Jewelbots/jewelbot-ee/README.md

# jewelbot-ee

Altium files for Jewelbots charm and dev board

Latest charm schematic(JWB-001_v3.9)

Latest dev board(JDB-001_v2.0)
