Jewelbots/jewelbot-ee/JDB-001_v2.0/BOM/Bill of Materials-JDB-001.xlsx

Sheet: BOM Report
 |  | Title | Part Number | Rev | Variant
Bill of Materials |  | JDB-001 | 1 | 2 | None
Source Data From: | JDB-001.PrjPcb
Project: | JDB-001.PrjPcb |  |  | Jewelbots, Inc.
Variant: | None |  |  | Proprietary and Confidential
 | 7/22/2016 | 9:31:41 AM
 | 2016-07-22 | 9:33:24
Item | Description | MF | MFPN | Quantity | Designator | Cost | Cost/Board
1 | ANTENNA SMD EIA 0402 2.4GHZ | Johanson Technology Inc. | 2450AT07A0100E | 1 | A100 | 0.36562 | 0.36562
2 | CAP CER 0.1UF 6.3V 10% X5R 0201 | Murata Electronics North America | GRM033R60J104KE19D | 8 | C100, C104, C111, C206, C207, C211, C214, C306 | 0.00780 | 0.0624
3 | CAP CER 15PF 25V NP0 0201 | Murata Electronics North America | GRM0335C1E150FA01D | 2 | C101, C102 | 0.00900 | 0.018
4 | CAP CER 1000PF 25V 10% X7R 0201 | Murata Electronics North America | GRM033R71E102KA01D | 1 | C105 | 0.00600 | 0.006
5 | Capacitor, Ceramic 0201, DNP | N/A | DNP | 2 | C107, C108 | 0 | 0
6 | CAP CER 0.047UF 10V 10% X5R 0201 | Taiyo Yuden | LMK063BJ473KP-F | 1 | C109 | 0.03000 | 0.03
7 | CAP CER 2200PF 16V 10% X7R 0201 | Murata Electronics North America | GRM033R71C222KA88D | 1 | C110 | 0.00630 | 0.0063
8 | CAP CER 1UF 10V 10% X5R 0402 | Murata Electronics North America | GRM155R61A105KE15D | 6 | C200, C201, C209, C210, C301, C307 | 0.00990 | 0.0594
9 | CAP CER 10UF 10V 20% X5R 0603 | TDK Corporation | C1608X5R1A106M080AC | 2 | C204, C205 | 0.12650 | 0.253
10 | CAP CER 4.7UF 10V 20% X5R 0402 | Samsung Electro-Mechanics America, Inc. | CL05A475MP5NRNC | 6 | C208, C300, C302, C304, C305, C309 | 0.11730 | 0.7038
11 | CAP CER 1UF 6.3V 20% X5R 0201 | Samsung Electro-Mechanics America, Inc. | CL03A105MQ3CSNC | 1 | C213 | 0.27950 | 0.2795
12 | CAP CER 22PF 50V 5% NP0 0201 | Murata Electronics North America | GRM0335C1H220JA01D | 2 | C303, C310 | 0.00570 | 0.0114
13 | CAP CER 0.1UF 10V 10% X5R 0402 | Murata Electronics North America | GRM155R61A104KA01J | 1 | C308 | 0.00300 | 0.003
14 | LED RGB 3-IN-1 SMD 4PLCC | Cree Inc. | CLMVB-FKA-CFHEHLCBB7A363 | 4 | D200, D201, D202, D203 | 2.68 | 10.72
15 | DIODE SCHOTTKY 20V 1A SOD123FL | ON Semiconductor | MBR120VLSFT3G | 1 | D204 | 0.11660 | 0.1166
16 | DIODE SCHOTTKY 20V 500MA 0603 | Comchip Technology | CDBU0520 | 1 | D300 | 0.09888 | 0.09888
17 | TVS DIODE 6VWM 12VC 0402 | TE Connectivity Raychem Circuit Protection | SESD0402P1BN-0450-090 | 3 | D301, D302, D303 | 0.11000 | 0.33
18 | CONN HEADER 2POS 1.25MM R/A SMD | Molex, LLC | 0537800270 | 2 | J200, J301 | 1.23900 | 2.478
19 | CONN USB MICRO B RECPT SMT R/A | FCI | 10118194-0001LF | 1 | J300 | 0.18000 | 0.18
20 | FIXED IND 4.7UH 1A 250 MOHM SMD | Samsung Electro-Mechanics America, Inc. | CIG22B4R7MNE | 1 | L200 | 0.08498 | 0.08498
21 | FIXED IND 2.2UH 600MA 170 MOHM | TDK Corporation | GLFR1608T2R2M-LR | 1 | L300 | 0.12190 | 0.1219
22 | CONN HEADER 10POS .100" VERT TIN | Molex, LLC | 0015912100 | 4 | P100, P101, P102, P103 | 0.47152 | 1.88608
23 | CONN HEADER 4POS VERT 2.54MM SMD | Molex, LLC | 0878980426 | 1 | P104 | 0.25300 | 0.253
24 | MOSFET P-CH 20V 0.1A VMT3 | Rohm Semiconductor | RZM001P02T2L | 1 | Q100 | 0.22000 | 0.22
25 | MOSFET 2N-CH 20V 1.1A SC-70-6 | Vishay Siliconix | SI1902CDL-T1-GE3 | 1 | Q300 | 0.12210 | 0.1221
26 | RES SMD 0.0OHM JUMPER 1/20W 0201 | Samsung Electro-Mechanics America, Inc. | RC0603J000CS | 1 | R100 | 0.00787 | 0.00787
27 | RES SMD 3.3K OHM 5% 1/20W 0201 | Samsung Electro-Mechanics America, Inc. | RC0603J332CS | 2 | R101, R102 | 0.00648 | 0.01296
28 | RES SMD 10K OHM 5% 1/20W 0201 | Rohm Semiconductor | MCR006YRTJ103 | 4 | R104, R105, R200, R306 | 0.00828 | 0.03312
29 | RES SMD 82K OHM 1% 1/20W 0201 | Panasonic Electronic Components | ERJ-1GEF8202C | 1 | R201 | 0.01049 | 0.01049
30 | RES SMD 30.1K OHM 1% 1/20W 0201 | Panasonic Electronic Components | ERJ-1GEF3012C | 1 | R202 | 0.01049 | 0.01049
31 | RES SMD 6.49K OHM 1% 1/20W 0201 | Panasonic Electronic Components | ERJ-1GEF6491C | 1 | R300 | 0.10000 | 0.1
32 | RES SMD 330 OHM 5% 1/20W 0201 | Rohm Semiconductor | MCR006YRTJ331 | 1 | R303 | 0.00834 | 0.00834
33 | RES SMD 150K OHM 1% 1/20W 0201 | Rohm Semiconductor | MCR006YRTF1503 | 1 | R304 | 0.01102 | 0.01102
34 | RES SMD 680K OHM 1% 1/20W 0201 | Panasonic Electronic Components | ERJ-1GEF6803C | 1 | R305 | 0.01049 | 0.01049
35 | RES SMD 2.2K OHM 5% 1/20W 0201 | Panasonic Electronic Components | ERJ-1GEJ222C | 1 | R307 | 0.00787 | 0.00787
36 | RES SMD 0.0OHM JUMPER 1/16W 0402 | Samsung Electro-Mechanics America, Inc. | RC1005J000CS | 1 | R308 | 0.00198 | 0.00198
37 | RES SMD 27 OHM 5% 1/10W 0603 | Rohm Semiconductor | MCR03ERTJ270 | 2 | R309, R310 | 0.00338 | 0.00676
38 | Resistor, 0201, DNP | N/A | DNP | 2 | R311, R312 | 0 | 0
39 | RES SMD 300K OHM 1% 1/20W 0201 | Panasonic Electronic Components | ERJ-1GEF3003C | 1 | R313 | 0.10000 | 0.1
40 | RES SMD 240K OHM 1% 1/20W 0201 | Panasonic Electronic Components | ERJ-1GEF2403C | 1 | R314 | 0.10000 | 0.1
41 | THERMISTOR 10K OHM NTC 0201 SMD | Murata Electronics North America | NCP03XH103J05RL | 1 | RT300 | 0.08514 | 0.08514
42 | Tactile Switches 6.0x6.0x2.5mm 160gf | ALPS | SKHUALE010 | 2 | SW100, SW101 | 0.201 | 0.402
43 | SWITCH SLIDE DPDT 300MA 6V | C&K Components | JS202011SCQN | 2 | SW300, SW301 | 0.46200 | 0.924
44 | IC SOC 2.4GHZ 256K FLASH 48QFN | Nordic Semiconductor ASA | NRF51822-QFAC-R | 1 | U100 | 2.33310 | 2.3331
45 | NORDIC NRF51 BALUN FILTER | Johanson Technology Inc. | 2450BM14E0003T | 1 | U101 | 0.66000 | 0.66
46 | IC ERM/LRA HAPTIC DRIVER 9DSBGA | Texas Instruments | DRV2604LYZFR | 1 | U200 | 1.35000 | 1.35
47 | IC LED DRIVER RGLTR DIM 36USMD | Texas Instruments | LP55281TL/NOPB | 1 | U201 | 1.17000 | 1.17
48 | IC PMU 2CH CONV/LDO 32QFN | Texas Instruments | TPS65721RSNR | 1 | U300 | 2.44600 | 2.446
49 | IC LITHIUM BATT PROTECT 6-SON | Texas Instruments | BQ29700DSET | 1 | U301 | 0.67800 | 0.678
50 | IC USB SERIAL BASIC UART 16QFN | FTDI, Future Technology Devices International Ltd | FT230XQ-R | 1 | U302 | 1.52950 | 1.5295
51 | CRYSTAL 16.0000MHZ 10PF SMD | Abracon LLC | ABM11-16.000MHZ-B7G-T | 1 | X100 | 0.60000 | 0.6
 |  |  |  |  |  |  | 31.00909 | TOTAL
Rev

Sheet: Project Information
Project Full Path | C:\Awarepoint\T3B\T3B.PrjPcb
Project Filename | T3B.PrjPcb
Variant Name | Prototype
Data-Source Filename | T3B.PrjPcb
Data-Source Full Path | C:\Awarepoint\T3B\T3B.PrjPcb
Title | Bill of Materials For Variant [Prototype] of Project [T3B.PrjPcb] (No PCB Document Selected)
Total Quantity | 87
Report Time | 2:07:03 PM
Report Date | 1/17/2012
Report Date & Tine | 1/17/2012 2:07:03 PM
Output Name | Bill of Materials
Output Type | BOM_PartType
Output Generator Name | BOM
Output Generator Description | Bill of Materials
