Jewelbots/jewelbot-ee/JWB-001_Charger_v2/BOM/JWB-001_Charger_v2.0_BOM.xlsx

Sheet: Part List Report
 | Component list |  |  | JWB-001_Charger
 | Source Data From: |  |  | JWB-001_Charger.PrjPcb
 | Project: |  |  | JWB-001
 | Version: |  |  | v2.0
 |  |  |  |  |  | CONFIDENTIAL
 | Report Date: |  | 5/14/2015 | 9:21:27 AM
 | Print Date: |  | 2015-05-14 | 9:21:32
# | Value | Description | Manufacturer | Manufacturer P/N | #Column Name Error:Supplier 1 | #Column Name Error:Supplier Part Number 1 | Designator | Quantity
1 |  | Spring Loaded Header 0.05" Pitch, 4Pin, 4x1, 4.98mm - 6.4mm Height | Mill-Max | 854-22-004-30-001101 |  |  | J100 | 1
2 | 0.1uF | Cap, Ceramic 0.1uF 10V 10% X5R 0402 | Murata | GRM155R61A104KA01J |  |  | C101 | 1
3 | 1.0uF | Cap, Ceramic 1.0uF 10V 10% X5R 0402 | Murata | GRM155R61A105KE15D |  |  | C102 | 1
4 | 4.7uF | Cap, Ceramic 4.7uF 10V 20% X5R 0402 | Samsung | CL05A475MP5NRNC |  |  | C100 | 1
5 |  | USB to UART converter IC, Single channel with flow control, QFN-16 | FTDI | FT230XQ-R |  |  | U100 | 1
6 | 0 | Resistor 0 ohm 1/16W 0402 | Samsung | RC1005J000CS |  |  | R103 | 1
7 | 27 | Resistor 27 ohm 5%, 1/10W, 0603 | Rohm | MCR03ERTJ270 |  |  | R100, R101 | 2
8 |  | ESD TVS Diode, 16kV air, 0402 | TE Connectivity | SESD0402P1BN-0450-090 |  |  | D100, D101, D102 | 3
9 |  | USB Micro B Receptacle, Right Angle, SMT with 4 TH Tabs | FCI | 10118194-0001LF |  |  | J101 | 1
Approved |  |  |  | Notes |  |  |  | 12

Sheet: Project Information
Project Full Path | C:\Users\davisj\rigado\clients\Jewliebots\Project Folders\JWB-001\hw\JWB-001_Charger\v2.0\JWB-001_Charger.PrjPcb
Project Filename | JWB-001_Charger.PrjPcb
Project Name | JWB-001
PCB Name | JWB-001_Charger
Version | v2.0
Created By | JJD
Total Part Quantity | 12
Report Time | 9:21:27 AM
Report Date | 5/14/2015
Report Date & Tine | 5/14/2015 9:21:27 AM
Output Name | Purchase BOM
Output Type | BOM_PartType
Output Generator Name | BOM
Output Generator Description | Bill of Materials
