Jewelbots/jewelbot-ee/JWB-001_Main_v2.0/BOM/JWB-001_Main_v2.0_BOM.xlsx

Sheet: Part List Report
 | Component list |  |  | JWB-001_Main
 | Source Data From: |  |  | JWB-001_Main.PrjPcb
 | Project: |  |  | JWB-001
 | Version: |  |  | v2.0
 |  |  |  |  |  | CONFIDENTIAL
 | Report Date: |  | 5/13/2015 | 4:35:32 PM
 | Print Date: |  | 2015-05-13 | 16:35:41
# | Value | Description | Manufacturer | Manufacturer P/N | #Column Name Error:Supplier 1 | #Column Name Error:Supplier Part Number 1 | Designator | Quantity
1 |  | Utra-Minature 2.4GHz Chip antenna, 1.0mm x 0.5mm | Johanson Technology | 2450AT07A0100 |  |  | A100 | 1
2 |  | Spring Loaded Header 0.05" Pitch, 4Pin, 4x1, 4.98mm - 6.4mm Height | Mill-Max | 854-22-004-30-001101 |  |  | J300 | 1
3 |  | Balun, 50 ohm transformer for nRF51x22 | ST Micro | BAL-NRF02D3 |  |  | U101 | 1
4 |  | Li-Ion single cell voltage and current protection IC | Texas Instruments | BQ29700DSET |  |  | U301 | 1
5 | 0.1uF | Cap, Ceramic 0.1uF 6.3V 10% X5R 0201 | Murata | GRM033R60J104KE19D |  |  | C100, C104, C111, C112, C206, C207, C211, C214, C306 | 9
6 | 1.0uF | Cap, Ceramic 1.0uF 6.3V 20% X5R 0201 | Samsung | CL03A105MQ3CSNC |  |  | C213 | 1
7 | 11pF | Cap, Ceramic 11pF 25V 5% NPO 0201 | Samsung | CL03C110JA3GNNC |  |  | C101, C102 | 2
8 | 1nF | Cap, Ceramic 1nF 25V 10% X7R 0201 | Murata | GRM033R71E102KA01D |  |  | C105 | 1
9 | 2.2nF | Cap, Ceramic 2.2nF 16V 10% X7R 0201 | Murata | GRM033R71C222KA88D |  |  | C110 | 1
10 | 22pF | Cap, Ceramic 22pF 50V 5% NPO 0201 | Murata | GRM0335C1H220JA01D |  |  | C303 | 1
11 | 47nF | Cap, Ceramic 47nF 10V 10% X5R 0201 | Taiyo Yuden | LMK063BJ473KP-F |  |  | C109 | 1
12 | 1.0uF | Cap, Ceramic 1.0uF 10V 10% X5R 0402 | Murata | GRM155R61A105KE15D |  |  | C200, C201, C209, C210, C301, C305 | 6
13 | 4.7uF | Cap, Ceramic 4.7uF 10V 20% X5R 0402 | Samsung | CL05A475MP5NRNC |  |  | C208, C300, C302, C304 | 4
14 | 10uF | Cap, Ceramimic 10uF 10V 20% X5R 0603 | TDK | C1608X5R1A106M080AC |  |  | C204, C205 | 2
15 |  | Diode, Schottky, 20V 500mA, 470mV Vf @ 500mA, 0603 | Comchip Technology | CDBU0520 |  |  | D300 | 1
16 |  | RGB LED SMD, Diffused | Cree | CLMVB-FKA-CFHEHLCBB7A363 |  |  | D200, D201, D202, D203 | 4
17 |  | Haptic Driver w/Internal Memory, I2C, DSBGA 9 | Texas Instruments | DRV2604LYZFx |  |  | U200 | 1
18 |  | Crystal, 16.0000MHz, 10ppm, 2.0mm x 1.6mm | EPSON | FA-128 16.0000MF10Z -ACX |  |  | X100 | 1
19 |  | Reset Timer with 10.0sec Fixed Delay and Reset Pulse, 1.65v-5.0v | Fairchild | FT10001L6X |  |  | U102 | 1
20 |  | Snap Dome, high activation force, 5.3mm dia | Snaptron | GX05170 |  |  | SW100 | 1
21 | 2.2uH | Inductor, 2.2uH 160mA, 0603 | TDK | GLFR1608T2R2M-LR |  |  | L300 | 1
22 | 4.7uH | Inductor, 4.7uH, 1008 | Samsung | CIG22B4R7MNE |  |  | L200 | 1
23 |  | Quad RGB LED driver w/integrated boost supply and audio sync | Texas Instruments | LP55281TL/NOPB |  |  | U201 | 1
24 |  | Diode, Schottky, 20V 1A SOD-123F, 340mV Vf @ 1A | ON Semi | MBR120VLSFT3G |  |  | D204 | 1
25 |  | Multiporotocol Bluetooth low energy/2.4GHz RF System on Chip | Nordic Semiconductor | nRF51822-CFAC-R |  |  | U100 | 1
26 | 0 | Resistor 0 ohm 1/20W, 0201 | Samsung | RC0603J000CS |  |  | R100 | 1
27 | 10k | Resistor 10k ohm 5% 1/20W 0201 | Rohm | MCR006YRTJ103 |  |  | R104, R105, R106, R107, R200, R301, R306 | 7
28 | 150k | Resistor 150k ohm 1% 1/20W, 0201 | Rohm | MCR006YRTF1503 |  |  | R304 | 1
29 | 2.2k | Resistor 2.2k ohm 5% 1/20W, 0201 | Panasonic | ERJ-1GEJ222C |  |  | R307 | 1
30 | 3.3k | Resistor 3.3k ohm 5% 1/20W, 0201 | Samsung | RC0603J332CS |  |  | R101, R102 | 2
31 | 301k | Resistor 301k ohm 1% 1/20W, 0201 | Panasonic | ERJ-1GEF3013C |  |  | R305 | 1
32 | 330 | Resistor 330 ohm 5% 1/20W, 0201 | Rohm | MCR006YRTJ331 |  |  | R303 | 1
33 | 82k | Resistor, 0201 |  |  |  |  | R201 | 1
34 | 30.1k | Resistor, 0201 |  |  |  |  | R202 | 1
35 | 4.12k | RES SMD 4.12K OHM 1% 1/20W 0201 | Panasonic | ERJ-1GEF4121C |  |  | R300 | 1
36 |  | P-MOSFET, 20V 100mA, SOT-723 | Rohm | RZM001P02T2L |  |  | Q100 | 1
37 |  | ESD TVS Diode, 16kV air, 0402 | TE Connectivity | SESD0402P1BN-0450-090 |  |  | D301, D303, D304 | 3
38 |  | Dual N-MOSFET, 20V 1A, SC70-6 | Vishay | SI1902CDL-T1-GE3 |  |  | Q101, Q300 | 2
39 | 10k | Thermistor 10k ohm NTC 5% 0201 | Murata | NCP03XH103J05RL |  |  | RT300 | 1
40 |  | PMU for Li-ion batteries, 1xDCDC 1xLDO, .4mm pitch XBGA 2mm x 2mm | Texas Instruments | TPS65720YFF |  |  | U300 | 1
41 | DNP | Capacitor, Ceramic 0201 |  |  |  |  | C107, C108 | 2
42 | DNP | Resistor, 0201 |  |  |  |  | R311, R312 | 2
43 |  | Test points for 4-wire Serial Wire Debugger header Pogo Pin harness |  |  |  |  | J100 | 1
44 |  | Testpoint, Round 1.0mm Dia |  |  |  |  | TP_SCL, TP_SDA | 2
45 |  | Testpoint, Round 1.7mm Dia |  |  |  |  | TP_BATT+, TP_BATT-, TP_GND, TP_LRA+, TP_LRA- | 5
Approved |  |  |  | Notes |  |  |  | 83

Sheet: Project Information
Project Full Path | C:\Users\davisj\rigado\clients\Jewliebots\Project Folders\JWB-001\hw\JWB-001_Main\v2.0\JWB-001_Main.PrjPcb
Project Filename | JWB-001_Main.PrjPcb
Project Name | JWB-001
PCB Name | JWB-001_Main
Version | v2.0
Created By | JJD
Total Part Quantity | 83
Report Time | 4:35:32 PM
Report Date | 5/13/2015
Report Date & Tine | 5/13/2015 4:35:32 PM
Output Name | Purchase BOM
Output Type | BOM_PartType
Output Generator Name | BOM
Output Generator Description | Bill of Materials
