Jewelbots/jewelbot-ee/JWB-001_Main_v2.0/Export 3D/JWB-001 v2.0.step

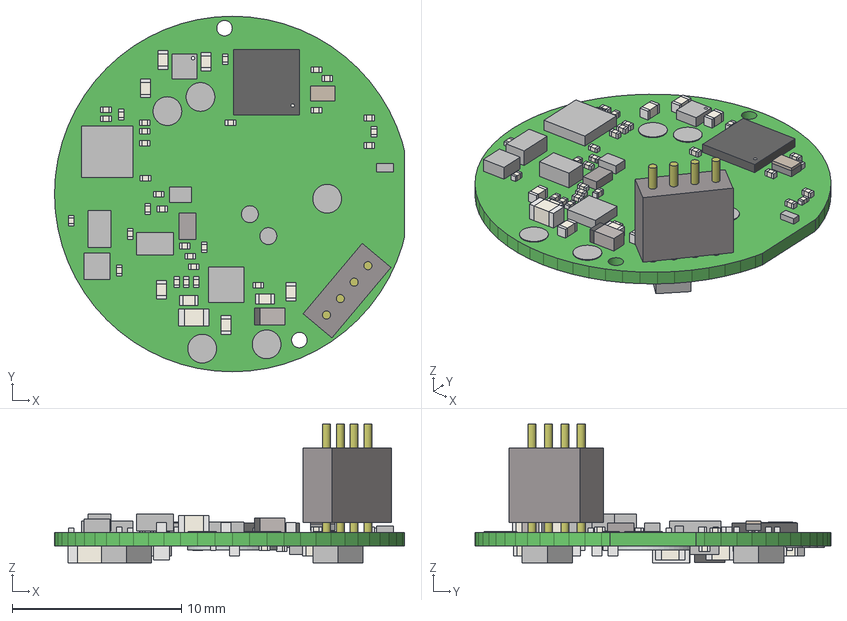
[picture p7: CAD file, 2016-06-10]
JWB-001_Main_v2.0/Export 3D/JWB-001 v2.0.step
20.7 x 21.0 x 8.19 mm
Board
Extruded x 188
