Jewelbots/jewelbot-ee/JWB-001_v3.9/SupportDocs/Stepfiles/User Library-QFN 32.STEP

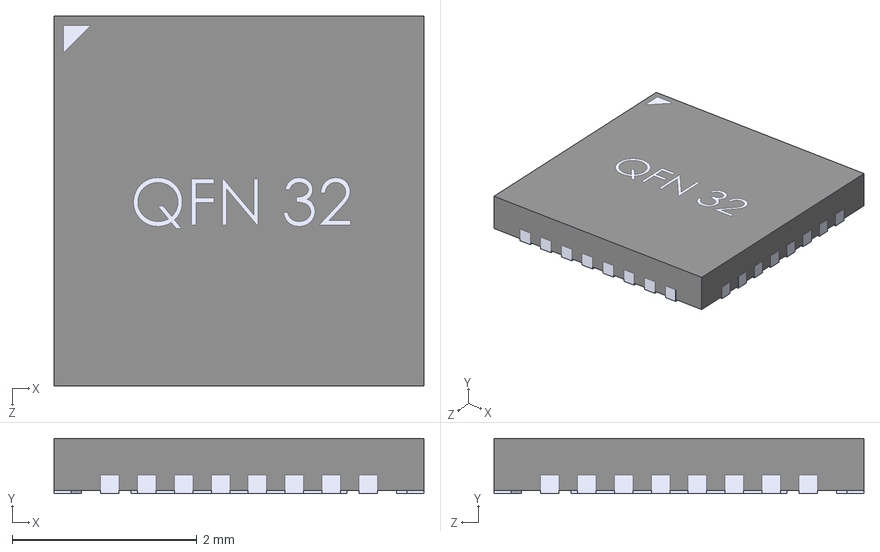
[picture p8: CAD file, 2016-07-22]
JWB-001_v3.9/SupportDocs/Stepfiles/User Library-QFN 32.STEP
4.00 x 0.6 x 4.00 mm
