Jewelbots/jewelbot-ee/JDB-001_v2.0/SupportDocs/Stepfiles/User Library-header1x4 1241150-4.STEP

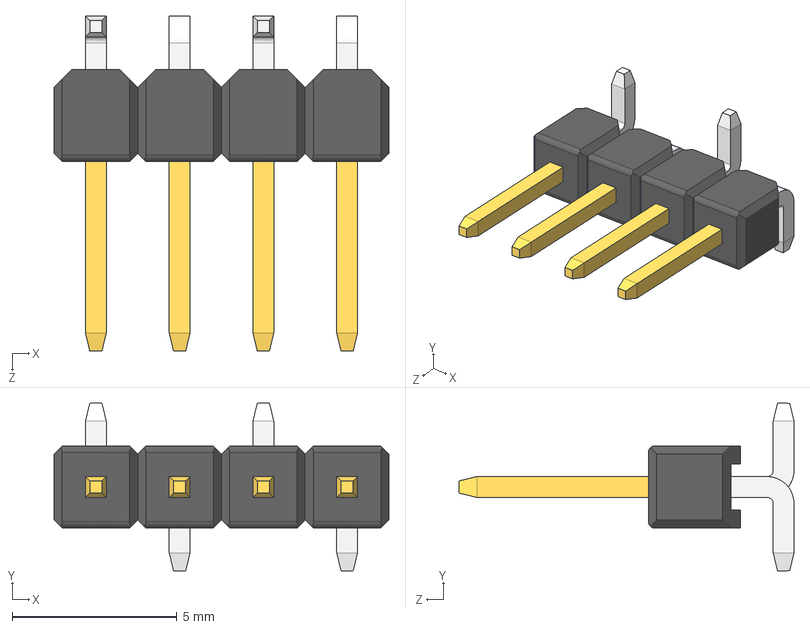
[picture p9: CAD file, 2016-07-22]
JDB-001_v2.0/SupportDocs/Stepfiles/User Library-header1x4 1241150-4.STEP
10.2 x 5.08 x 10.2 mm
