Jewelbots/jewelbot-ee/JWB-001_v3.9/SupportDocs/Stepfiles/RSN32_2P8X2P8.stp

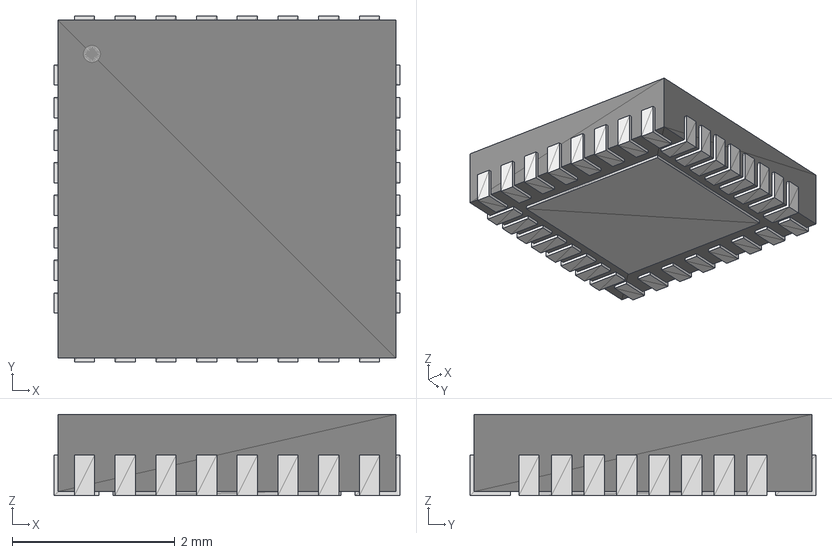
[picture p10: CAD file, 2016-07-22]
JWB-001_v3.9/SupportDocs/Stepfiles/RSN32_2P8X2P8.stp
4.25 x 4.25 x 1.00 mm
