Jewelbots/jewelbot-ee/JWB-001_v3.9/SupportDocs/Stepfiles/SOT-223.step

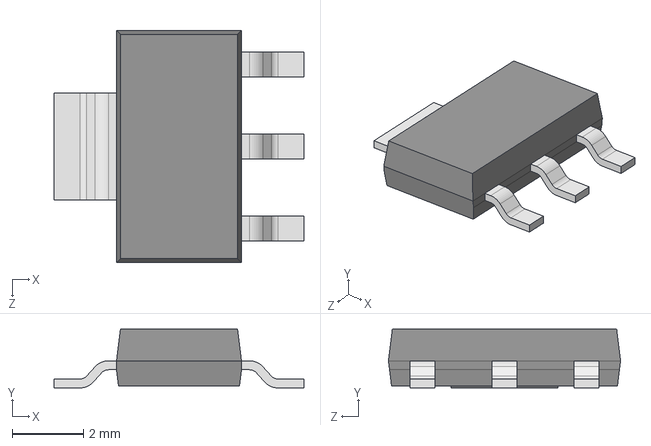
[picture p11: CAD file, 2016-06-10]
JWB-001_v3.9/SupportDocs/Stepfiles/SOT-223.step
7.00 x 1.65 x 6.50 mm
