Jewelbots/jewelbot-ee/JWB-001_v3.9/SupportDocs/Stepfiles/02SUR-32S.STEP

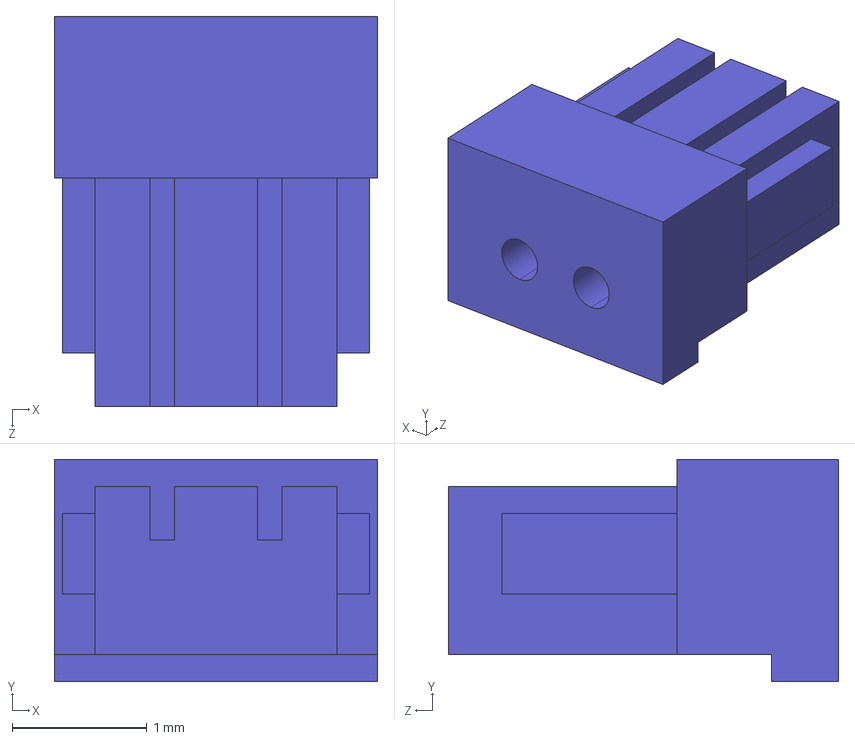
[picture p12: CAD file, 2016-06-10]
JWB-001_v3.9/SupportDocs/Stepfiles/02SUR-32S.STEP
2.40 x 1.65 x 2.90 mm
