Jewelbots/jewelbot-ee/JWB-001_v3.9/SupportDocs/Stepfiles/User Library-ABM11.STEP

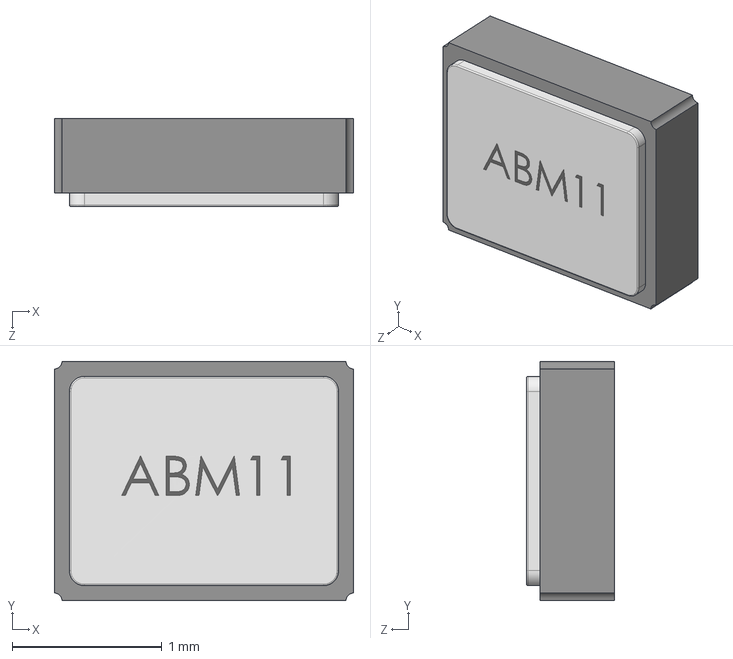
[picture p13: CAD file, 2016-06-10]
JWB-001_v3.9/SupportDocs/Stepfiles/User Library-ABM11.STEP
2.00 x 1.60 x 0.59 mm
