Jewelbots/jewelbot-ee/JWB-001_v3.9/SupportDocs/Stepfiles/SOIC-8.step

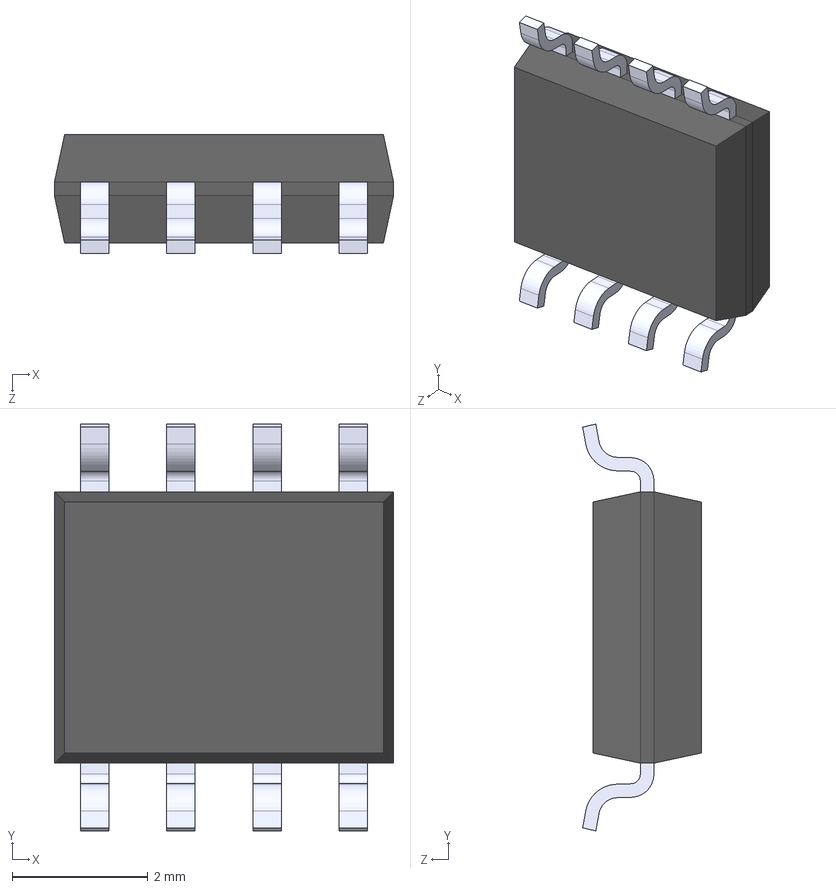
[picture p14: CAD file, 2016-06-10]
JWB-001_v3.9/SupportDocs/Stepfiles/SOIC-8.step
5.00 x 6.00 x 1.75 mm
