Jewelbots/jewelbot-ee/JWB-001_v3.9/SupportDocs/Stepfiles/BM02B-SURS-TF.STEP

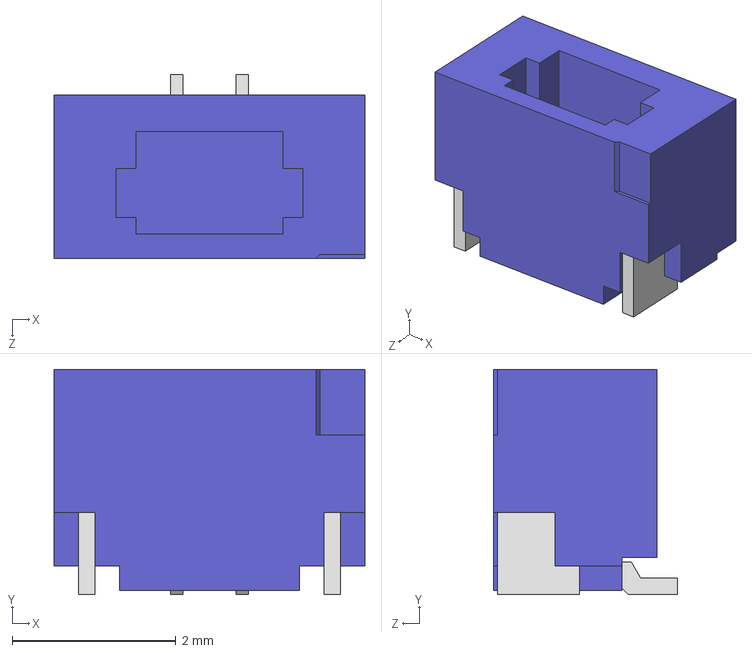
[picture p15: CAD file, 2016-06-10]
JWB-001_v3.9/SupportDocs/Stepfiles/BM02B-SURS-TF.STEP
3.80 x 2.75 x 2.25 mm
