Jewelbots/jewelbot-ee/JDB-001_v2.0/SupportDocs/Stepfiles/878980424.stp

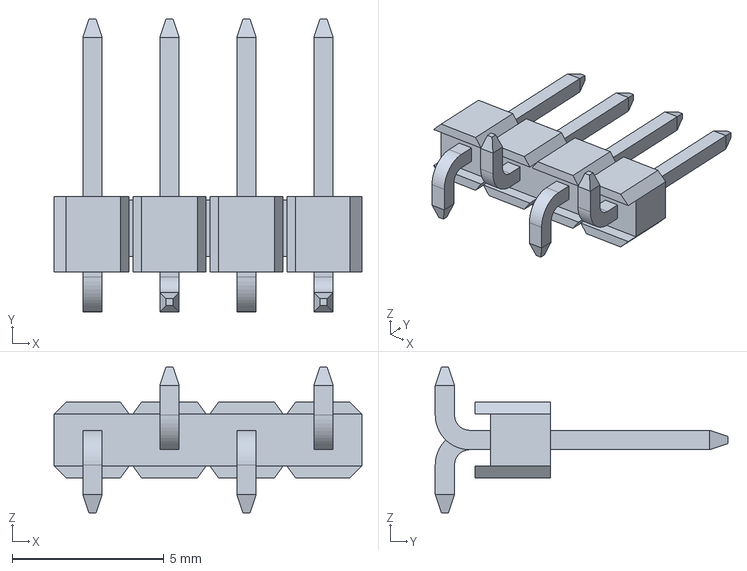
[picture p16: CAD file, 2016-07-22]
JDB-001_v2.0/SupportDocs/Stepfiles/878980424.stp
10.2 x 9.65 x 4.80 mm
