Jewelbots/jewelbot-ee/JDB-001_v2.0/SupportDocs/Stepfiles/537800270.stp

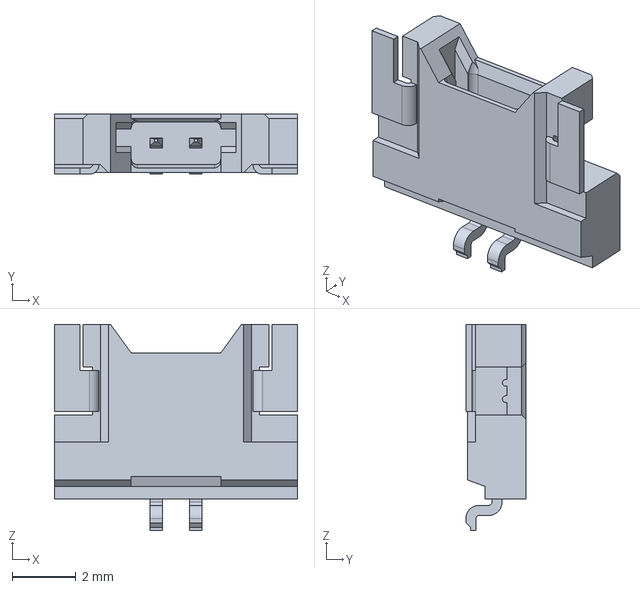
[picture p17: CAD file, 2016-07-22]
JDB-001_v2.0/SupportDocs/Stepfiles/537800270.stp
7.65 x 1.90 x 6.50 mm
