Jewelbots/jewelbot-ee/JWB-001_v3.9/SupportDocs/Stepfiles/640456-2.stp

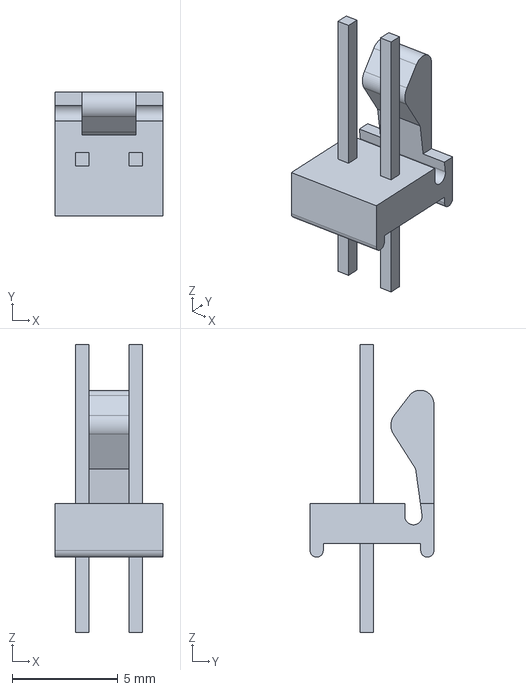
[picture p18: CAD file, 2016-06-10]
JWB-001_v3.9/SupportDocs/Stepfiles/640456-2.stp
5.08 x 5.84 x 13.6 mm
