Jewelbots/jewelbot-ee/JWB-001_v3.9/SupportDocs/Stepfiles/640456-3.stp

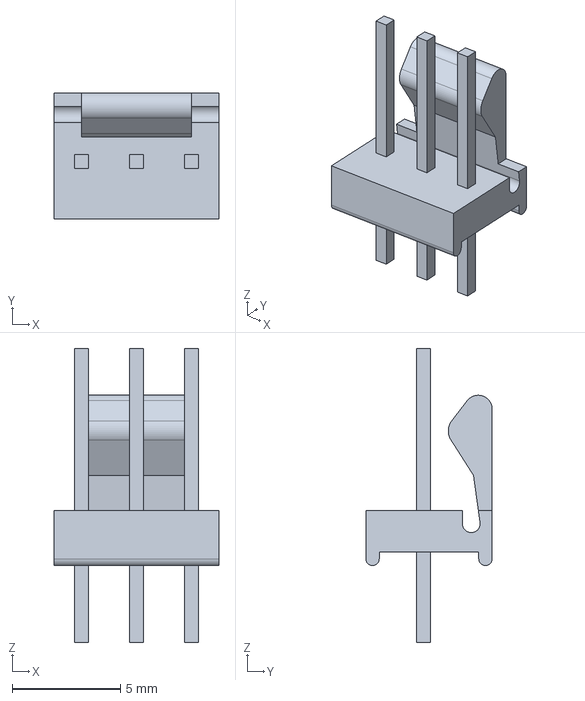
[picture p19: CAD file, 2016-06-10]
JWB-001_v3.9/SupportDocs/Stepfiles/640456-3.stp
7.62 x 5.84 x 13.6 mm
