Jewelbots/jewelbot-ee/JWB-001_v3.6/Project Outputs for JWB-001/ExportSTEP/JWB-001.step

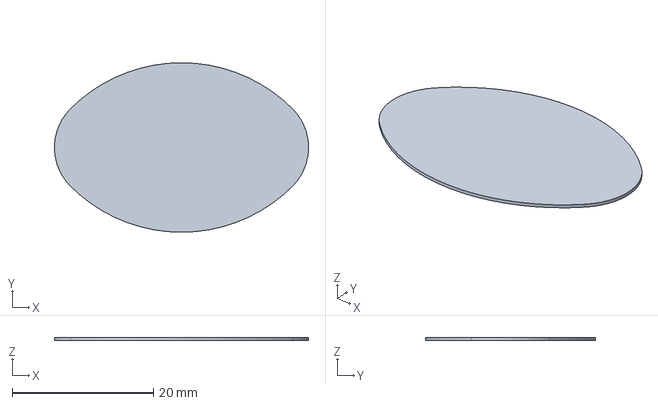
[picture p20: CAD file, 2016-06-10, an earlier design]
JWB-001_v3.6/Project Outputs for JWB-001/ExportSTEP/JWB-001.step
36.0 x 24.0 x 0.411 mm
