Jewelbots/jewelbot-ee/JWB-001_v3.9/Schematic/JWB-001_Sch.PDF

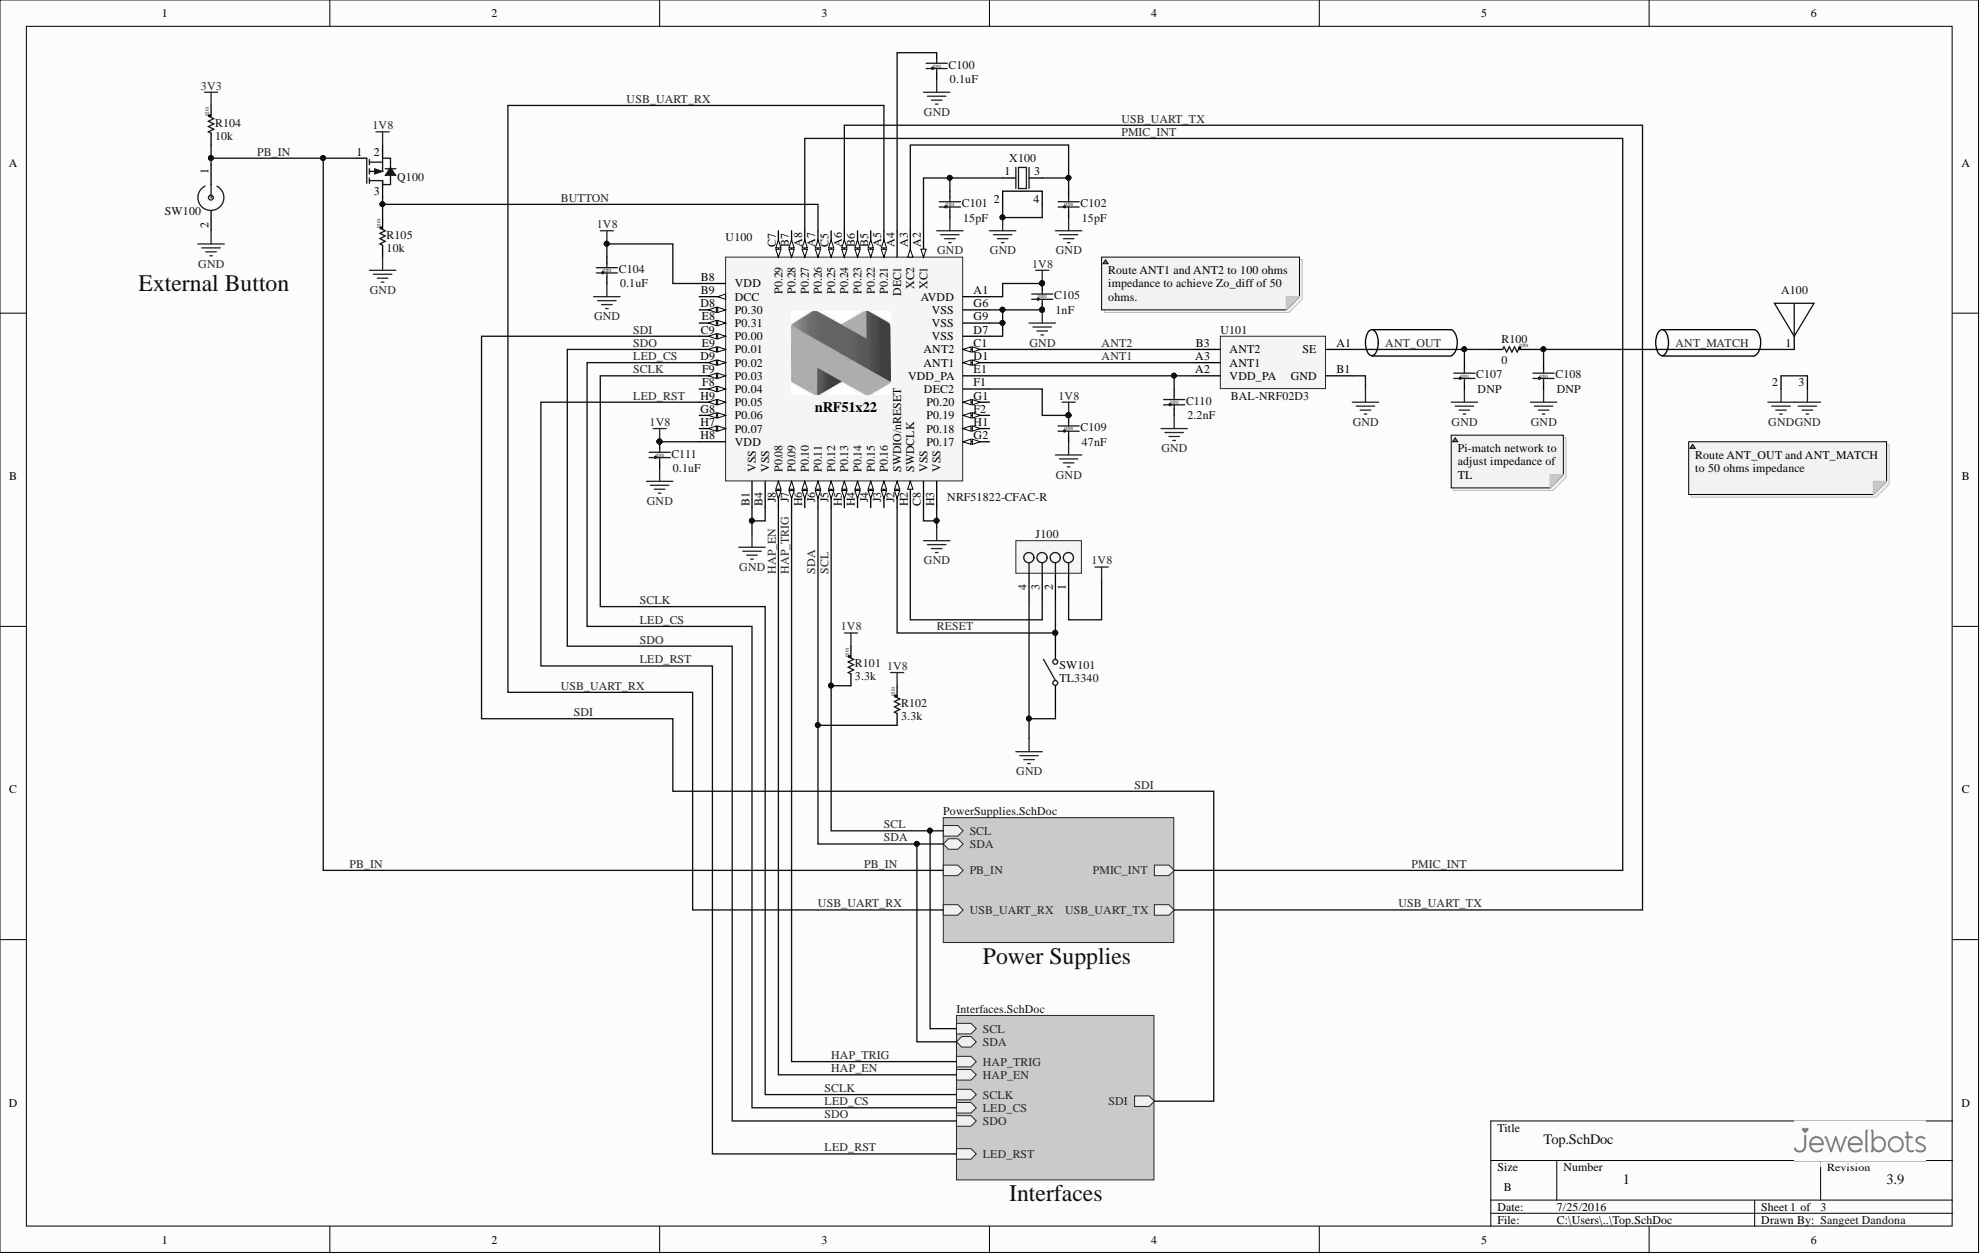
[picture p21: page 1]

BUTTON

Route ANT1 and ANT2 to 100 ohms
impedance to achieve Zo_diff of 50
ohms.

P0.07 H7 | NRF51822-CFAC-R
VDD H8 | 0201

Pi-match network to
adjust impedance of

SCL | PowerSupplies.SchDoc

SCL SDA PB_IN PMIC_INT

USB_UART_RX | | USB_UART_RX USB_UART_TX | USB_UART_TX

HAP_TRIG

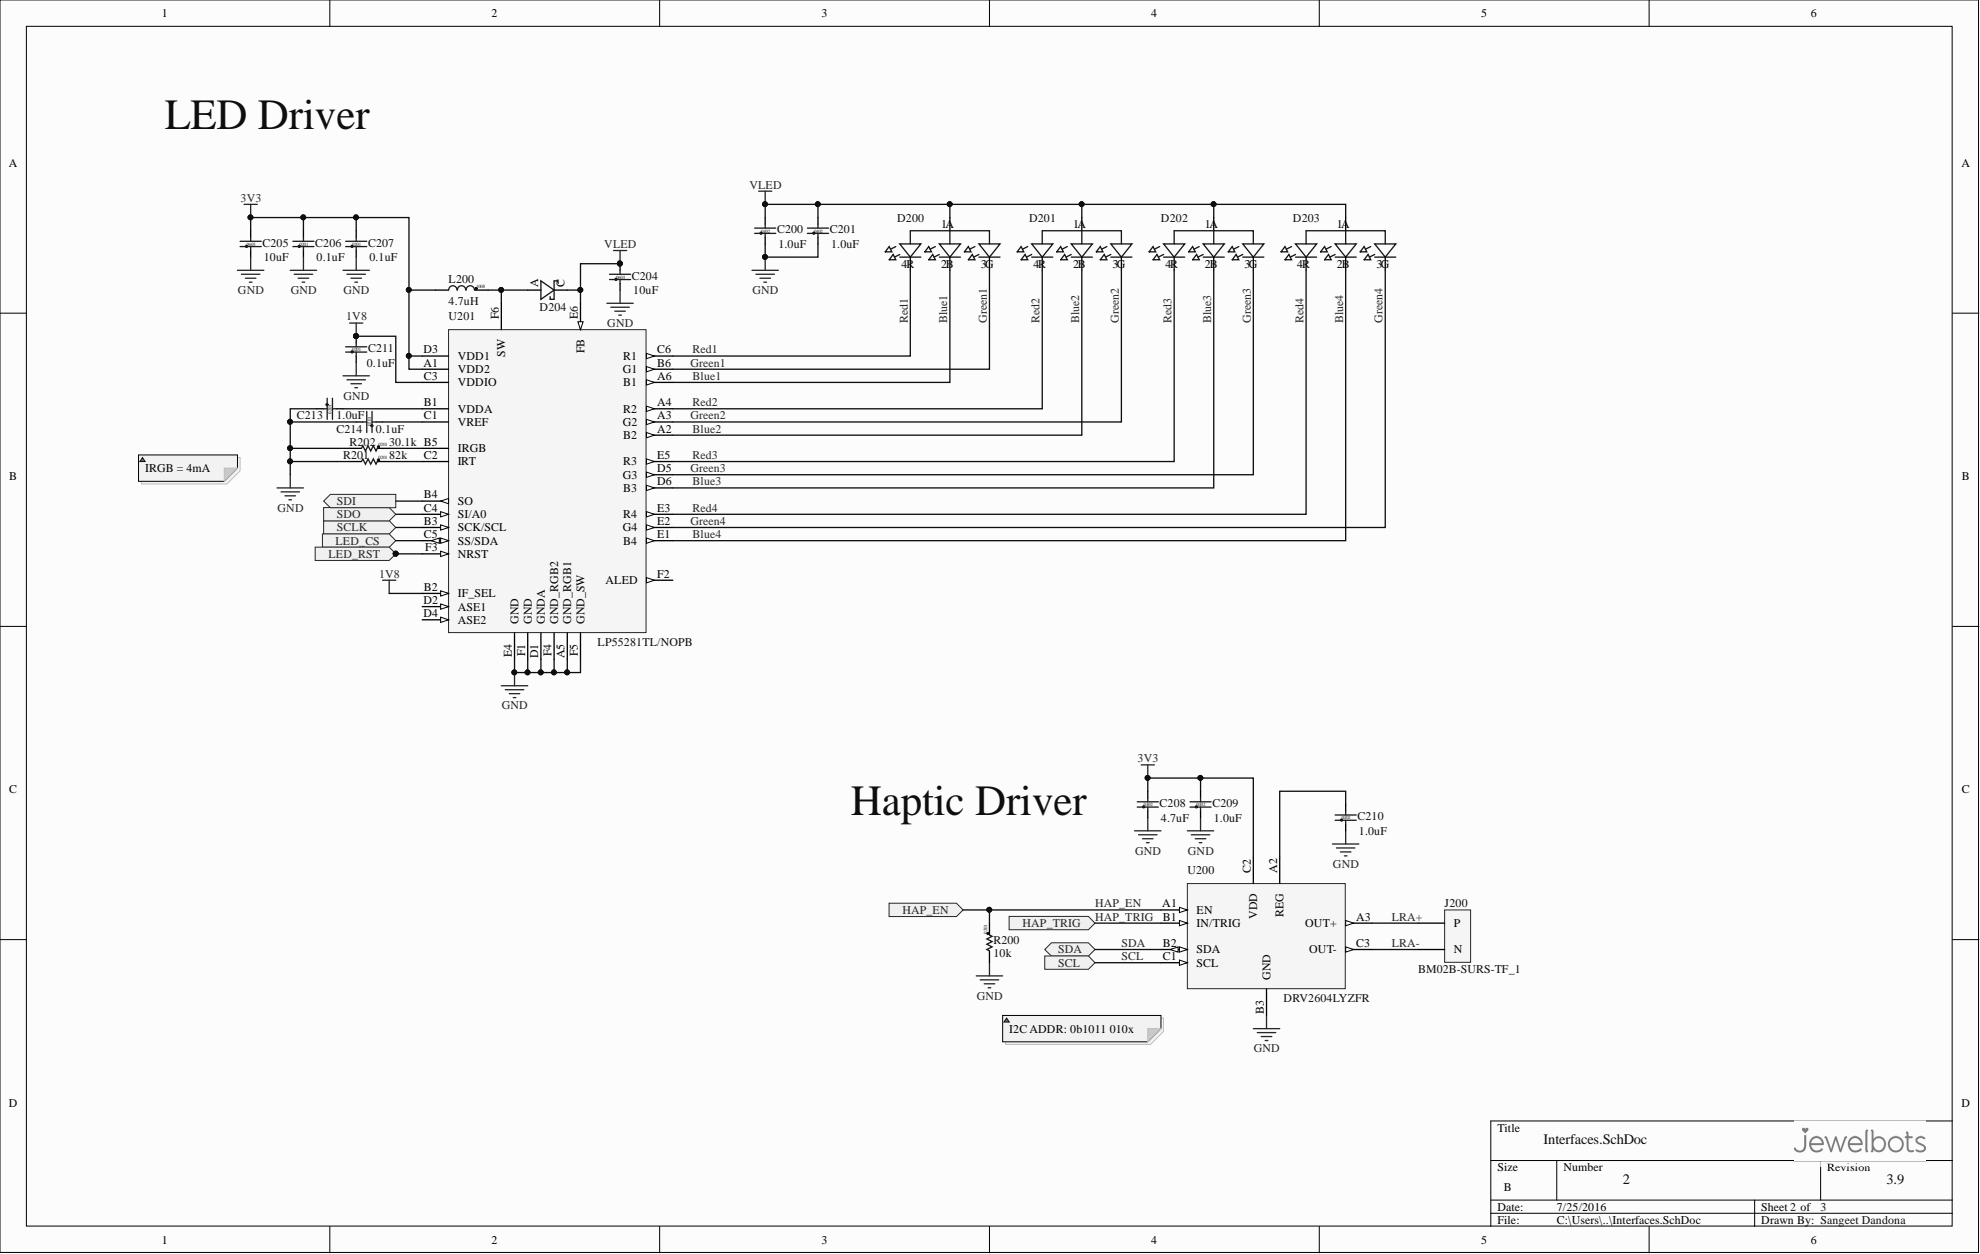
[picture p22: page 2]

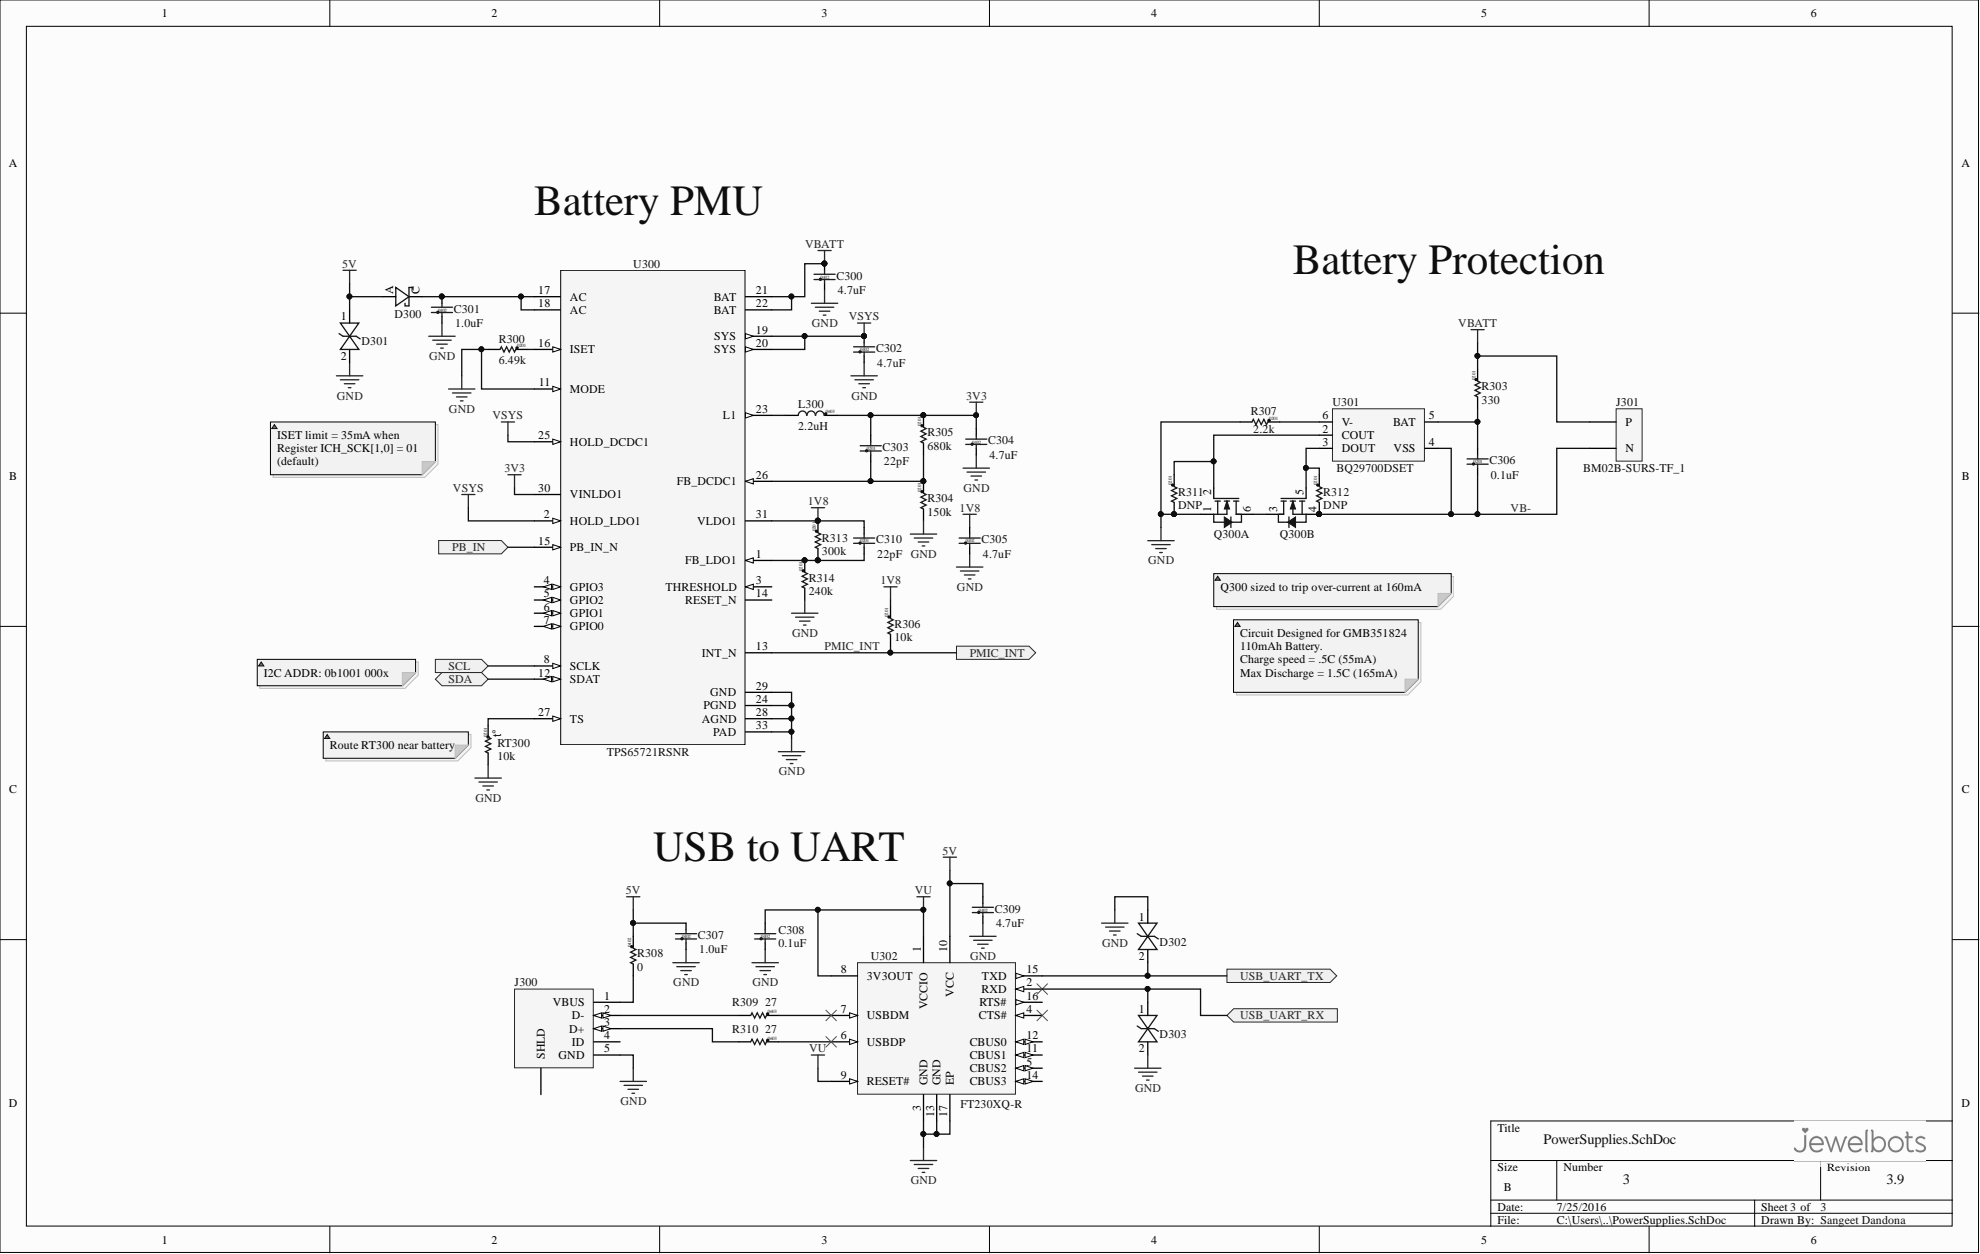
[picture p23: page 3]

MODE 11 | 0402

Q300 sized to trip over-current at 160mA
