Jewelbots/jewelbot-ee/JWB-001_Charger_v2/Source/JWB-001_Charger_v2.0_schem.PDF

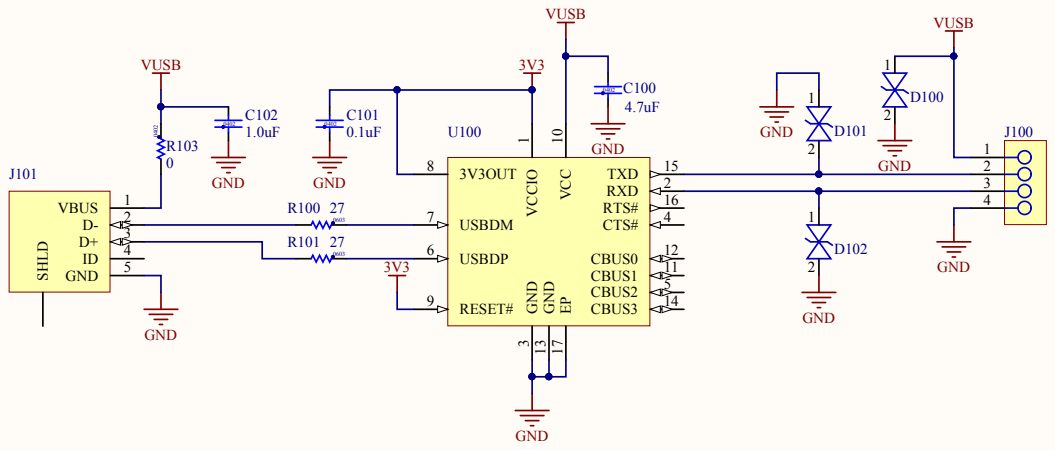
[picture p27: page 1]

v1.0 | Initial Release | 03/10/2015 | JJD

v2.0 | Updated size to match main board | 05/14/2015 | JJD

More info: www.jewliebots.com

Document title: Charger Design JWB-001_Charger.SchDoc | Page: 1 / 1

Last modified: 5/14/2015 | Timestamp: 9:15:31 AM 5/14/2015
