Jewelbots/jewelbot-ee/JWB-001_Main_v2.0/Source/JWB-001_Main_v2.0_schem.PDF

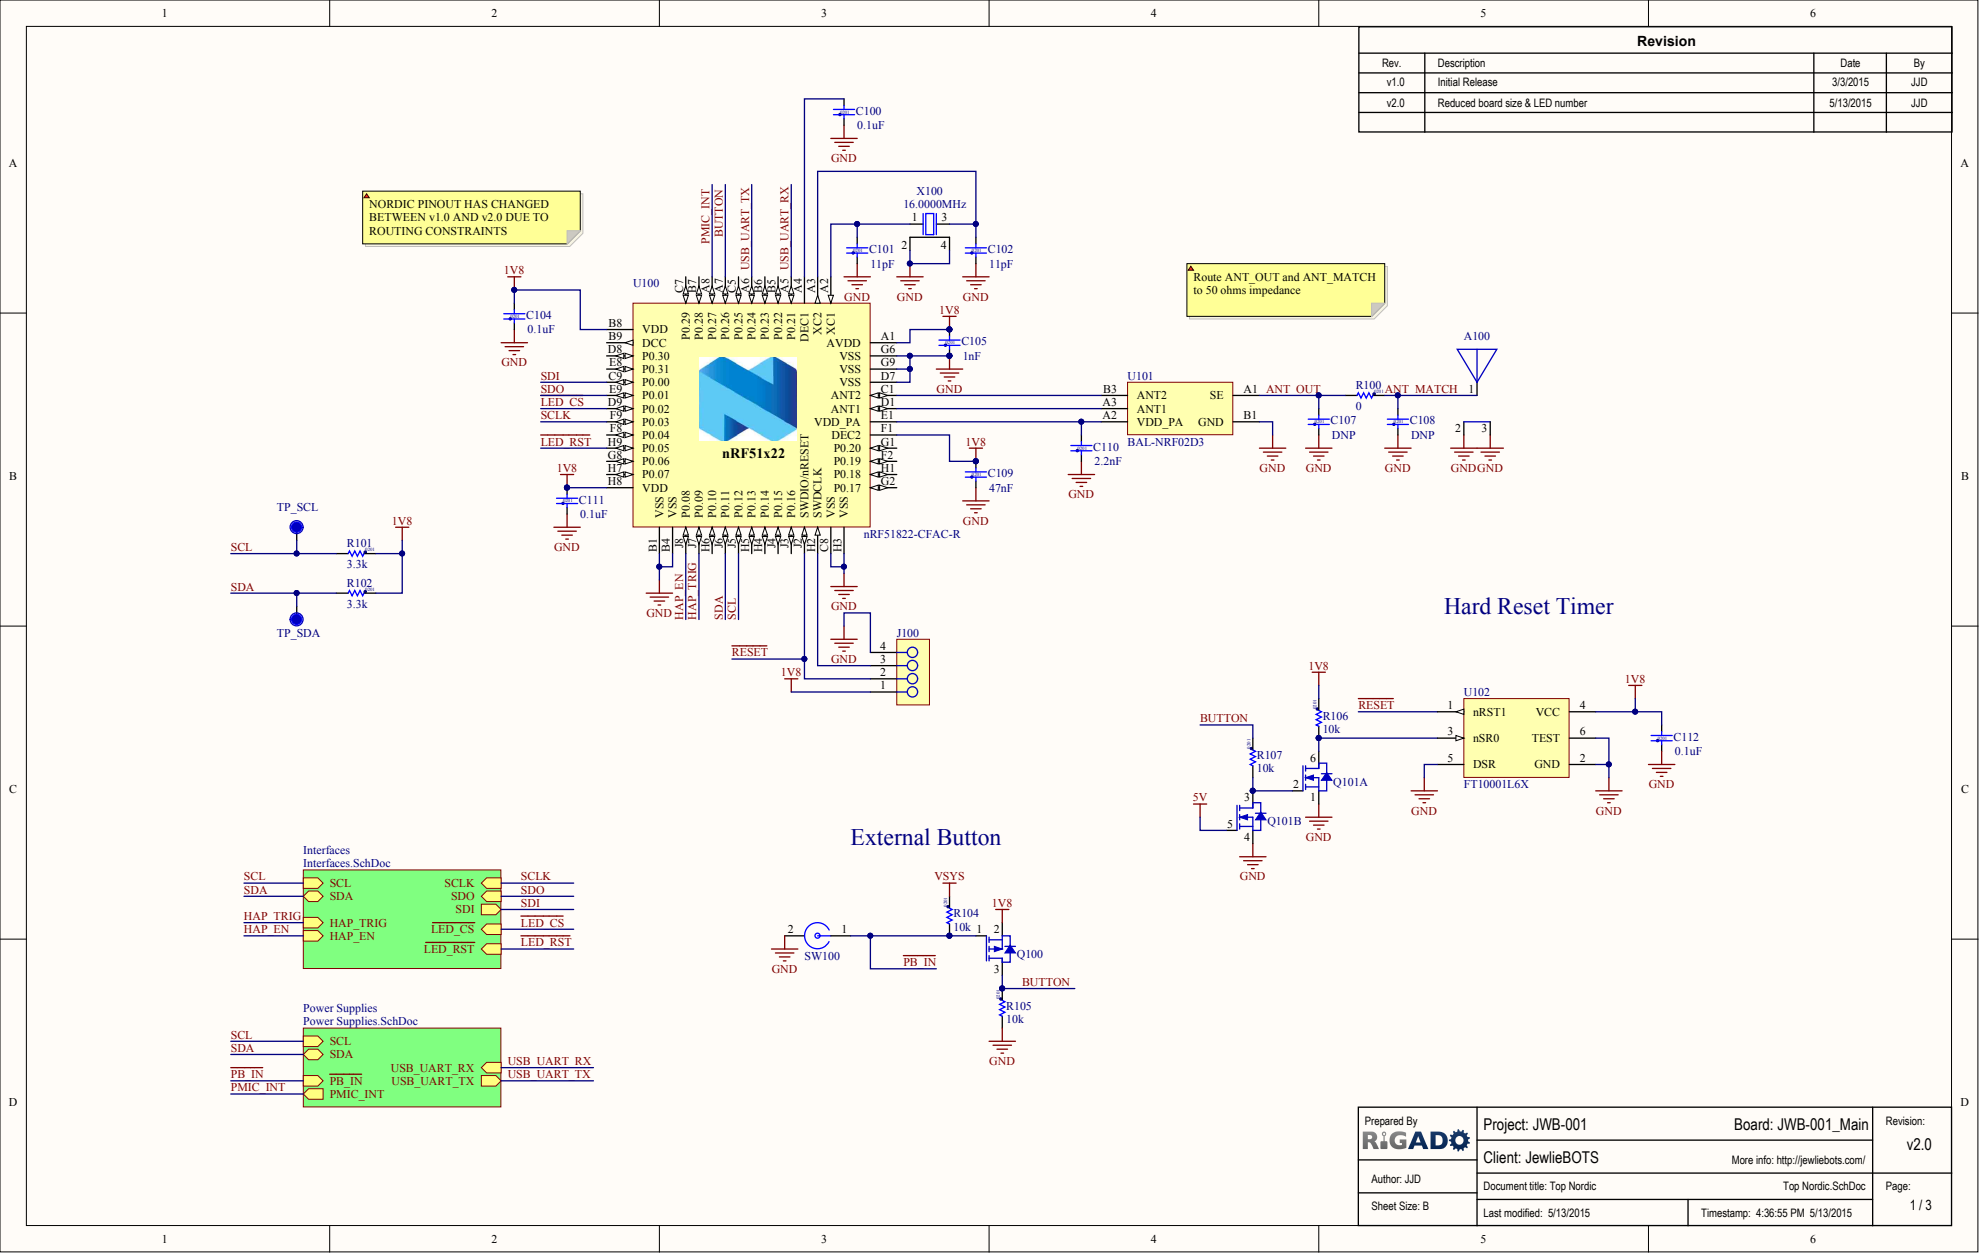
[picture p28: page 1]

Rev. | Description | Date | By
v1.0 | Initial Release | 3/3/2015 | JJD

v2.0 | Reduced board size & LED number | 5/13/2015 | JJD

NORDIC PINOUT HAS CHANGED
BETWEEN v1.0 AND v2.0 DUE TO
ROUTING CONSTRAINTS

More info: http://jewliebots.com/

Document title: Top Nordic Top Nordic.SchDoc | Page:

Last modified: 5/13/2015 | Timestamp: 4:36:55 PM 5/13/2015

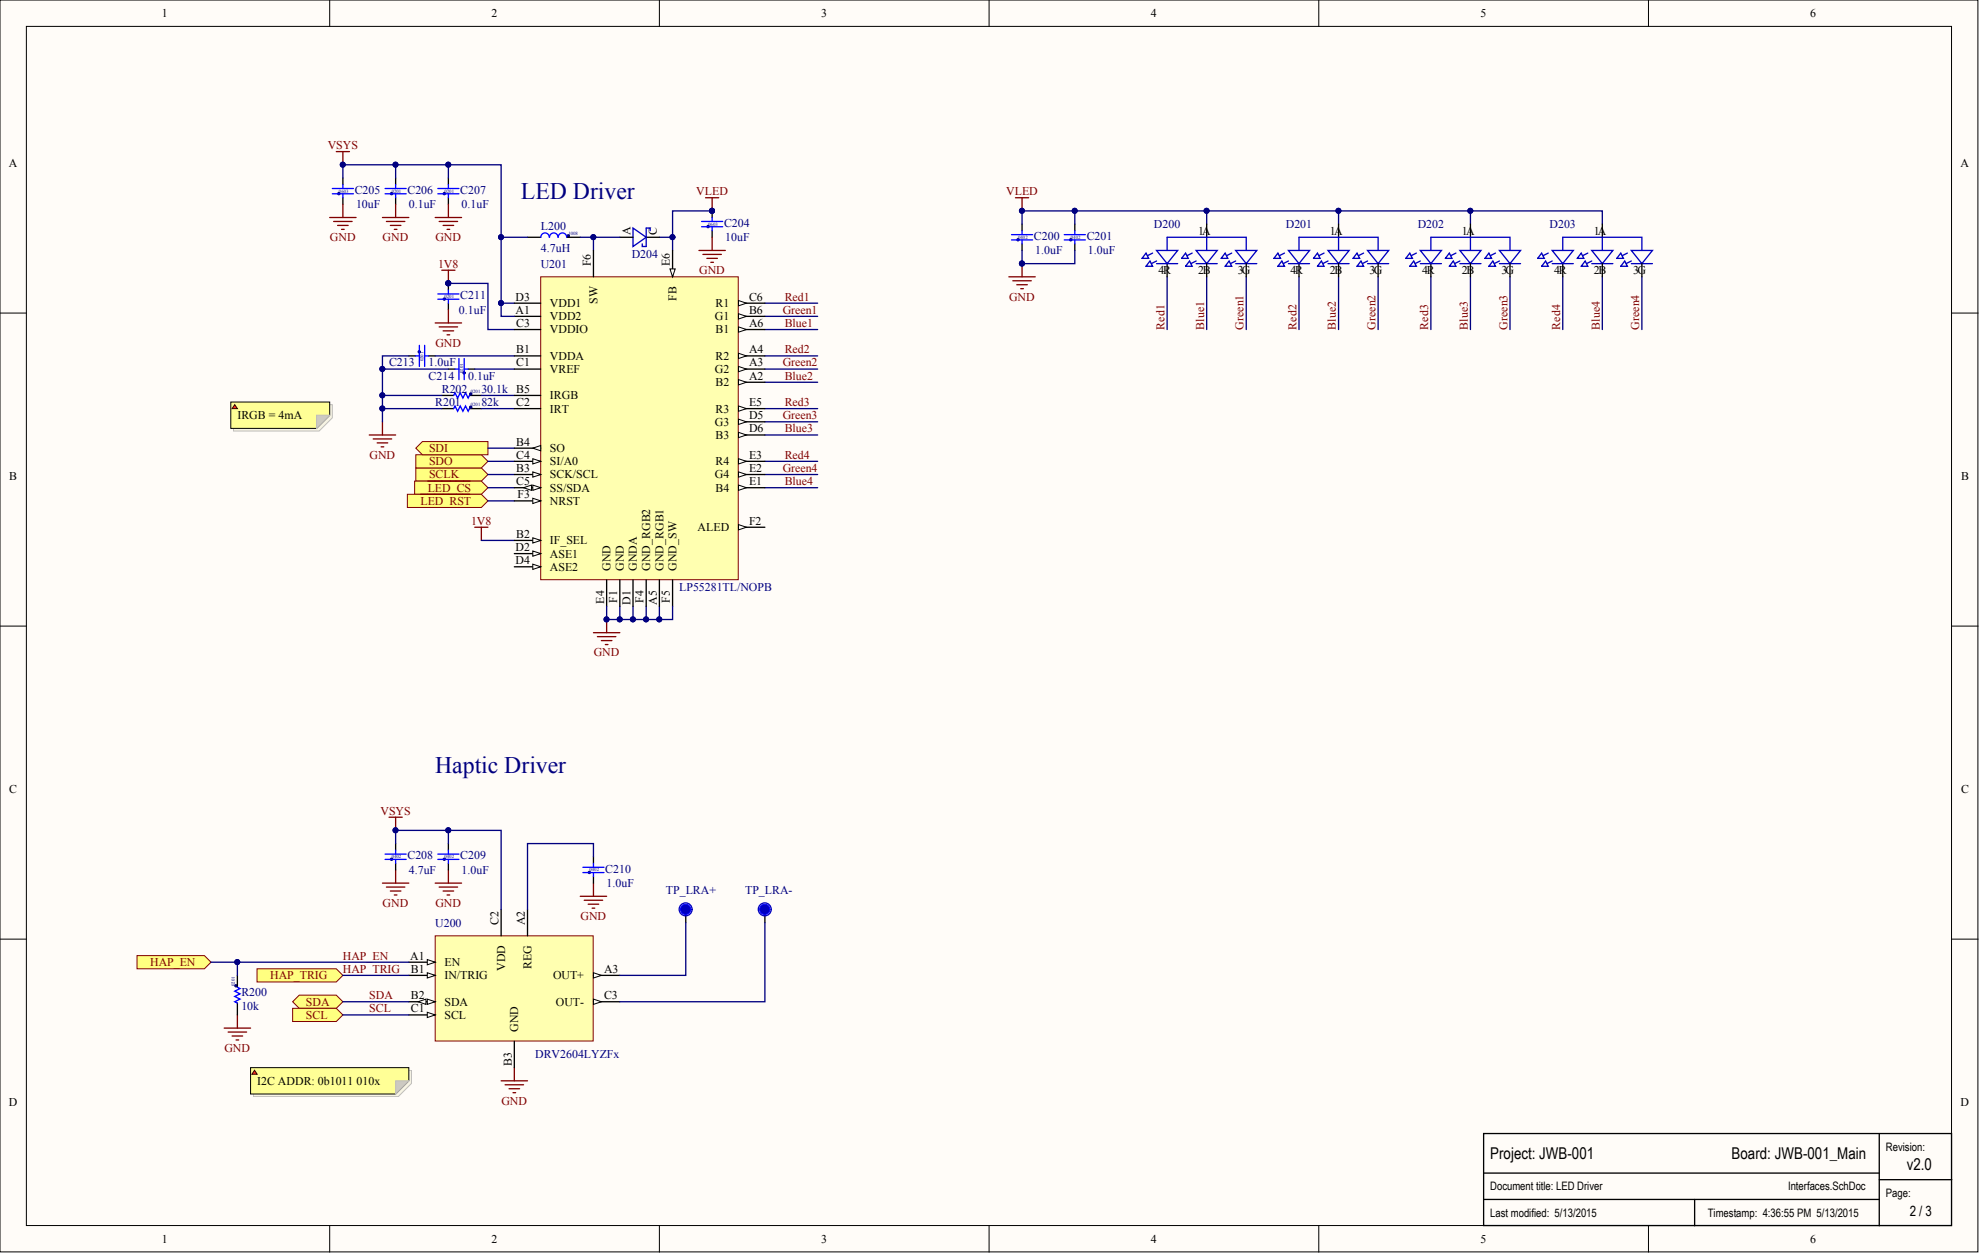
[picture p29: page 2]

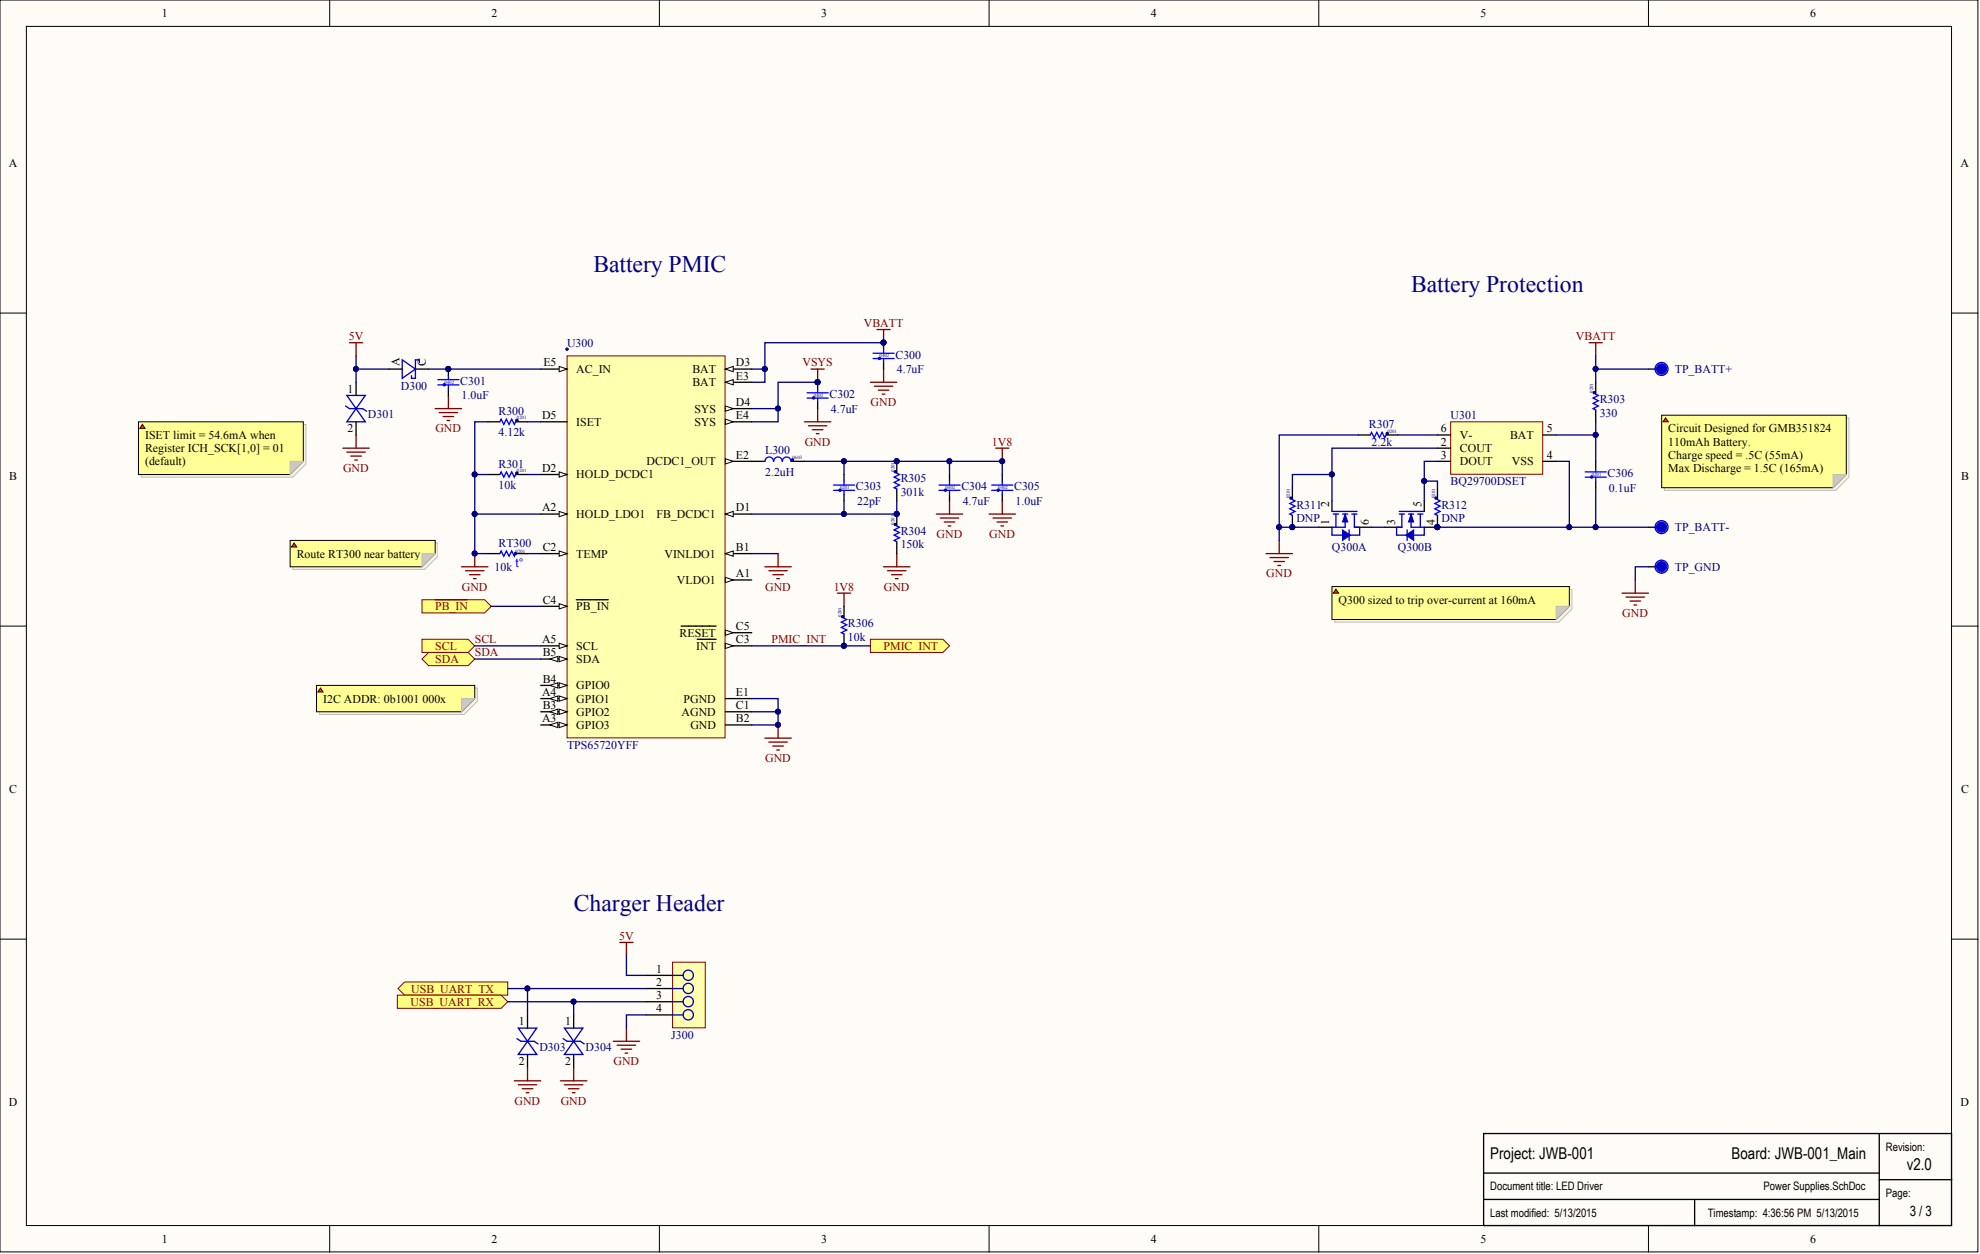
[picture p30: page 3]

Q300 sized to trip over-current at 160mA
