Jewelbots/jewelbot-ee/JWB-001_Main_v2.0/Source/Power Supplies.PDF

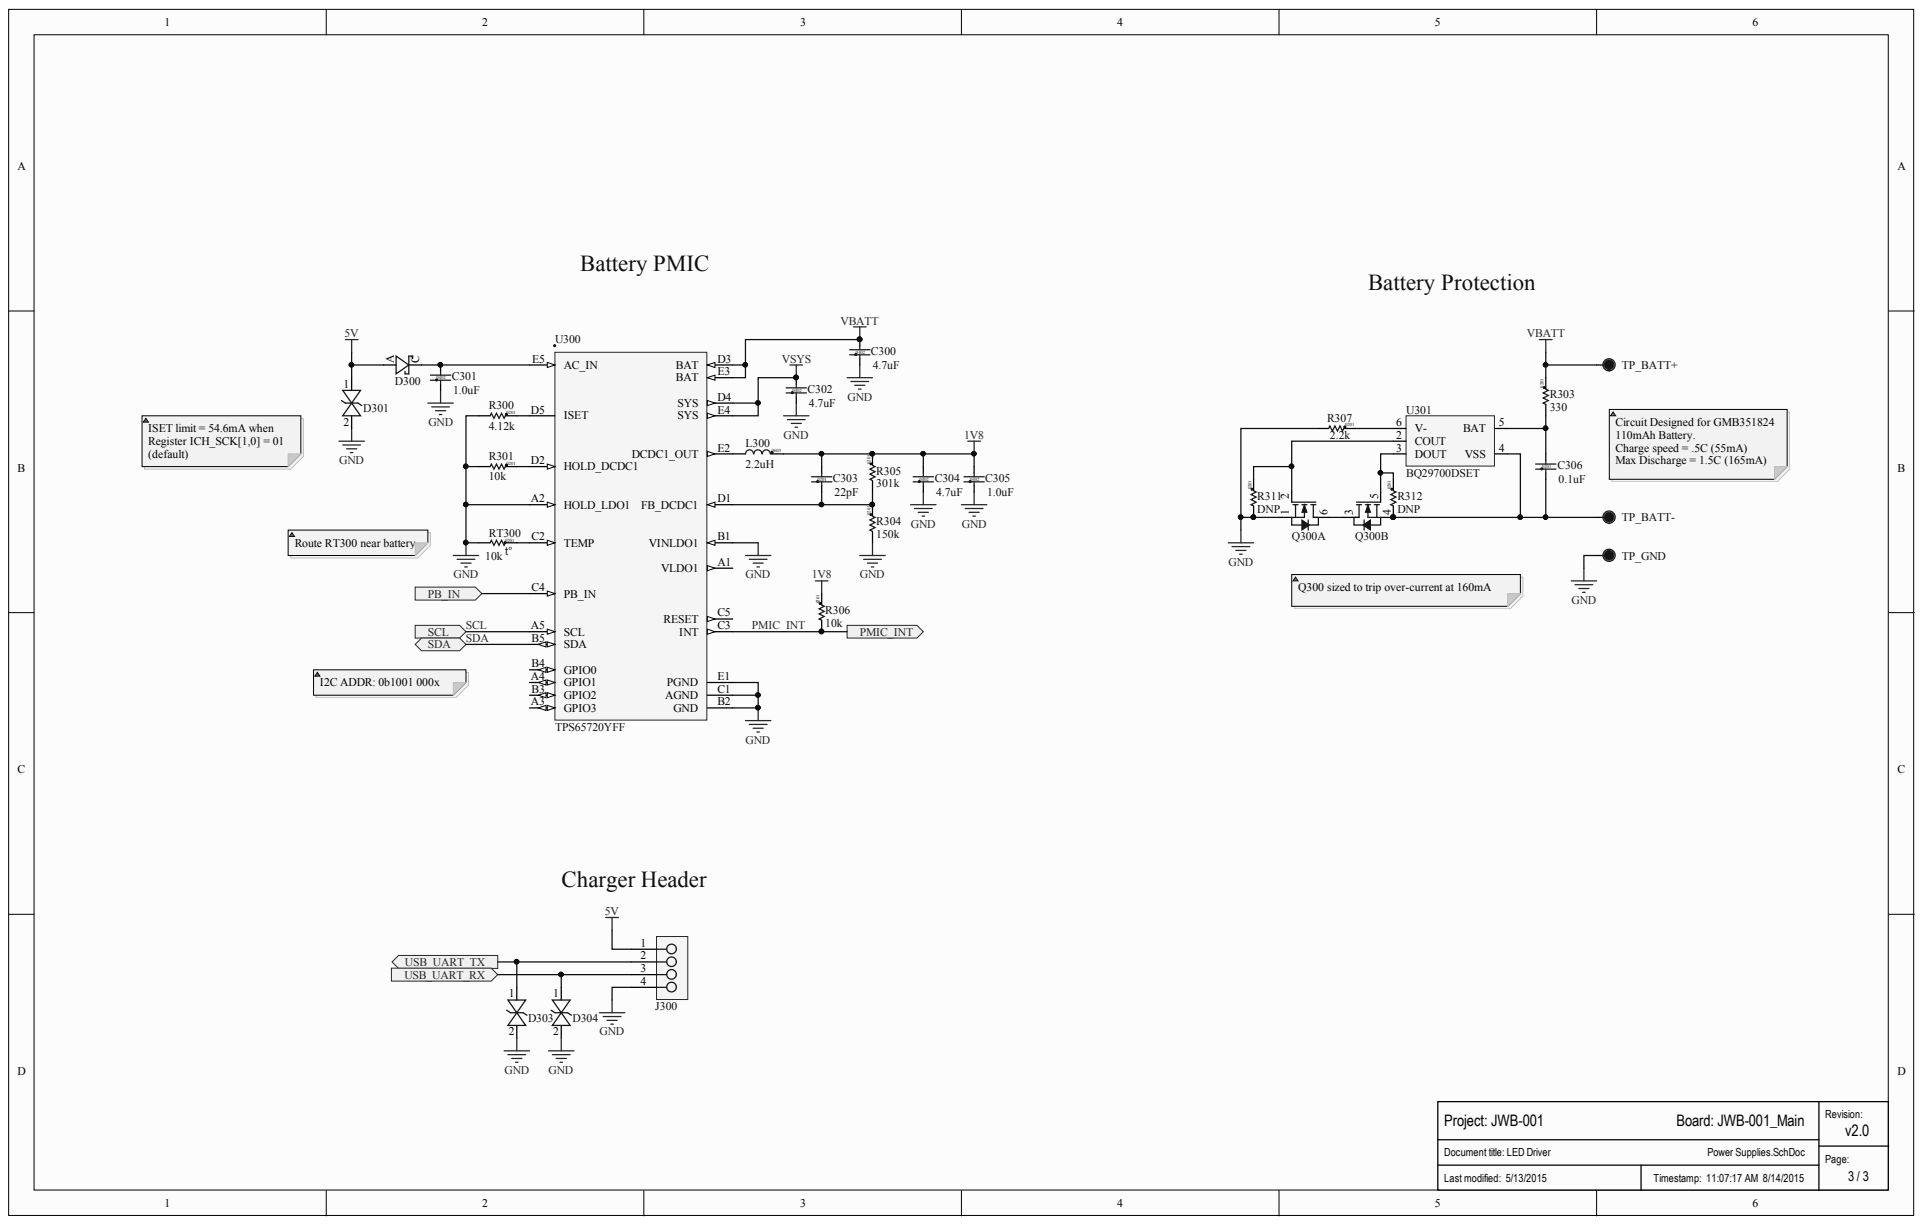
[picture p31: page 1]

Q300 sized to trip over-current at 160mA
