Jewelbots/jewelbot-ee/JWB-001_v3.8_160615/Schematic/Programming.pdf

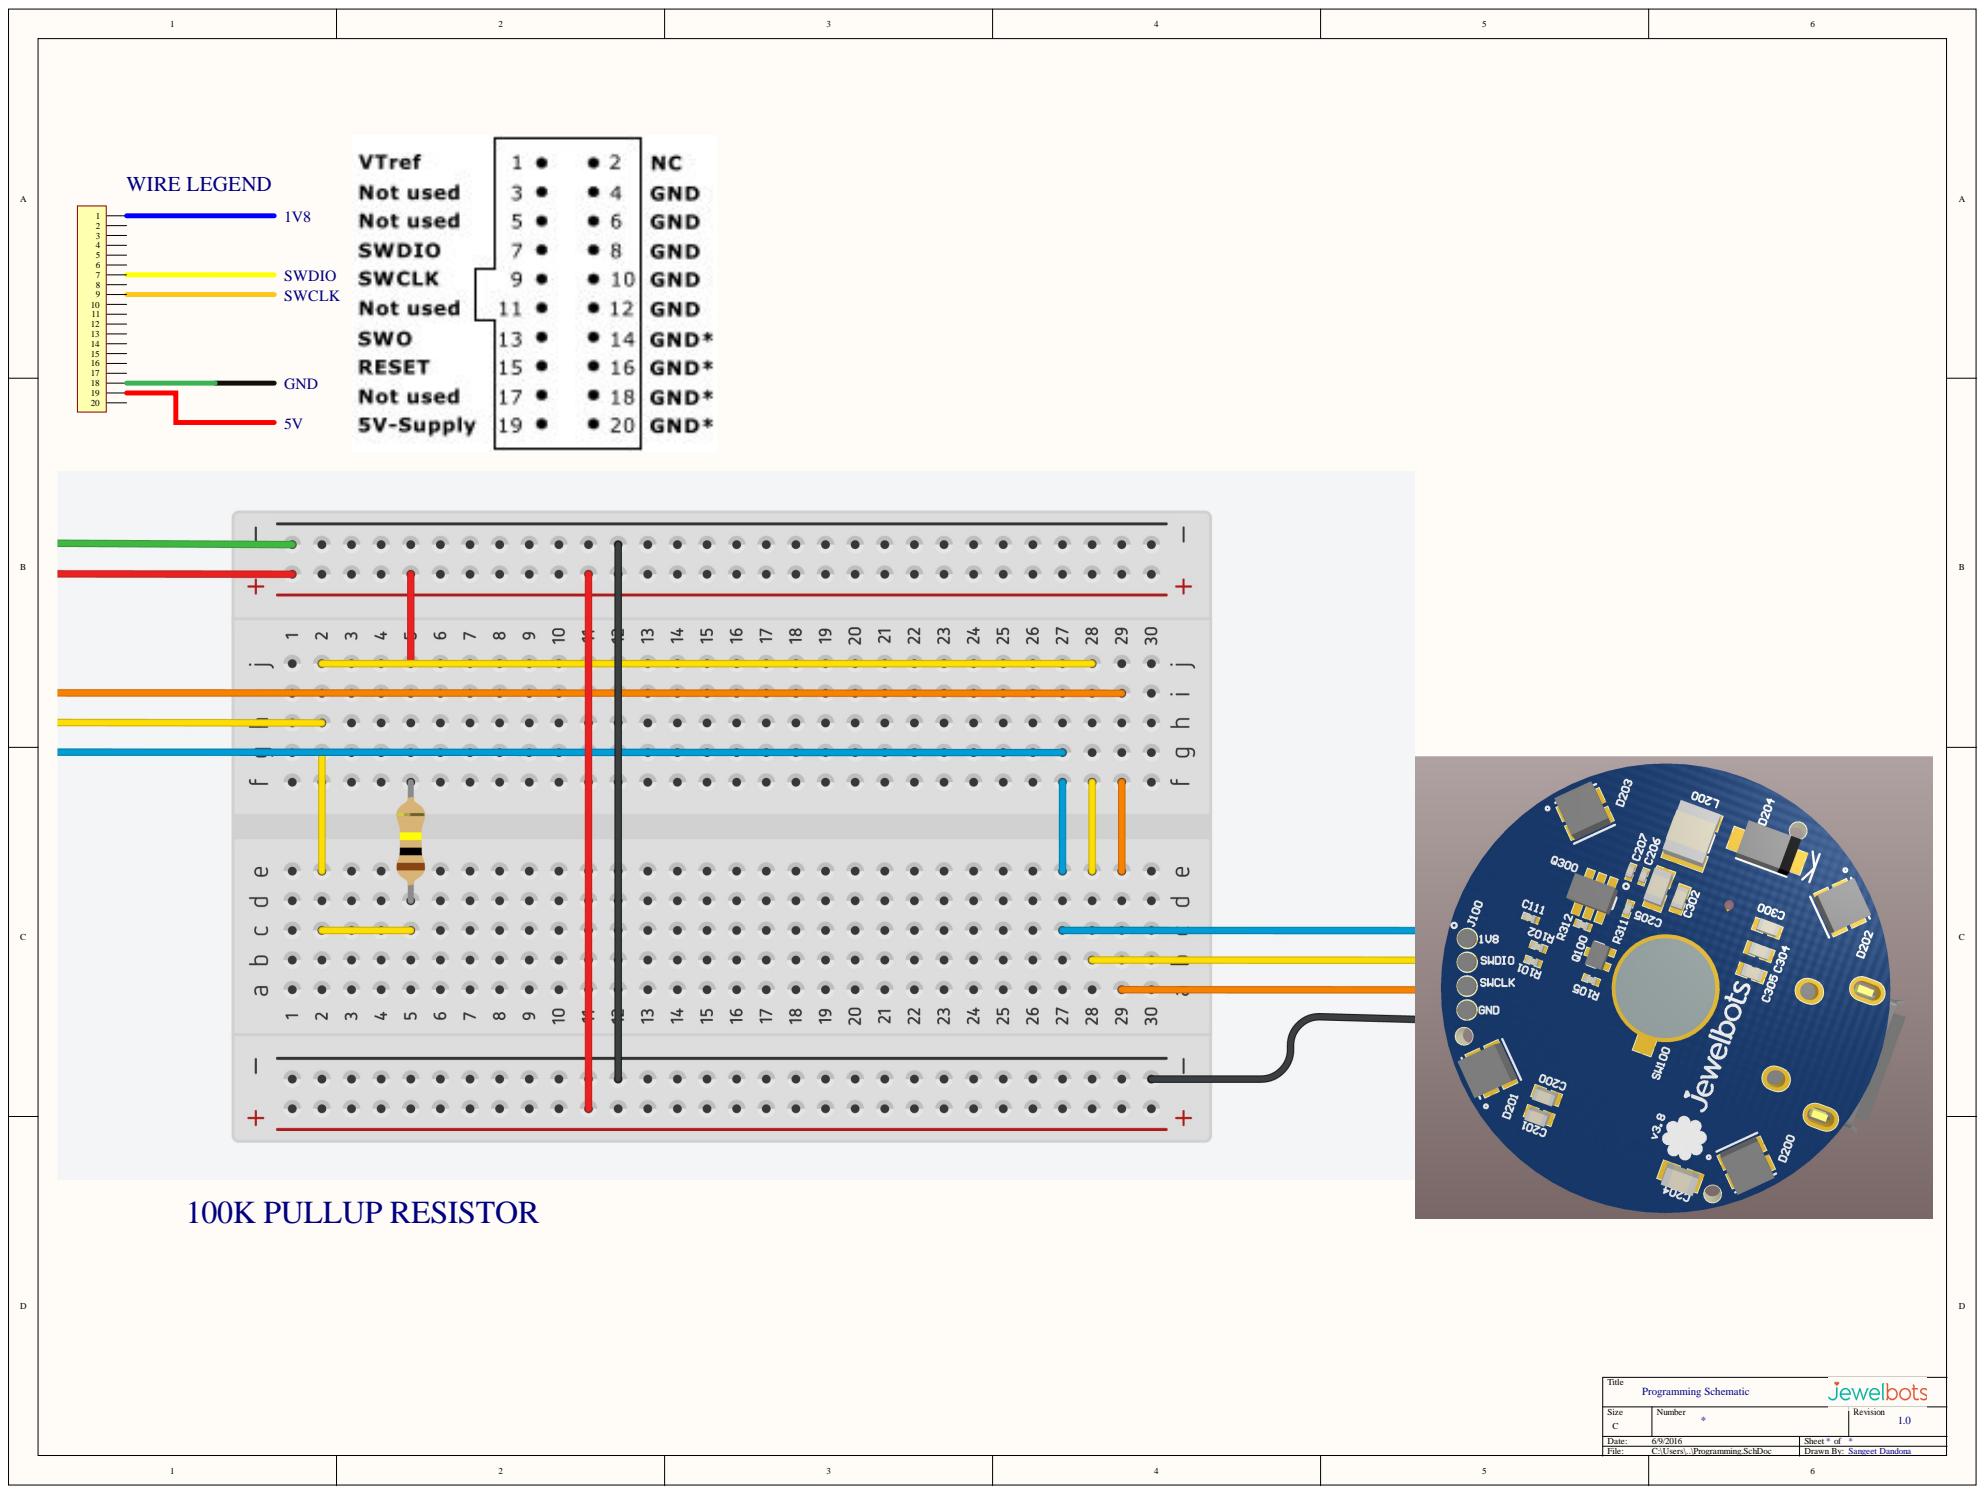
[picture p32: page 1]
