Jewelbots/jewelbot-ee/JDB-001_v2.0/Layout/JDB-001_PCB.PDF

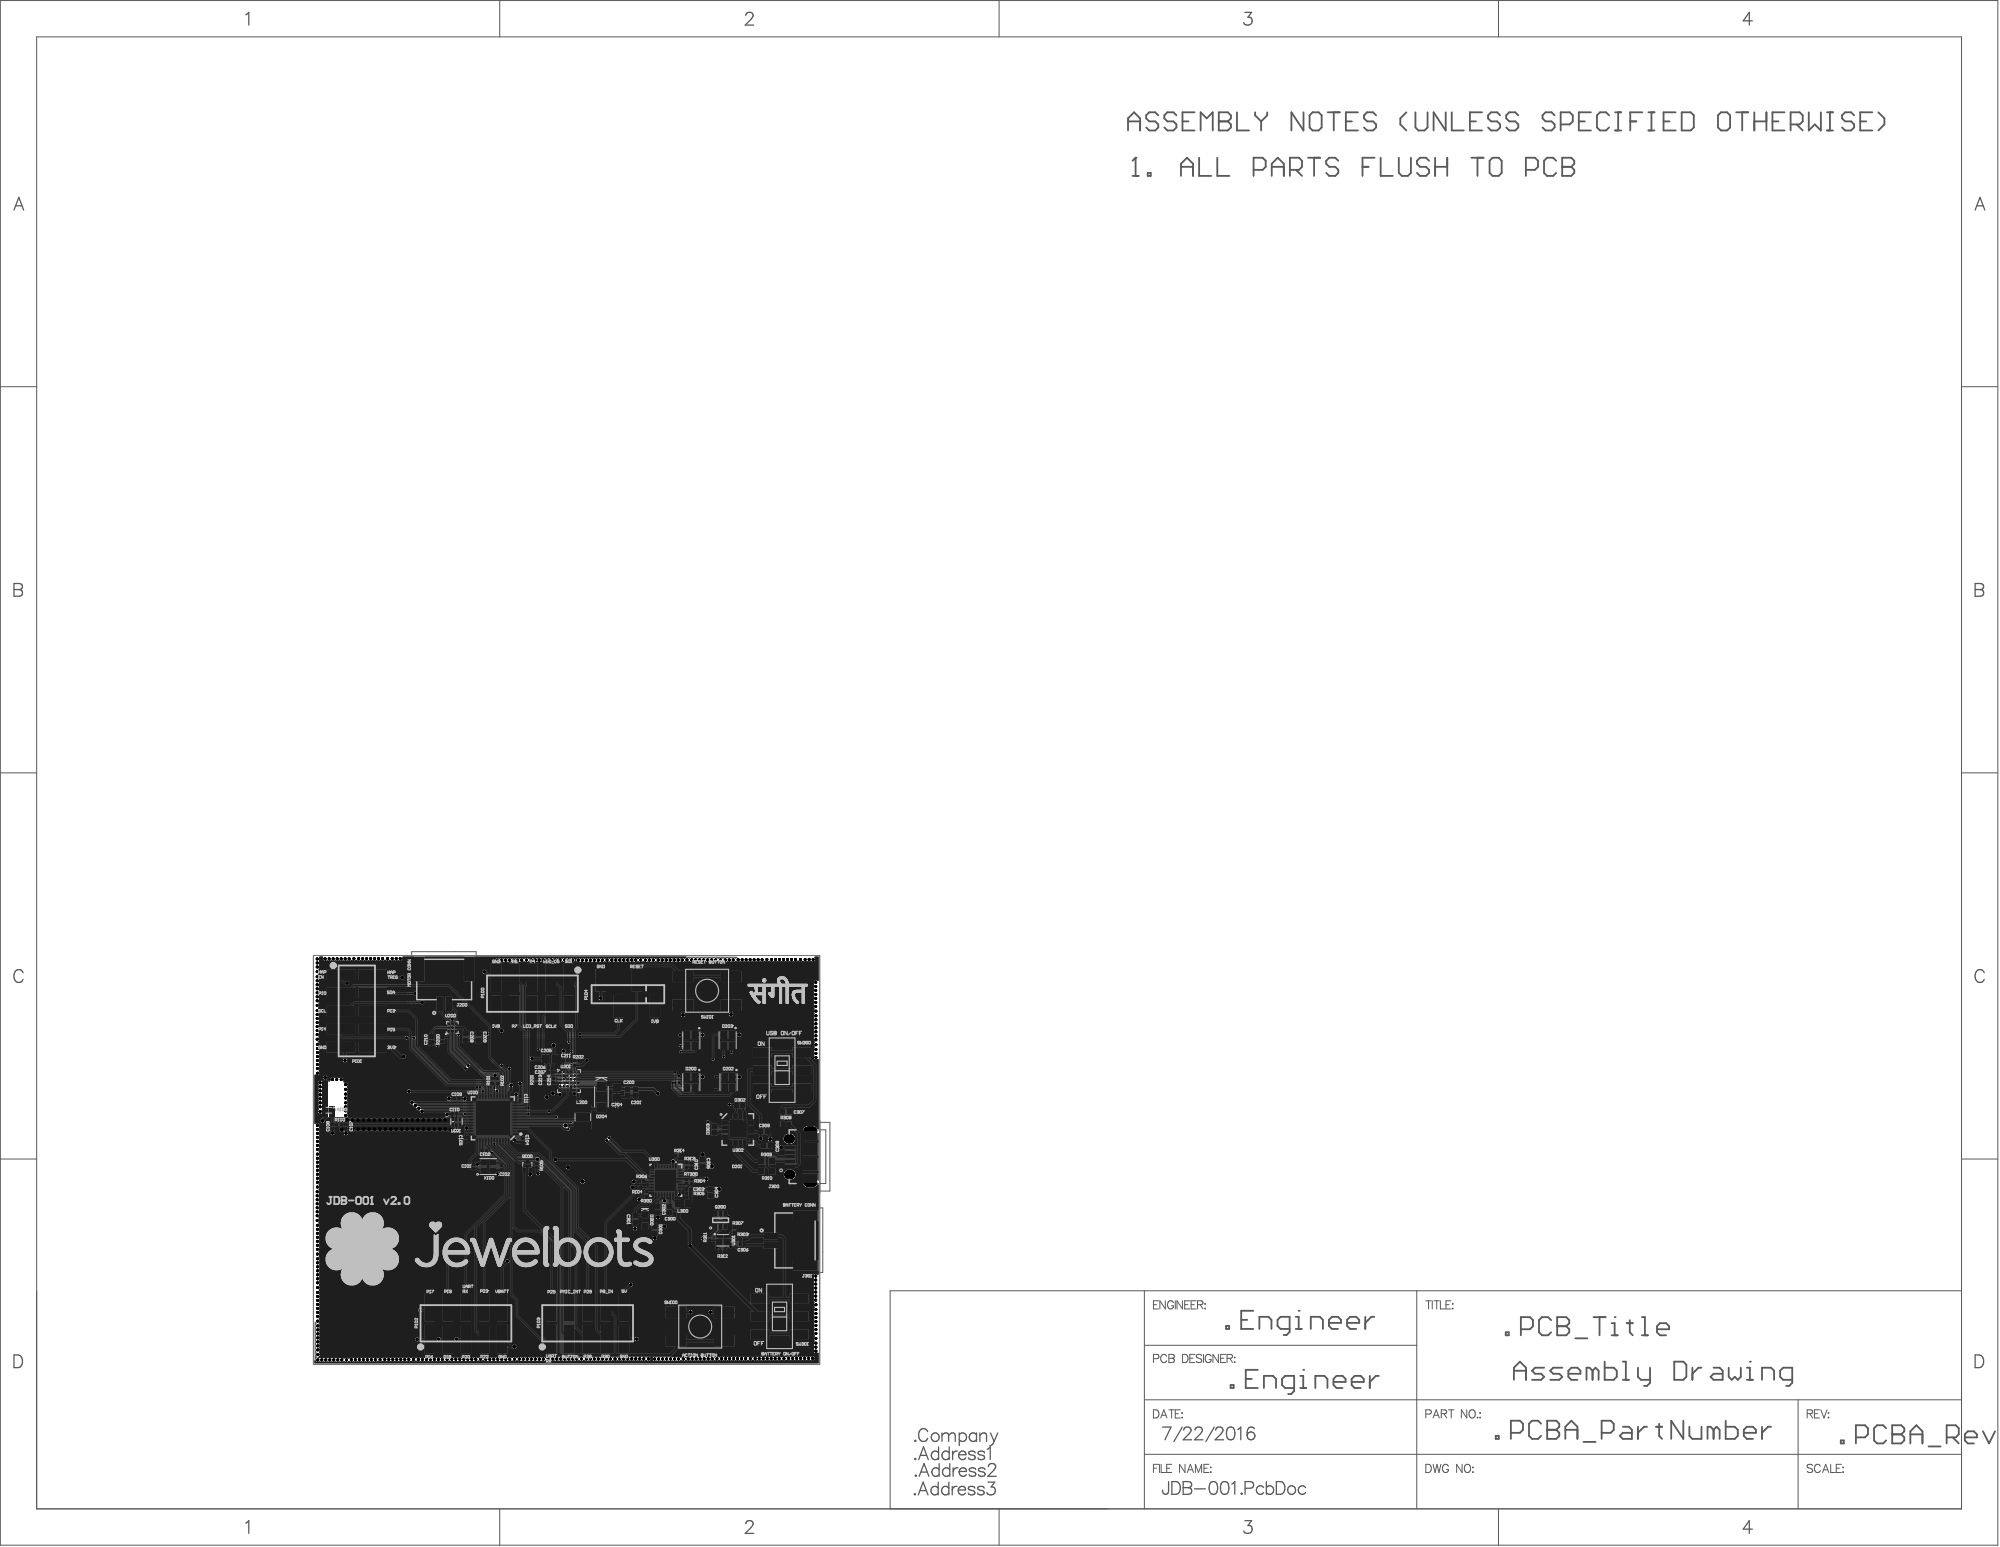
[picture p33: page 1]
