Jewelbots/jewelbot-ee/JDB-001_v2.0/Project Outputs for JDB-001/JDB-001 REV2.0 FabDwg.PDF

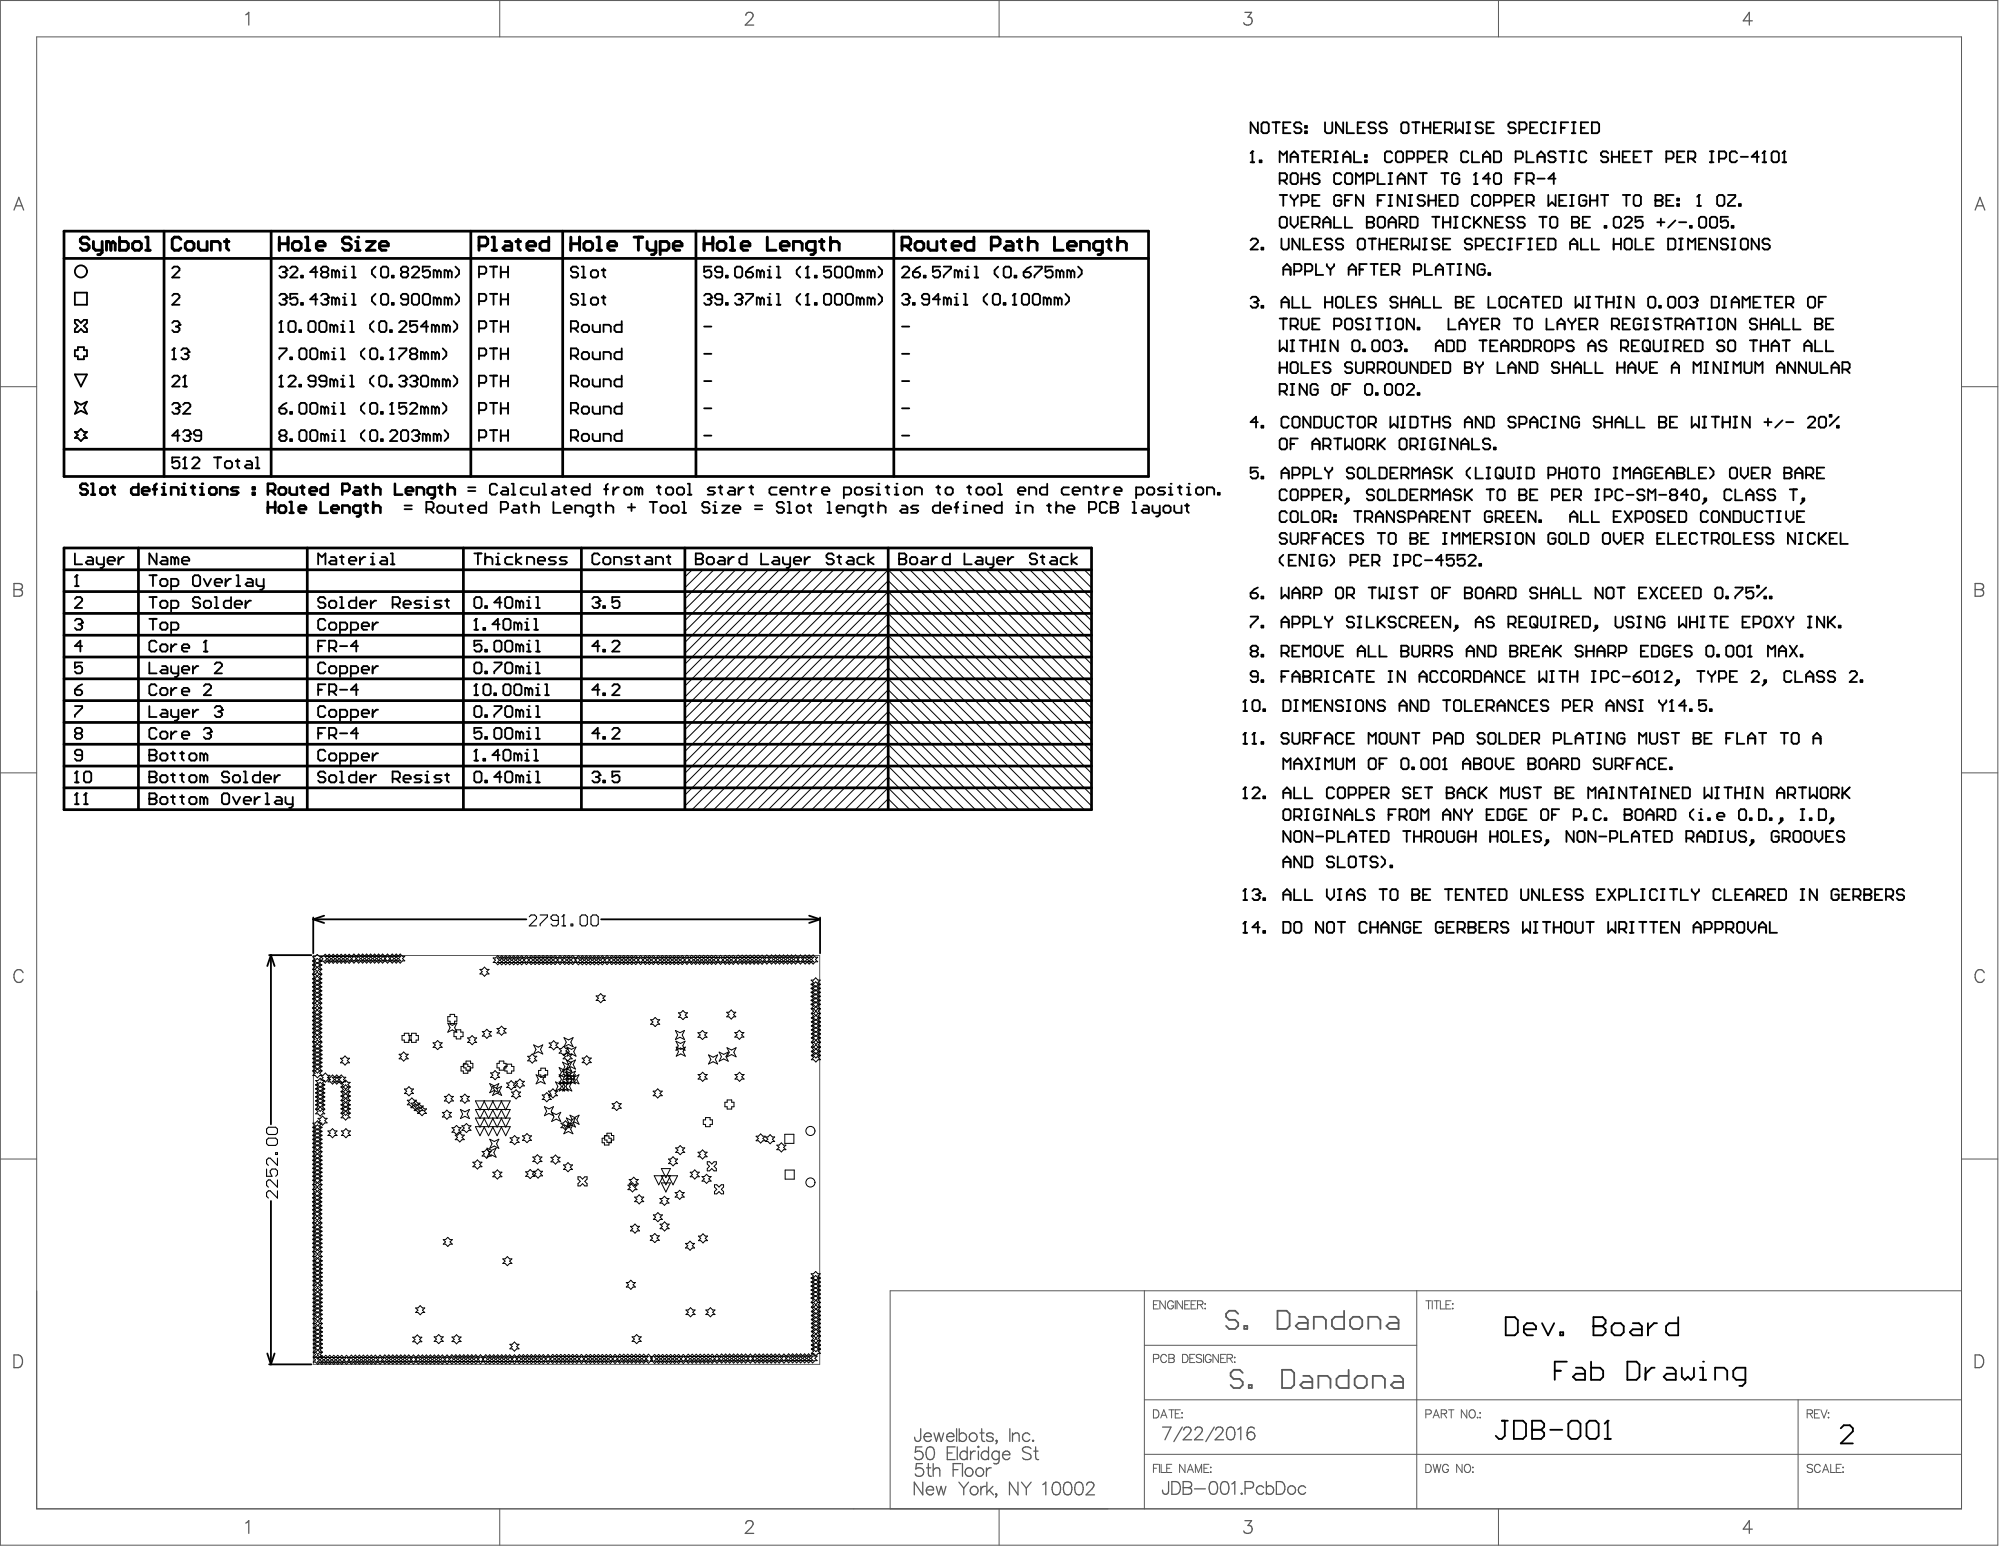
[picture p34: page 1]
