Jewelbots/jewelbot-ee/JDB-001_v2.0/SupportDocs/537800270_sd.pdf

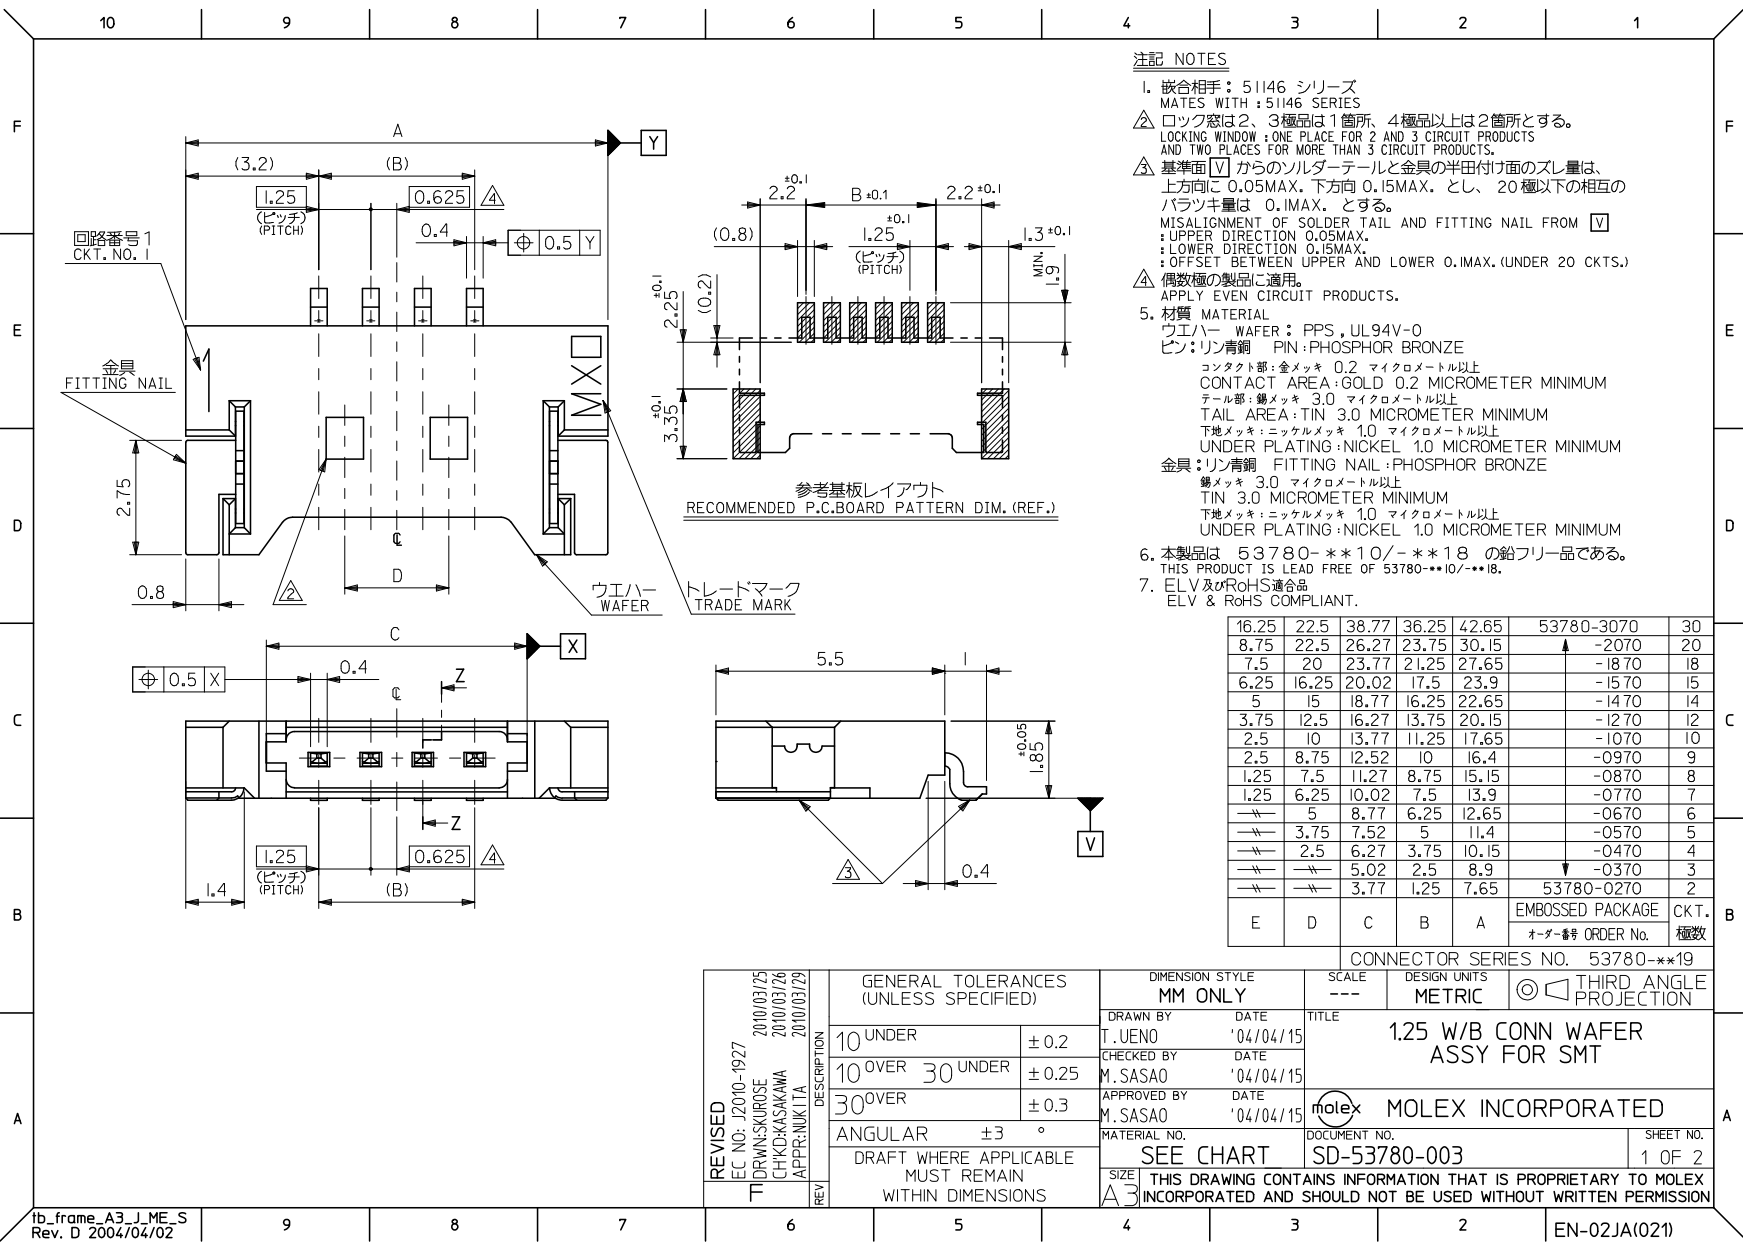
[picture p35: page 1]

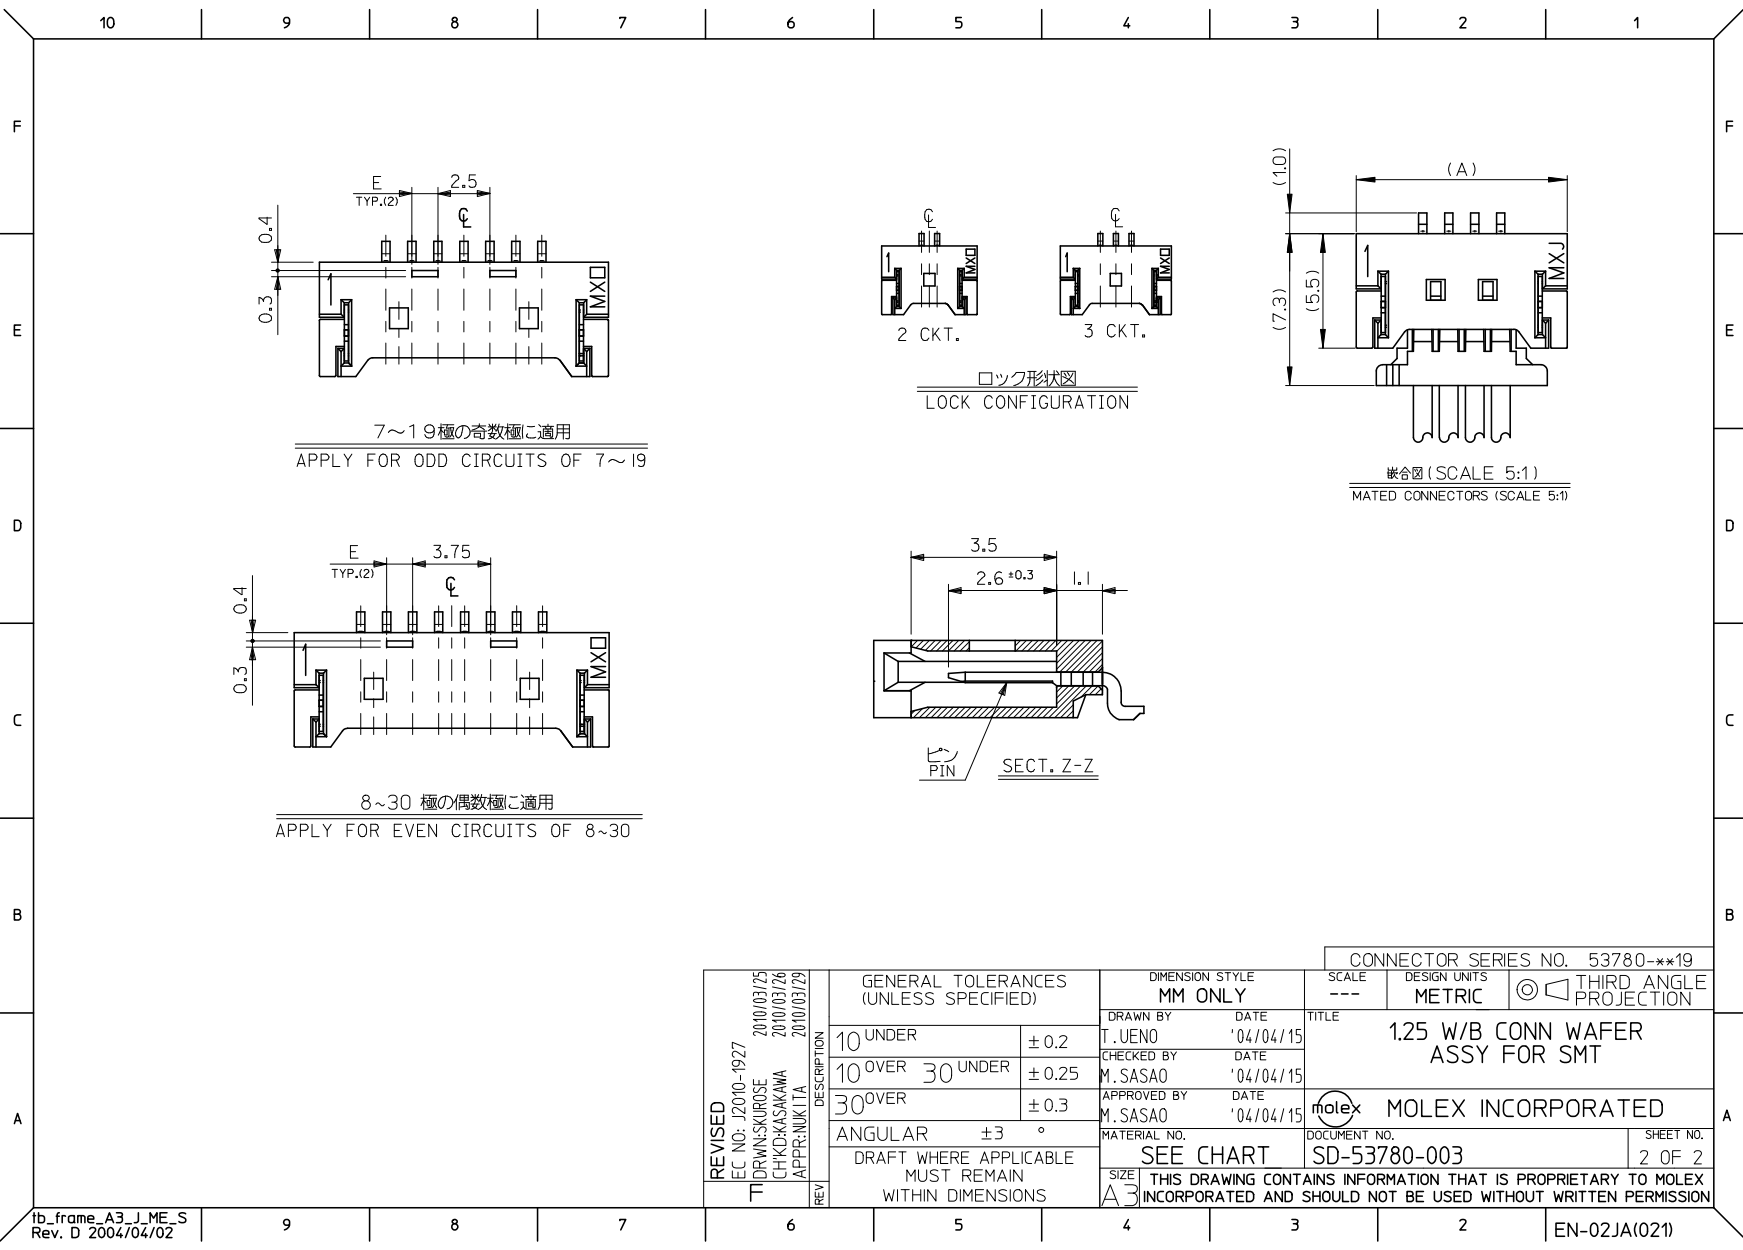
[picture p36: page 2]

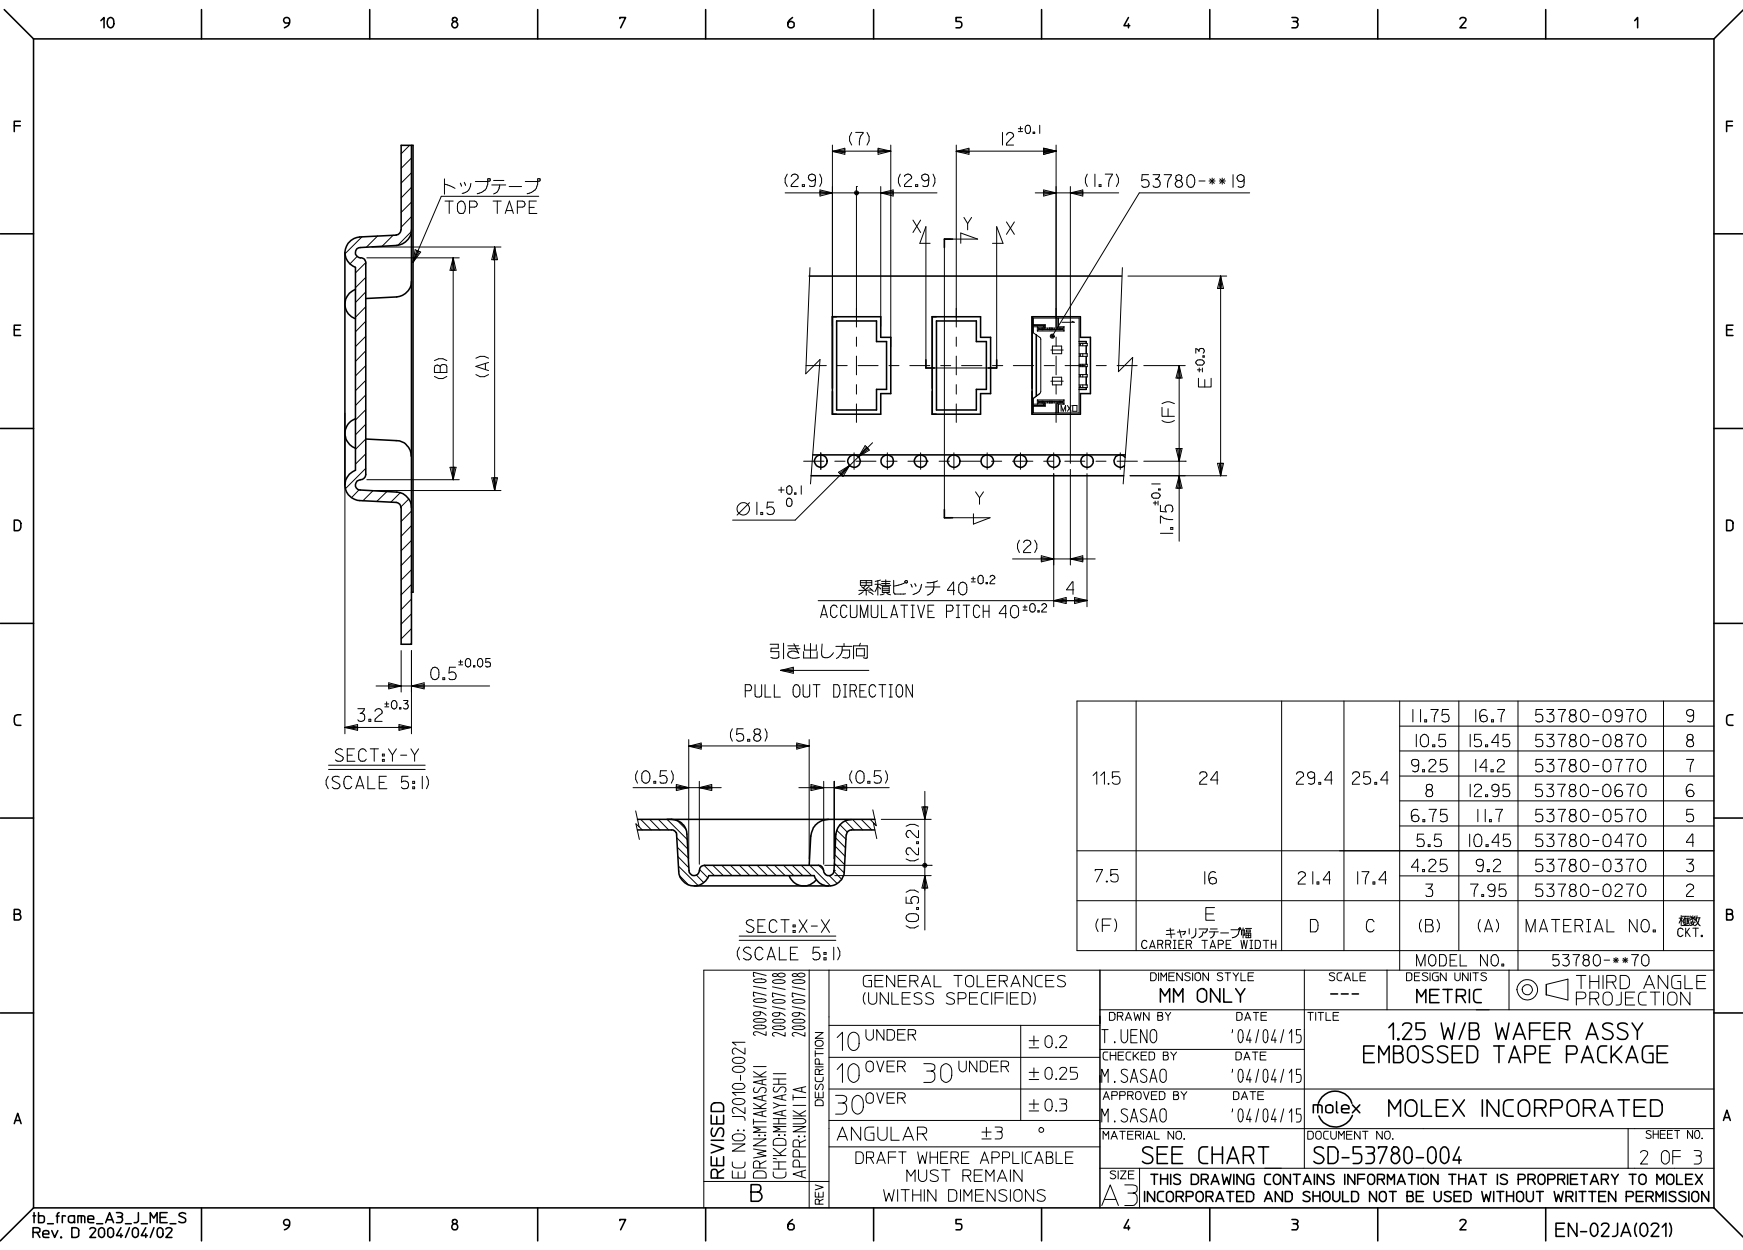
[picture p37: page 3]

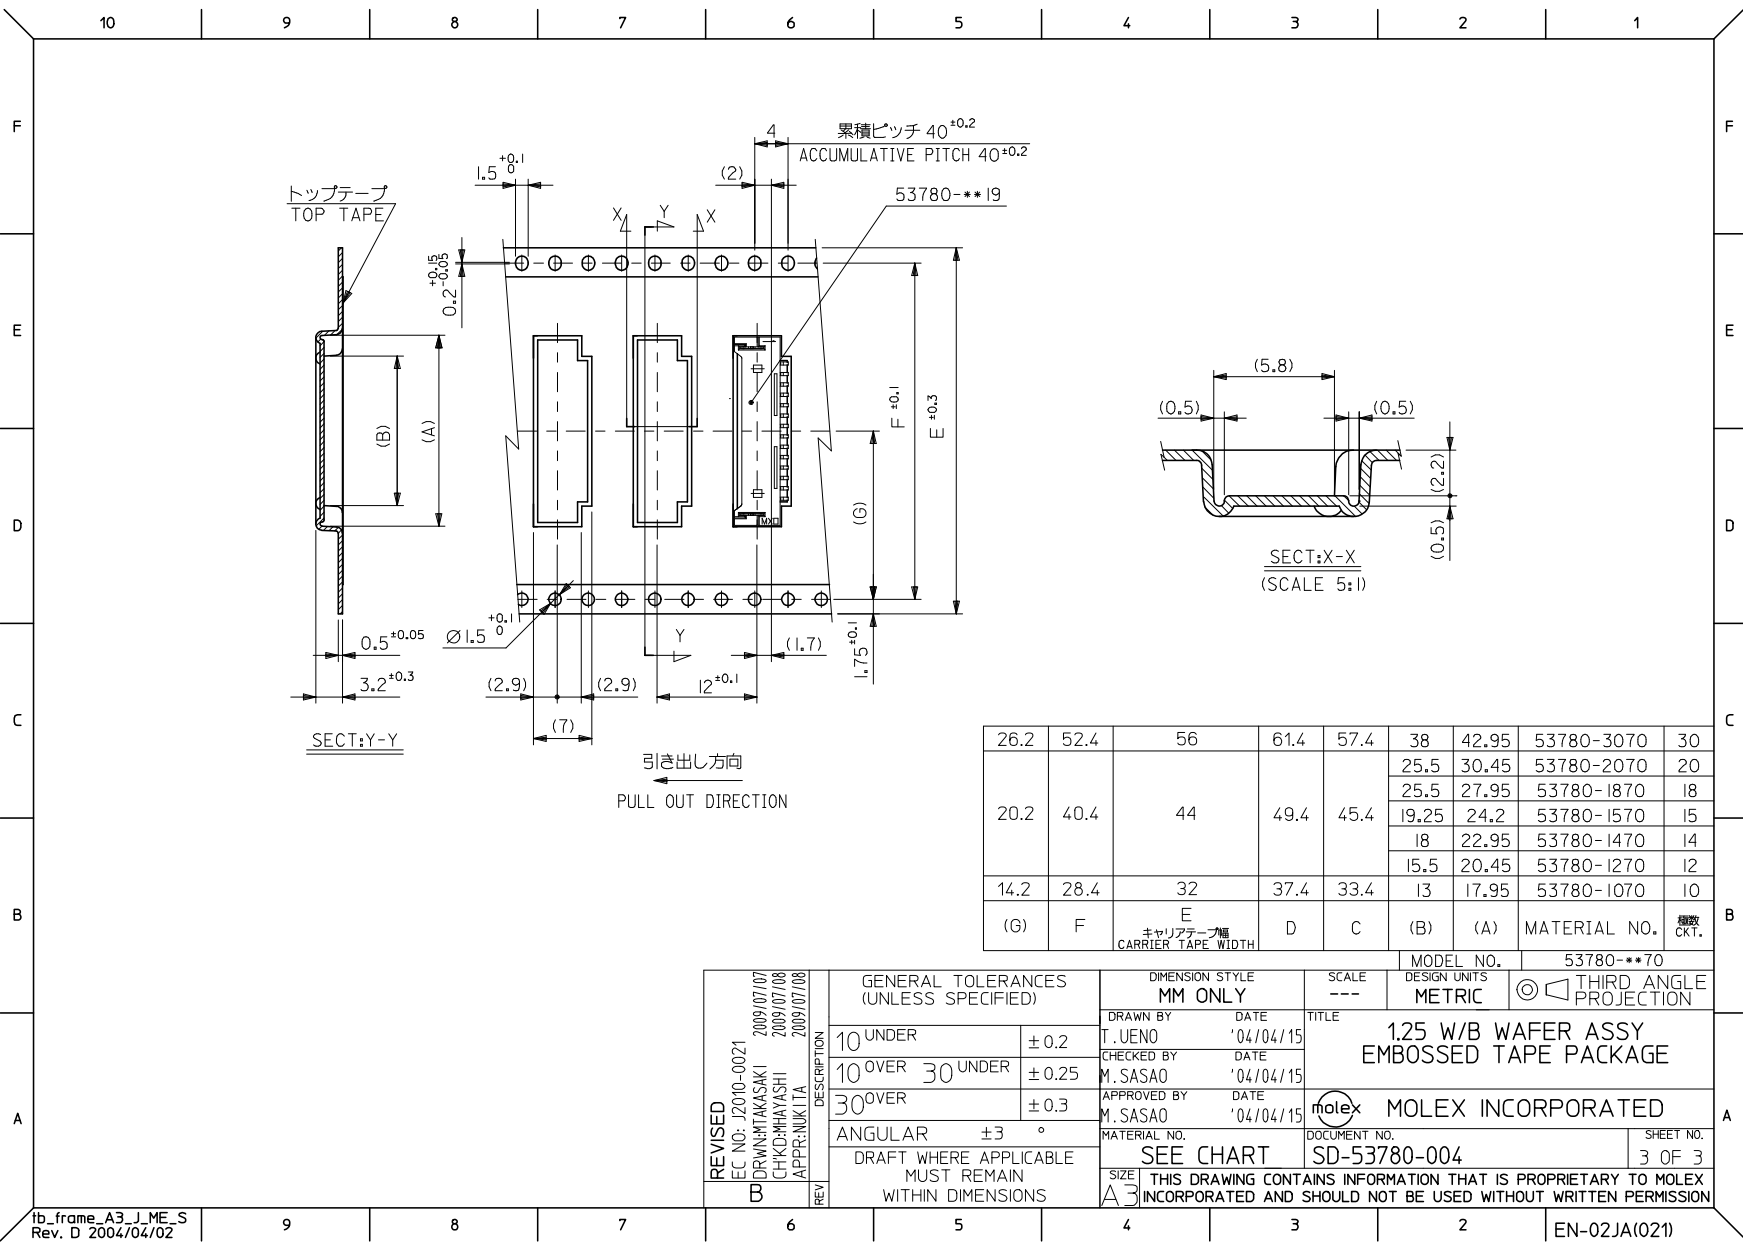
[picture p38: page 4]
