Jewelbots/jewelbot-ee/JDB-001_v2.0/SupportDocs/878980424_sd.pdf

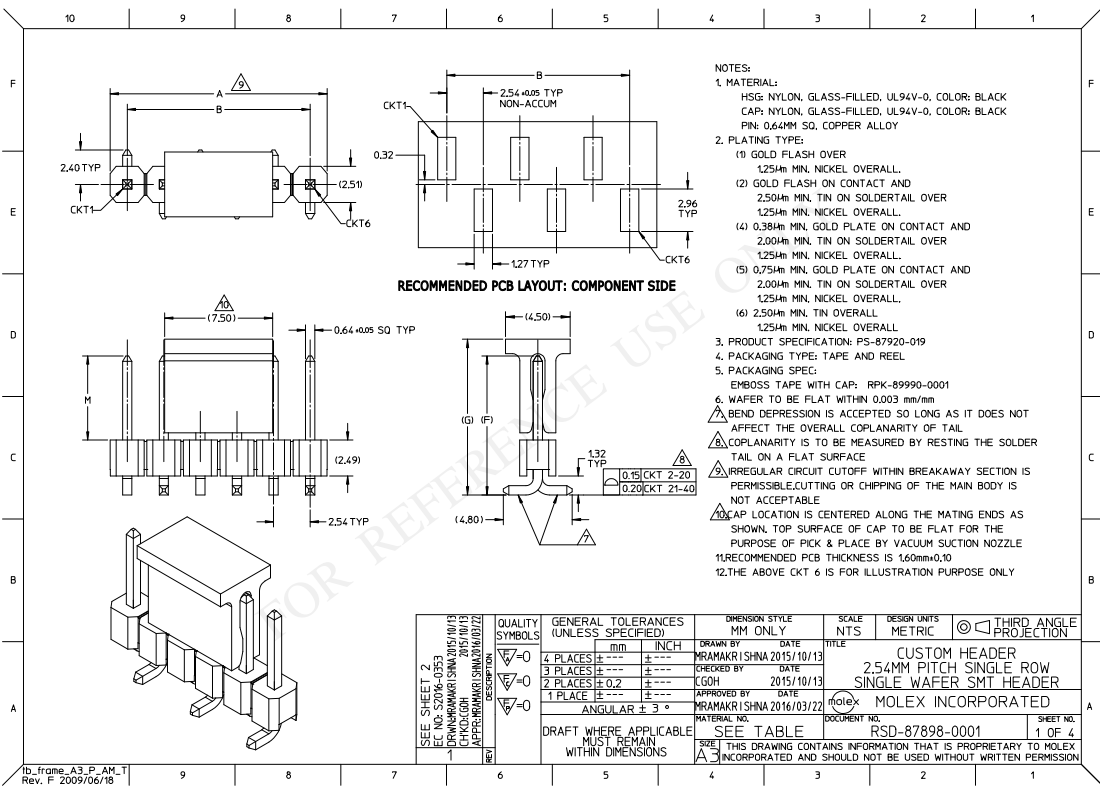
[picture p39: page 1]

FOR REFERENCE USE ONLY

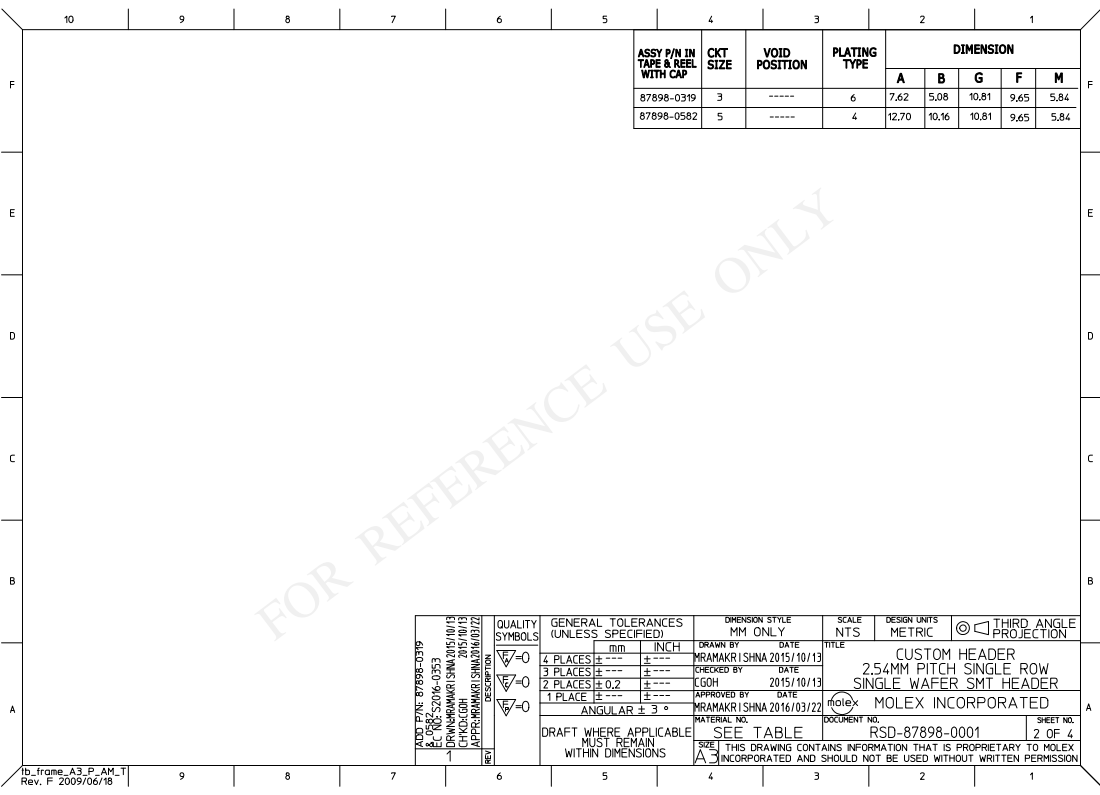
[picture p40: page 2]

FOR REFERENCE USE ONLY

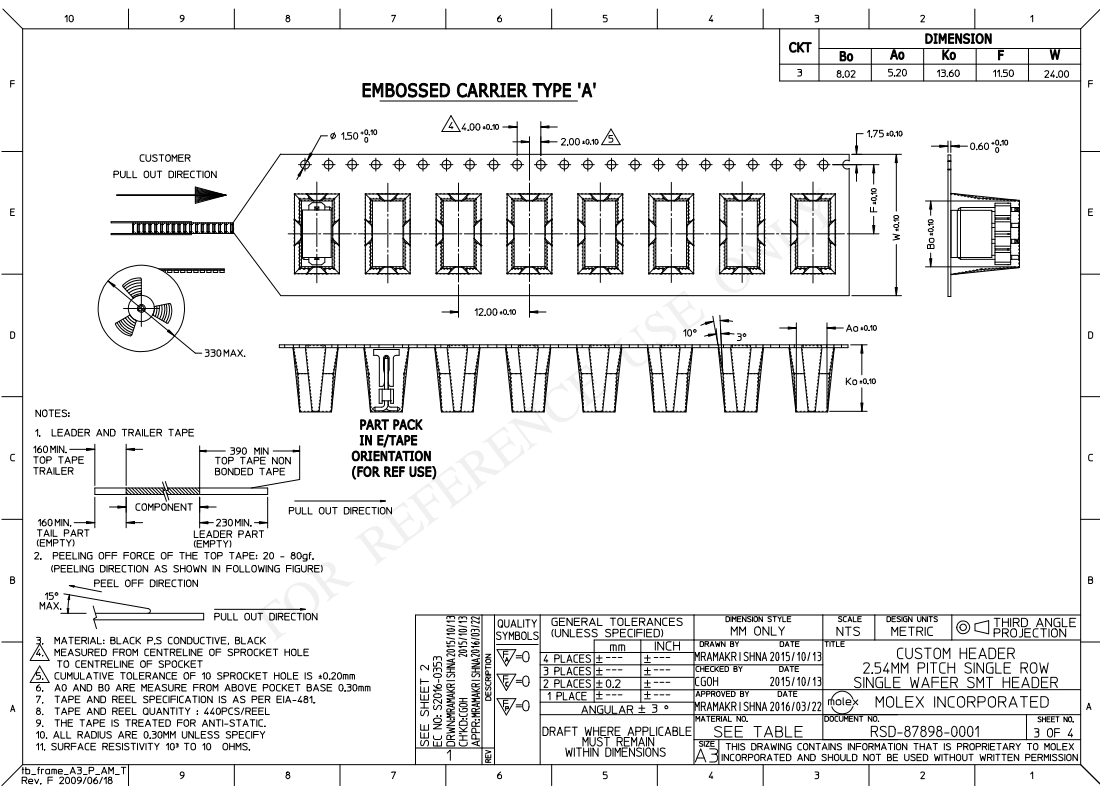
[picture p41: page 3]

FOR REFERENCE USE ONLY

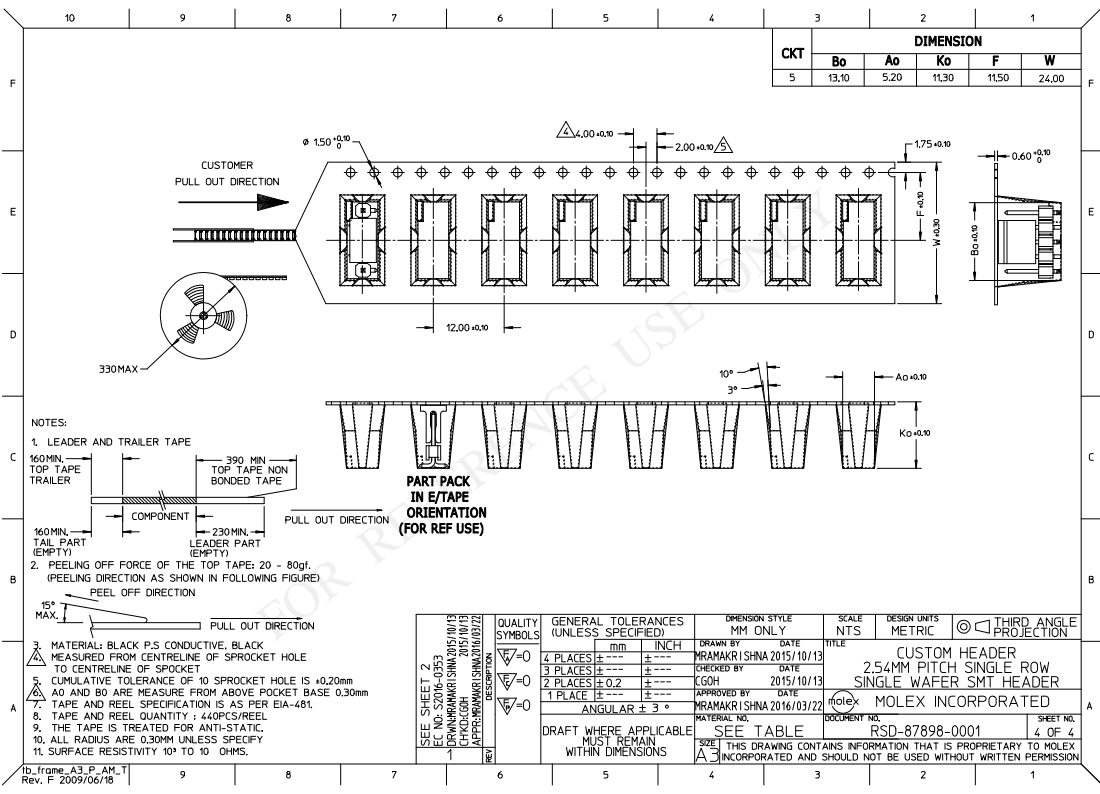
[picture p42: page 4]

FOR REFERENCE USE ONLY

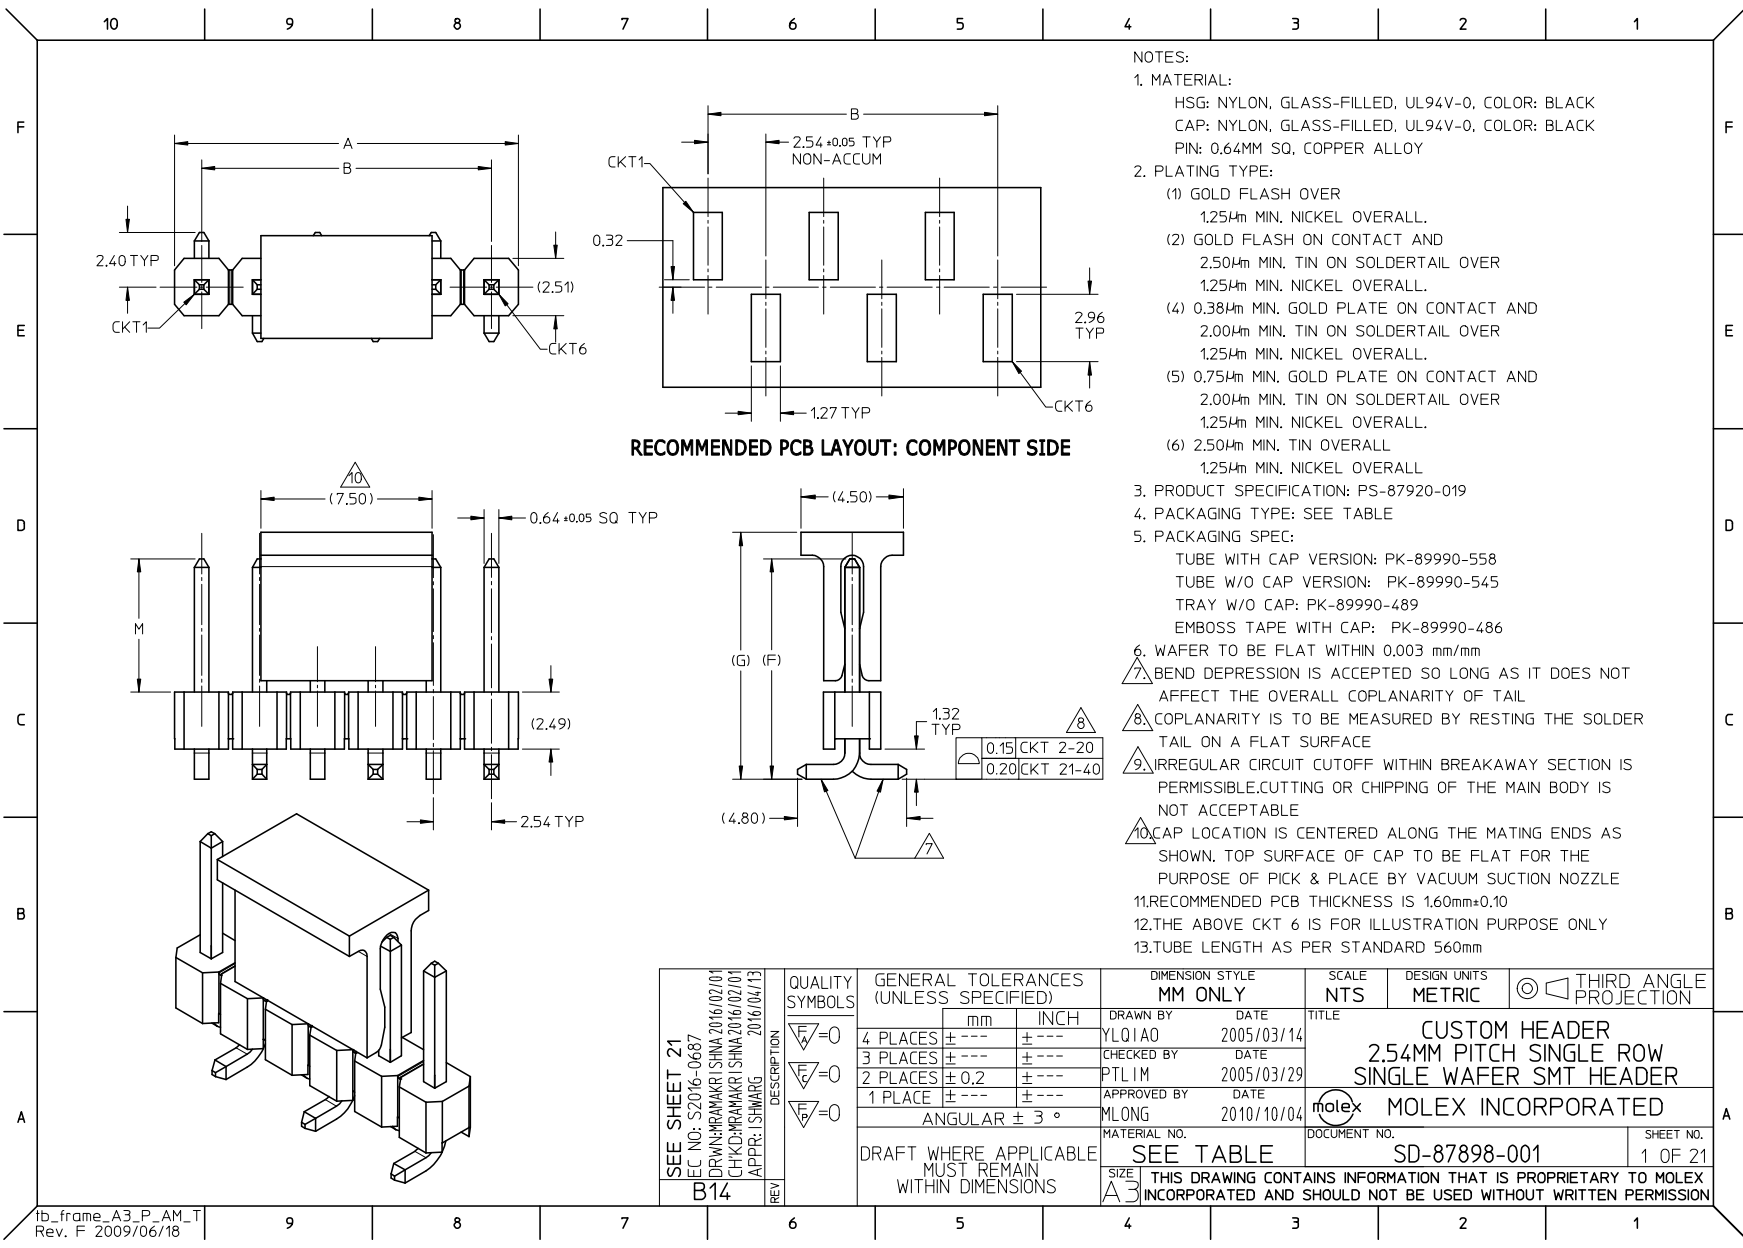
[picture p43: page 5]

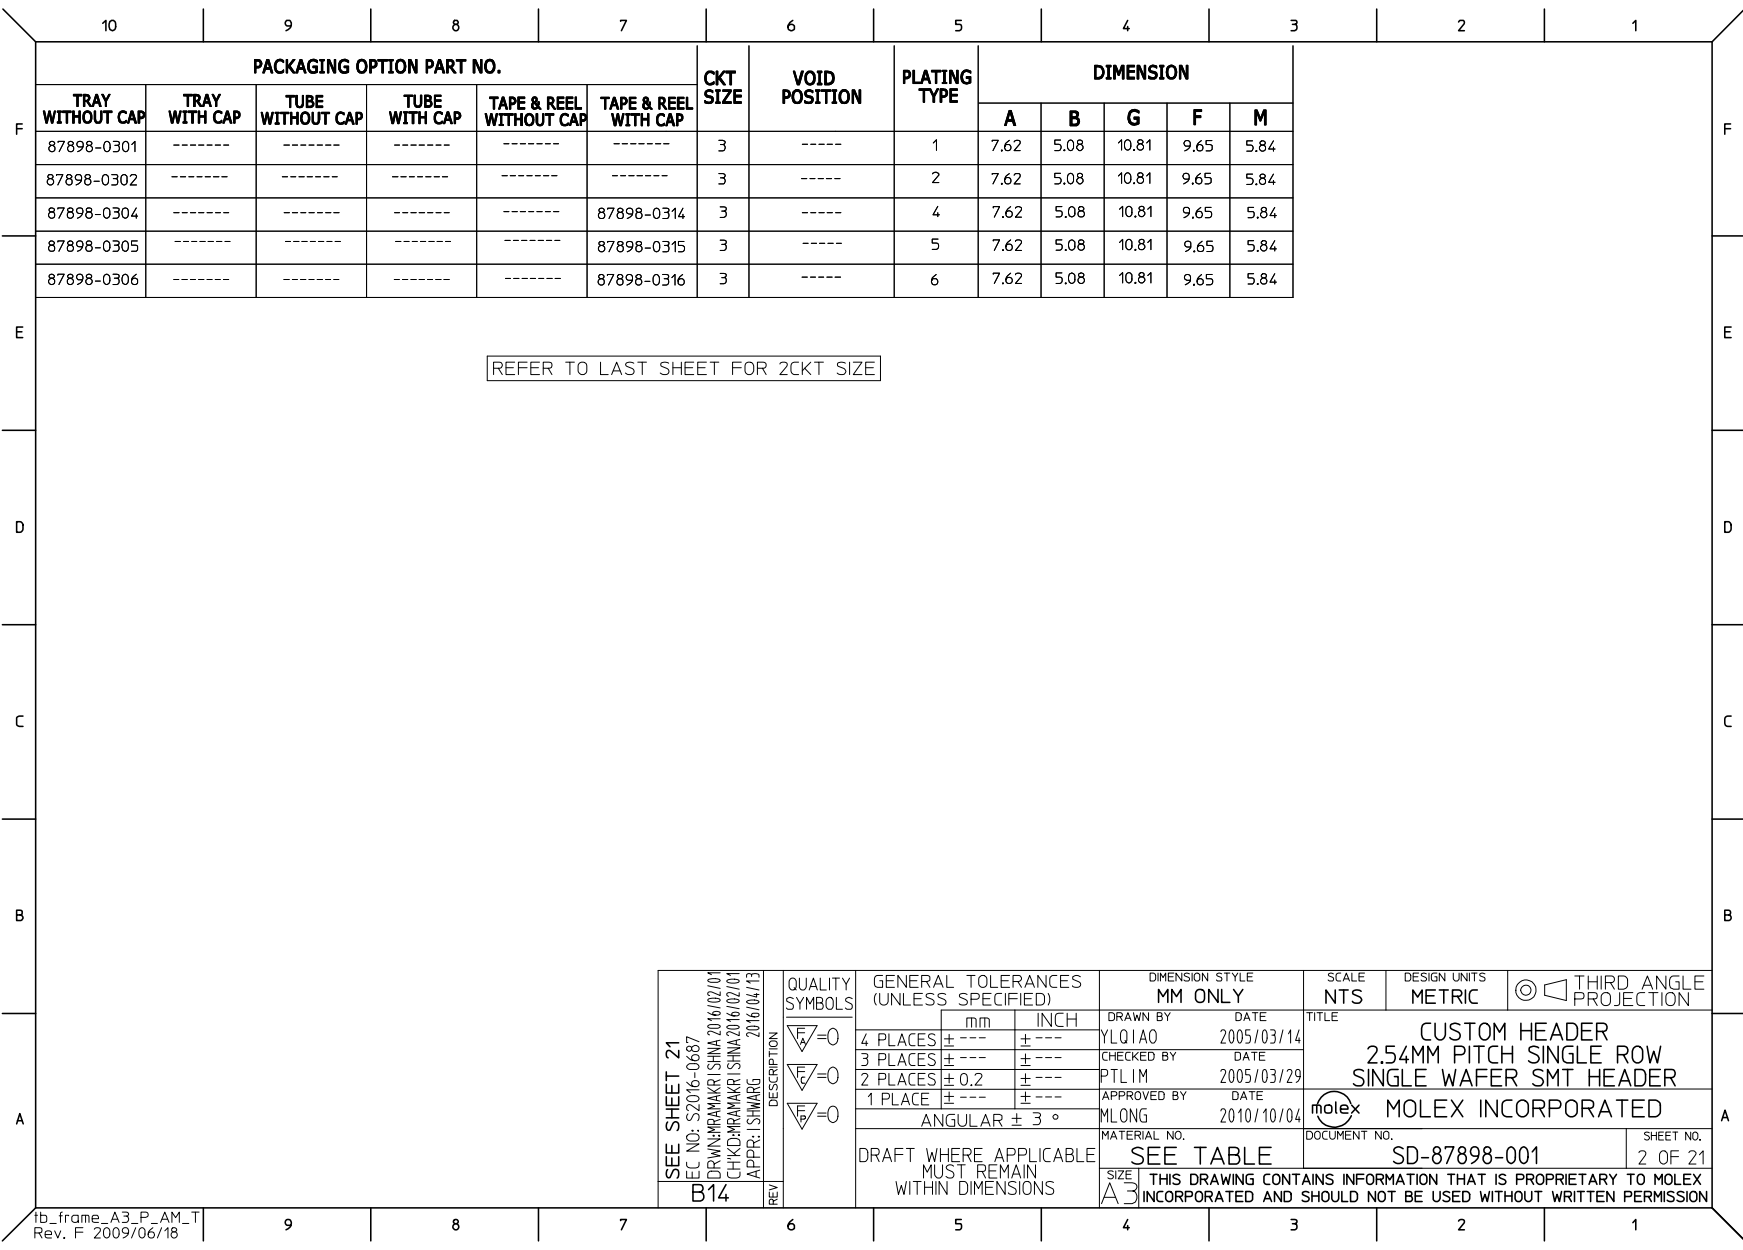
[picture p44: page 6]

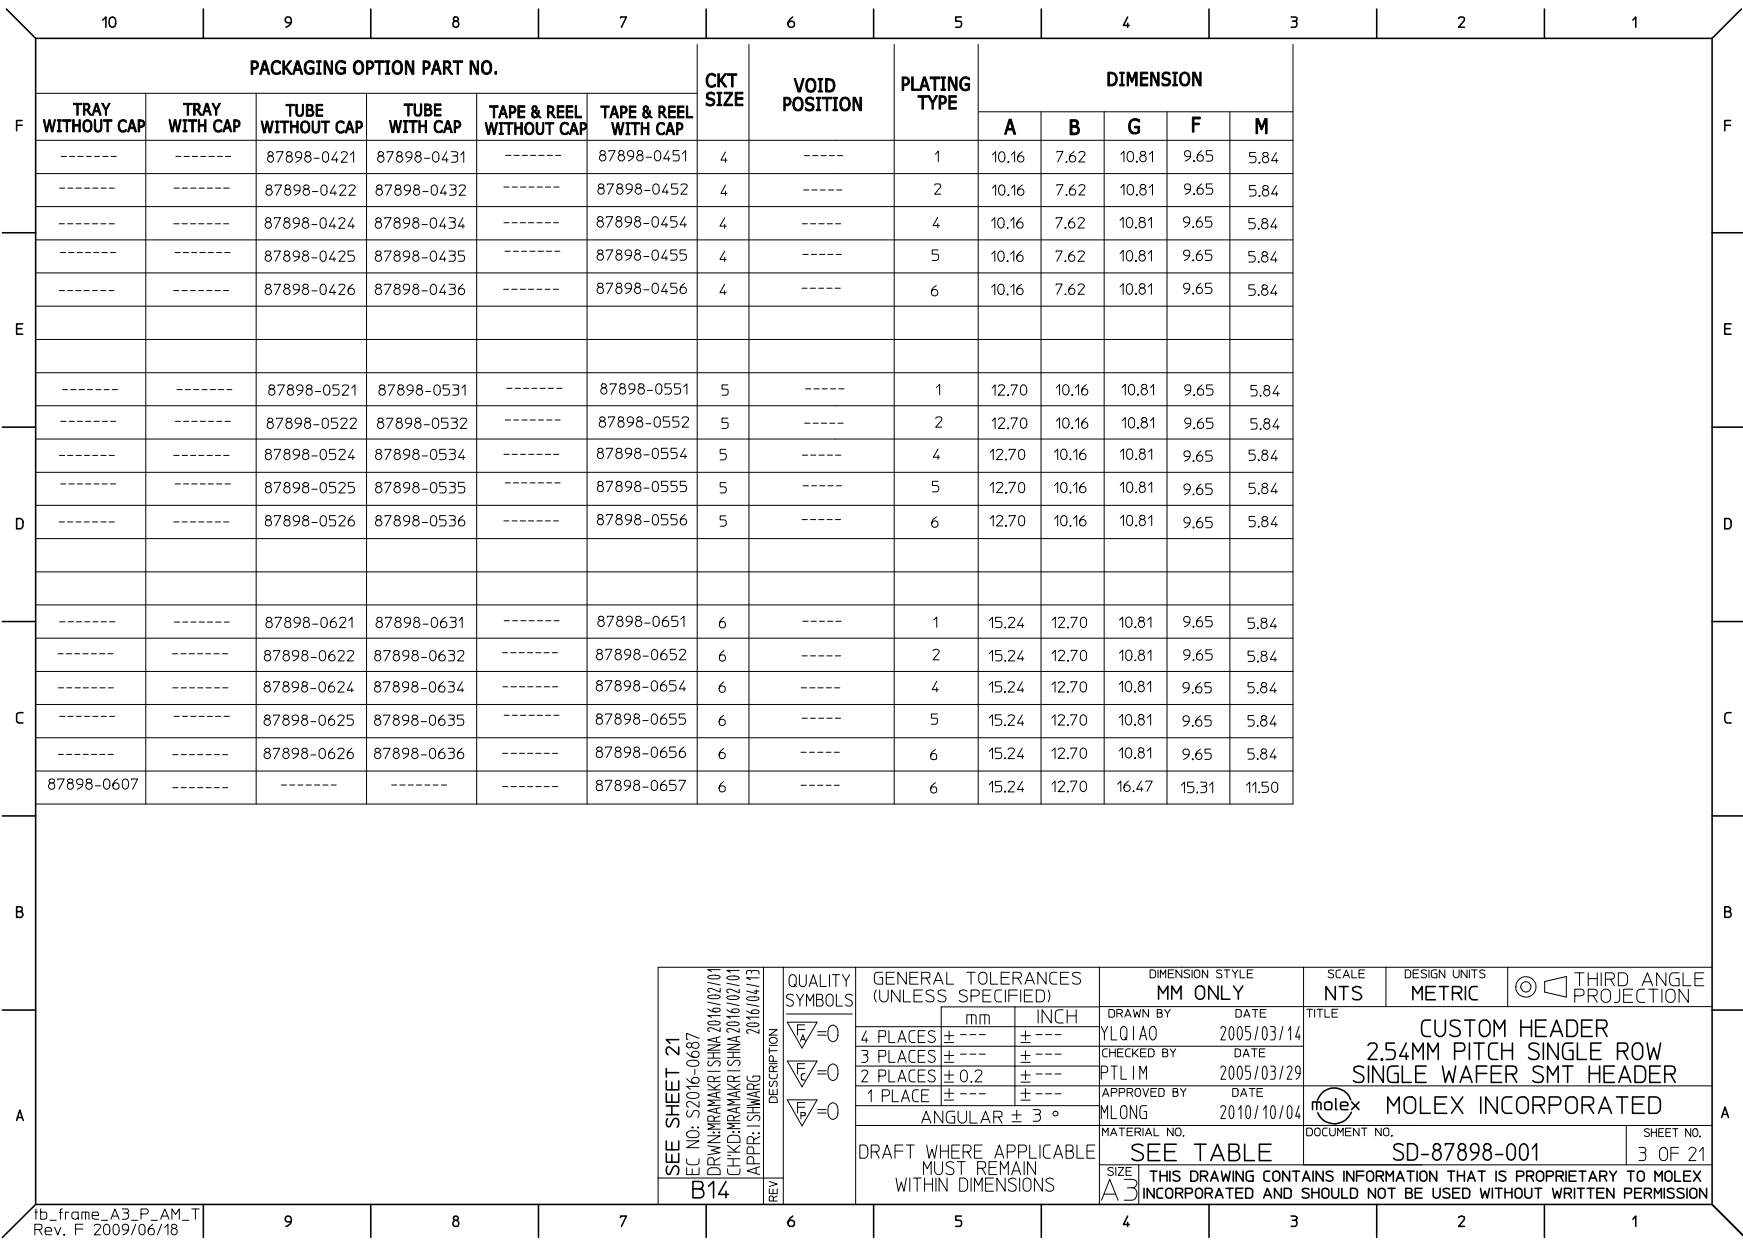
[picture p45: page 7]

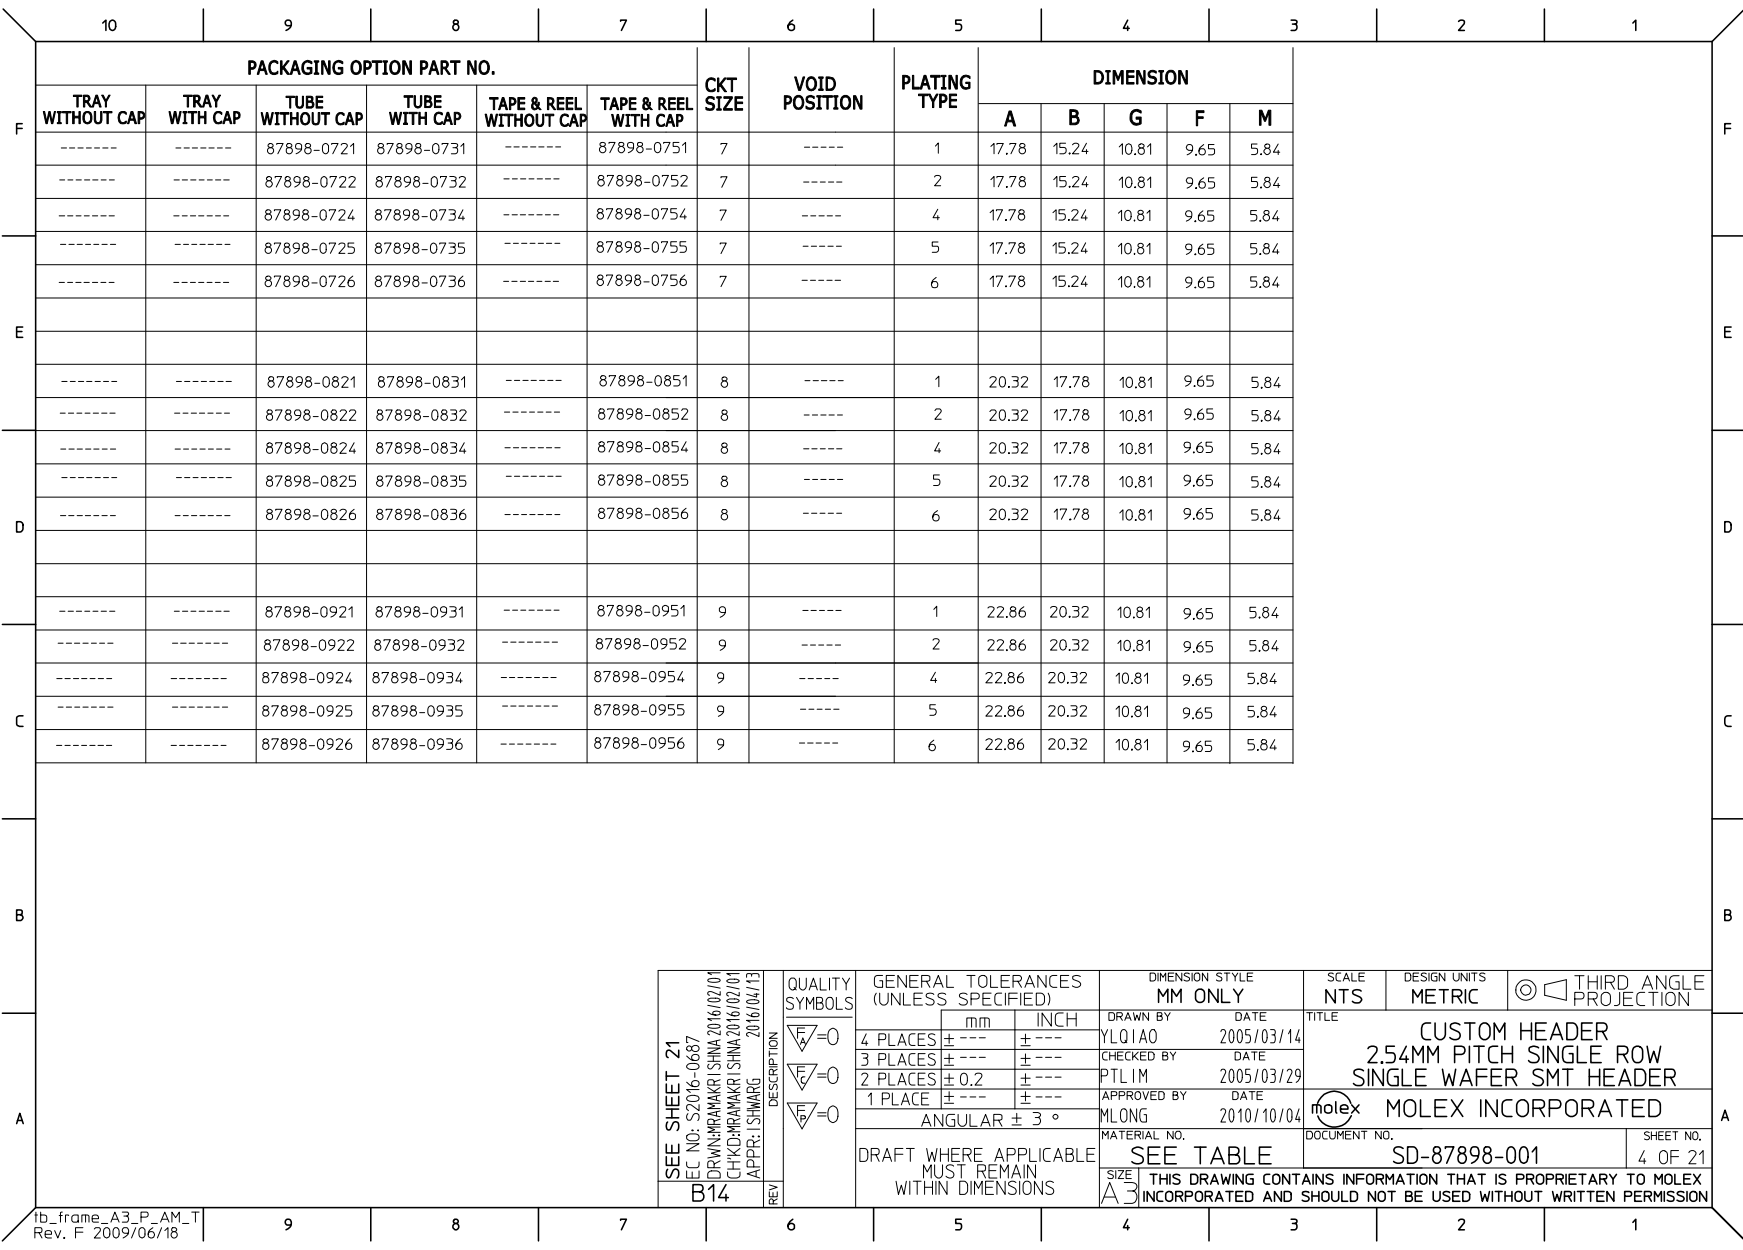
[picture p46: page 8]

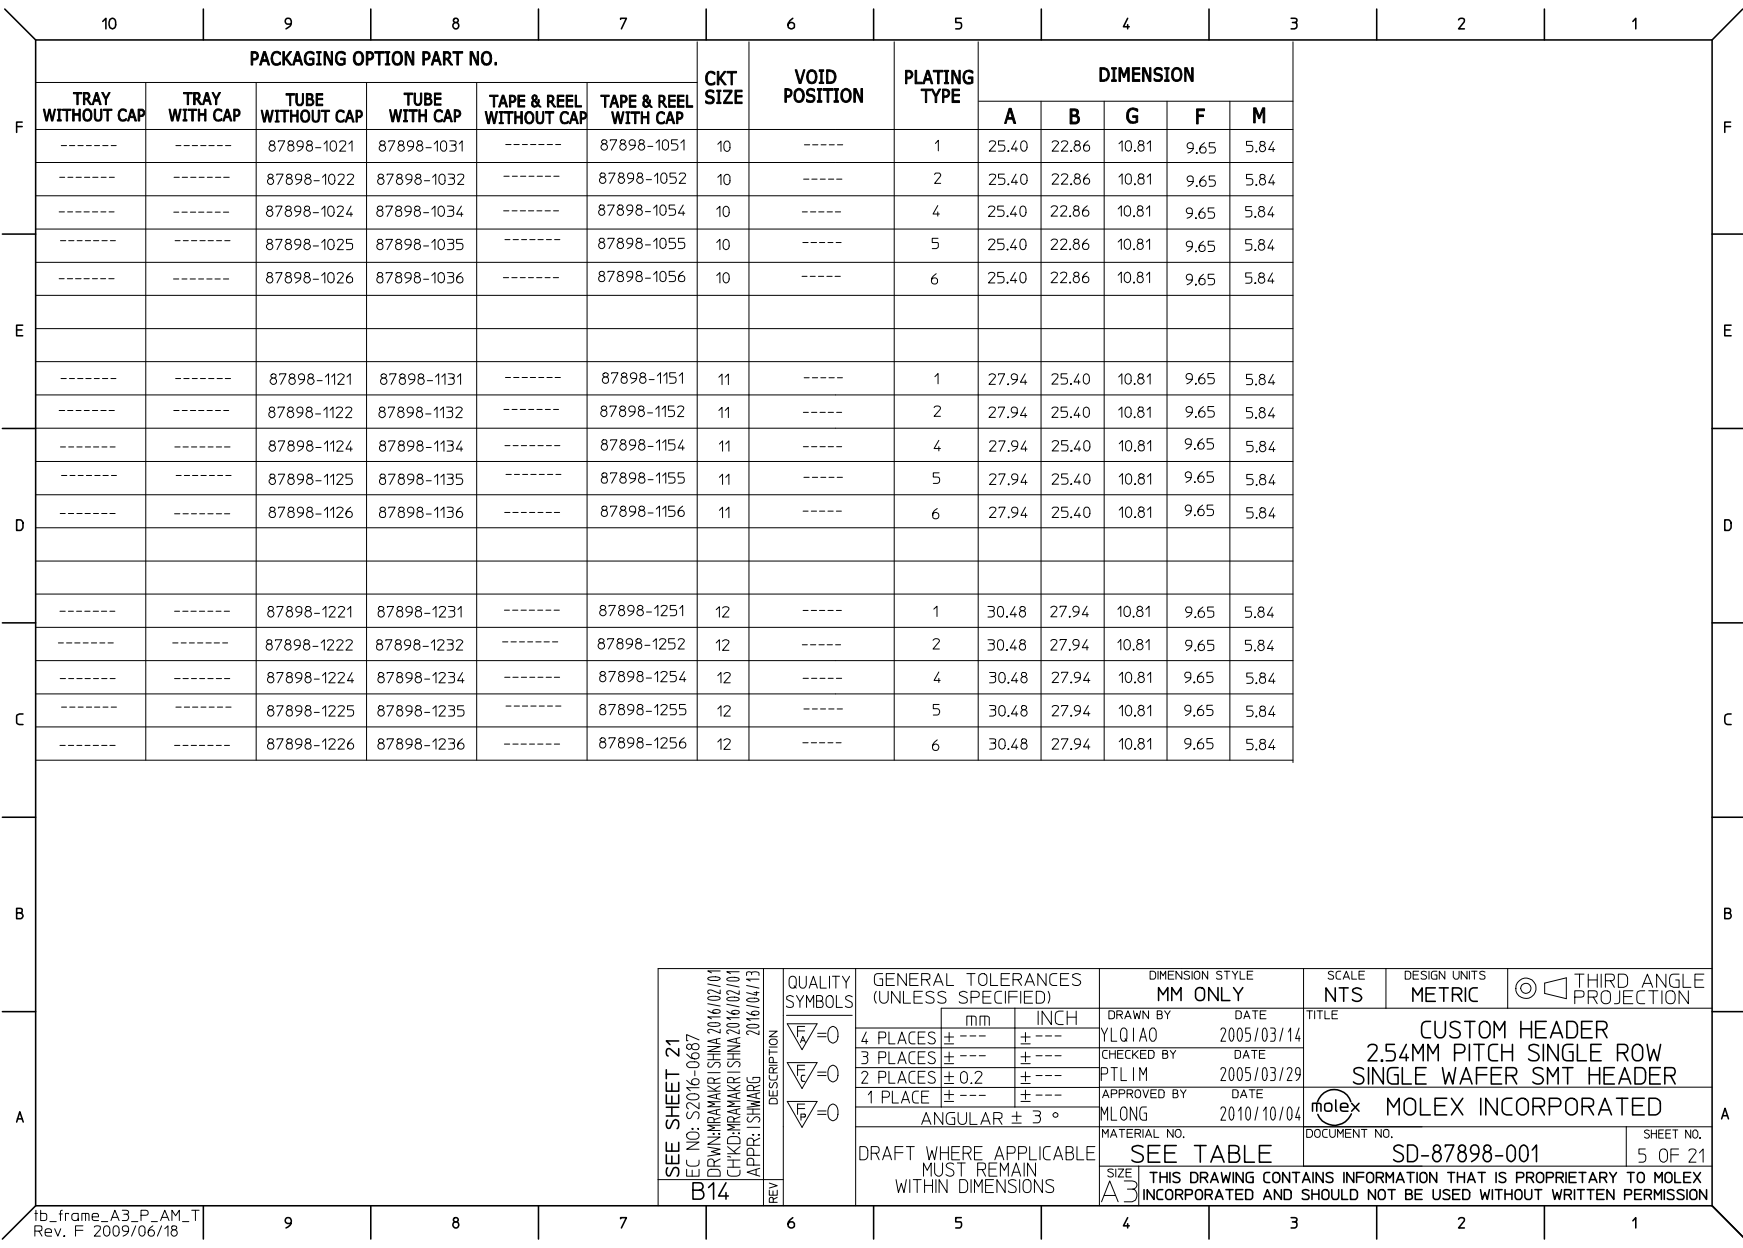
[picture p47: page 9]

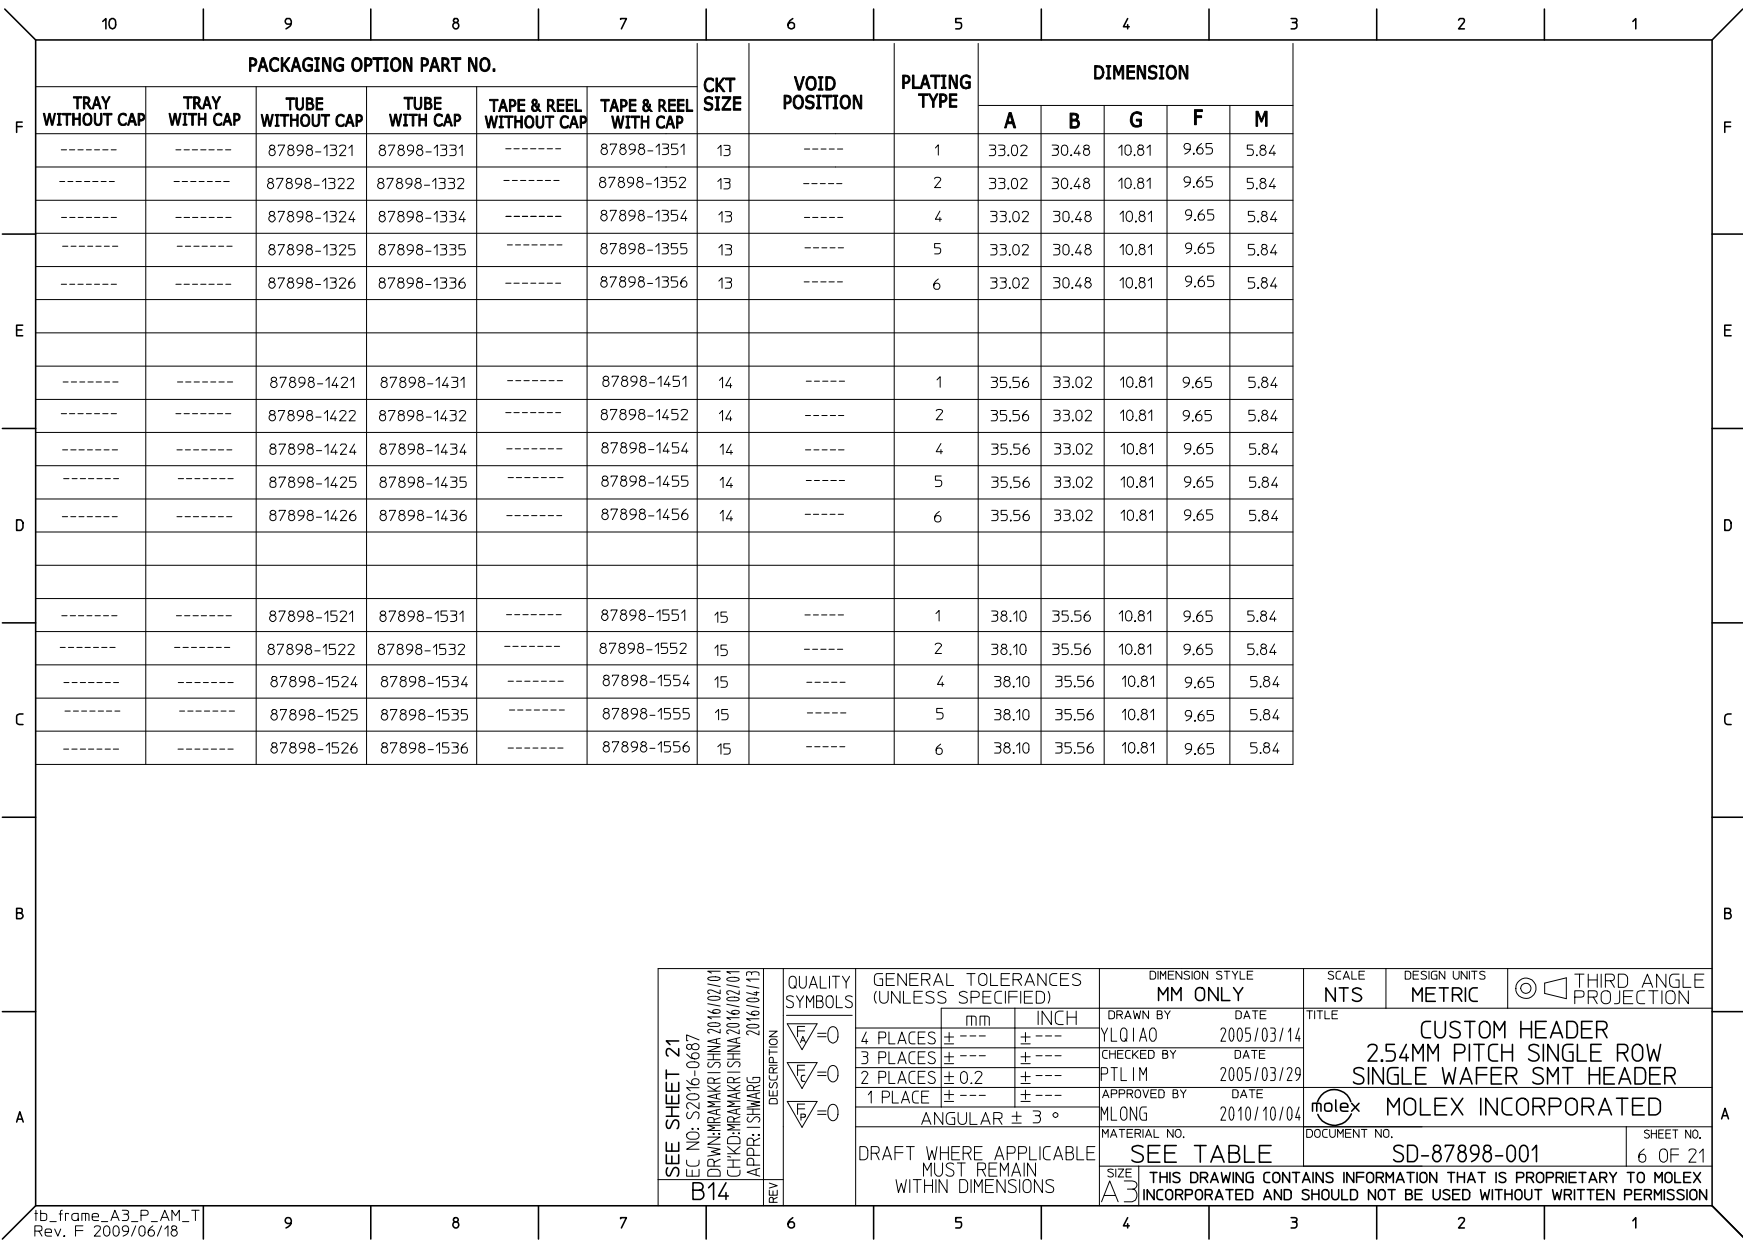
[picture p48: page 10]

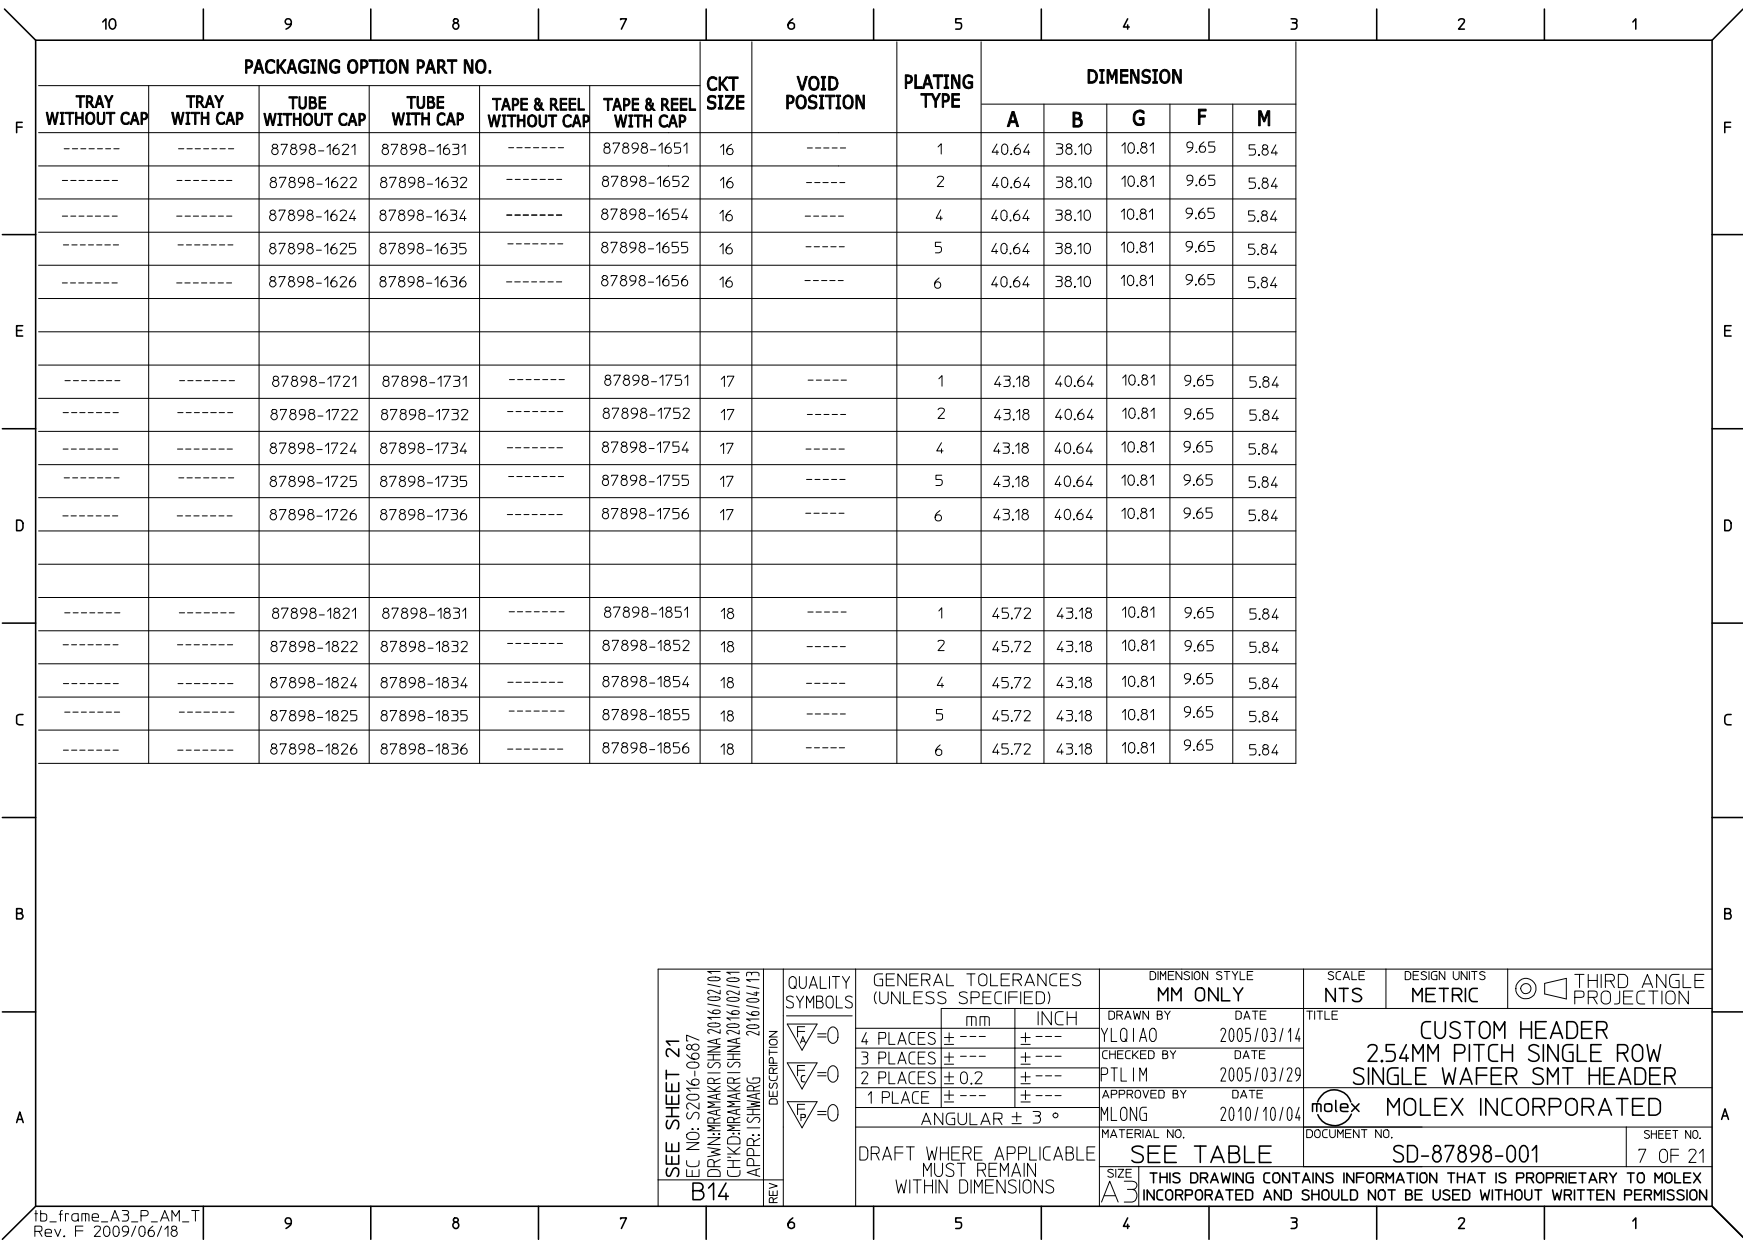
[picture p49: page 11]

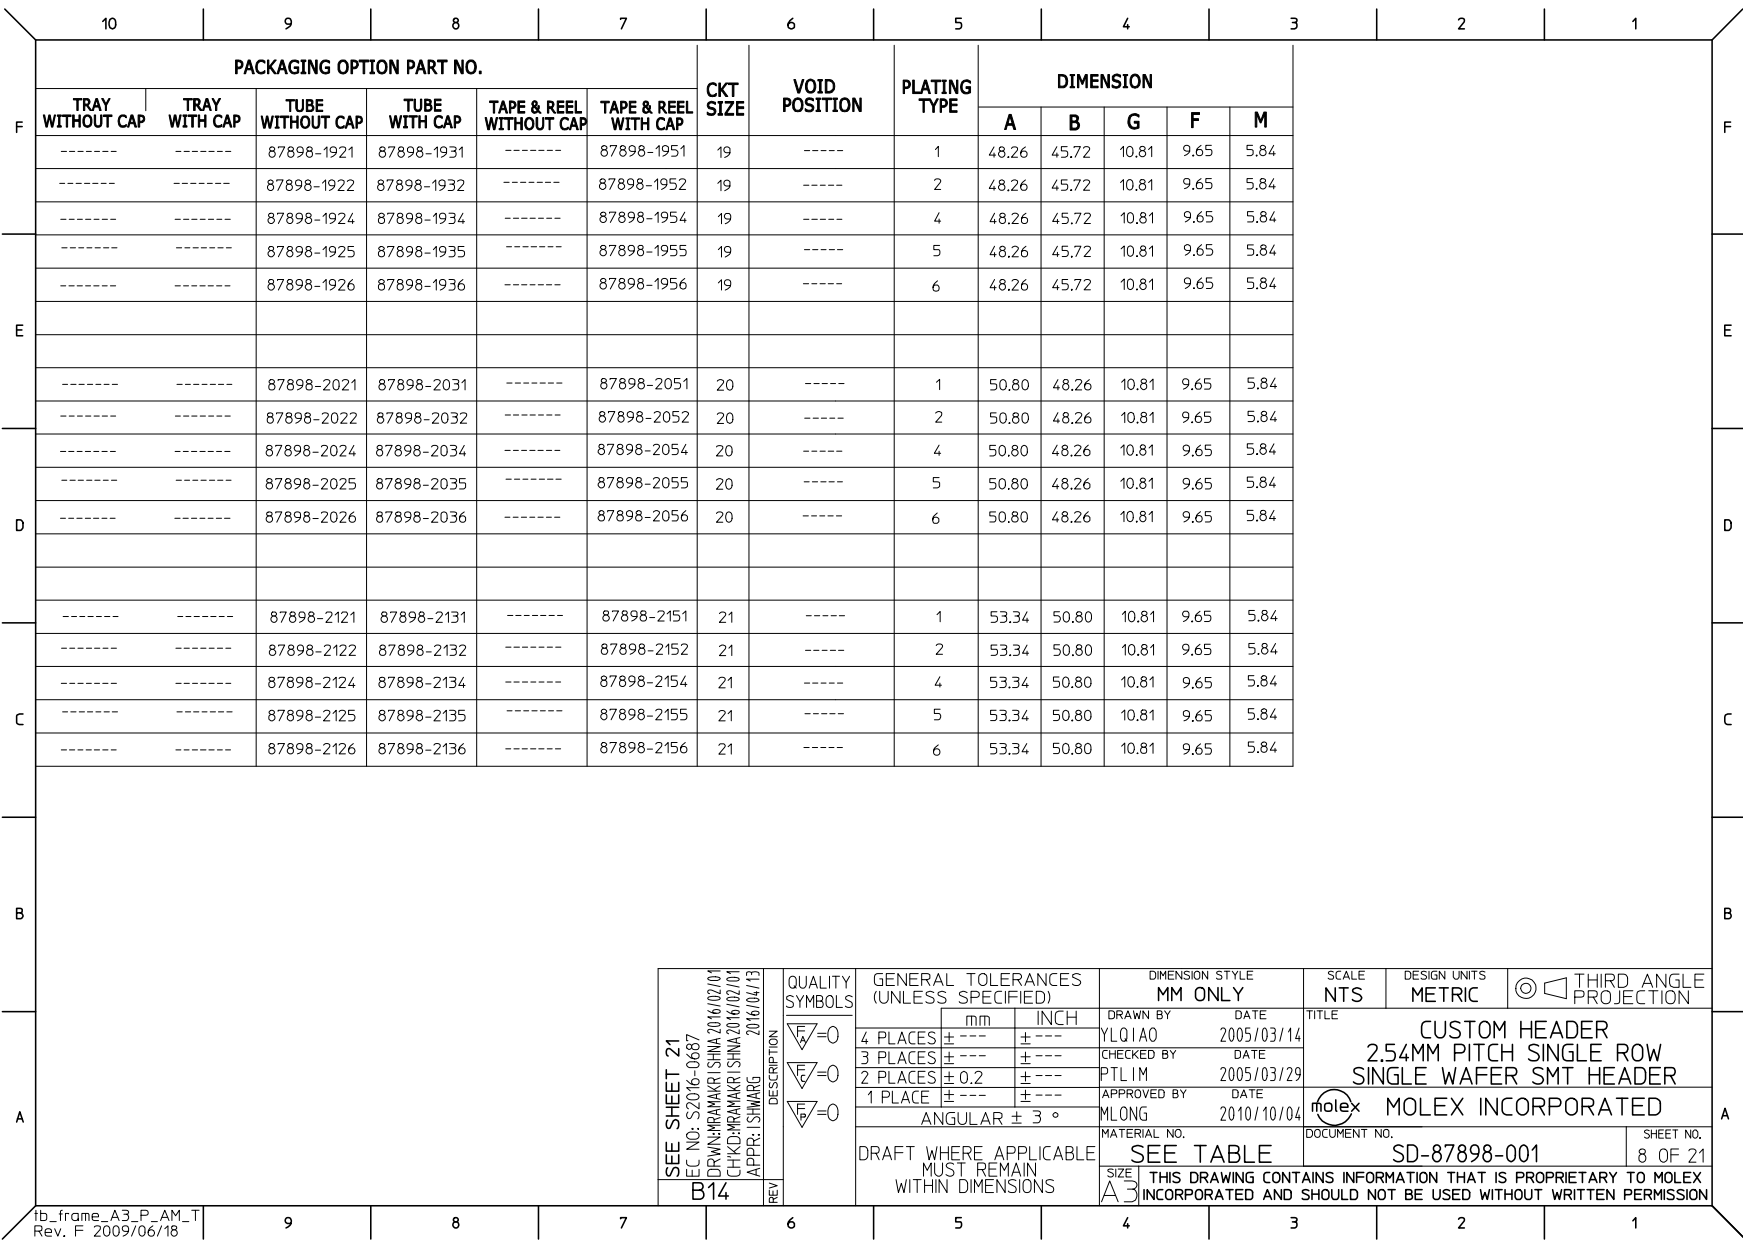
[picture p50: page 12]

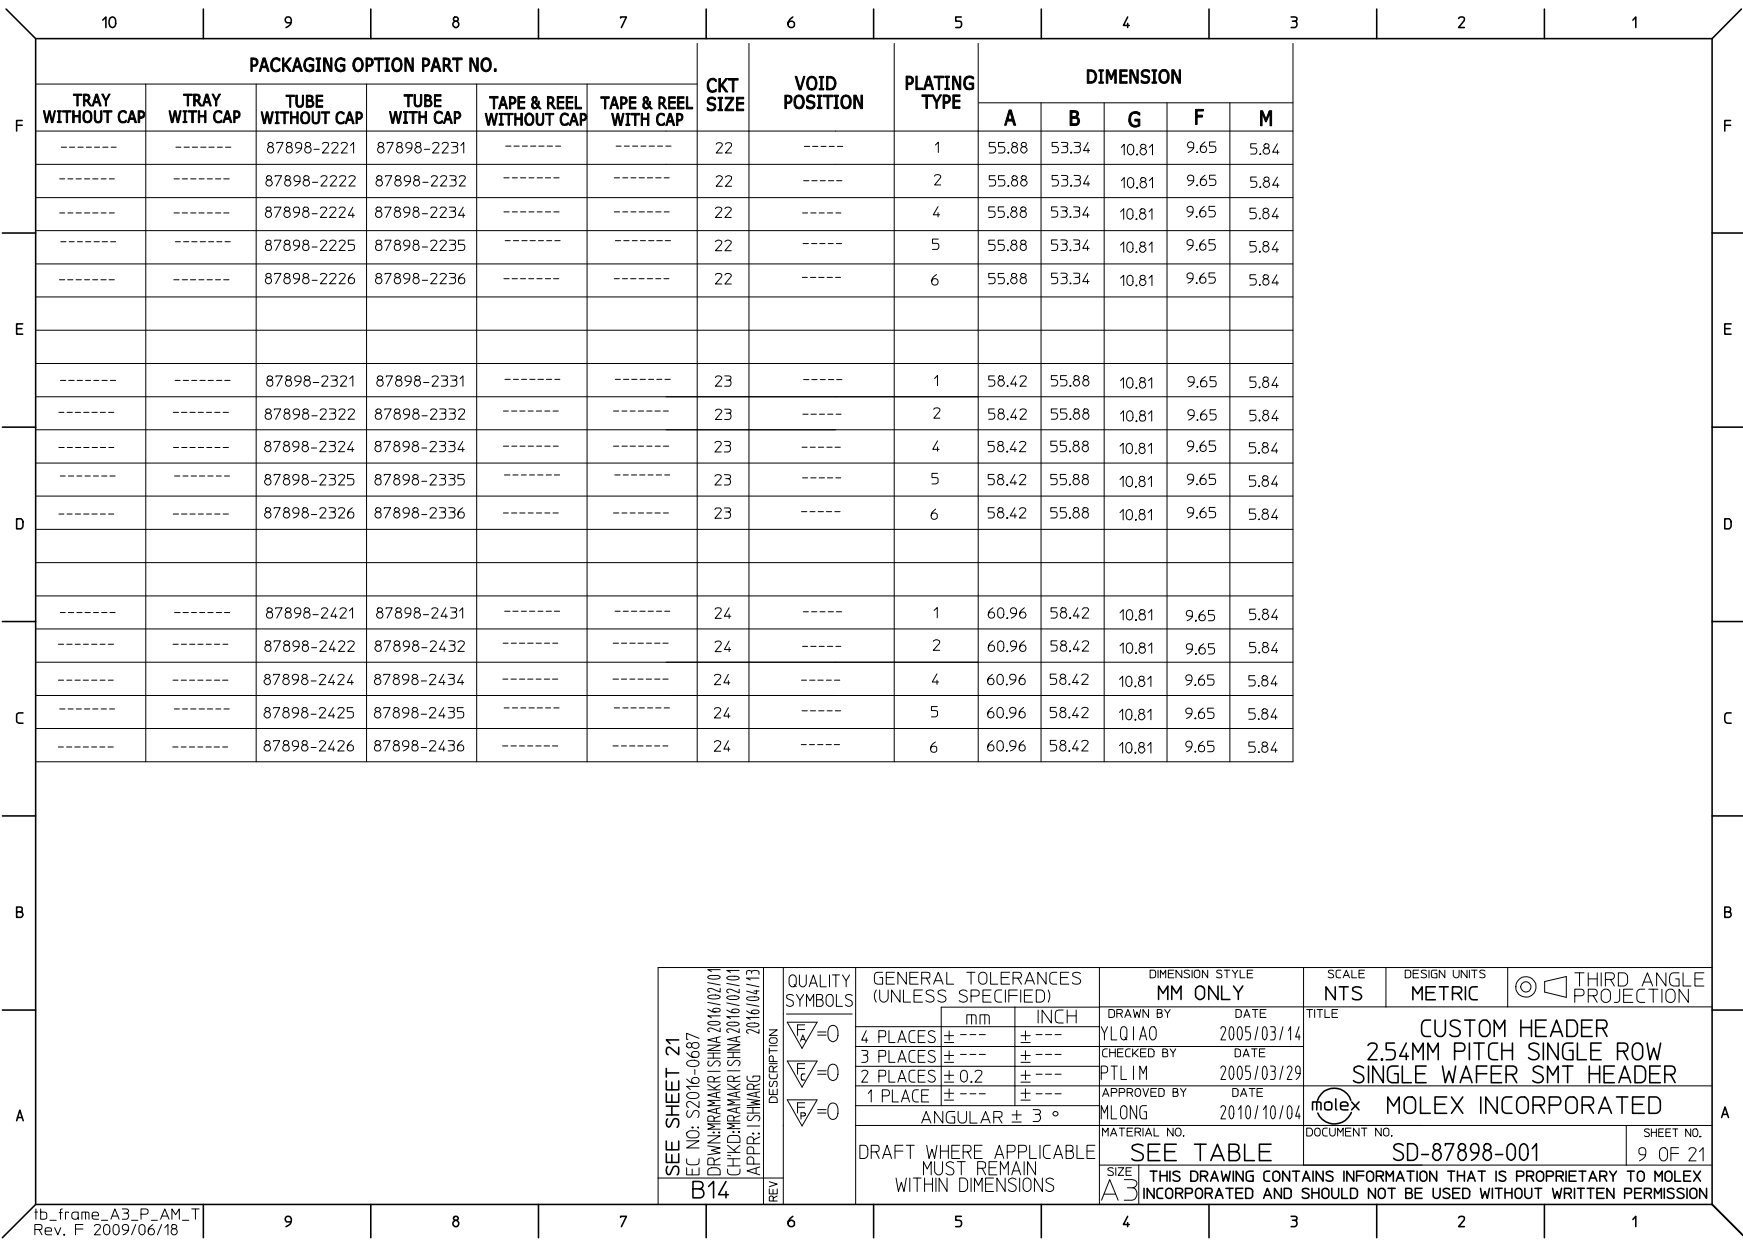
[picture p51: page 13]

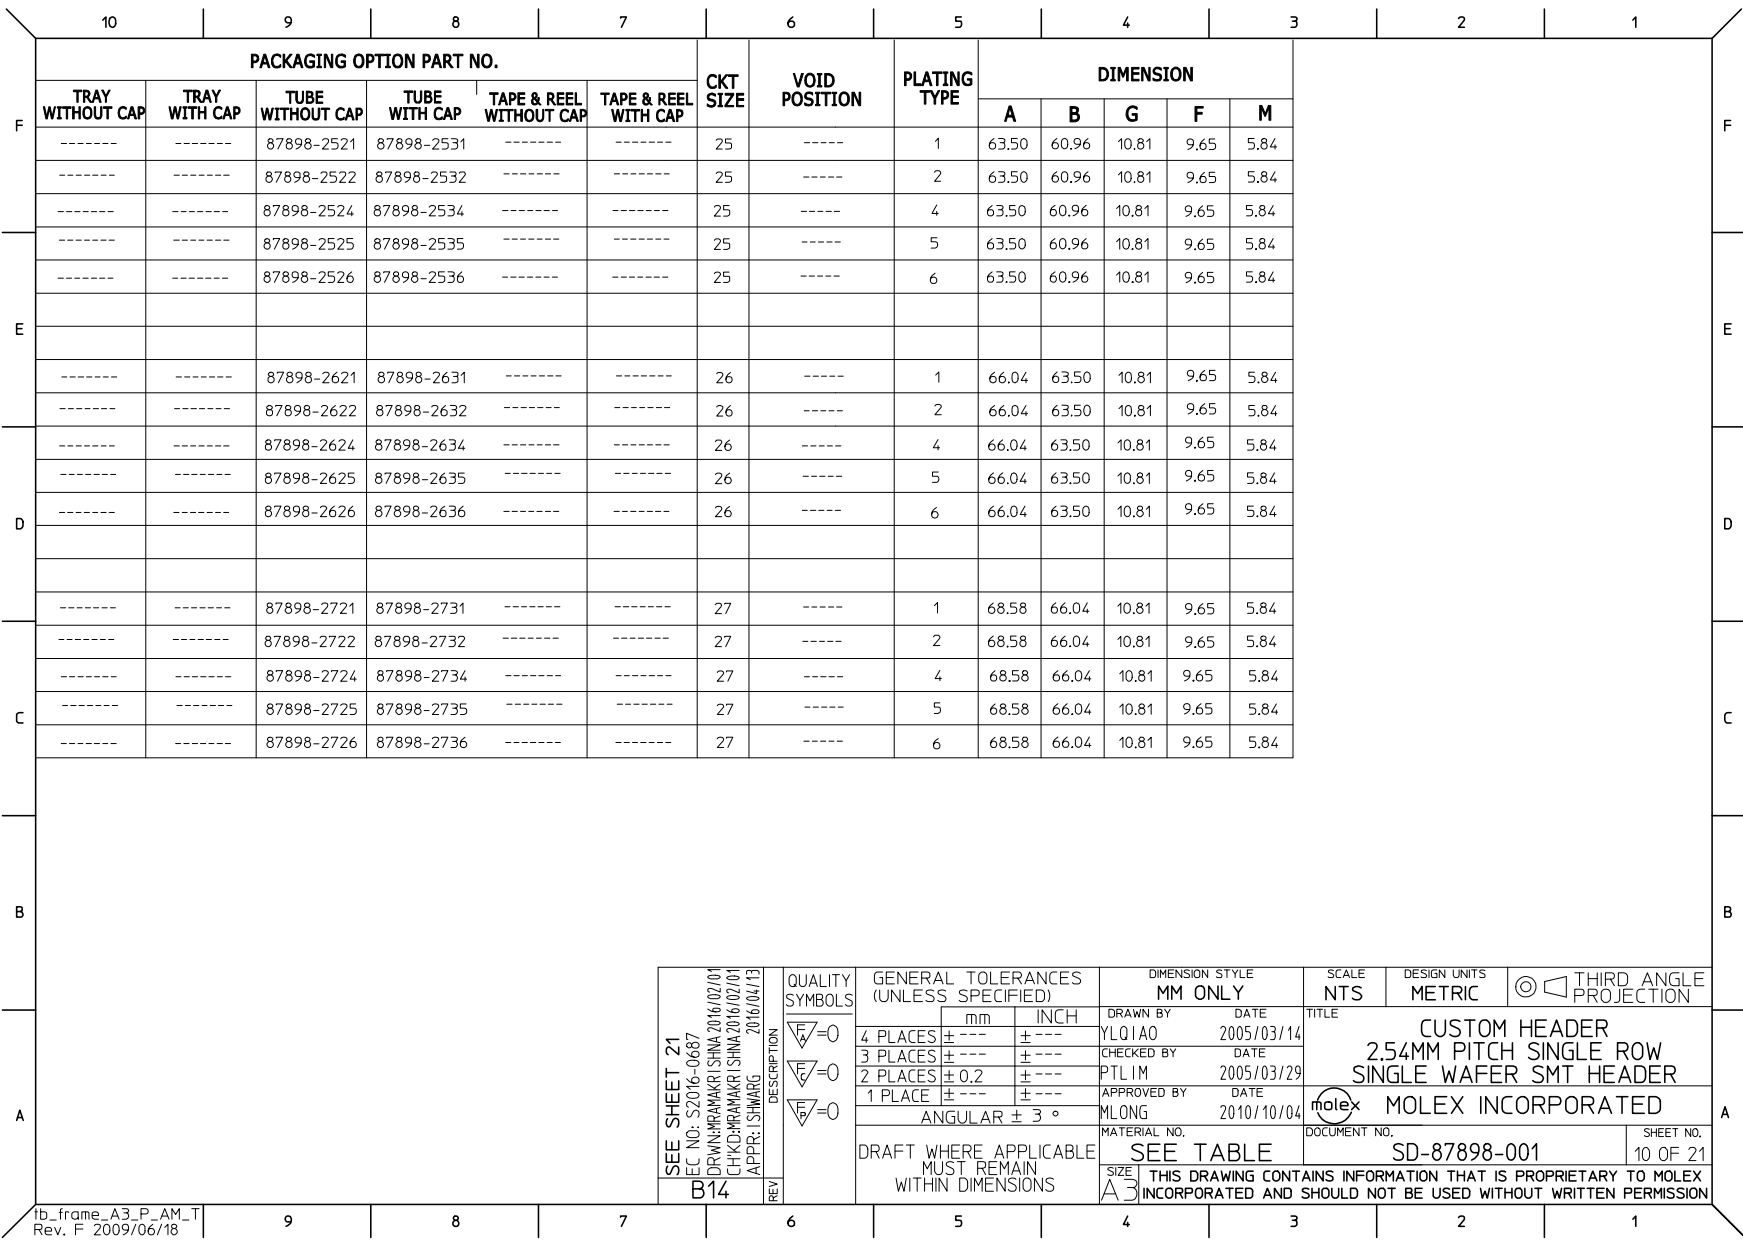
[picture p52: page 14]

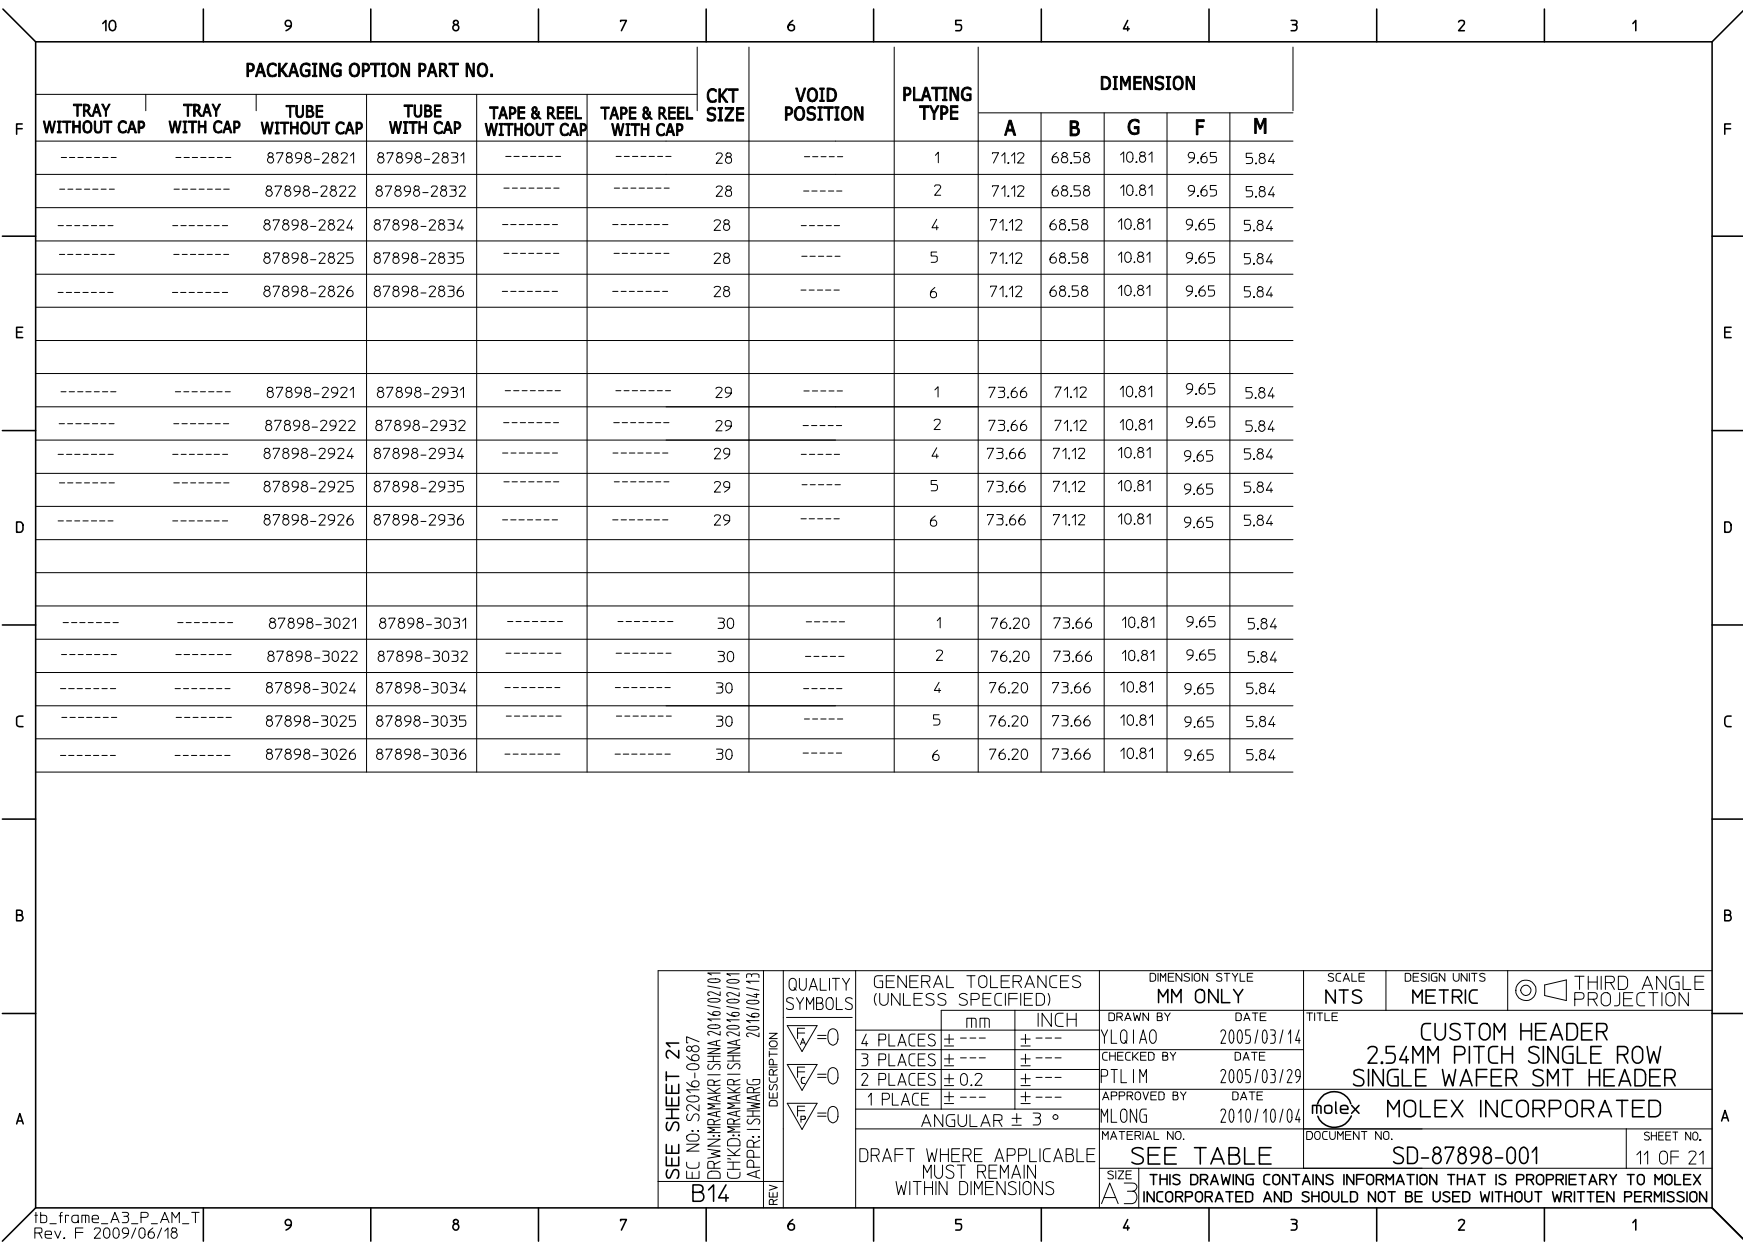
[picture p53: page 15]

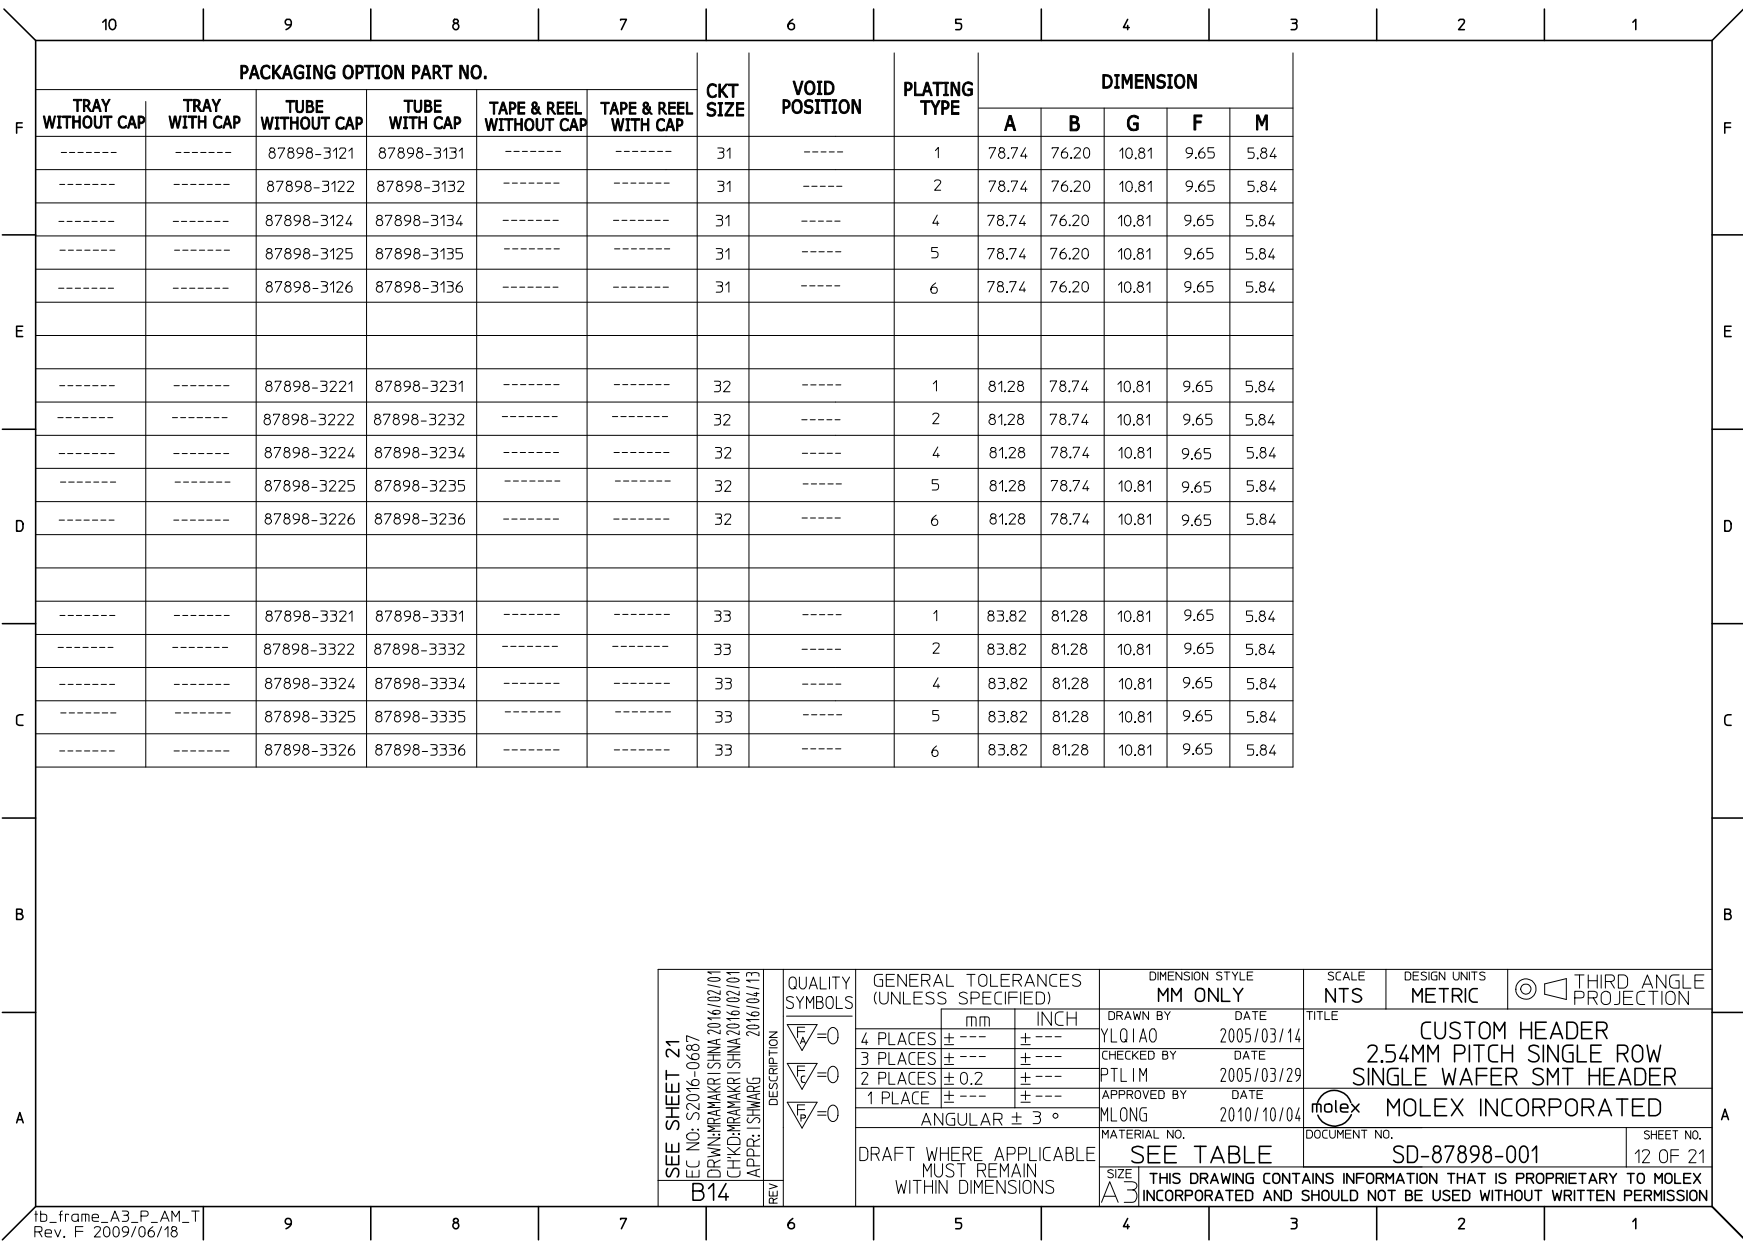
[picture p54: page 16]

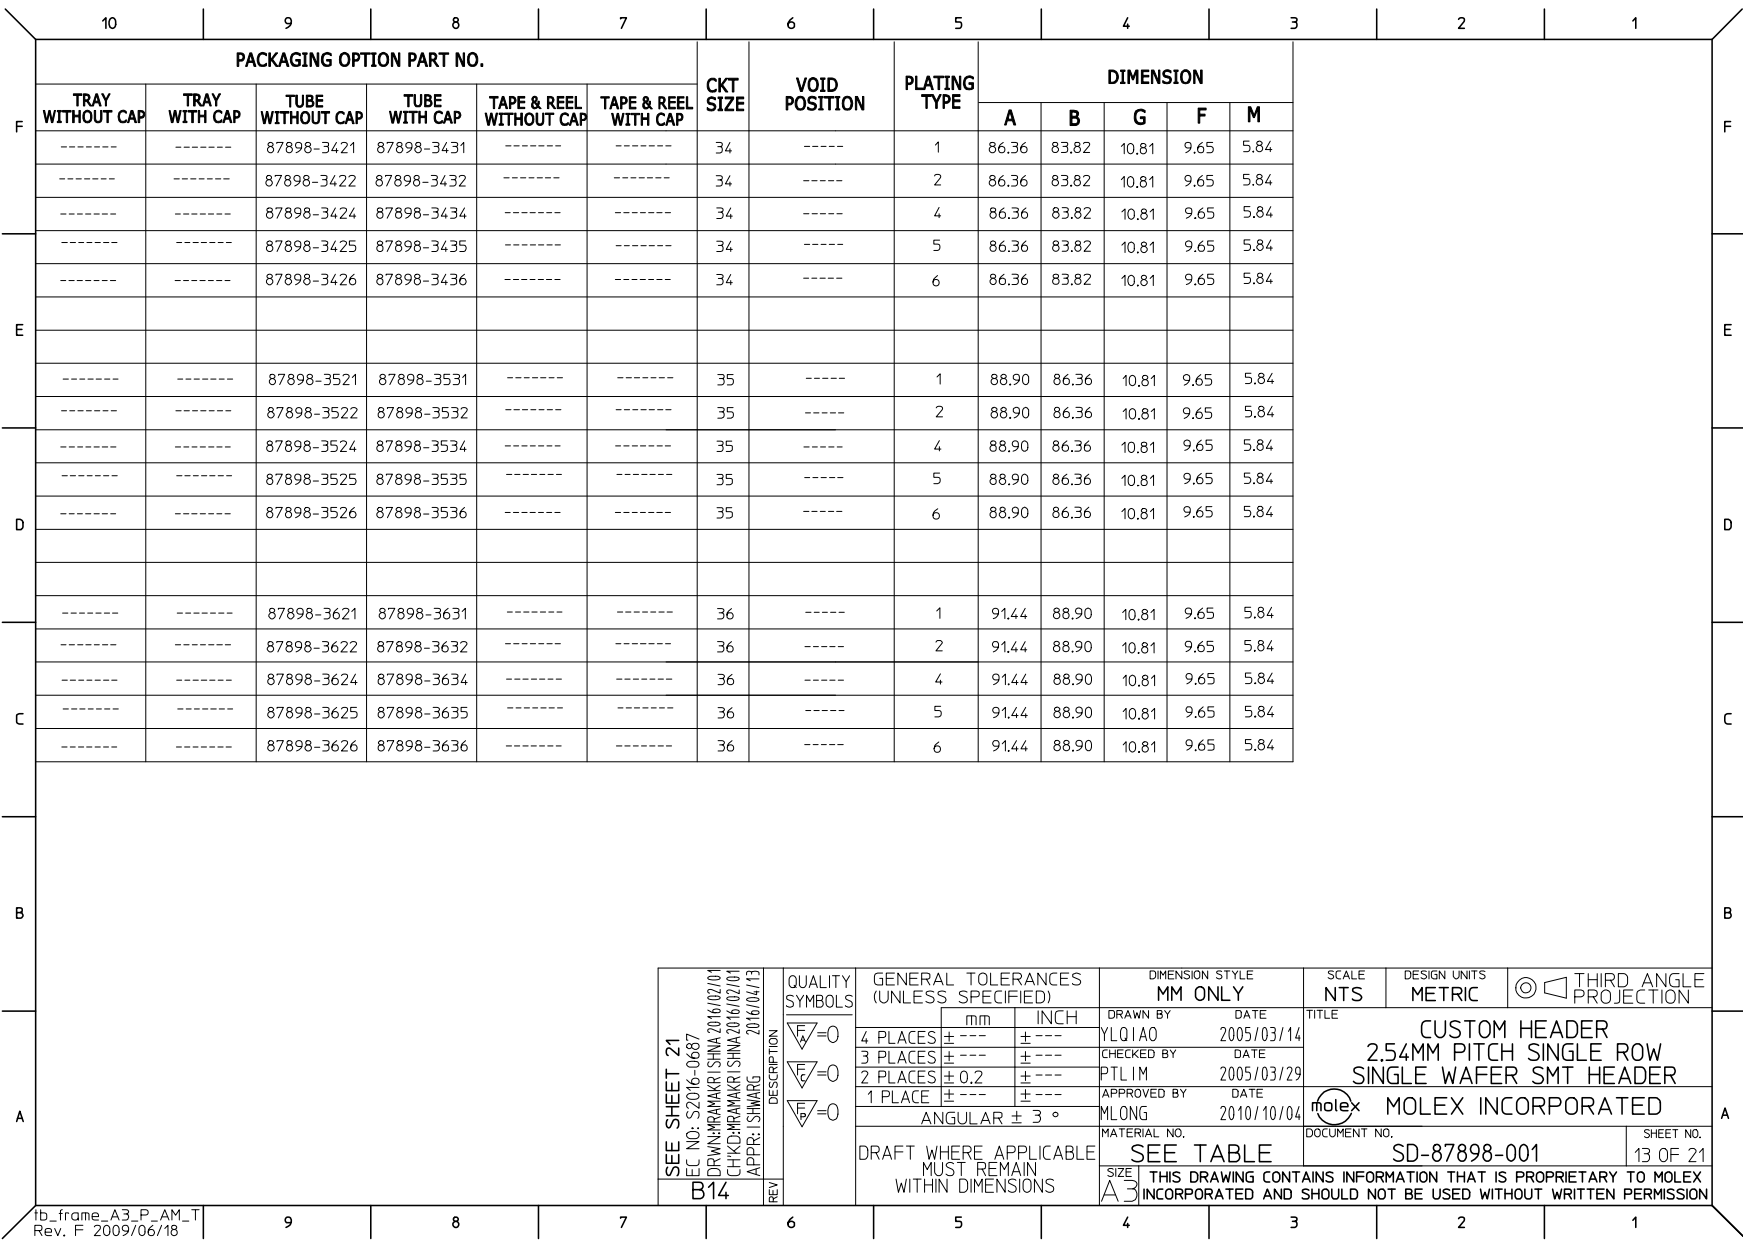
[picture p55: page 17]

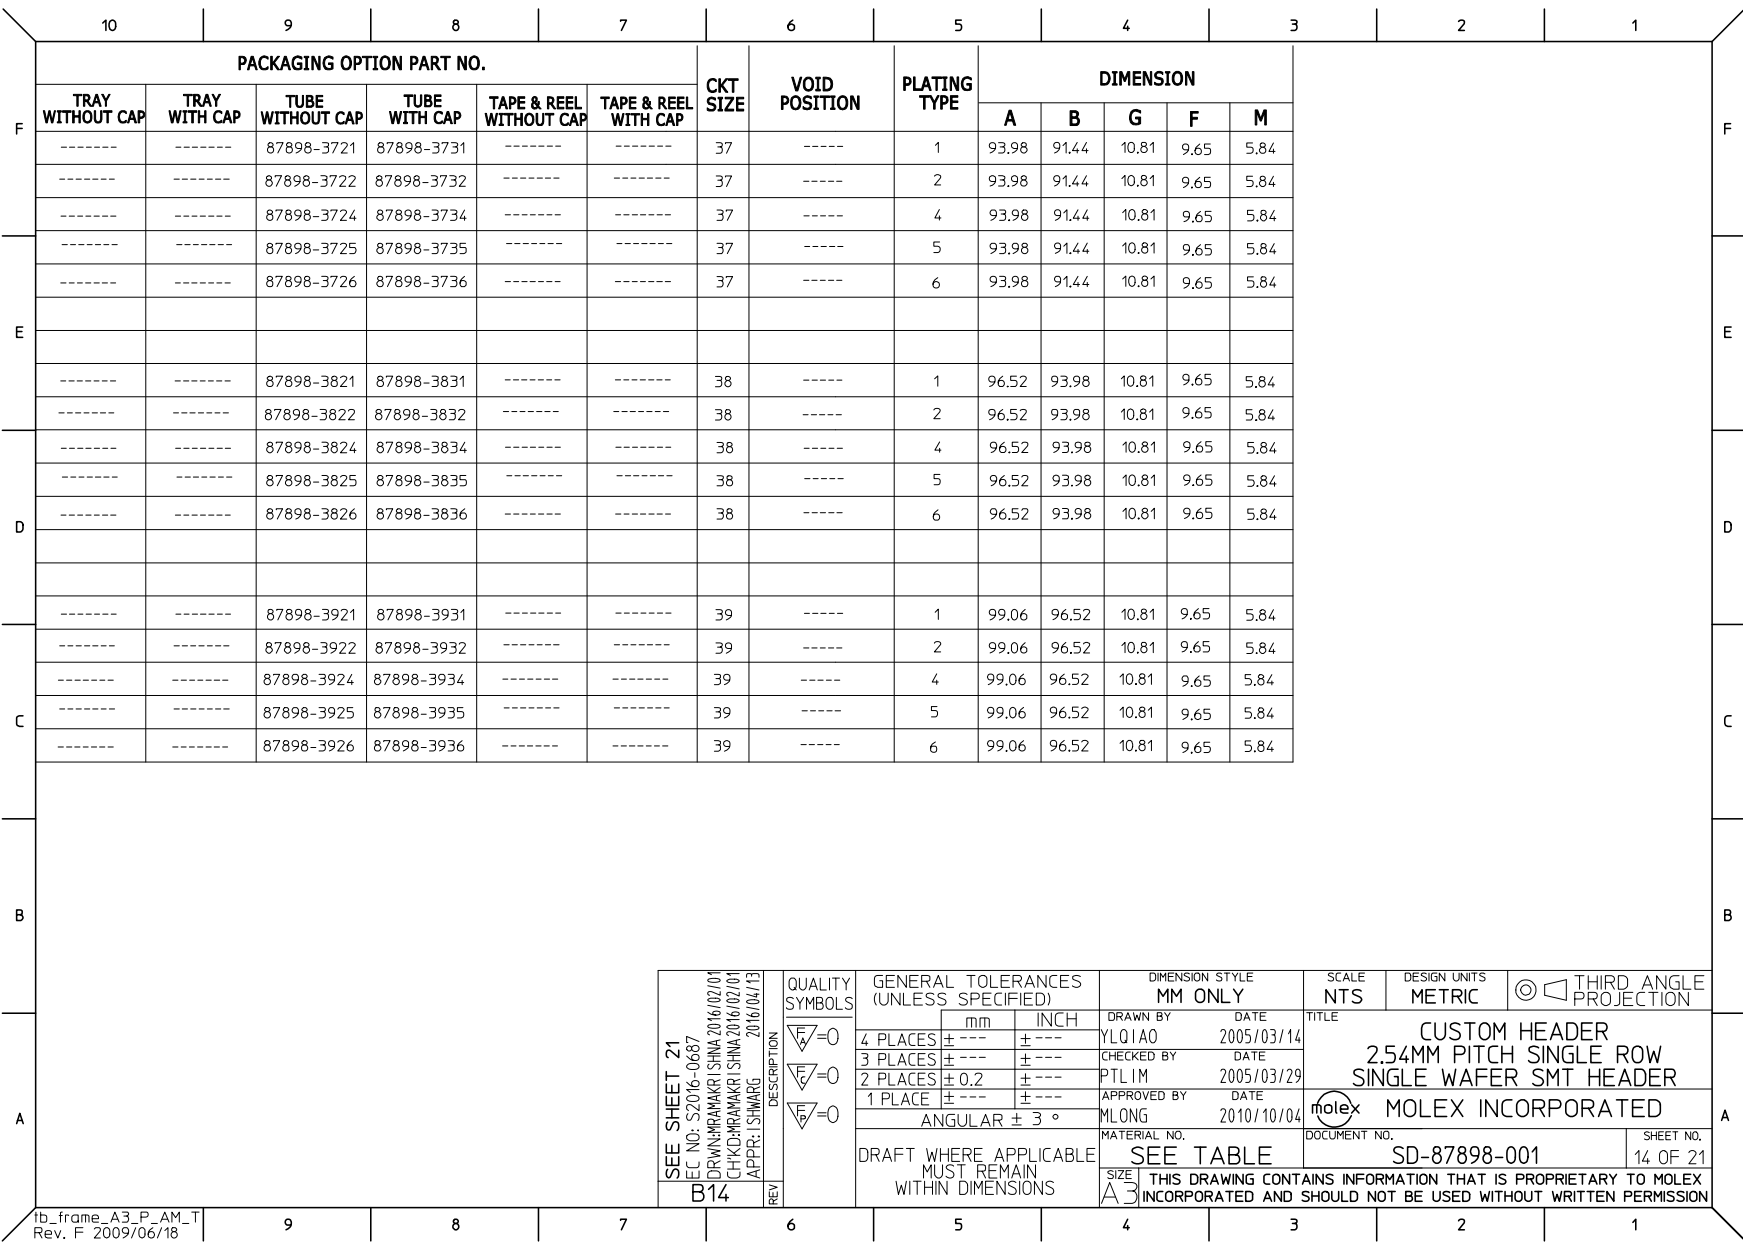
[picture p56: page 18]

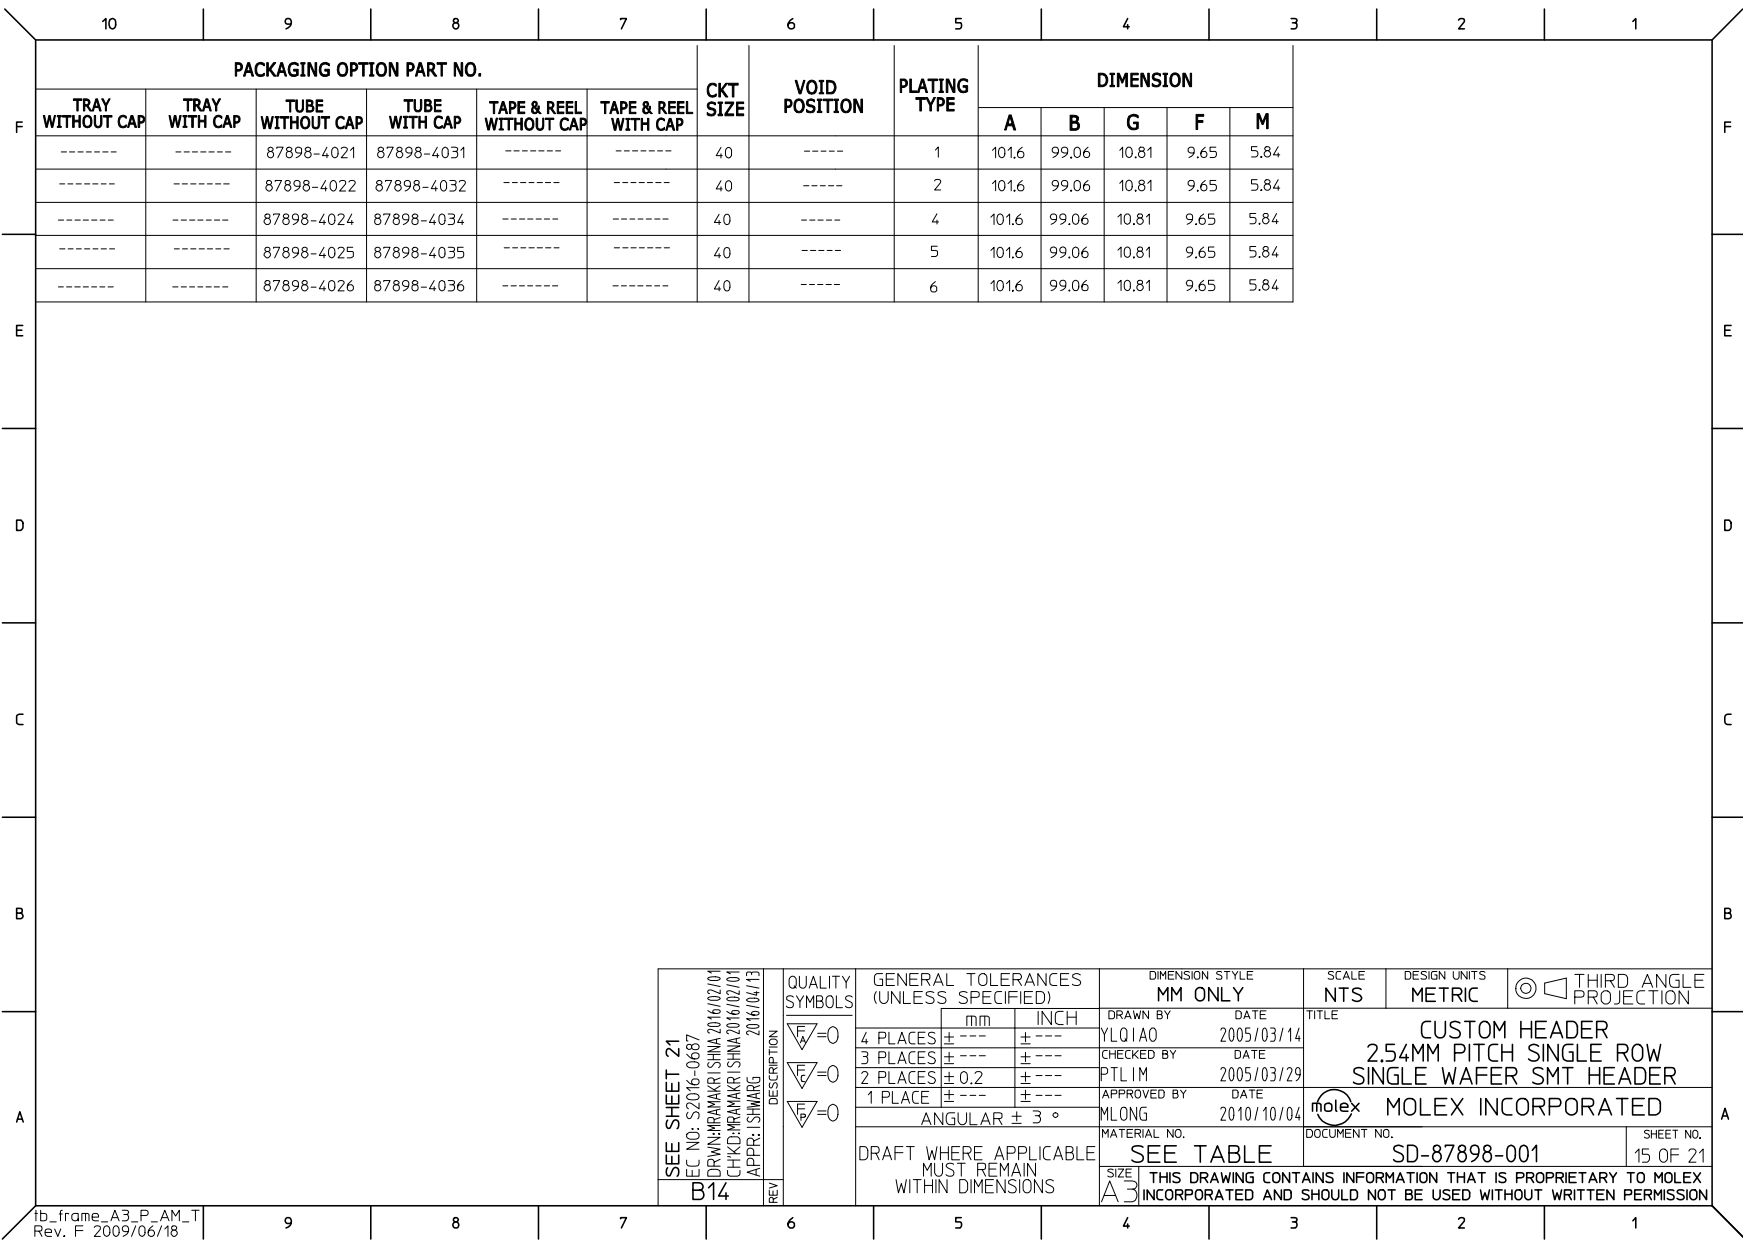
[picture p57: page 19]

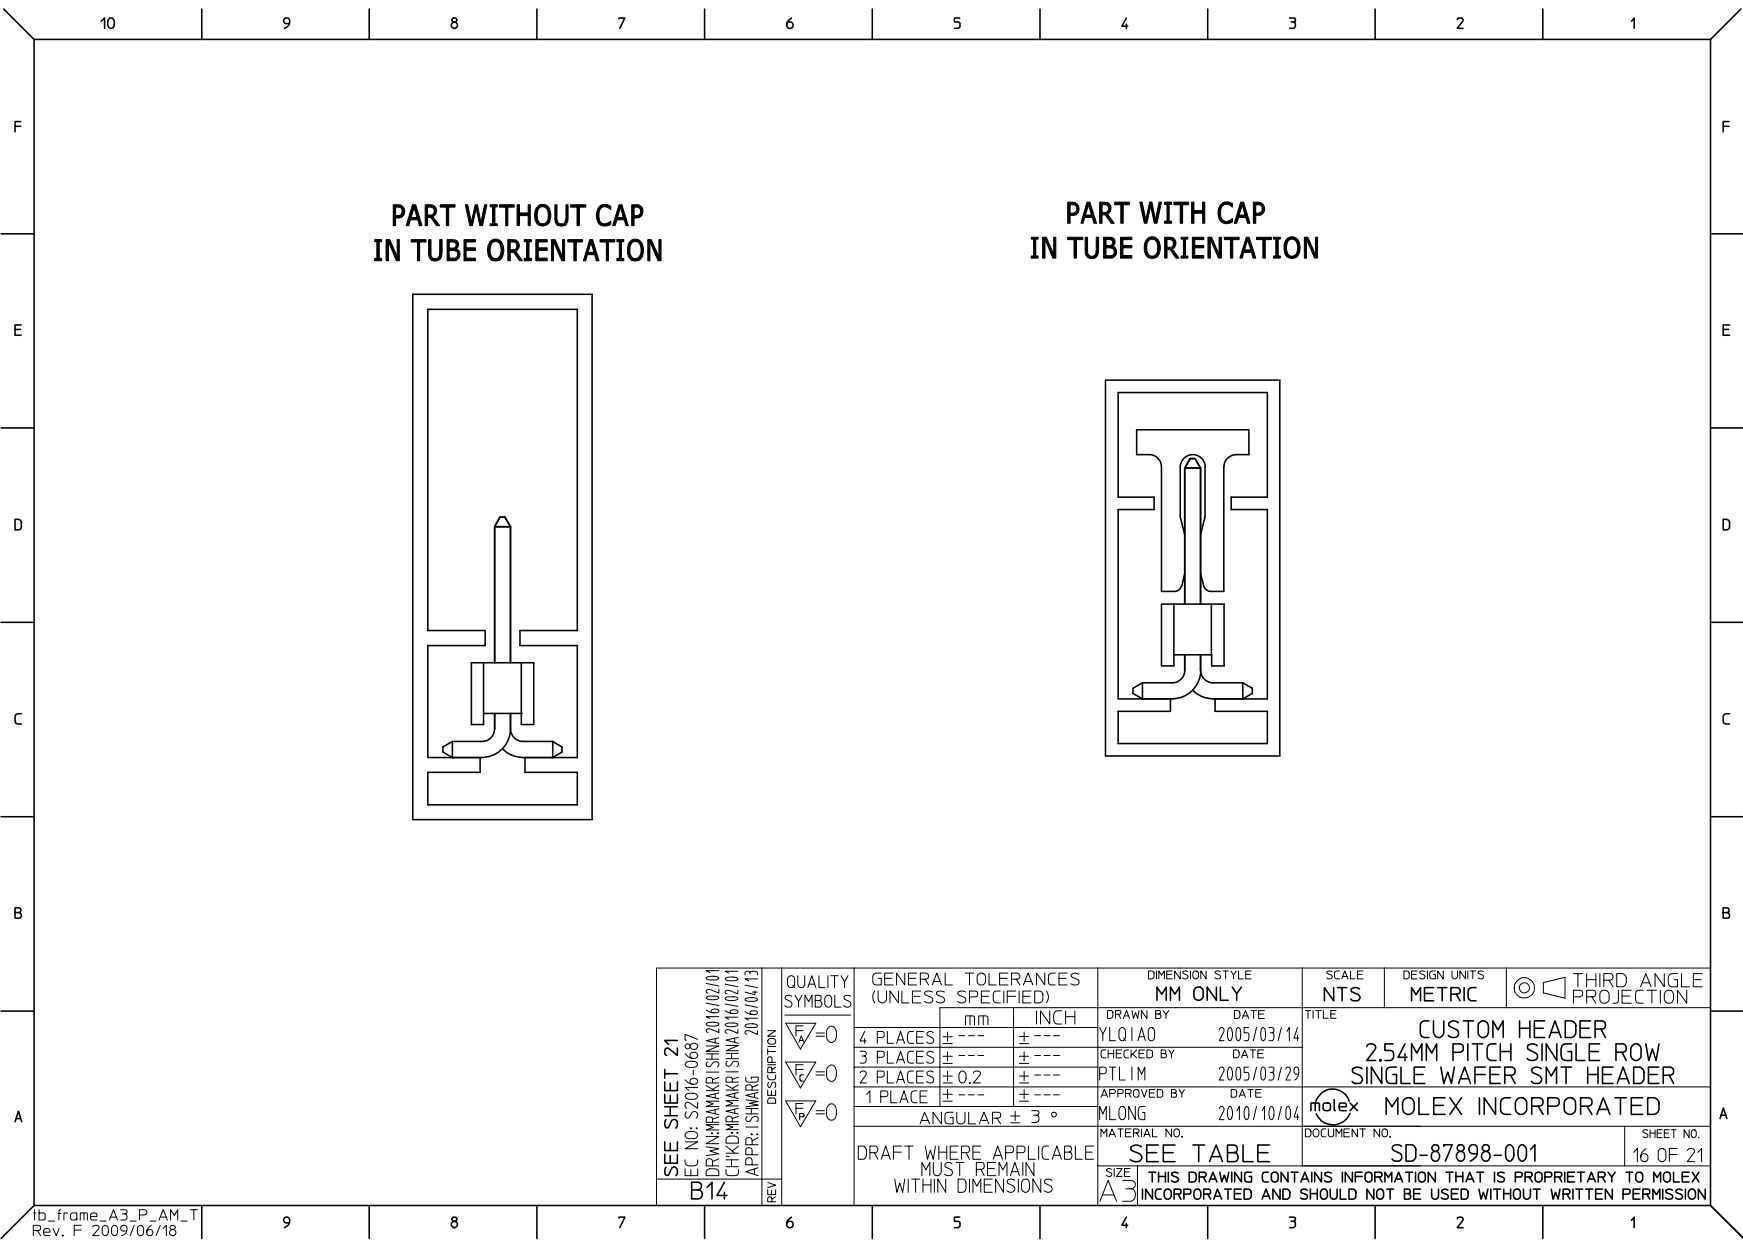
[picture p58: page 20]

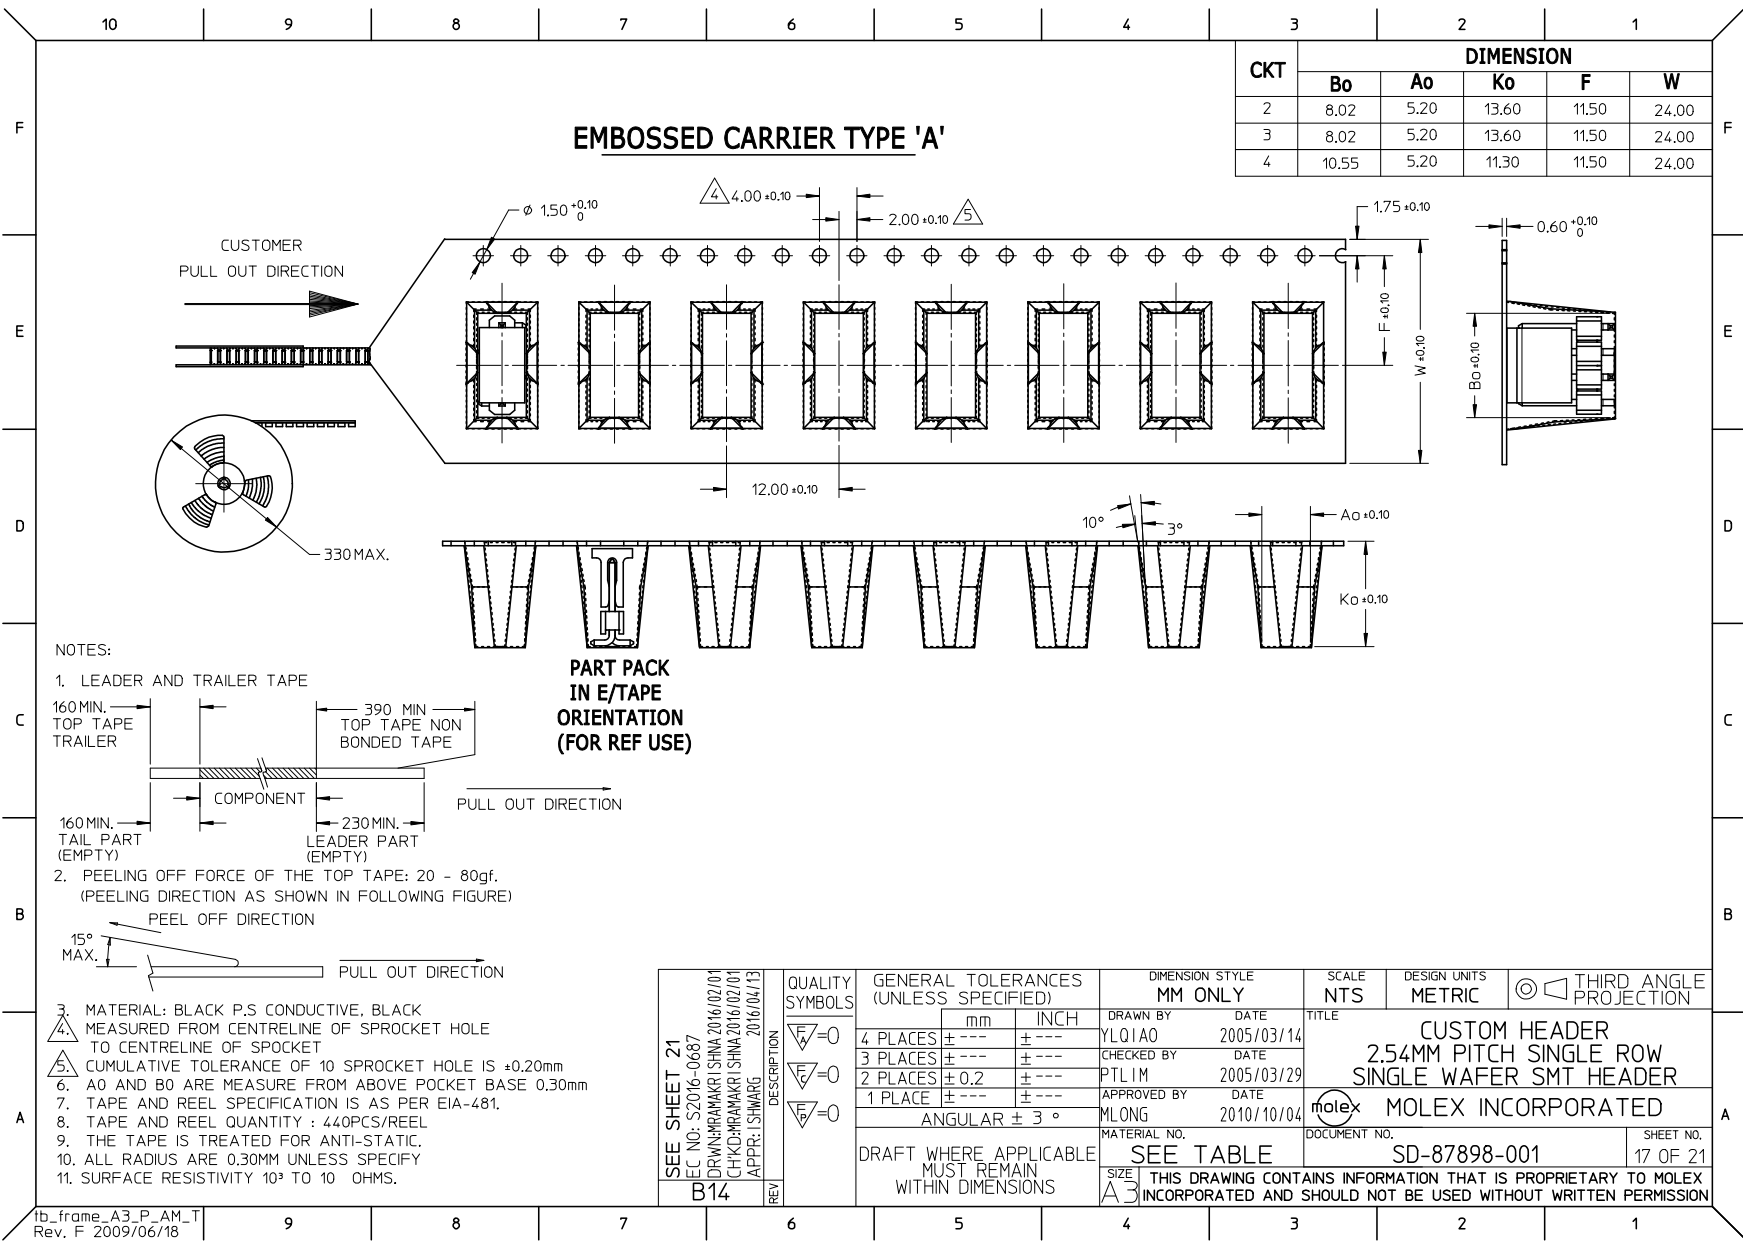
[picture p59: page 21]

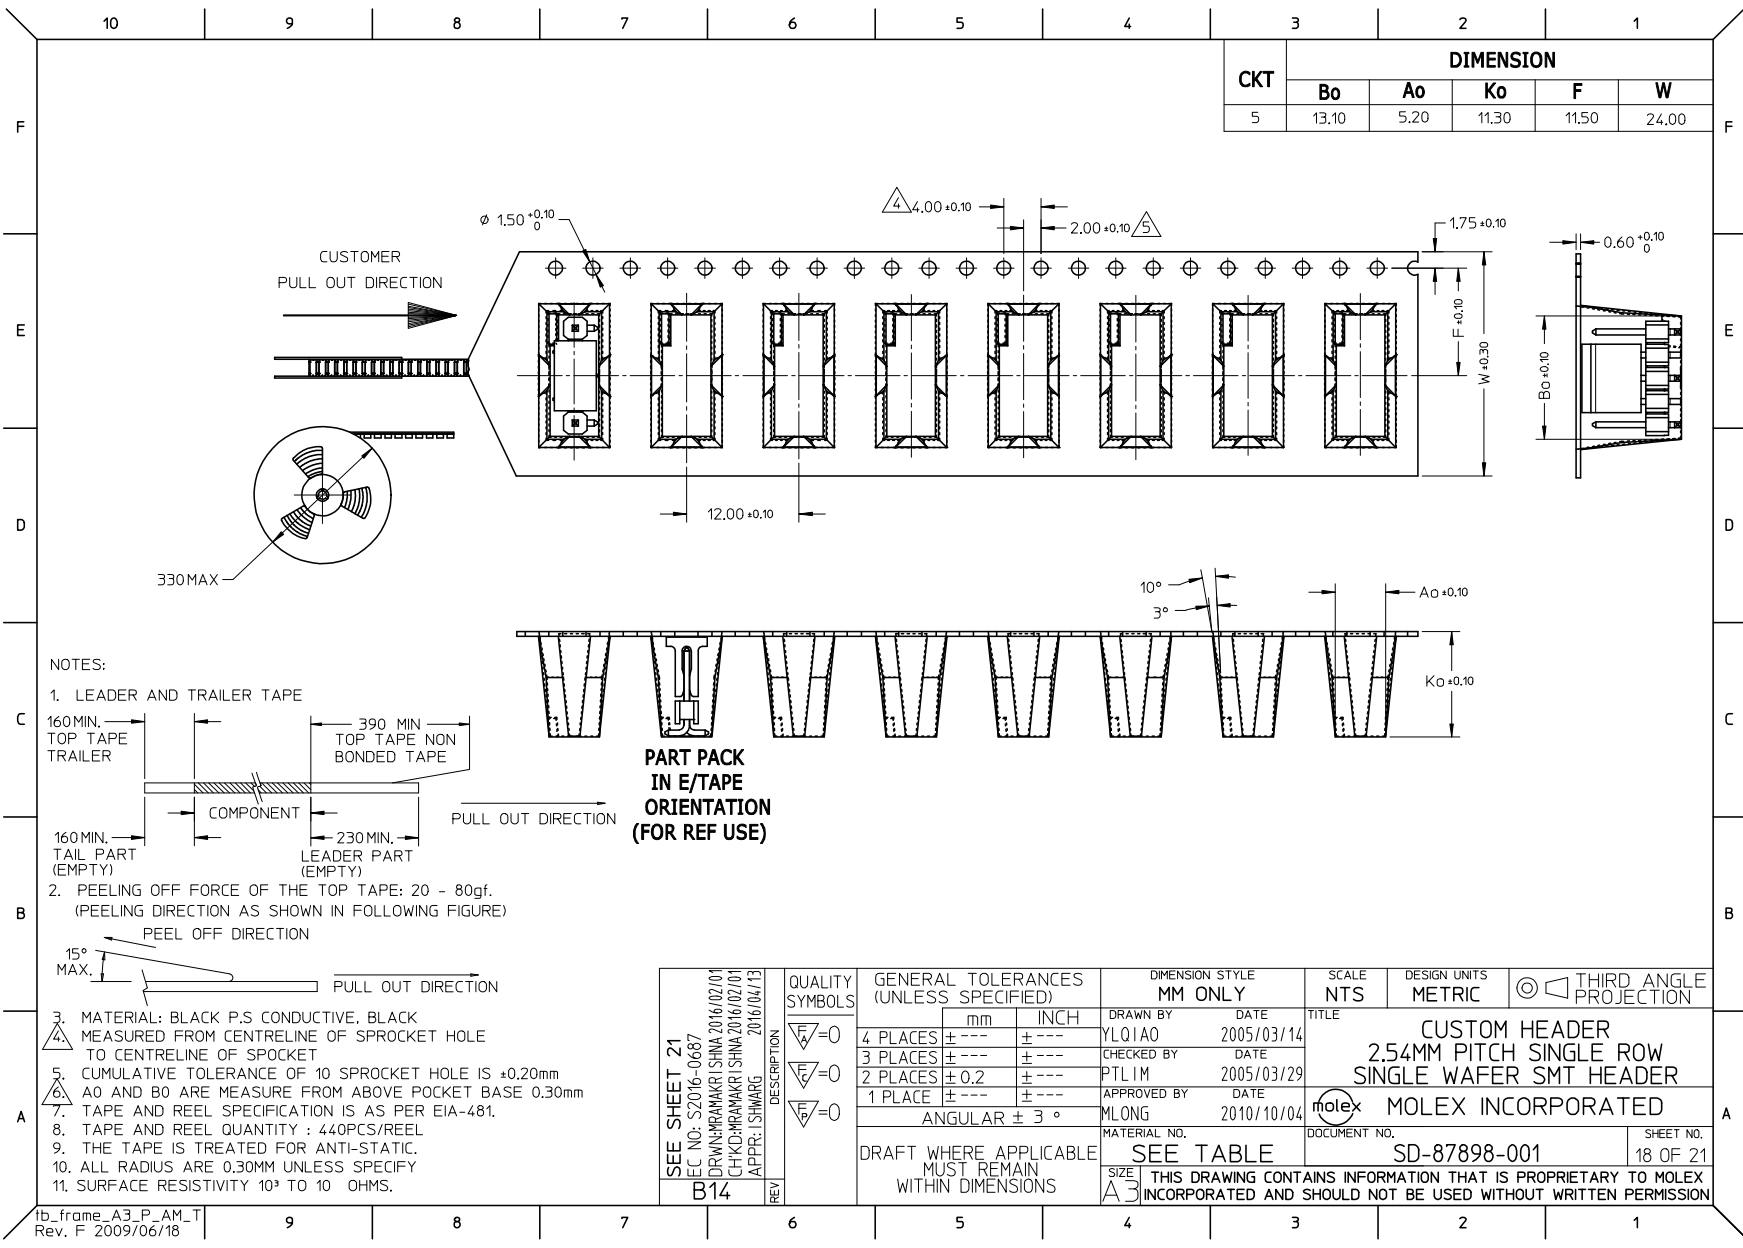
[picture p60: page 22]

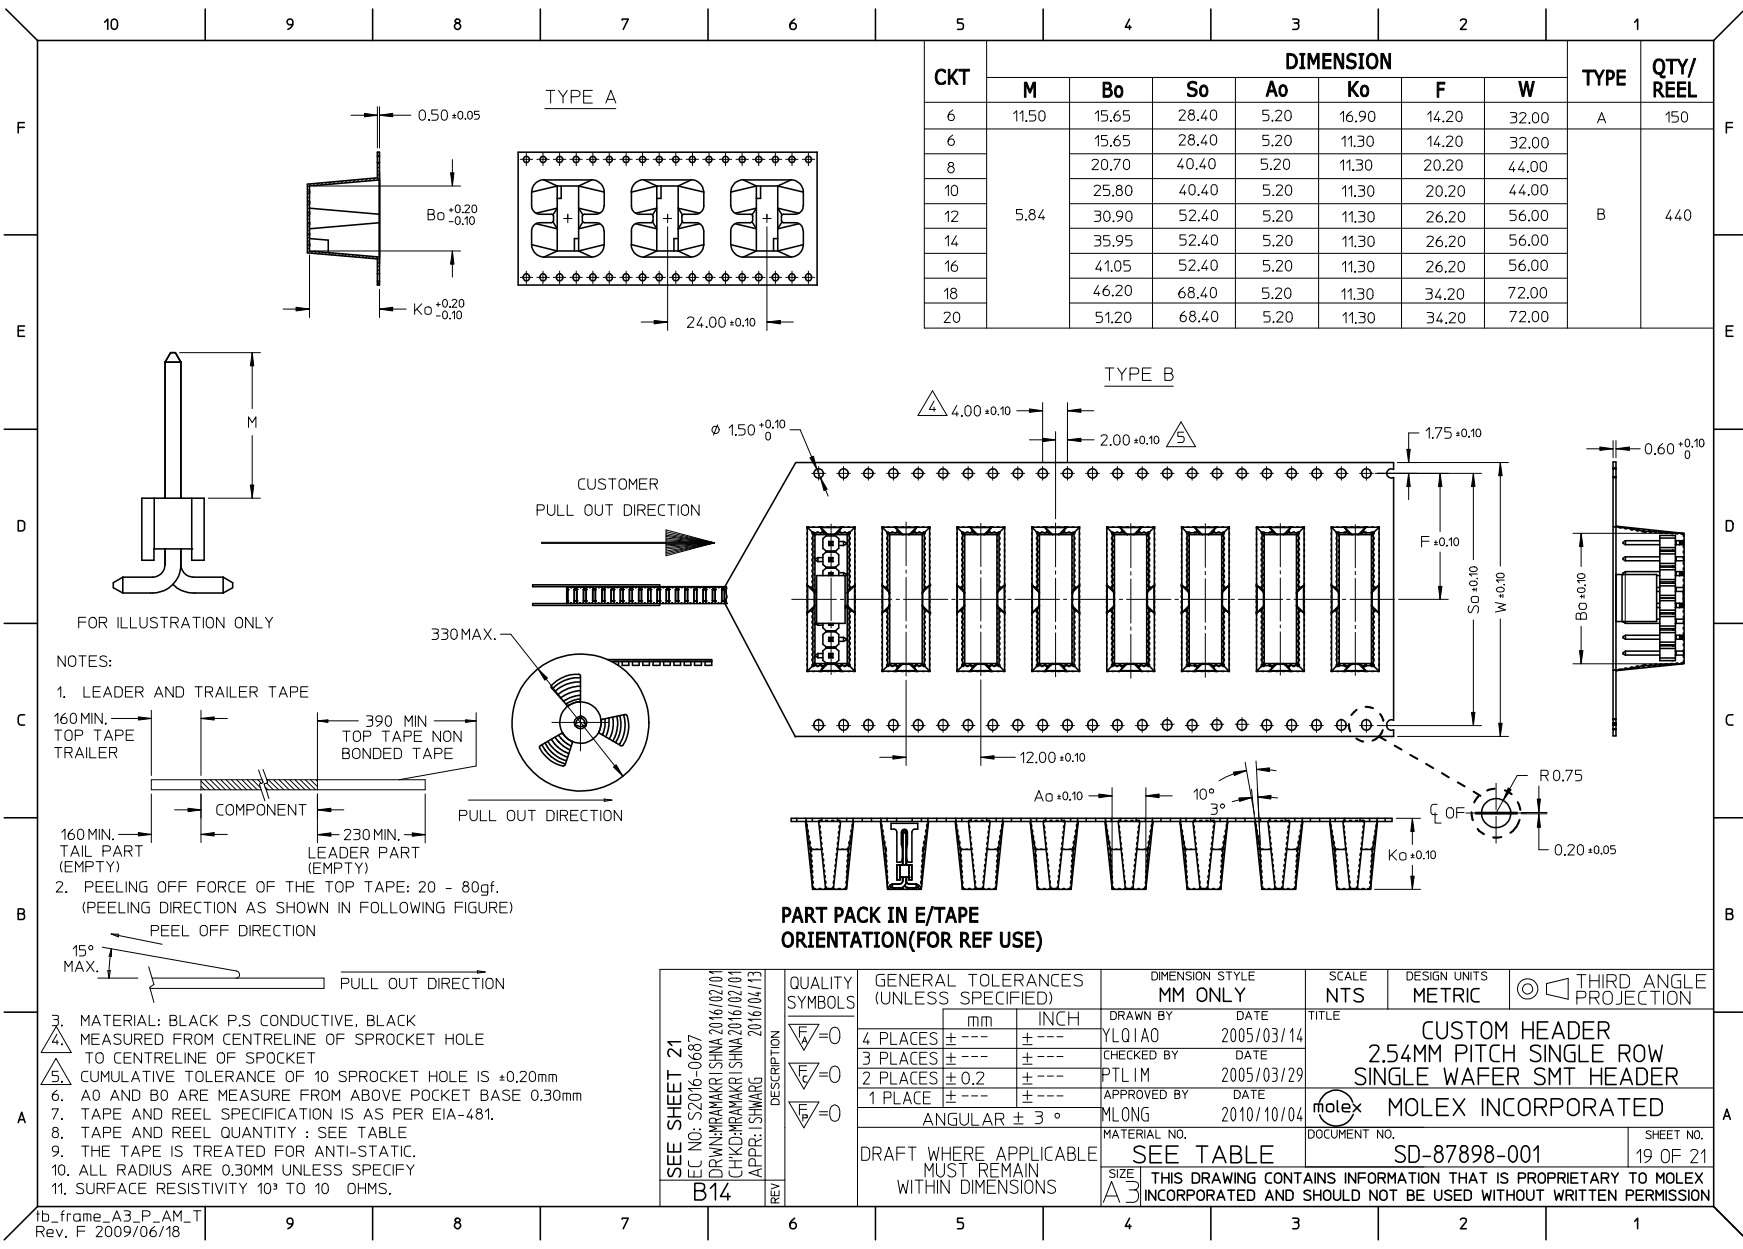
[picture p61: page 23]

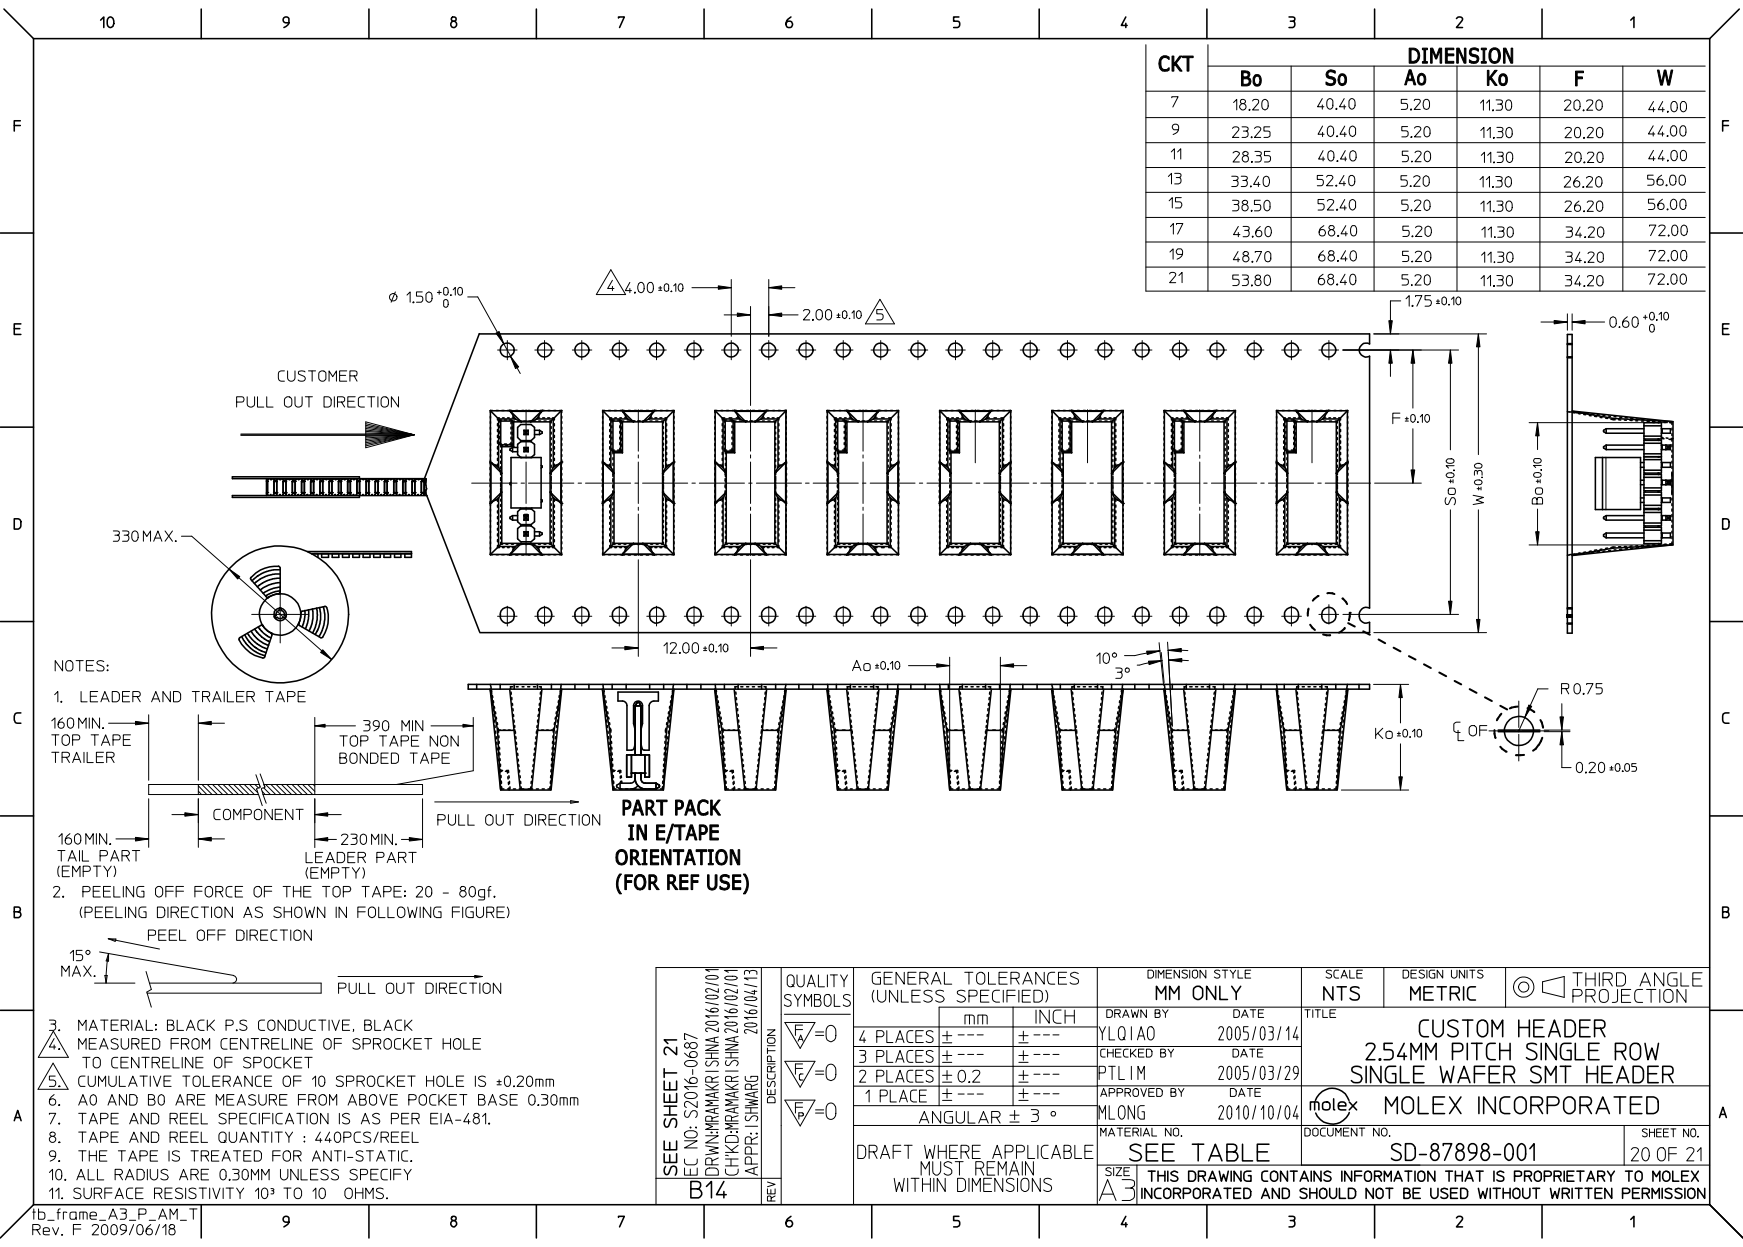
[picture p62: page 24]

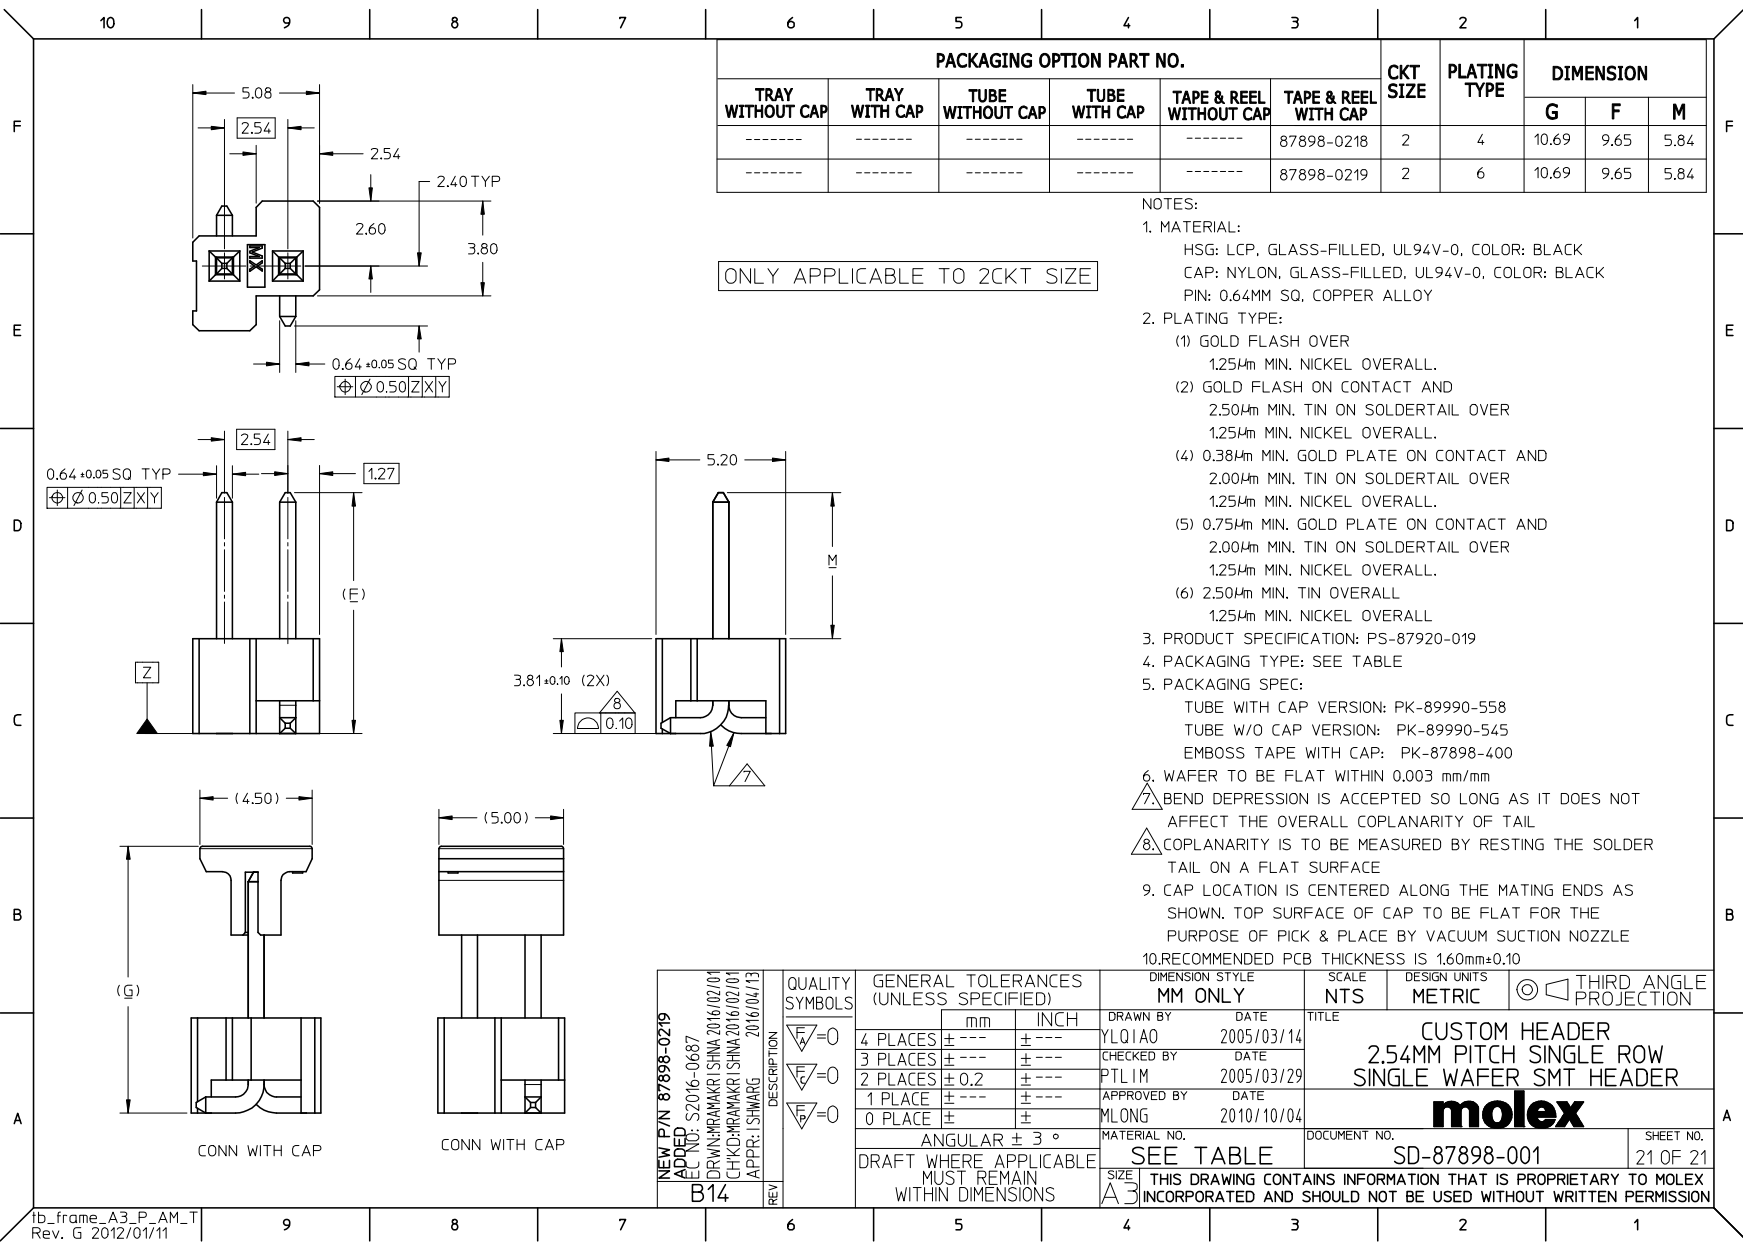
[picture p63: page 25]
