Jewelbots/jewelbot-ee/JDB-001_v2.0/SupportDocs/878980426_sd.pdf

FOR REFERENCE USE ONLY


FOR REFERENCE USE ONLY


FOR REFERENCE USE ONLY


FOR REFERENCE USE ONLY






















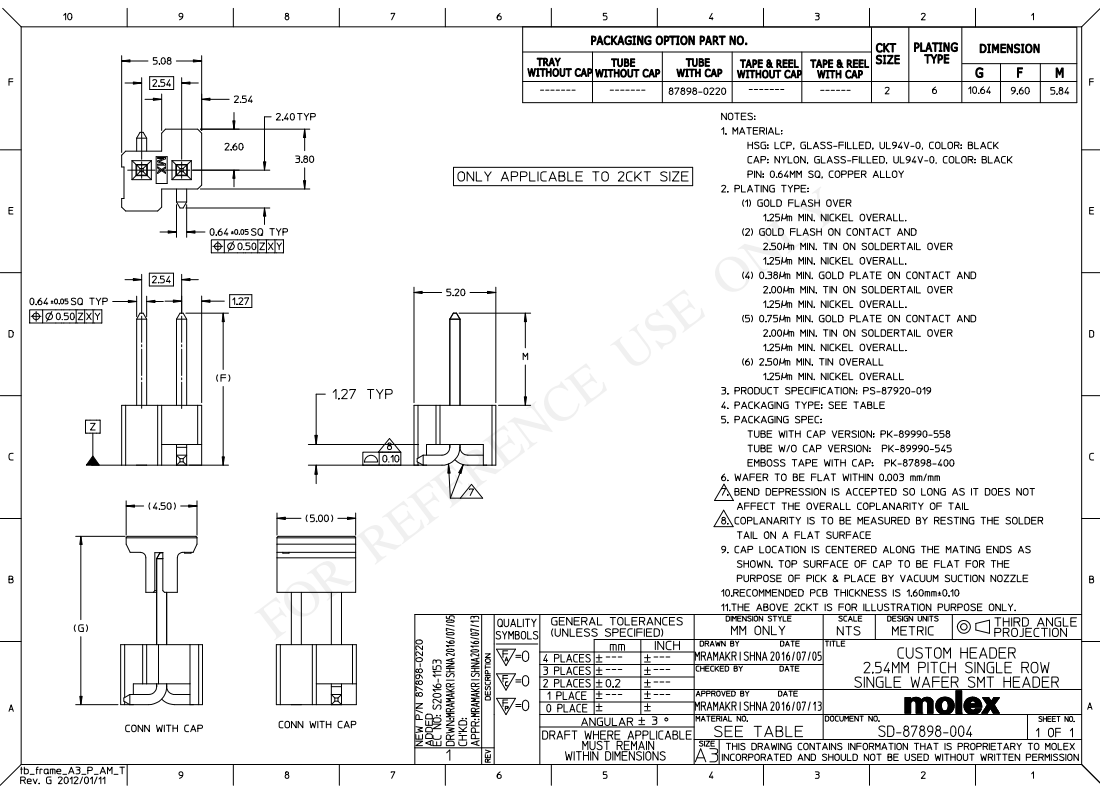
[picture p64: page 26]

FOR REFERENCE USE ONLY
