Jewelbots/jewelbot-ee/JWB-001_v3.8_160615/Layout/JWB-001_PCB.PDF

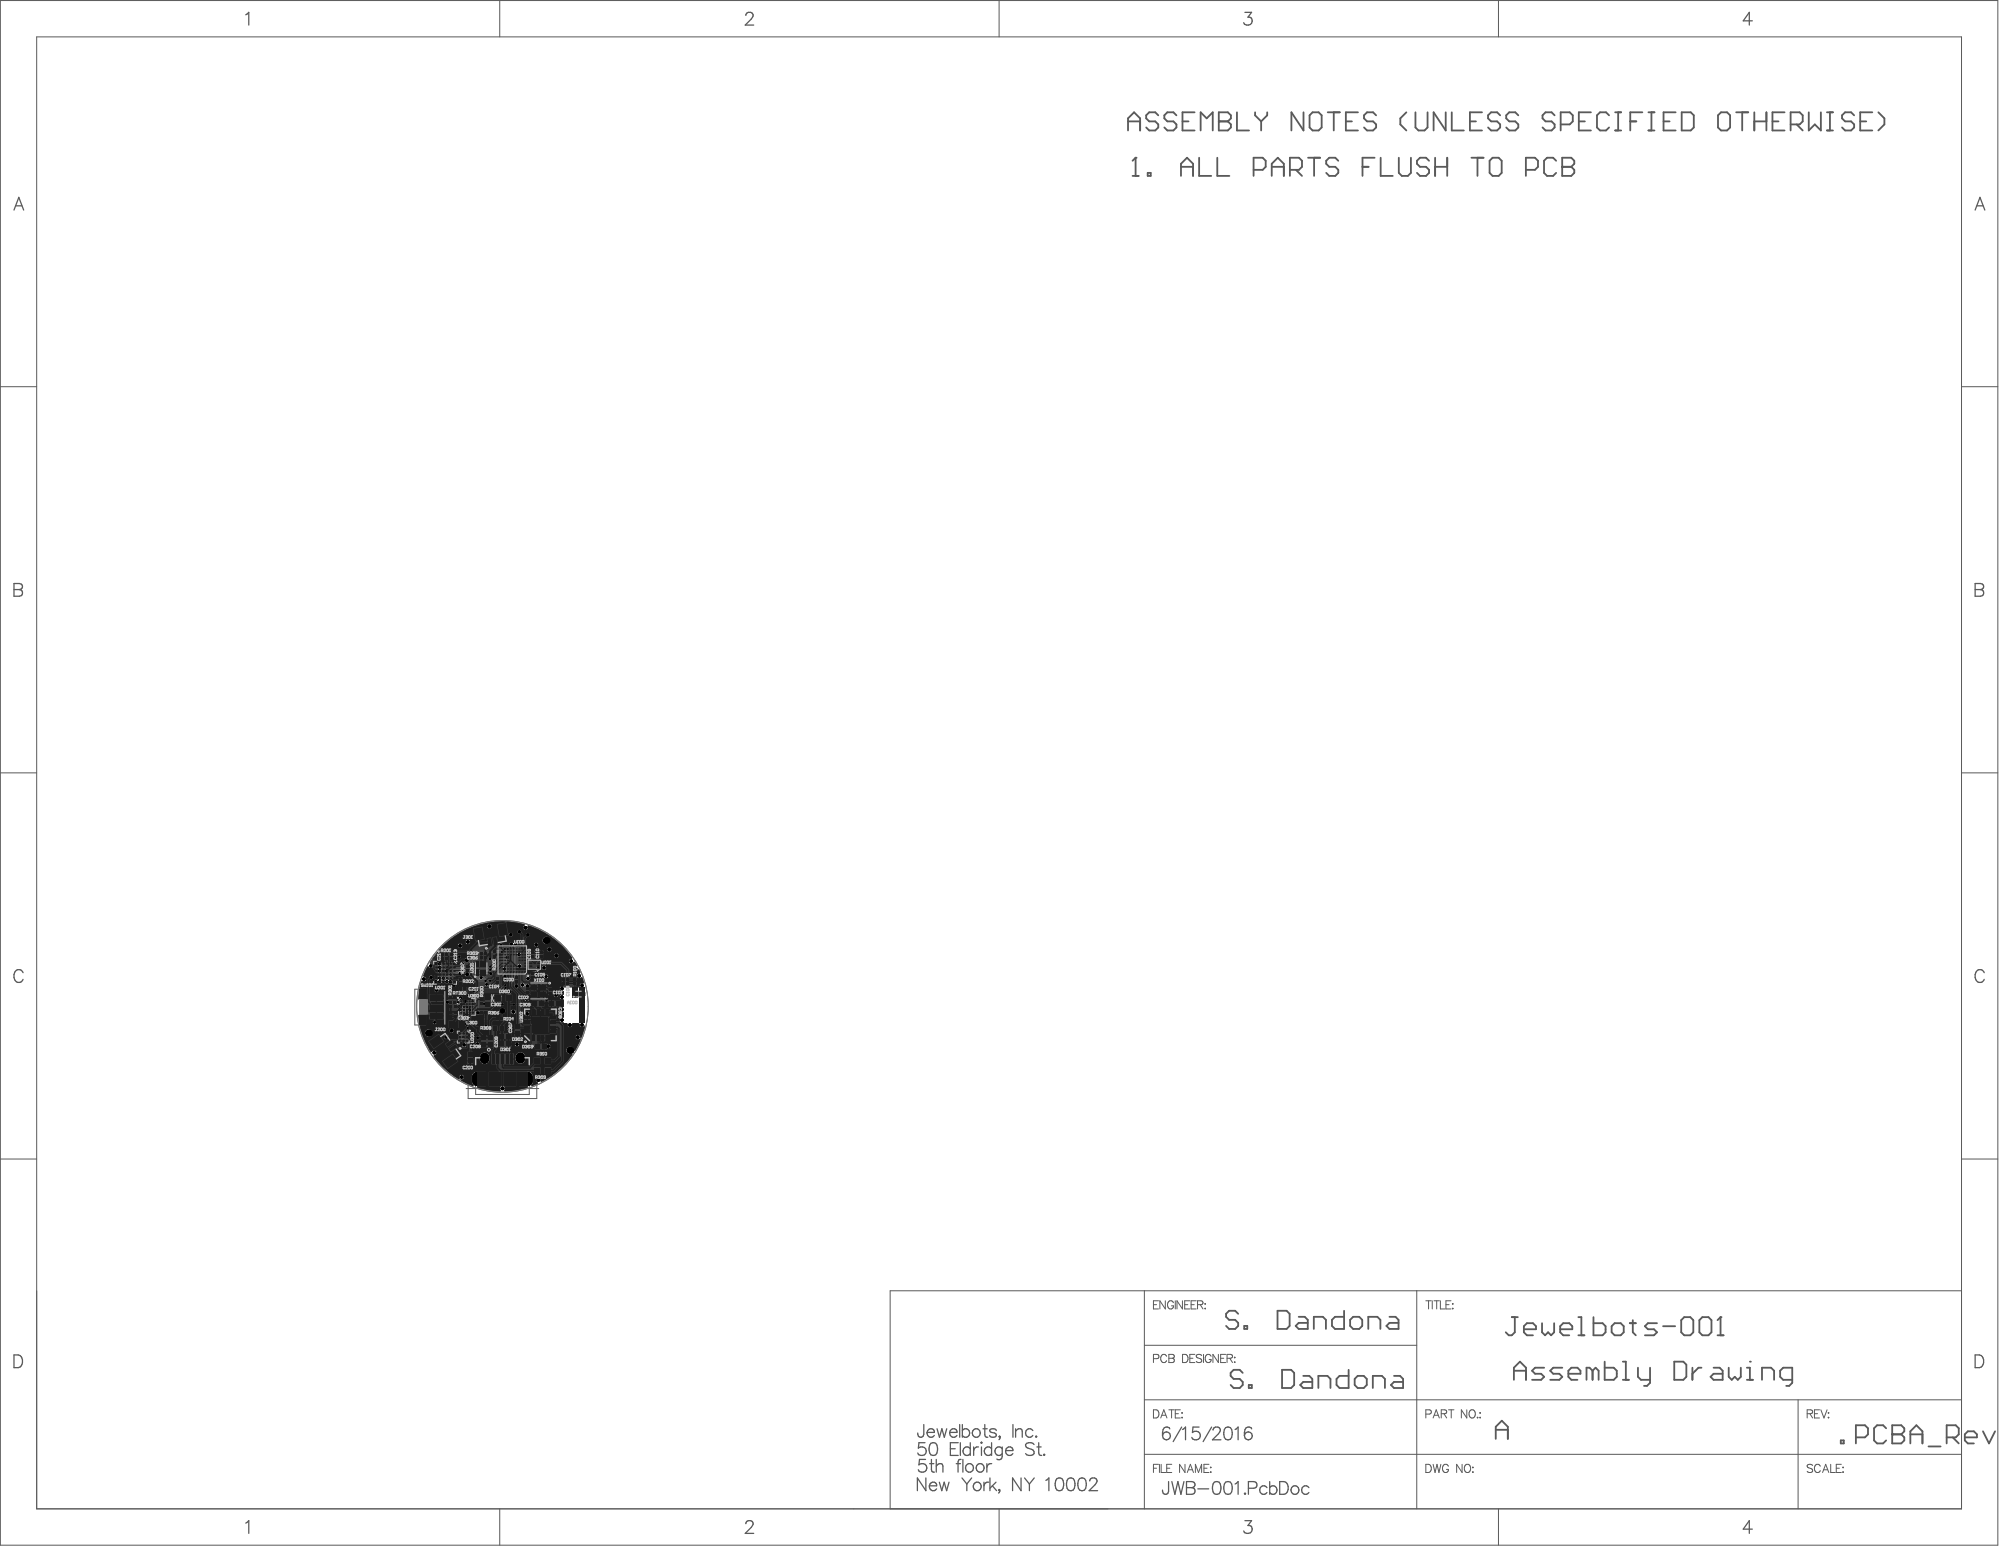
[picture p65: page 1]
