Jewelbots/jewelbot-ee/JWB-001_v3.8_160615/Project Outputs for JWB-001/JWB-001 REV3.8 FabDwg.PDF

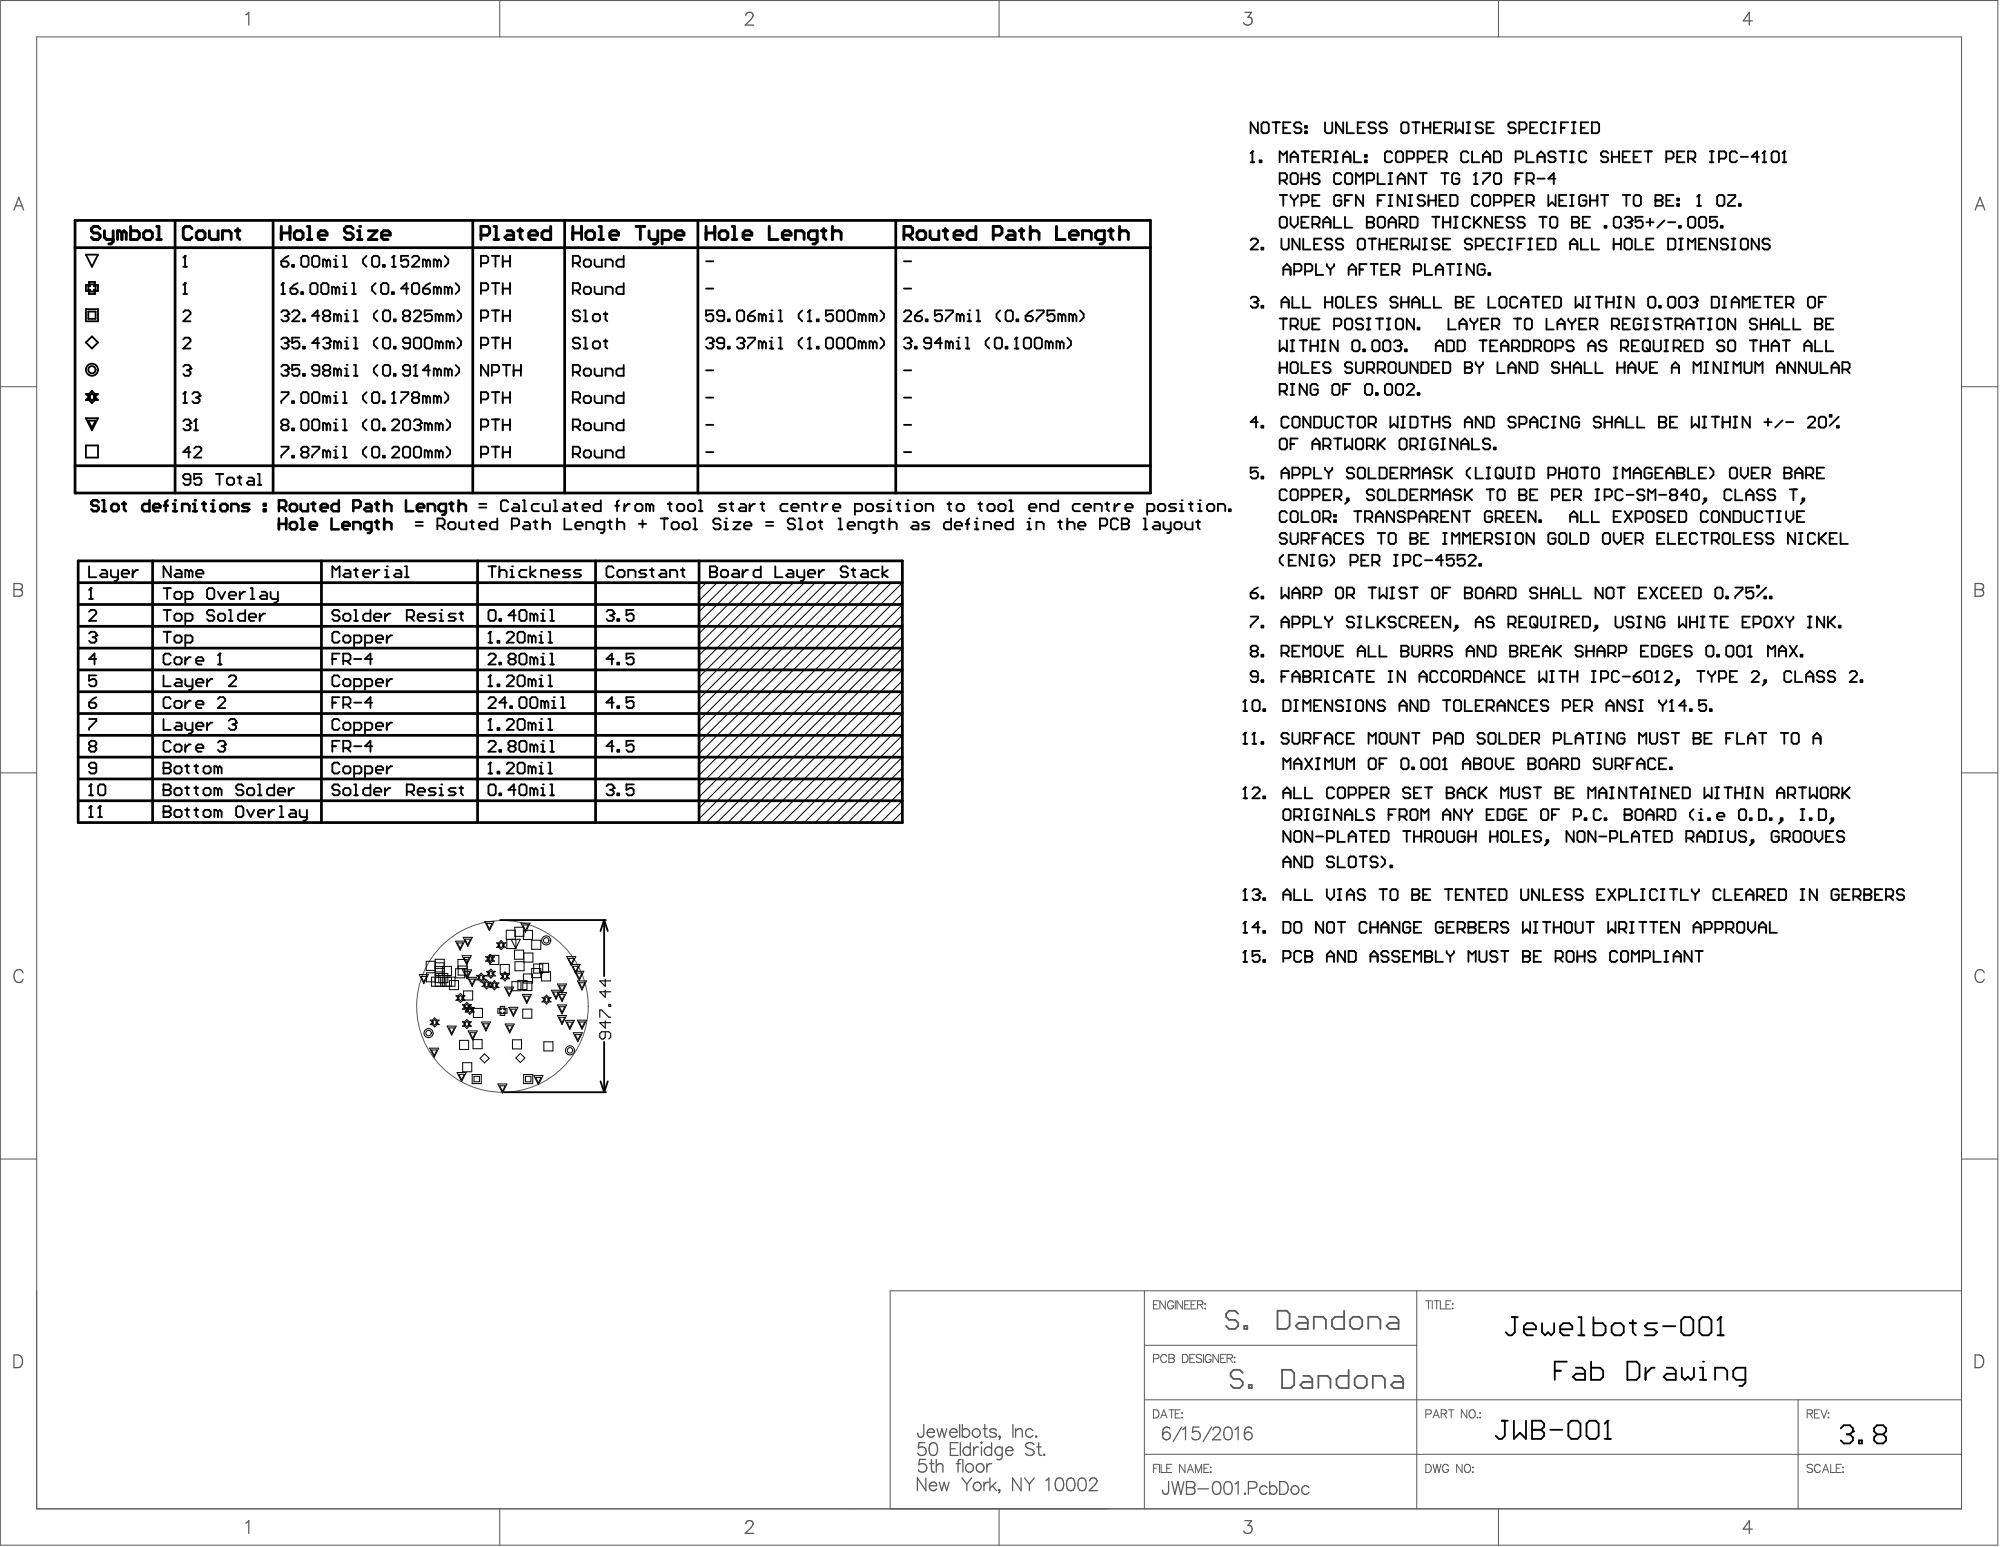
[picture p66: page 1]
