Jewelbots/jewelbot-ee/JWB-001_Main_v2.0/Source/Interfaces.PDF

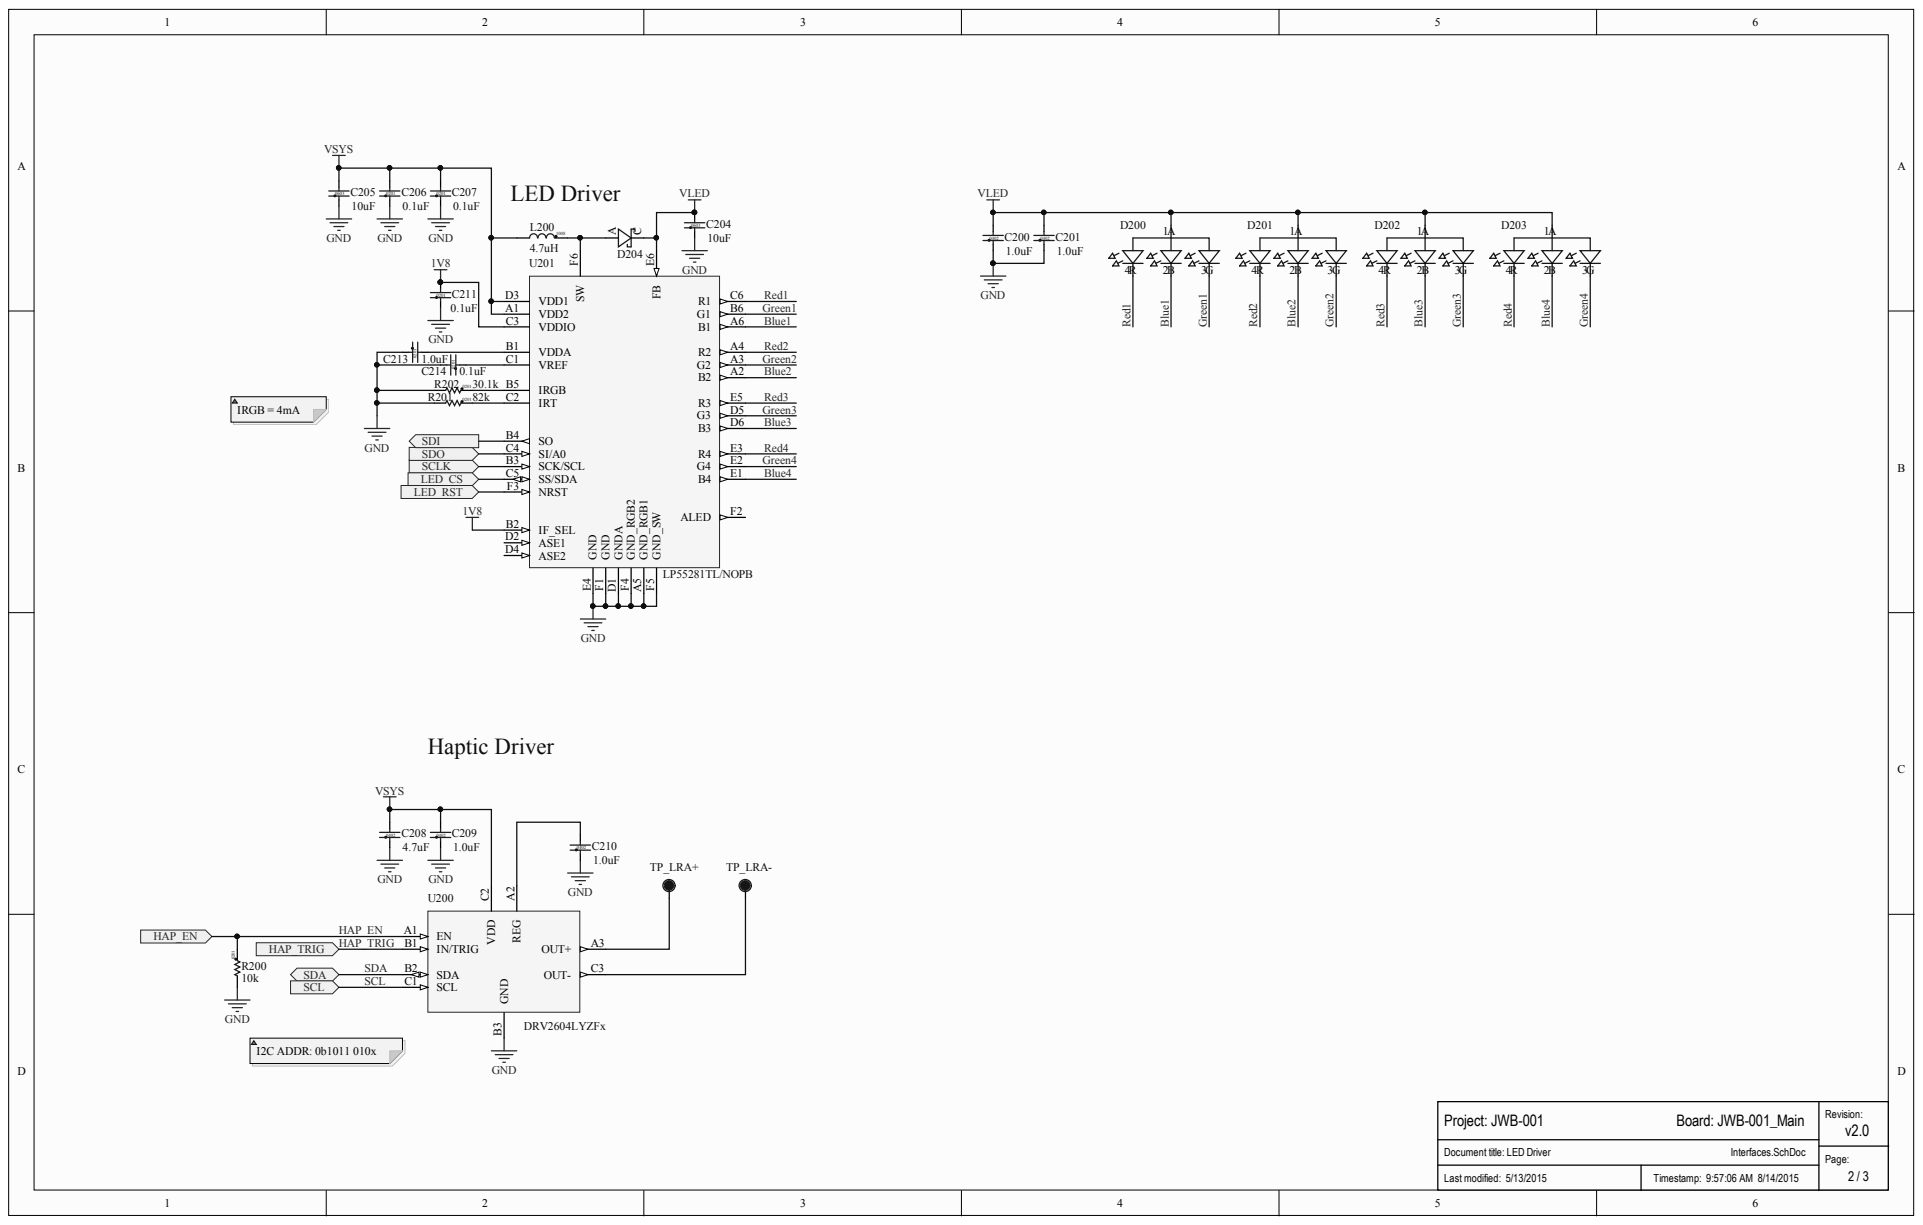
[picture p67: page 1]
