Jewelbots/jewelbot-ee/JDB-001_160609/Layout/JDB-001_PCB.PDF

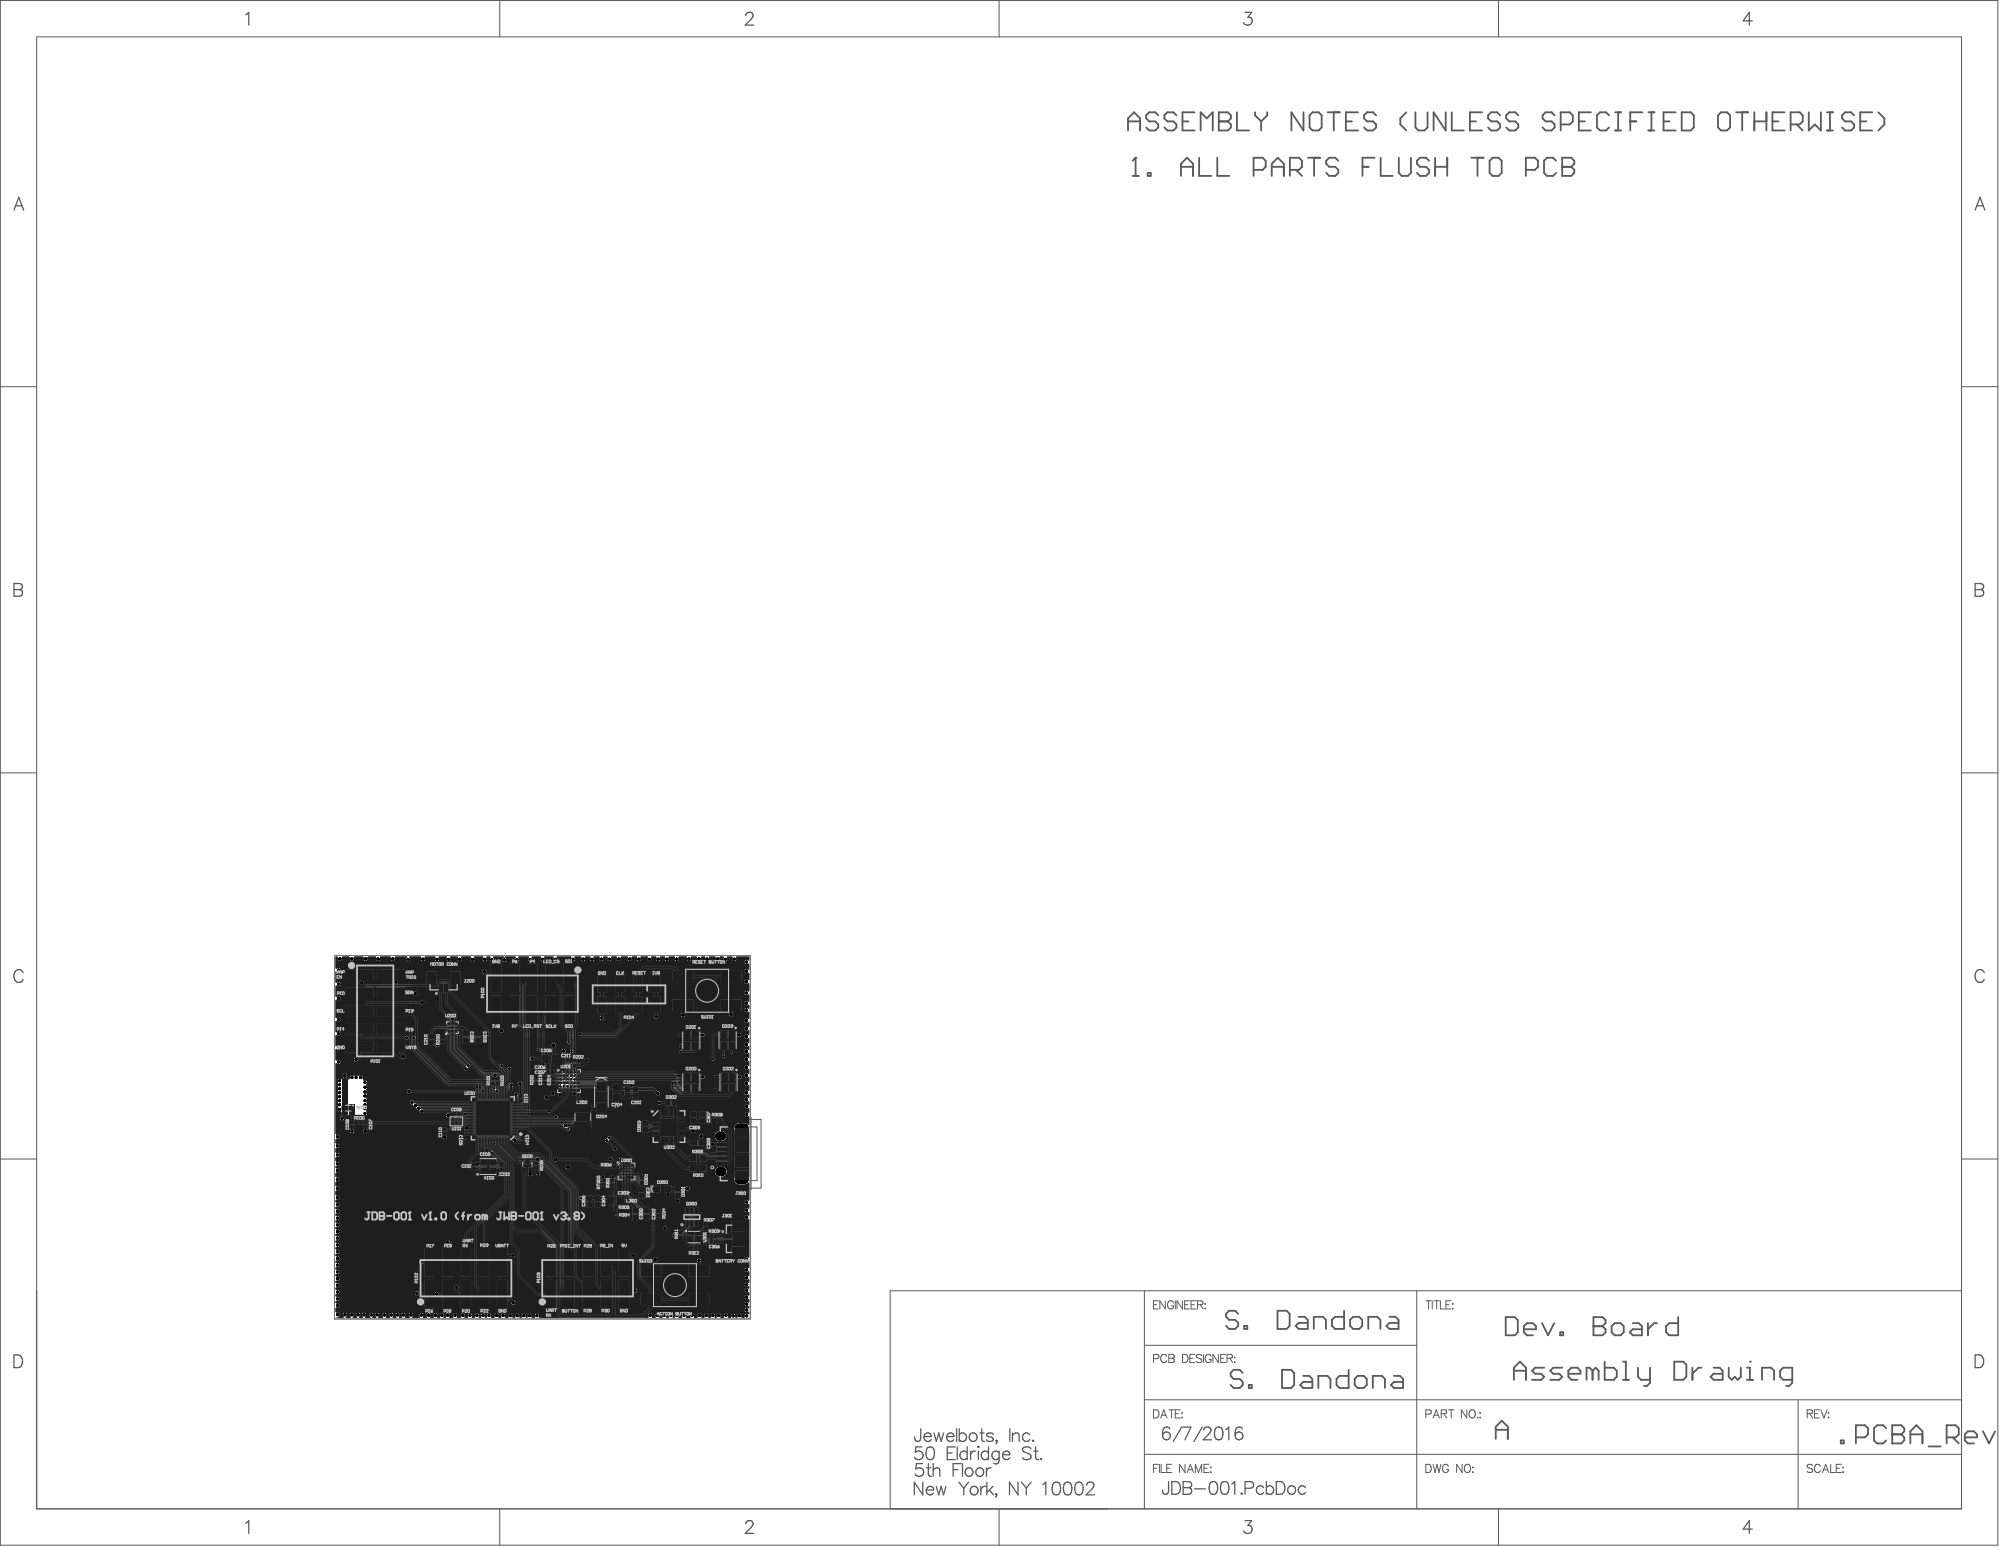
[picture p68: page 1]
