Jewelbots/jewelbot-ee/JDB-001_160609/Project Outputs for JDB-001/JDB-001 REV1.0 FabDwg.PDF

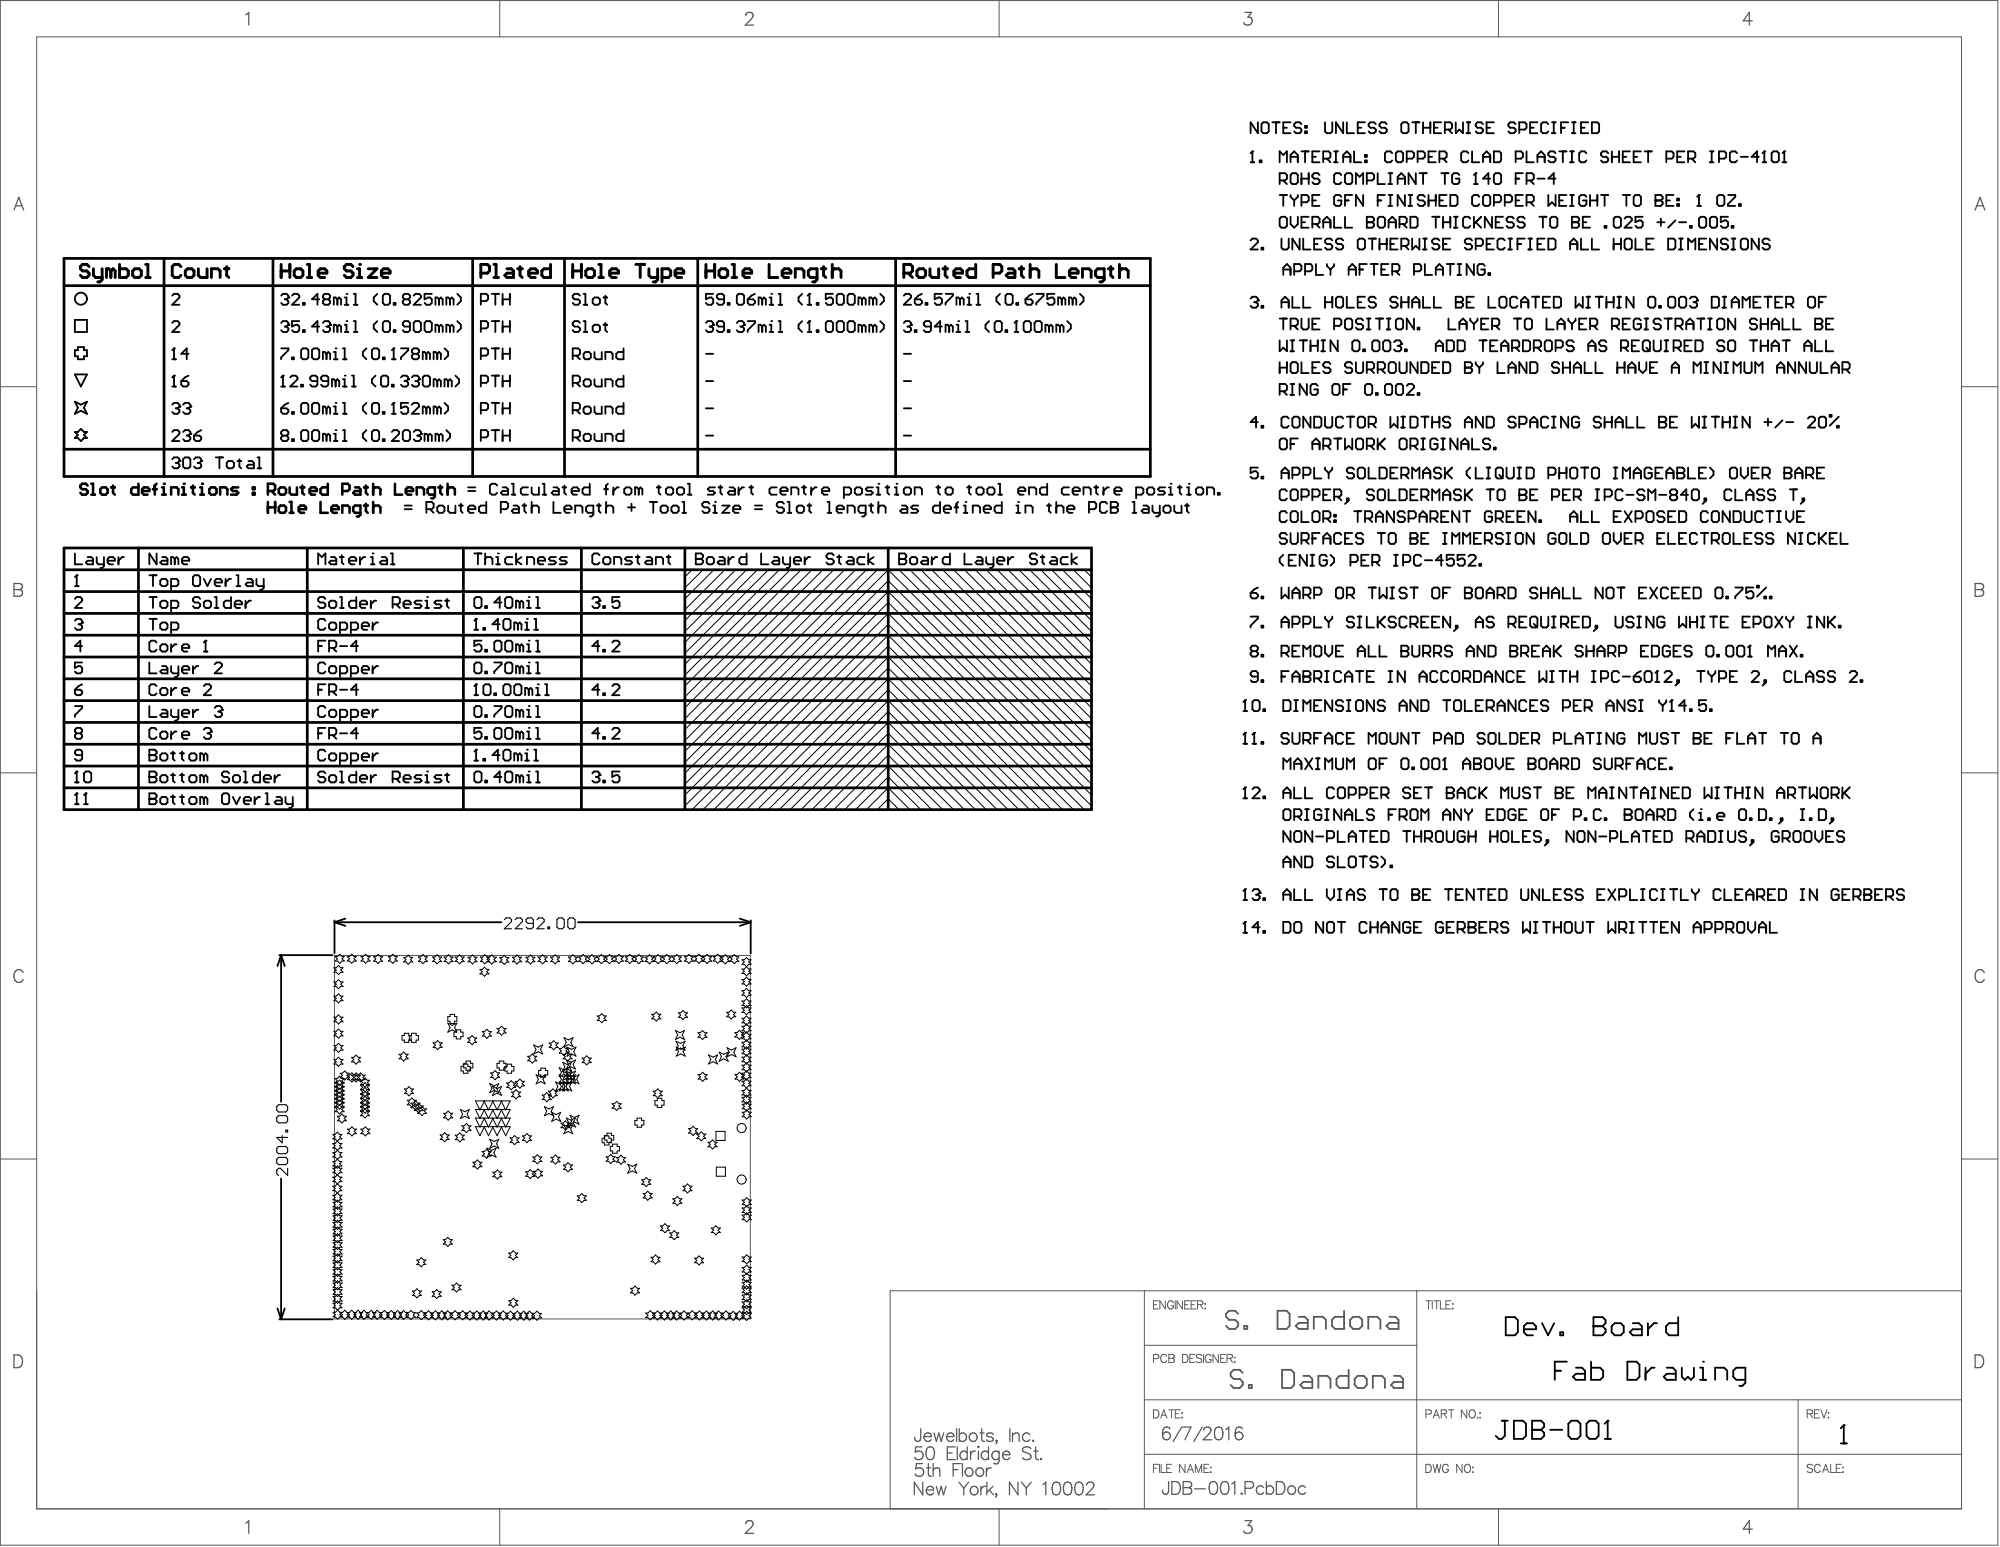
[picture p69: page 1]
