Jewelbots/jewelbot-ee/JDB-001_160609/Schematic/JDB-001_Sch.PDF

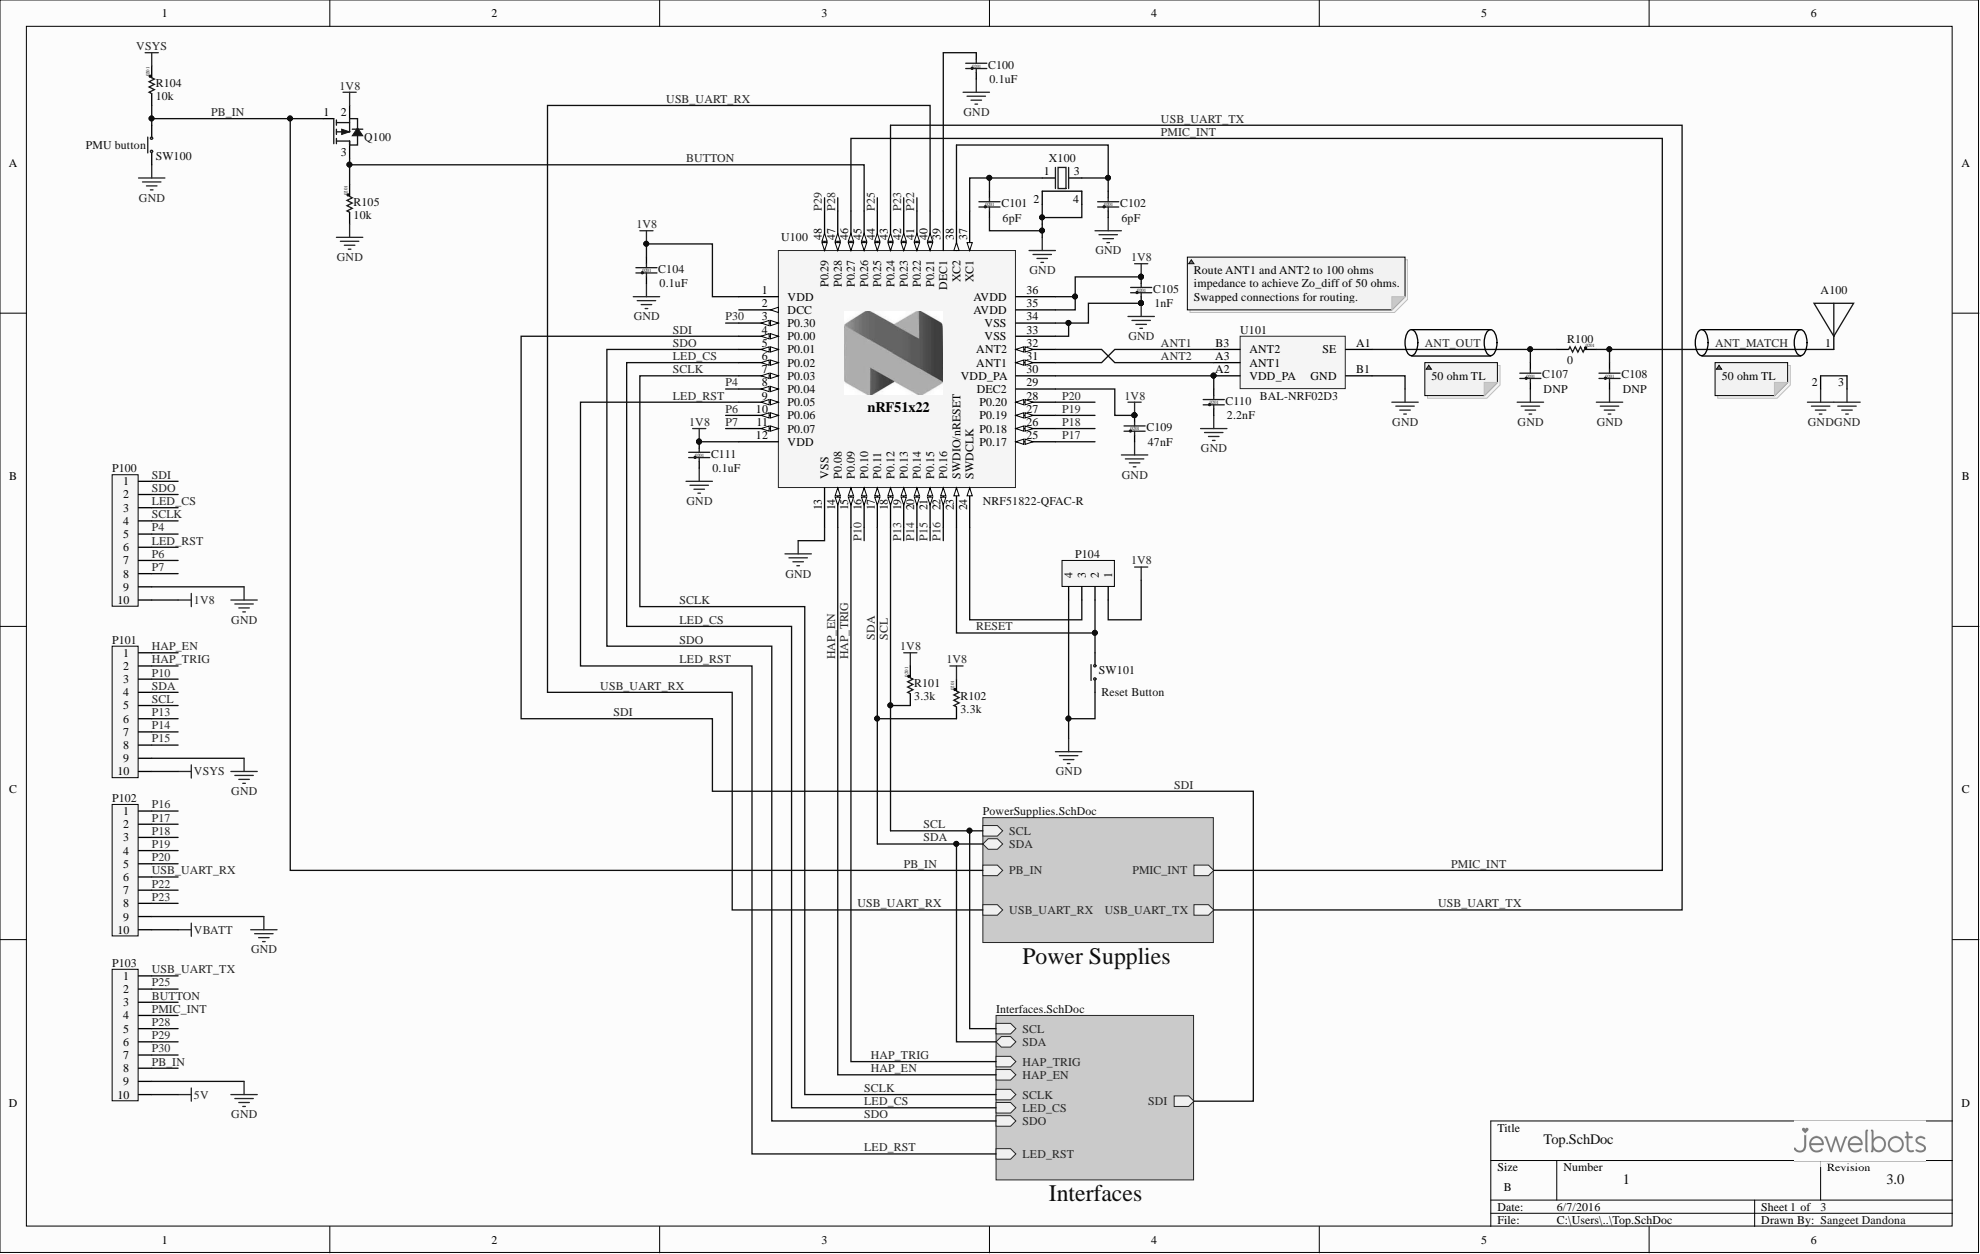
[picture p79: page 1]

R1 0 5
1 0 | V 8

V D D DCC P0.3 0 P0.0 0 P0.0 1 P0.0 2 P0.0 3 P0.0 4 P0.0 5 P0.0 6 P0.0 7 V D D | n RF5 | AV AV A A V D D 1 x 2 2 | D D D D VSS VSS N T 2 N T 1 _ PA P0.1 7

NRF5 1

SCL | Po | werSu p p l ies.Sch D o c

SCL SD A PB_IN PMIC_IN T

USB_ | U | A RT _RX | | USB_ U A RT _RX USB_ U A RT _ T X | USB_ U A RT _ T X

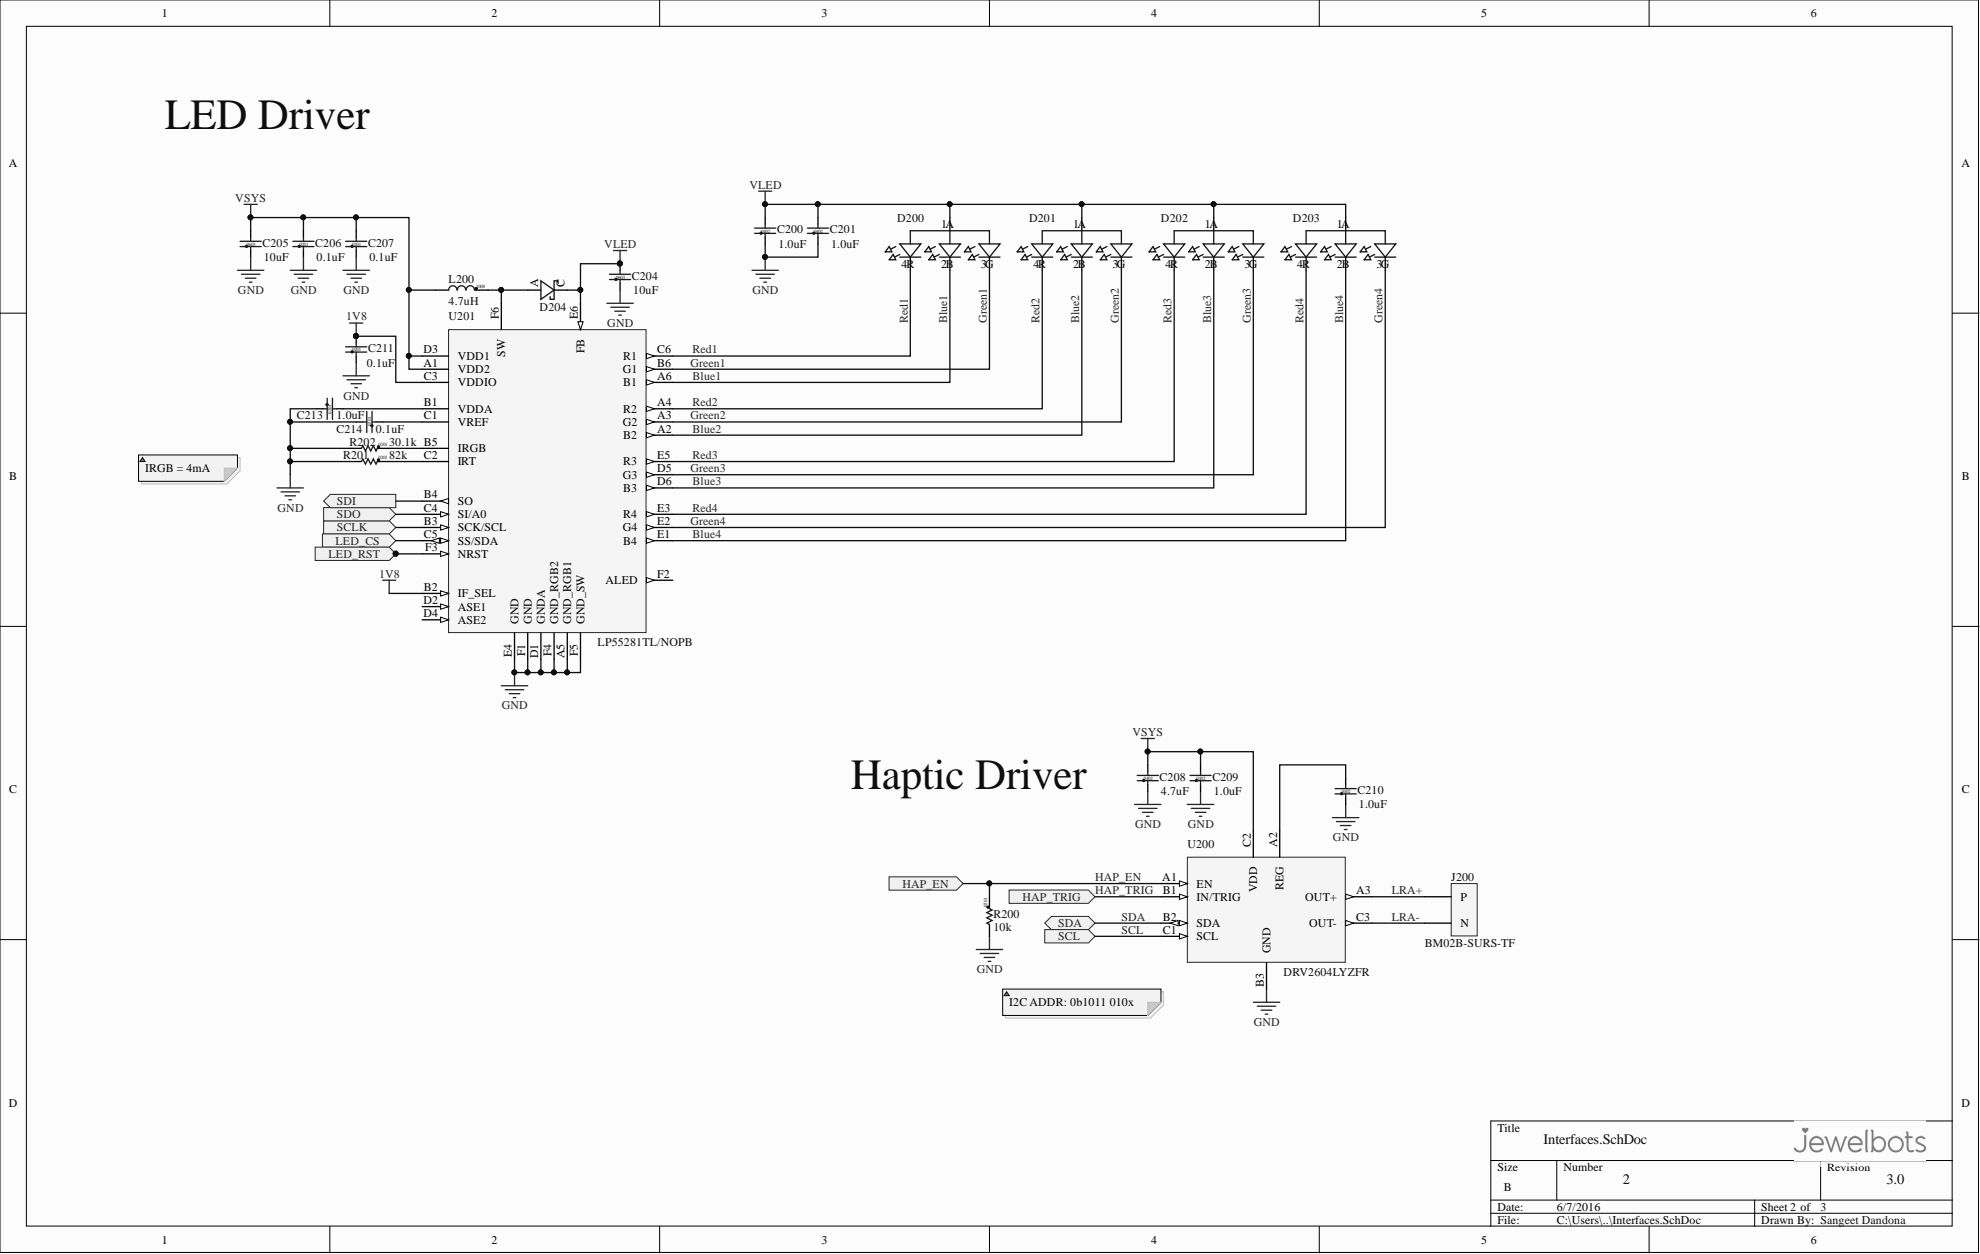
[picture p80: page 2]

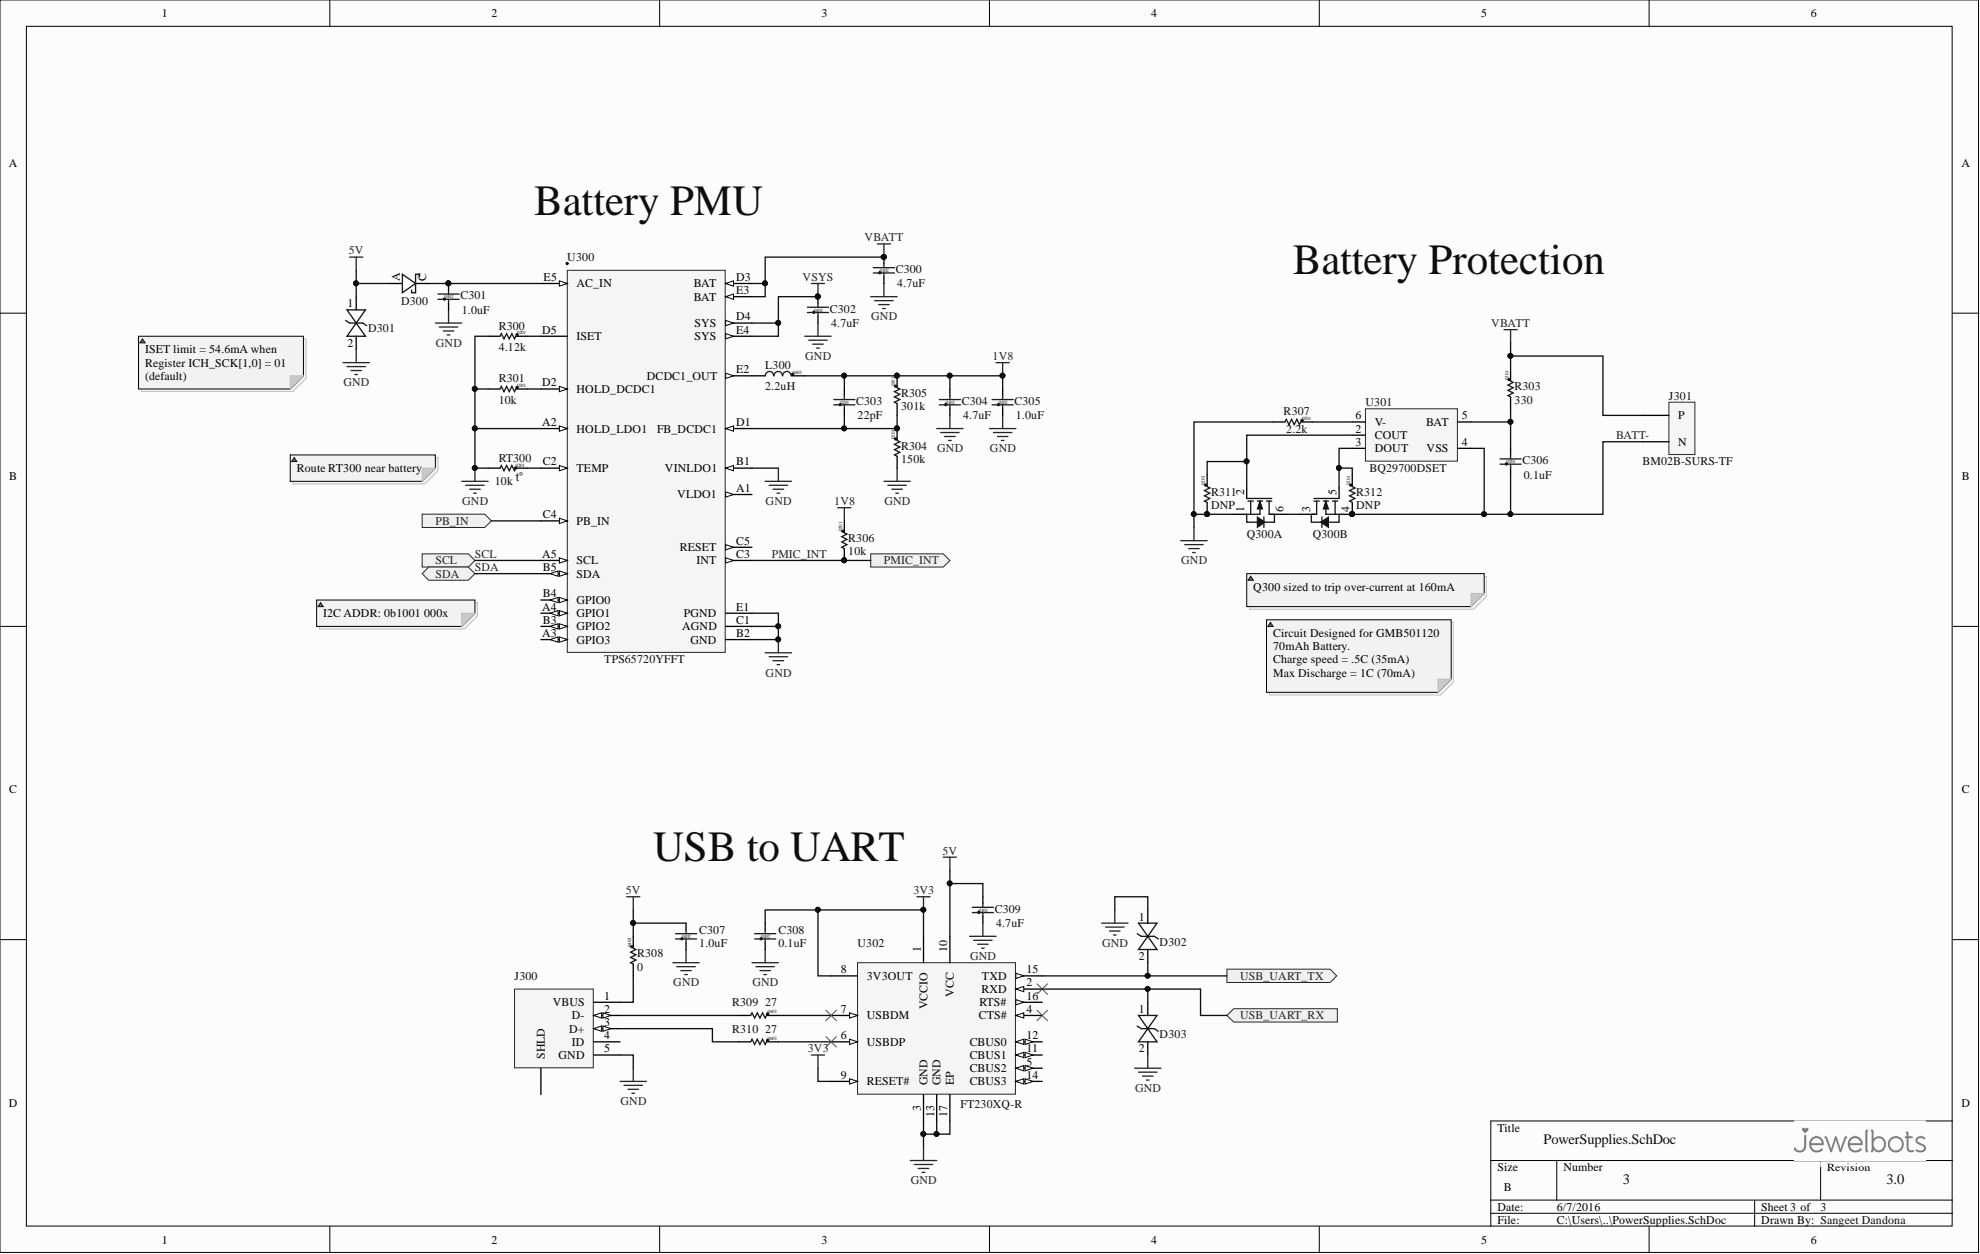
[picture p81: page 3]

Q300 sized to trip over-current at 160mA
