Jewelbots/jewelbot-ee/JDB-001/Layout/JDB-001_PCB.PDF

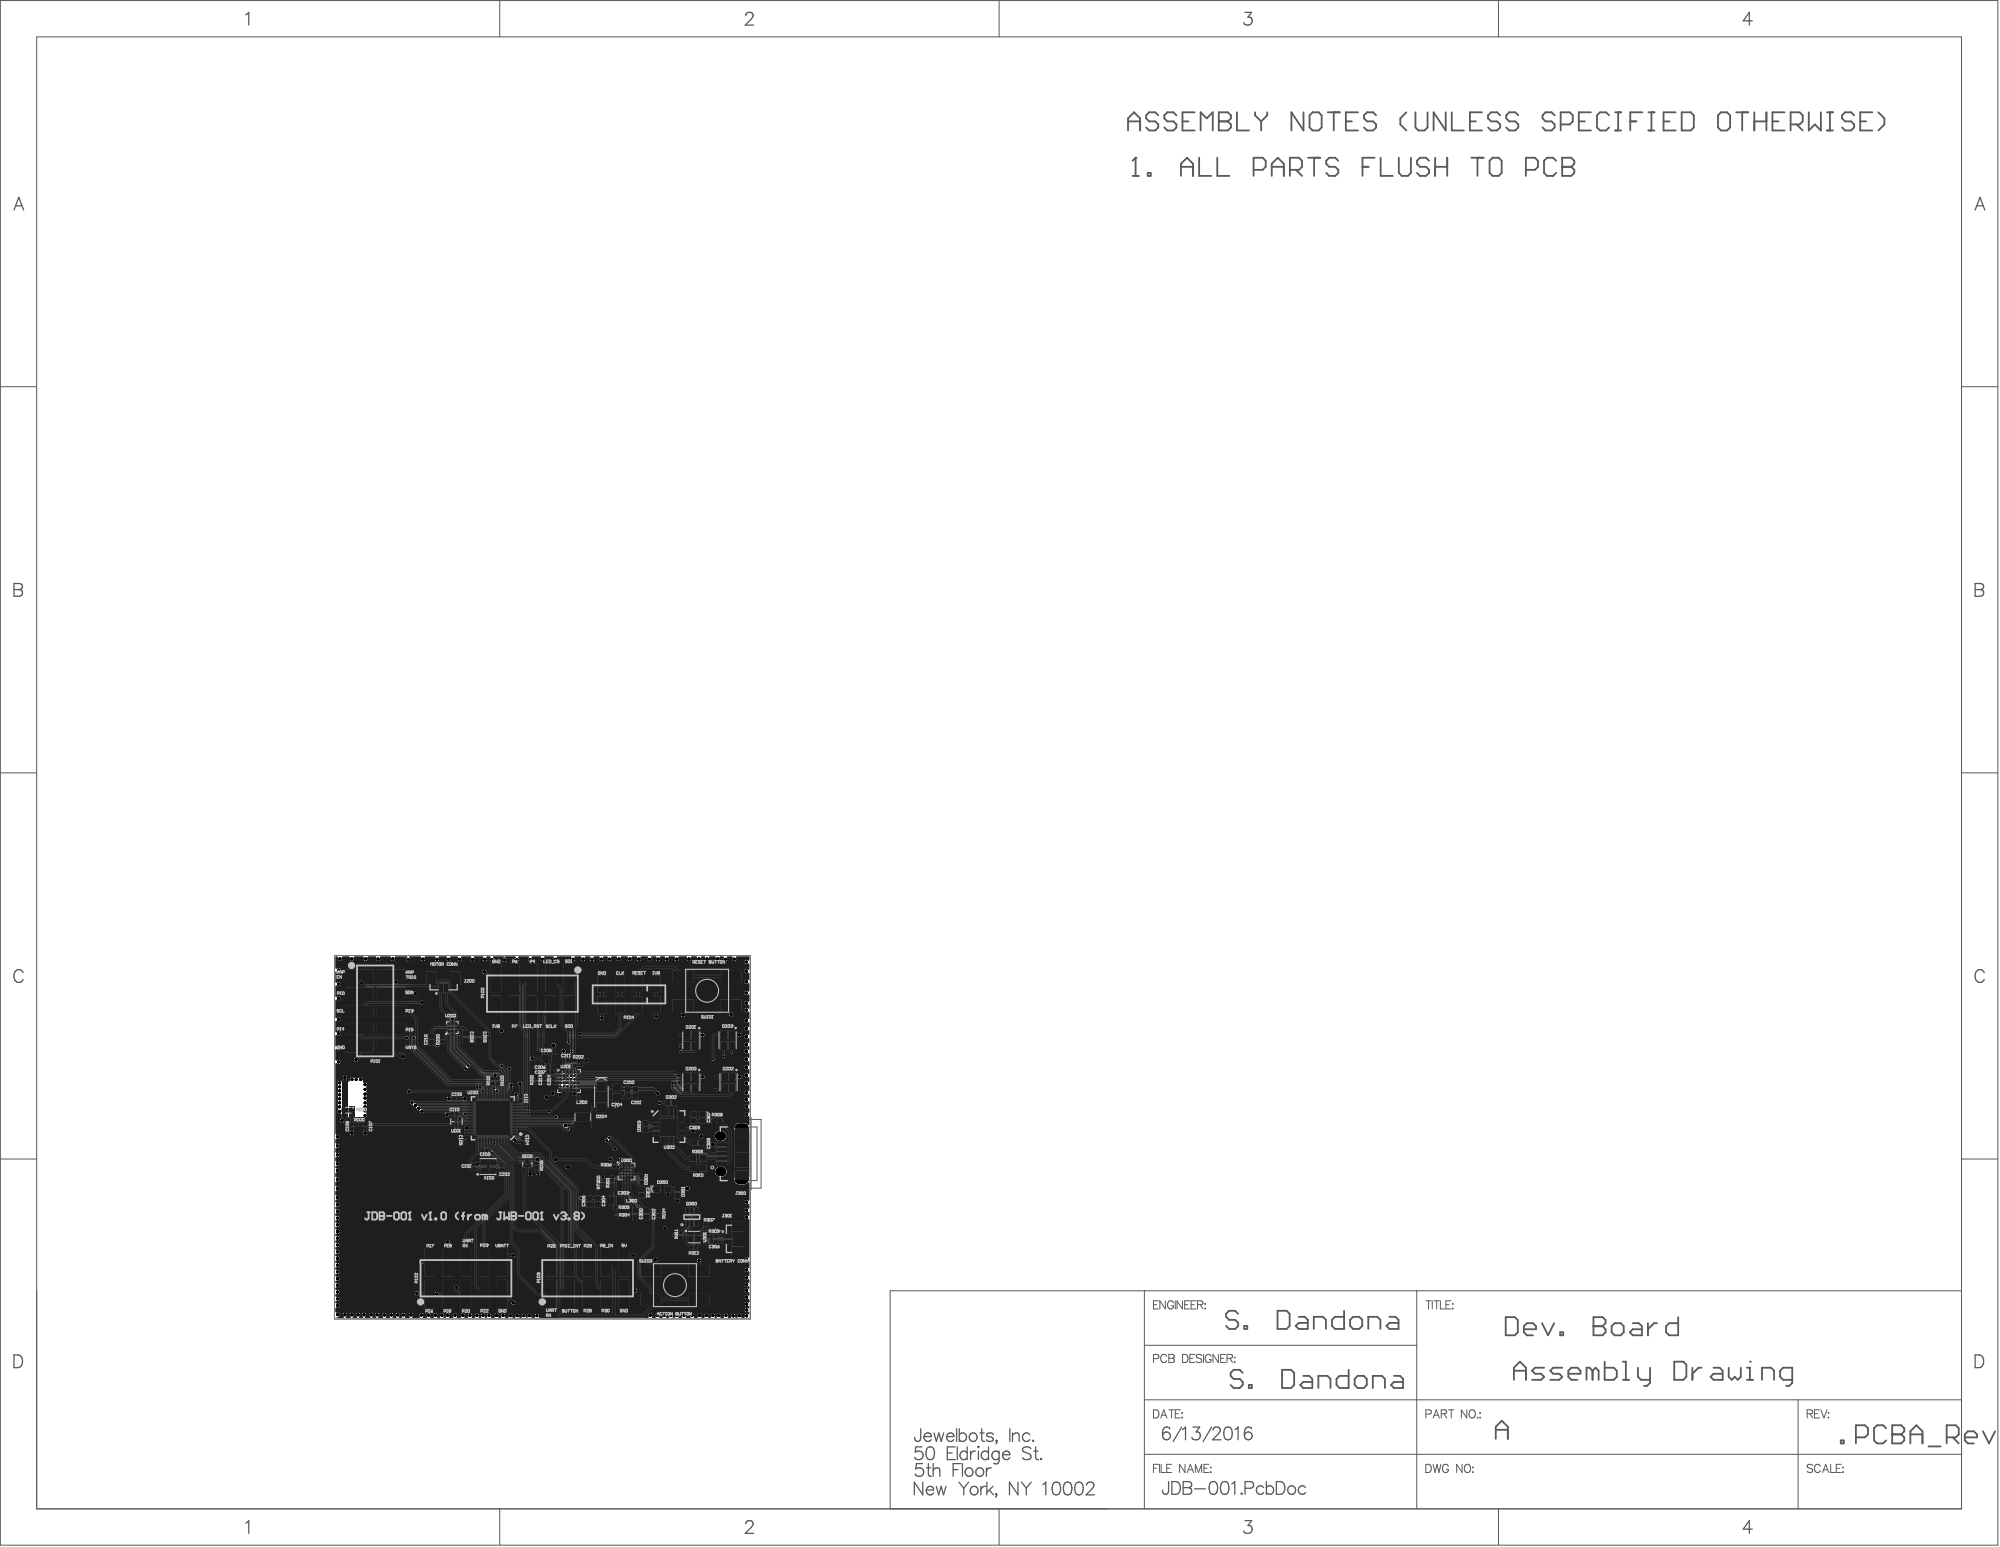
[picture p82: page 1]
