Jewelbots/jewelbot-ee/JDB-001/Project Outputs for JDB-001/JDB-001 REV1.0 FabDwg.PDF

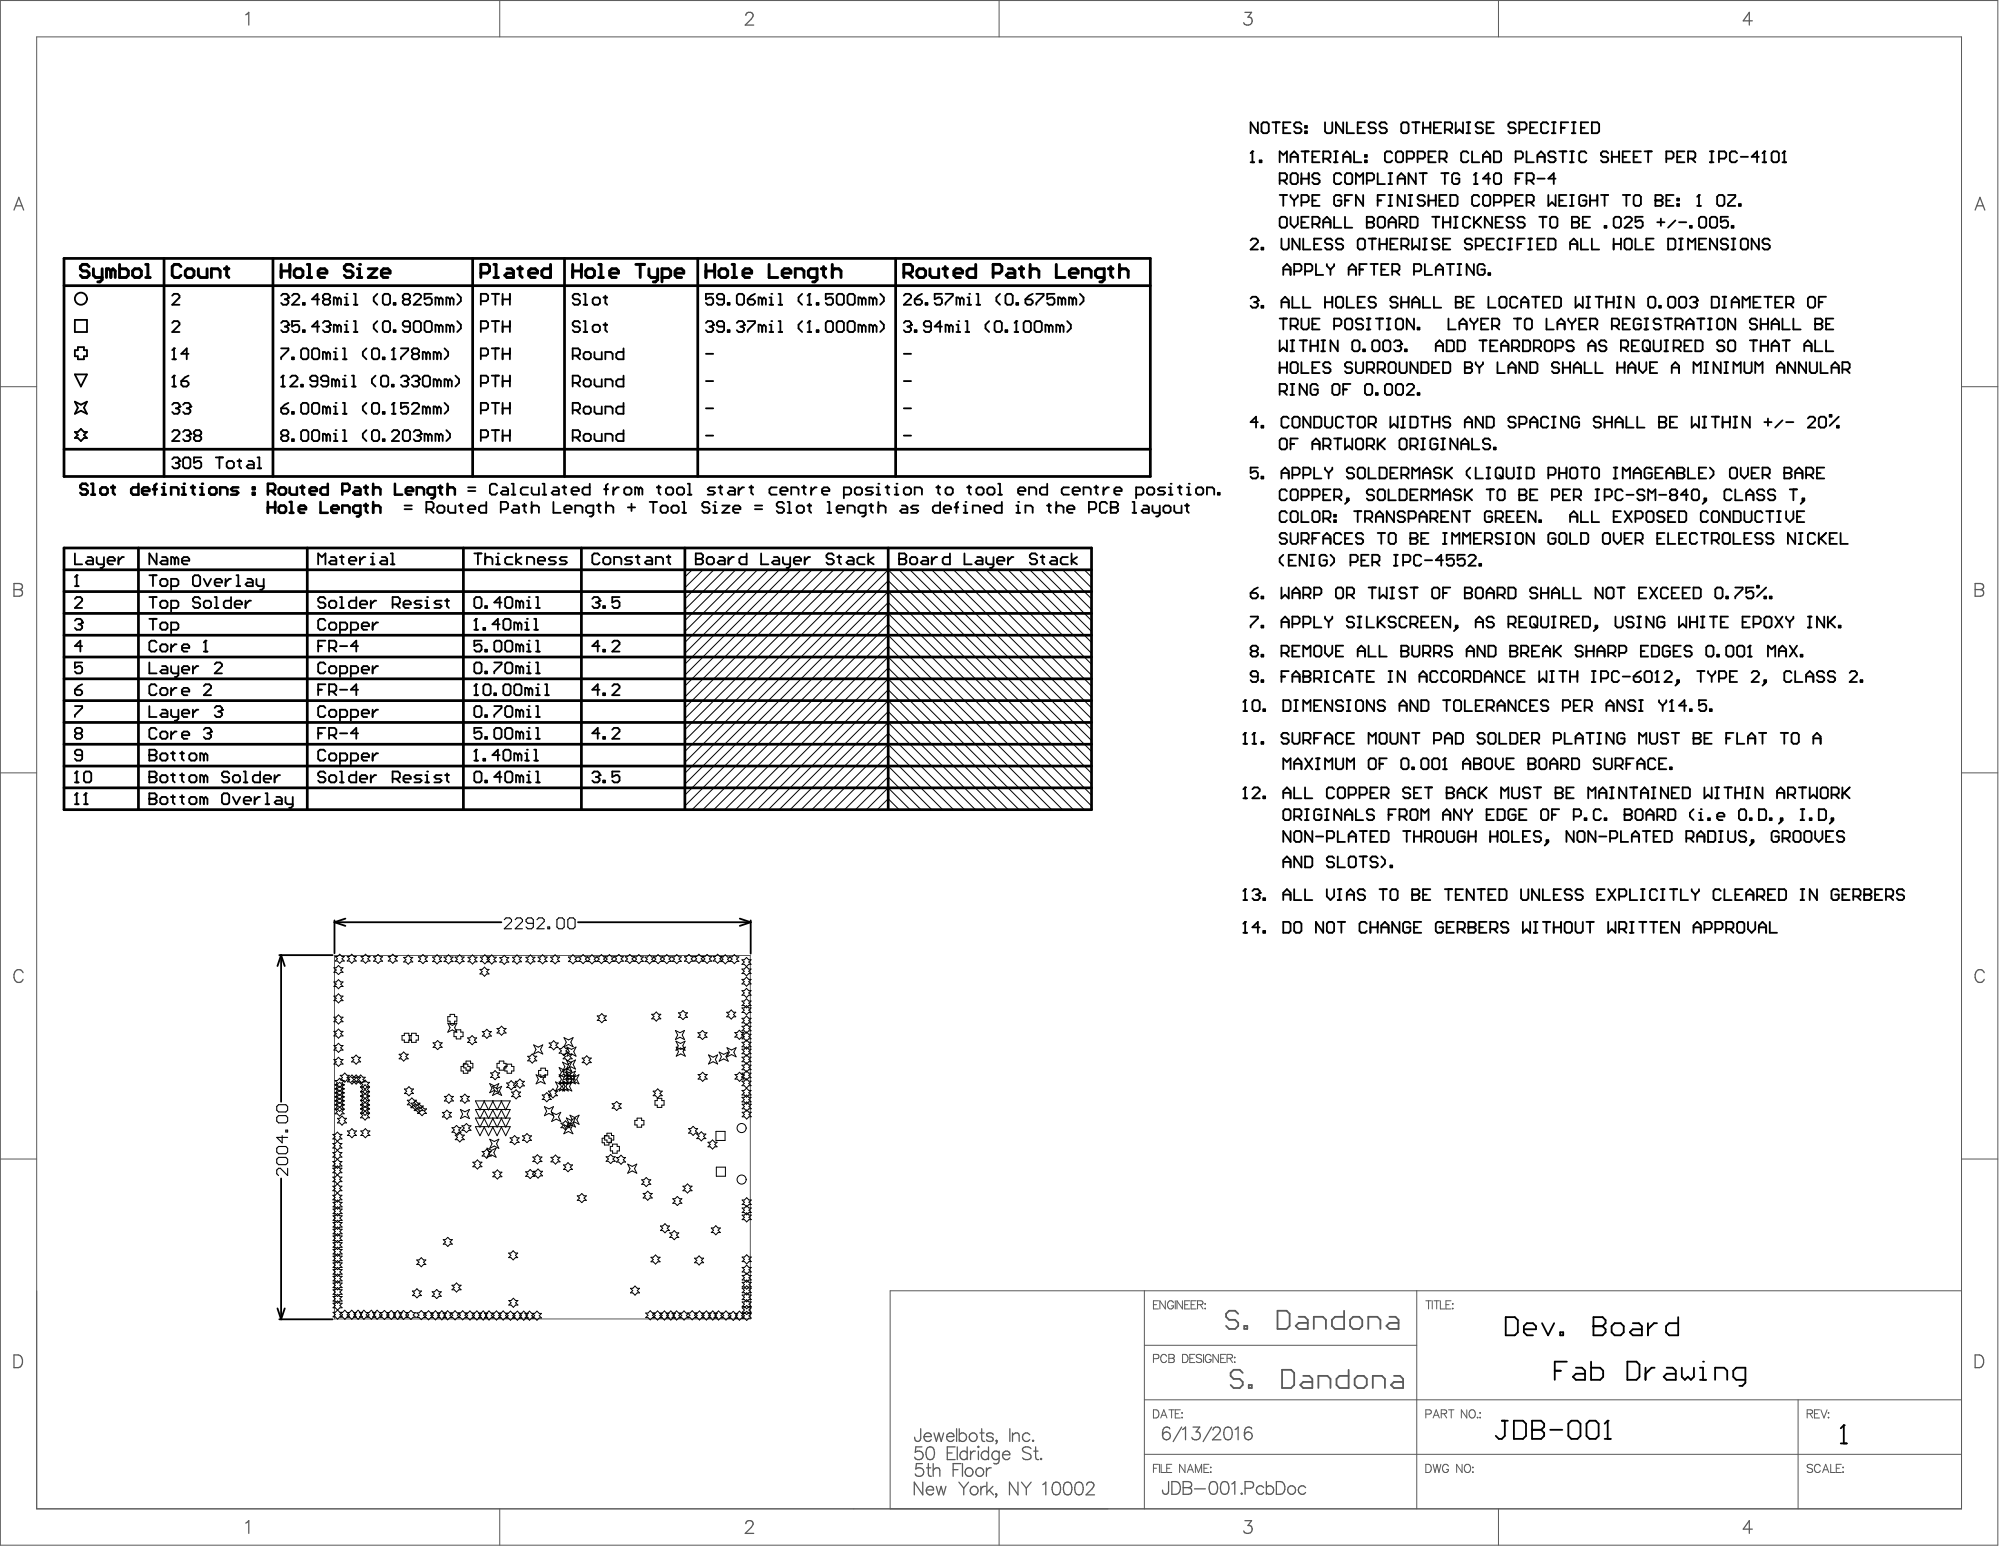
[picture p83: page 1]
