Jewelbots/jewelbot-ee/JWB-001_v3.5/Layout/JWB-001_PCB.PDF

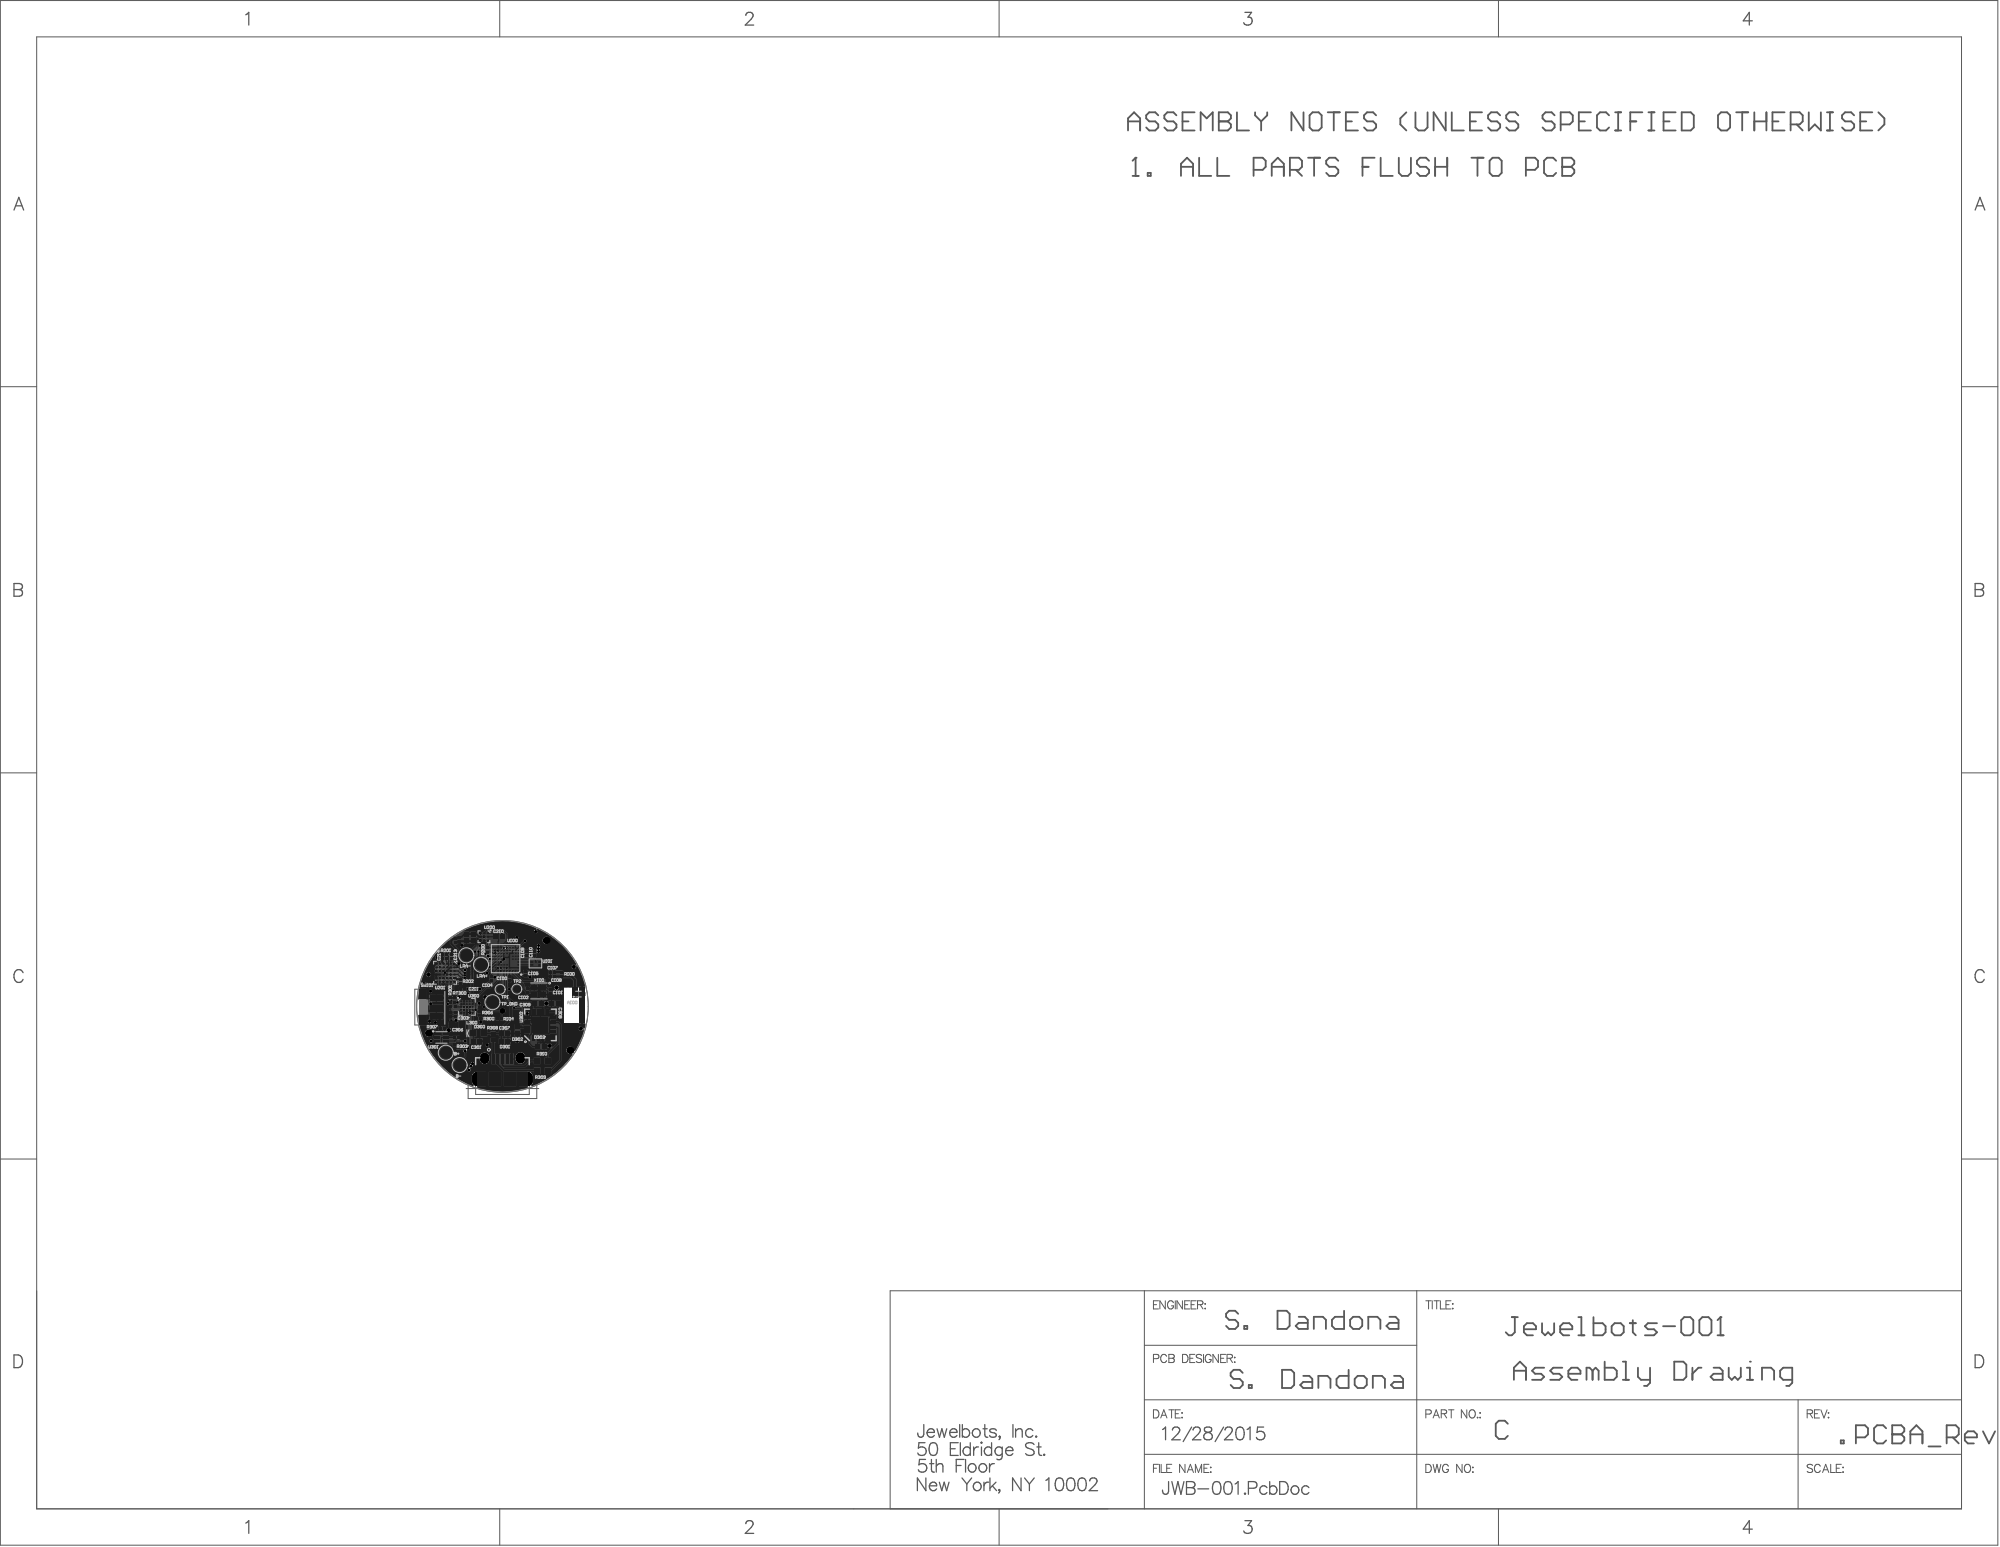
[picture p84: page 1]
