Jewelbots/jewelbot-ee/JWB-001_v3.5/Project Outputs for JWB-001/JWB-001 REV3.5 FabDwg.PDF

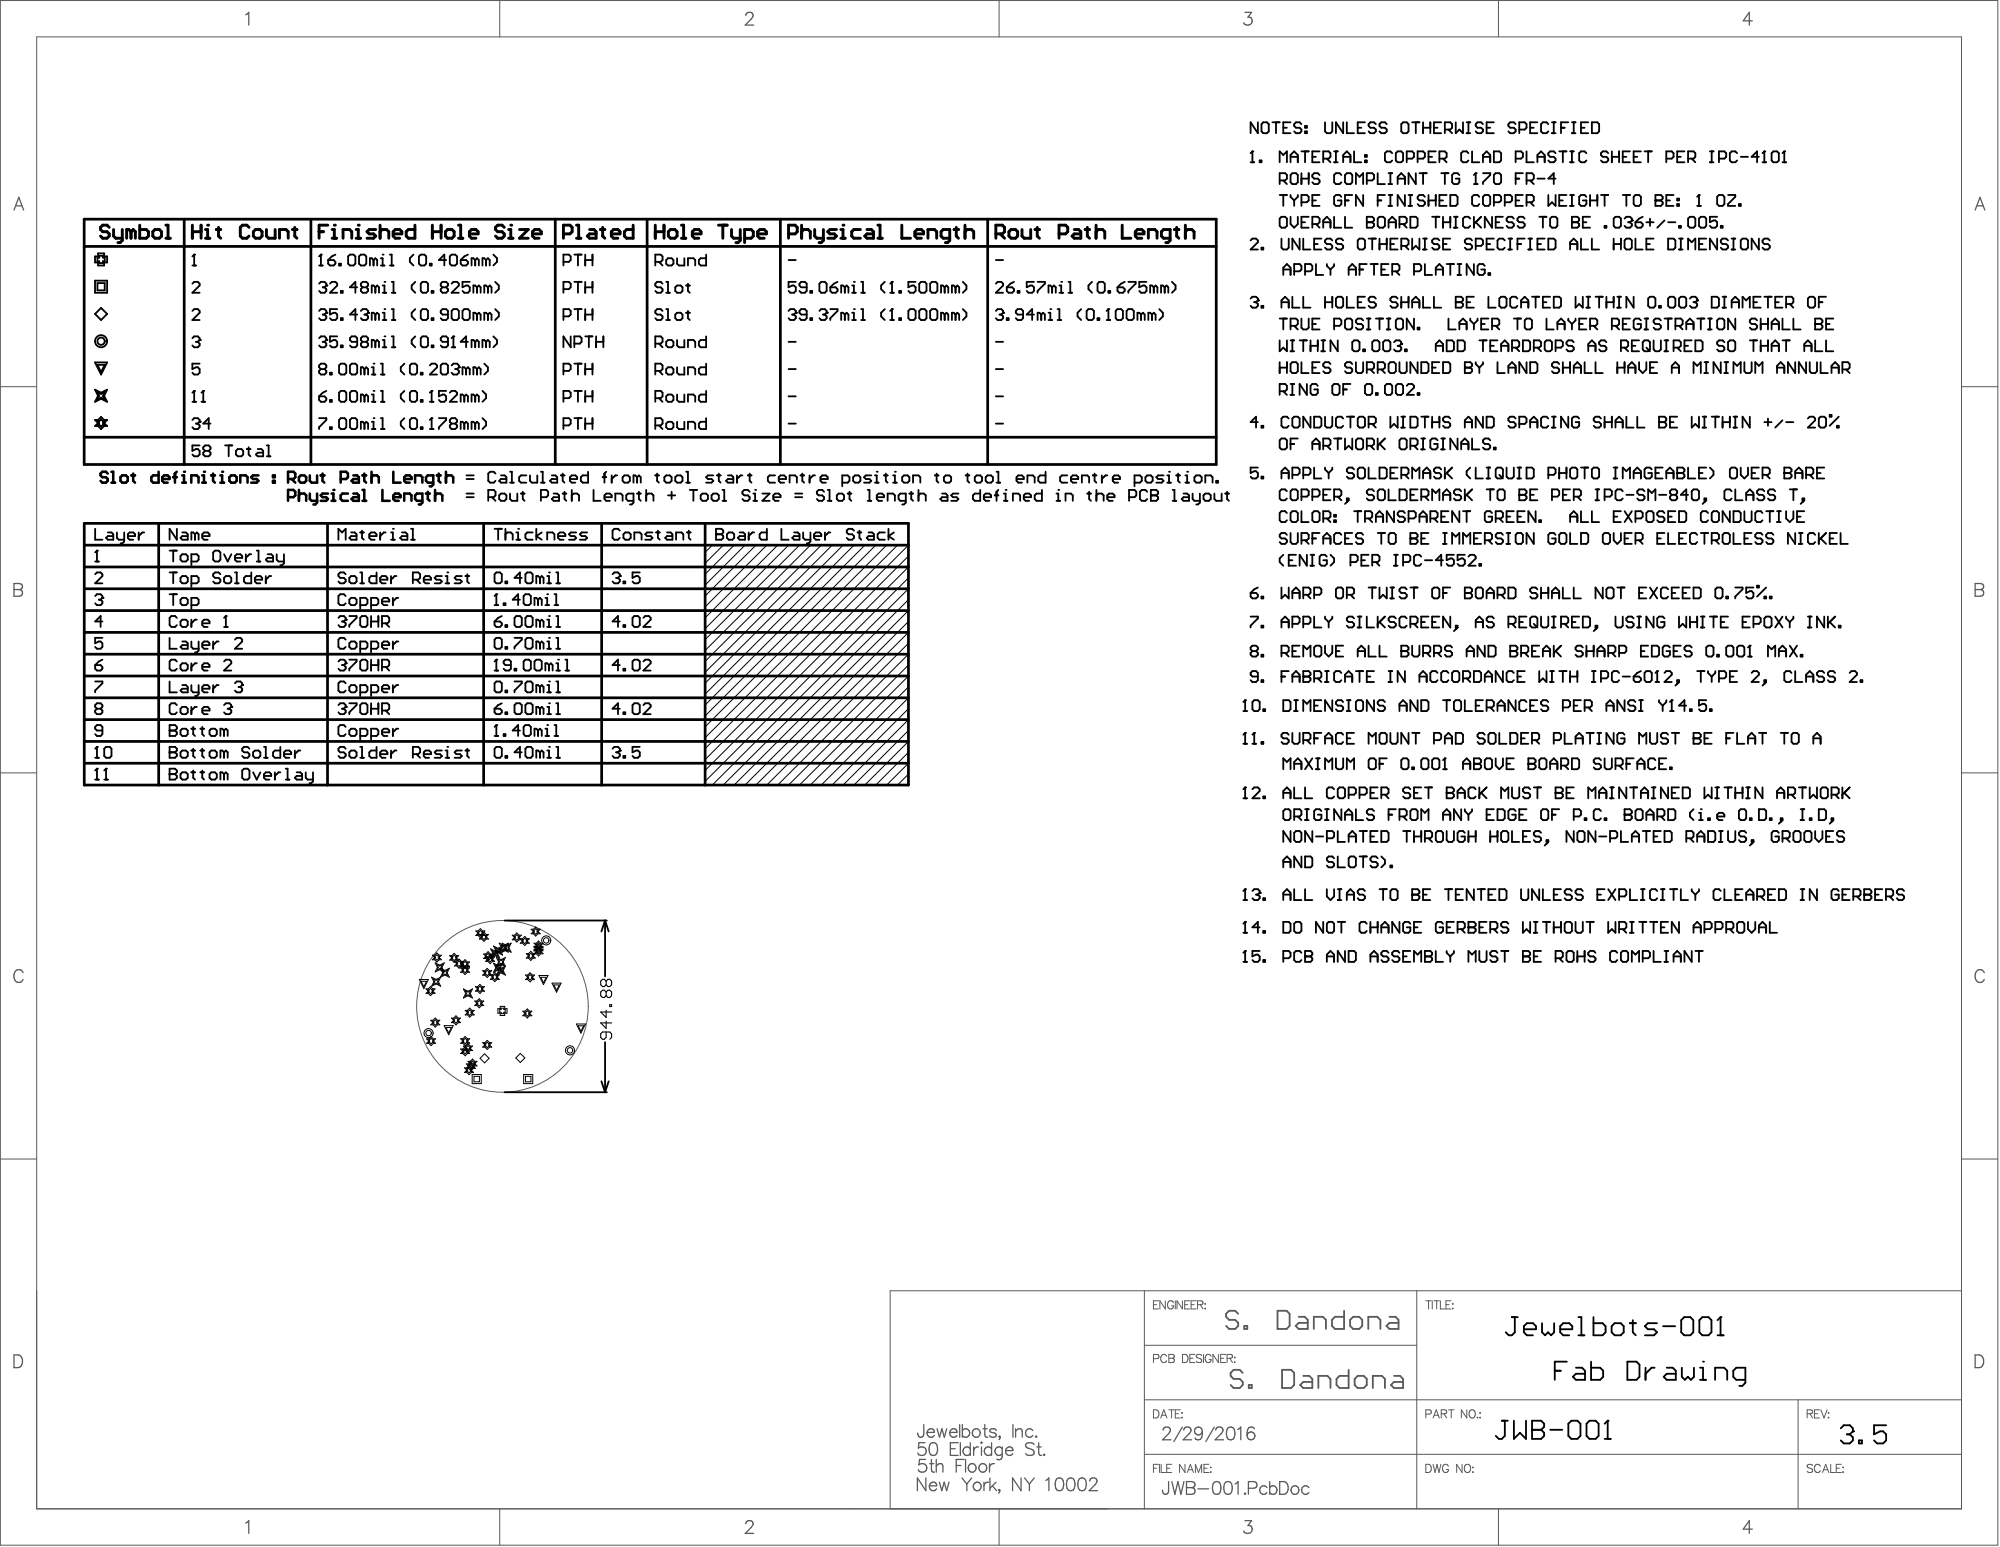
[picture p85: page 1]
