Jewelbots/jewelbot-ee/JWB-001_v3.7/Layout/JWB-001_PCB.PDF

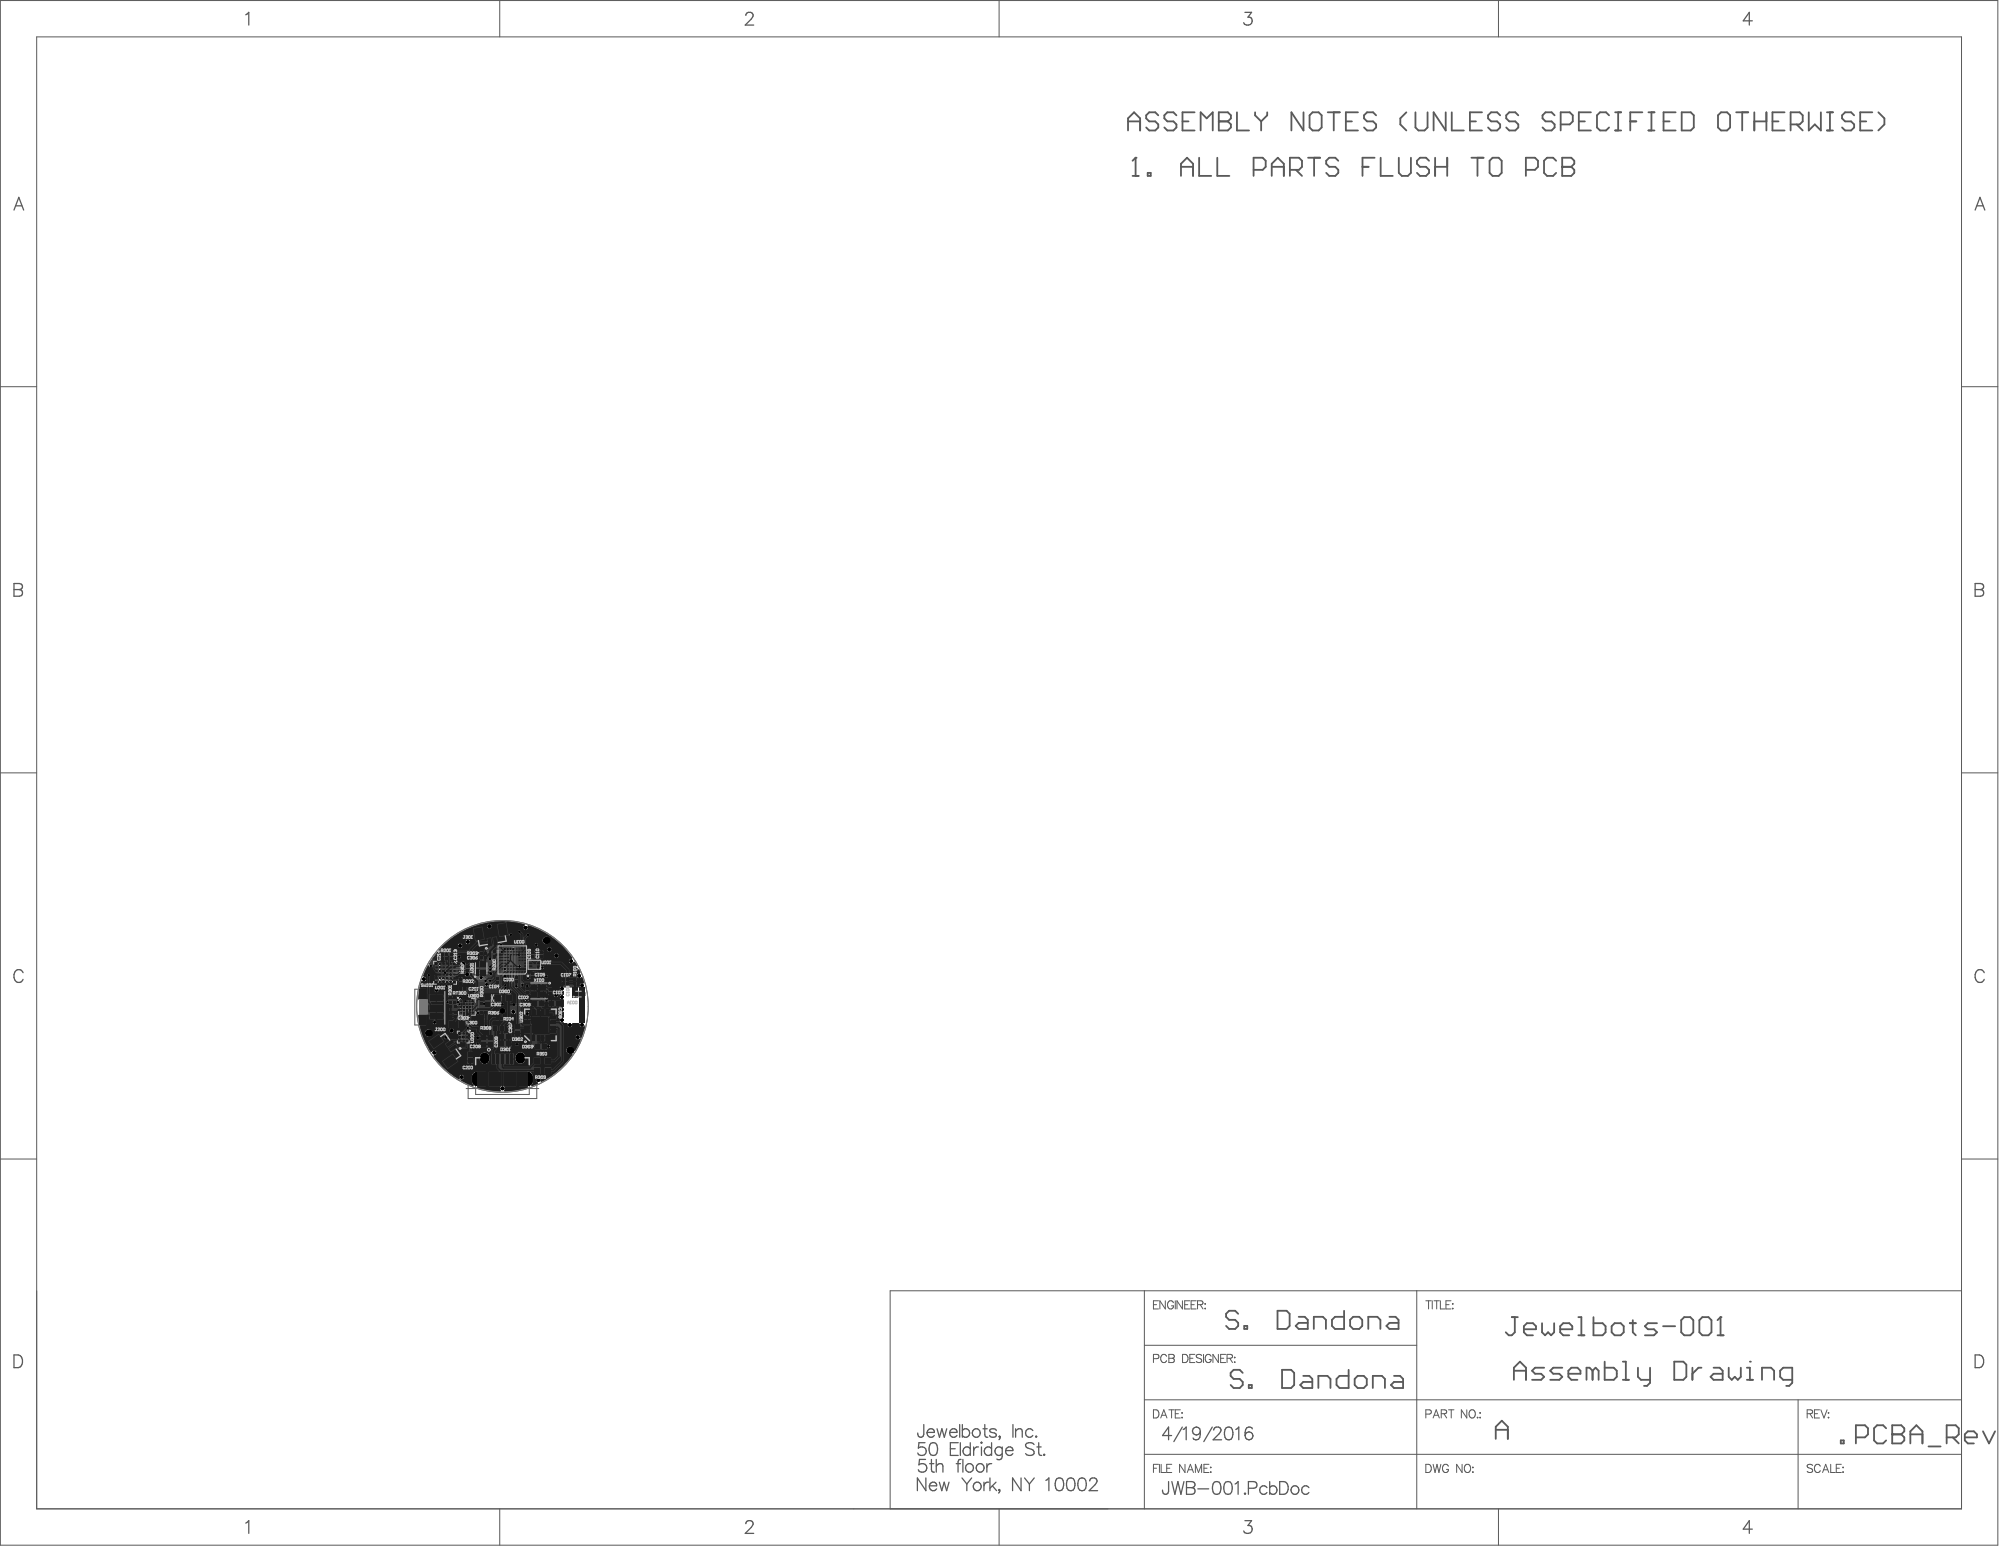
[picture p86: page 1]
