Jewelbots/jewelbot-ee/JWB-001_v3.7/Project Outputs for JWB-001/JWB-001 REV3.7 FabDwg.PDF

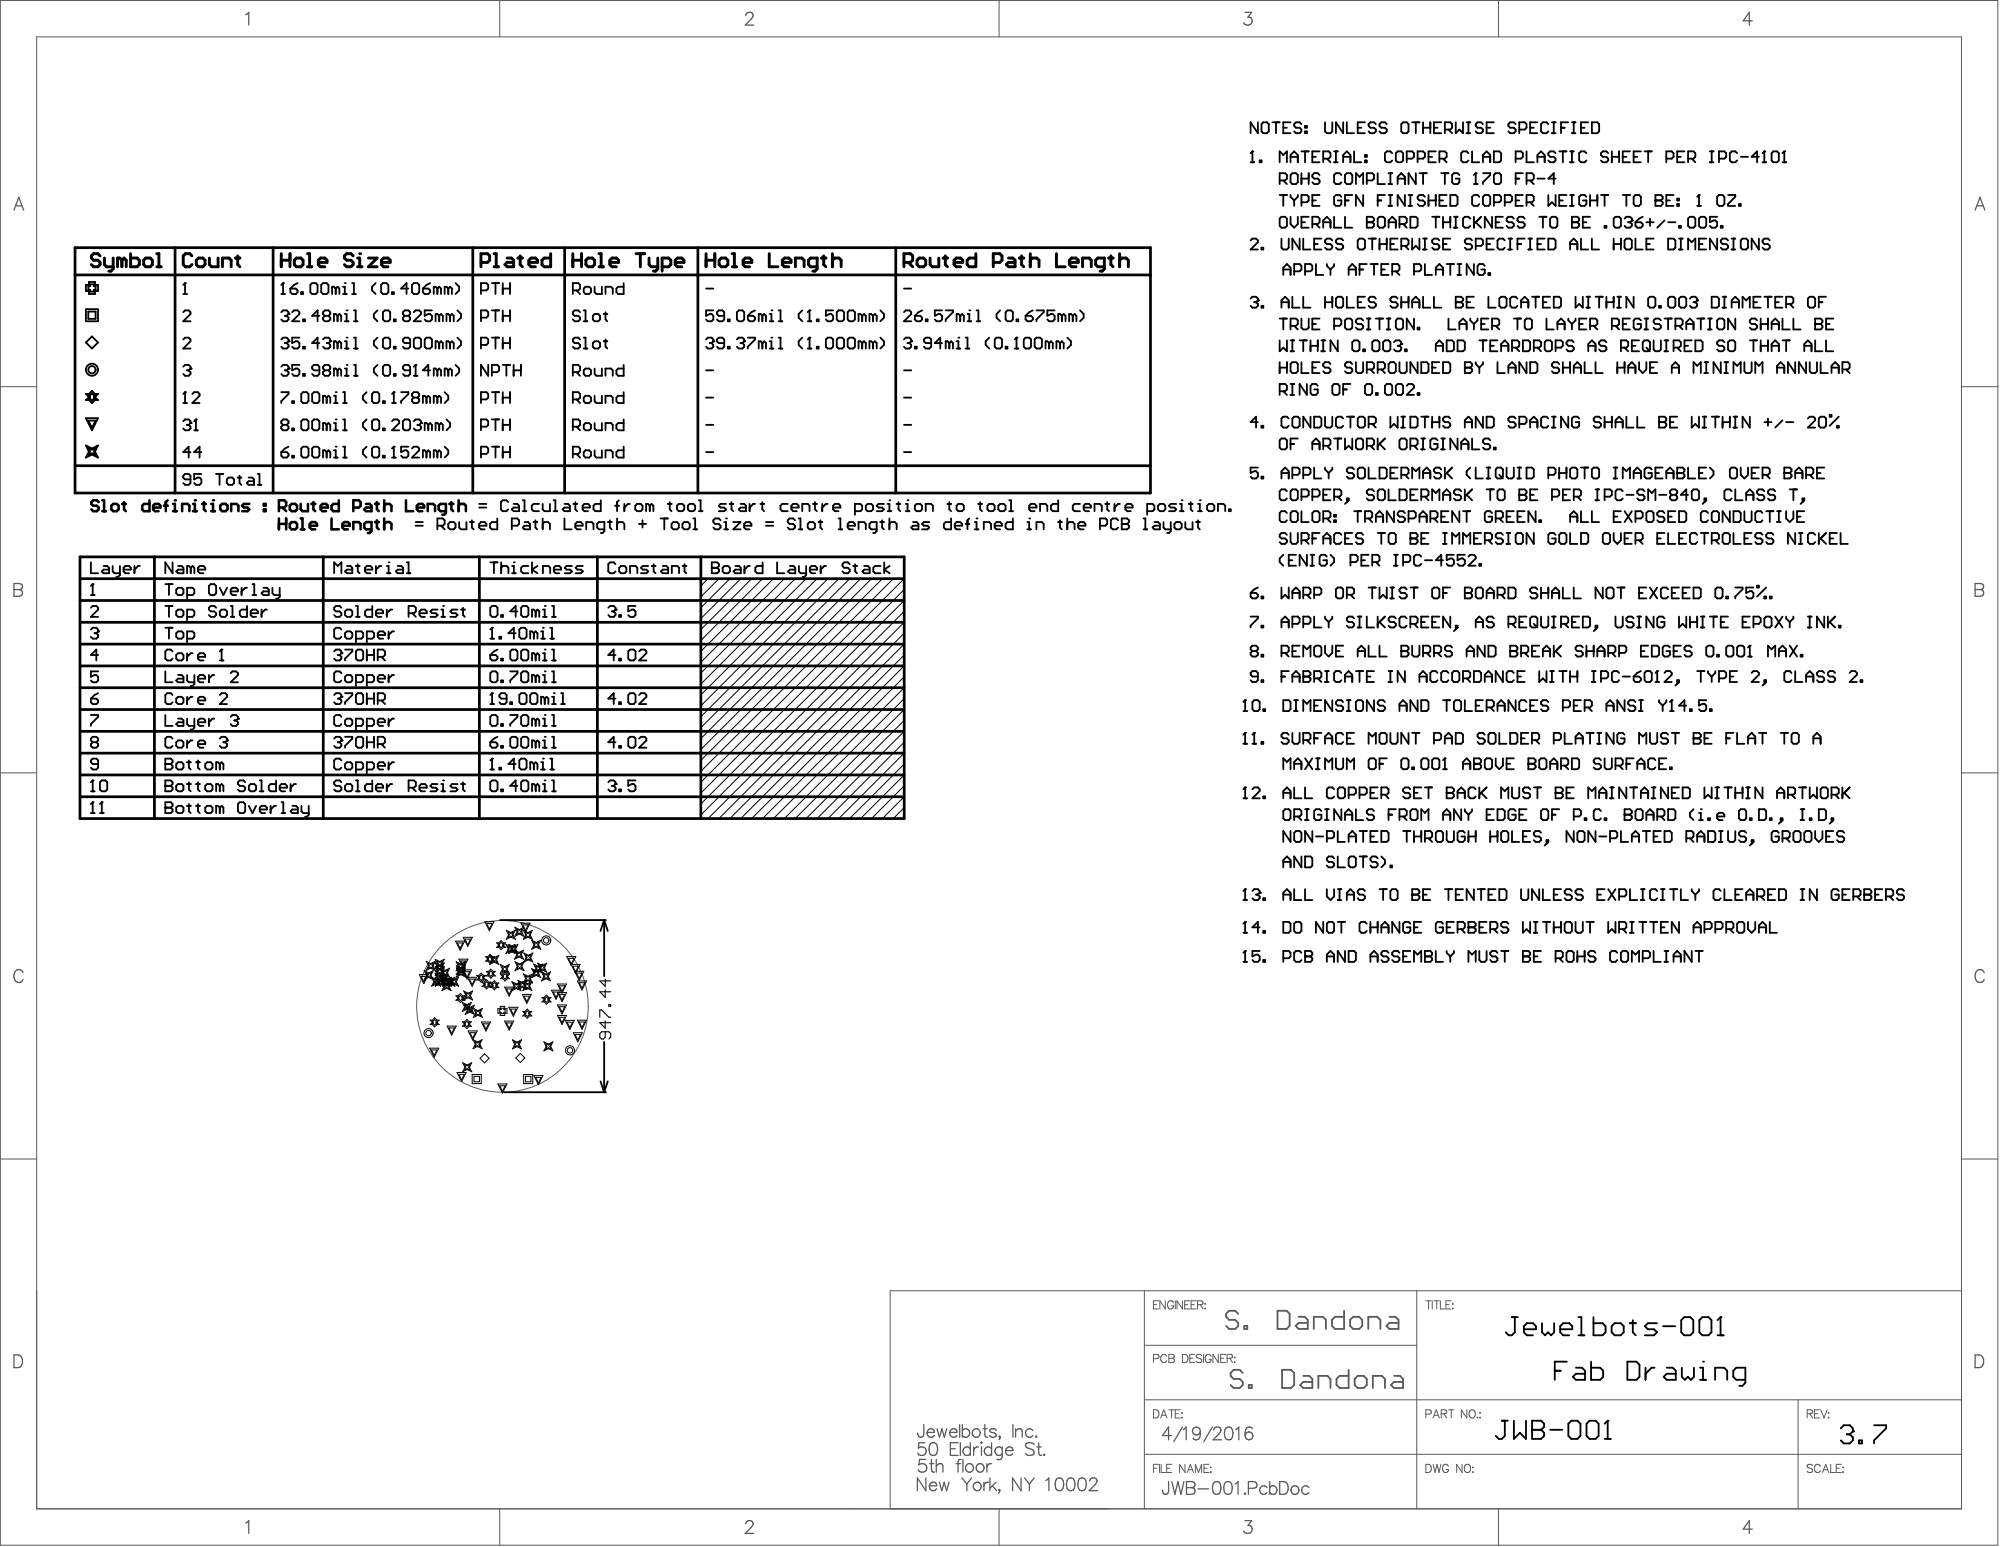
[picture p87: page 1]
