Jewelbots/jewelbot-ee/(list of files, drawings)

Other design files:
JDB-001/JDB-001.PrjPcb
JDB-001_160609/JDB-001.PrjPcb
JDB-001_160609/Layout/JDB-001.PcbDoc
JDB-001_160609/Schematic/Interfaces.SchDoc
JDB-001_160609/Schematic/PowerSupplies.SchDoc
JDB-001_160609/Schematic/Top.SchDoc
JDB-001_v2.0/JDB-001.PrjPcb
JDB-001_v2.0/Schematic/Interfaces.SchDoc
JDB-001_v2.0/Schematic/PowerSupplies.SchDoc
JDB-001_v2.0/Schematic/Top.SchDoc
JDB-002/JDB-002.PrjPcb
JDB-002/Layout/JDB-002.PcbDoc
JWB-001_Charger_v2/JWB-001_Charger.PrjPcb
JWB-001_Charger_v2/JWB-001_Charger.SCHLIB
JWB-001_Charger_v2/PCB/JWB-001_Charger.PcbDoc
JWB-001_Charger_v2/PCB/JWB-001_Charger.PcbLib
JWB-001_Charger_v2/Source/JWB-001_Charger.SchDoc
JWB-001_Main_v2.0/JWB-001_Main.PrjPcb
JWB-001_Main_v2.0/PCB/JWB-001_Main.PcbDoc
JWB-001_Main_v2.0/PCB/JWB-001_Main.PcbLib
JWB-001_Main_v2.0/Source/Interfaces.SchDoc
JWB-001_Main_v2.0/Source/Power Supplies.SchDoc
JWB-001_Main_v2.0/Source/Top Nordic.SchDoc
JWB-001_v3.5/JWB-001.PrjPcb
JWB-001_v3.5/Layout/JWB-001.PcbDoc
JWB-001_v3.5/Schematic/Interfaces.SchDoc
JWB-001_v3.5/Schematic/PowerSupplies.SchDoc
JWB-001_v3.5/Schematic/Top.SchDoc
JWB-001_v3.6/JWB-001.PrjPcb
JWB-001_v3.6/Layout/JWB-001.PcbDoc
JWB-001_v3.6/Schematic/Interfaces.SchDoc
JWB-001_v3.6/Schematic/PowerSupplies.SchDoc
JWB-001_v3.6/Schematic/Top.SchDoc
JWB-001_v3.7/JWB-001.PrjPcb
JWB-001_v3.7/Layout/JWB-001.PcbDoc
JWB-001_v3.8_160615/JWB-001.PrjPcb
JWB-001_v3.8_160615/Schematic/Interfaces.SchDoc
JWB-001_v3.8_160615/Schematic/PowerSupplies.SchDoc
JWB-001_v3.8_160615/Schematic/Programming.SchDoc
JWB-001_v3.8_160615/Schematic/Top.SchDoc
JWB-001_v3.9/JWB-001.PrjPcb
JWB-001_v3.9/Layout/JWB-001.PcbDoc
JWB-001_v3.9/Schematic/Interfaces.SchDoc
JWB-001_v3.9/Schematic/PowerSupplies.SchDoc
JWB-001_v3.9/Schematic/Top.SchDoc
JWB-001_v3.9/SupportDocs/Templates/Template.PcbDoc
