Jewelbots/jewelbot-ee/(commit log)

2016-06-10 adding dev layout
    [Bill of Materials-JDB-001.xlsx, Interfaces.SchDoc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]
2016-06-10 Adding latest layout
    [02SUR-32S.STEP, 640456-2.stp, 640456-3.stp, BM02B-SURS-TF.STEP, Bill of Materials-JWB-001.xlsx, Interfaces.SchDoc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]
2016-06-10 Previous version
    [02SUR-32S.STEP, 640456-2.stp, 640456-3.stp, BM02B-SURS-TF.STEP, Bill of Materials-JWB-001.xlsx, Interfaces.SchDoc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]
2016-06-10 second version board
    [Interfaces.SchDoc, JWB-001 v2.0.step, JWB-001_Main.PcbDoc, JWB-001_Main.PcbLib, JWB-001_Main.PrjPcb, JWB-001_Main_v2.0_BOM.xlsx, Power Supplies.SchDoc, Top Nordic.SchDoc]
2016-06-10 charging daughter board for v2.0
    [JWB-001_Charger.PcbDoc, JWB-001_Charger.PcbLib, JWB-001_Charger.PrjPcb, JWB-001_Charger.SCHLIB, JWB-001_Charger.SchDoc, JWB-001_Charger_v2.0_BOM.xlsx]
2016-06-13 Previous layout with different balun
    [Bill of Materials-JDB-001.xlsx, Interfaces.SchDoc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]
2016-06-13 Updated layout and BOM with new balun
    [Bill of Materials-JDB-001.xlsx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]
2016-06-13 Updated components
    [Bill of Materials-JDB-001.xlsx, Bill of Materials-JDB-001_mod.xlsx, Interfaces.SchDoc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]
2016-06-14 Just starting a new layout for the future...
    [02SUR-32S.STEP, 640456-2.stp, 640456-3.stp, BM02B-SURS-TF.STEP, Interfaces.SchDoc, JDB-002.PcbDoc, JDB-002.PrjPcb, PowerSupplies.SchDoc]
2016-06-15 Prior version of 3.8
    [02SUR-32S.STEP, 640456-2.stp, 640456-3.stp, BM02B-SURS-TF.STEP, Bill of Materials-JWB-001.xlsx, Interfaces.SchDoc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]
2016-06-15 Latest version
    [JWB-001.GBL, JWB-001.GBO, JWB-001.GBP, JWB-001.GBS, JWB-001.GKO, JWB-001.GTL, JWB-001.GTO, JWB-001.GTP]
2016-07-22 Updated Layout
    [02SUR-32S.STEP, 537800270.stp, 640456-2.stp, 640456-3.stp, 878980424.stp, BM02B-SURS-TF.STEP, Bill of Materials-JDB-001.xlsx, Bill of Materials-JWB-001.xlsx]
2016-07-22 Added silkscreen
    [JDB-001.GBL, JDB-001.GBS, JDB-001.GTL, JDB-001.GTO, JDB-001.GTP, JDB-001.GTS]
2016-07-22 Latest schematic for JWB-001
    [02SUR-32S.STEP, 640456-2.stp, 640456-3.stp, BM02B-SURS-TF.STEP, Bill of Materials-JWB-001.xlsx, Interfaces.SchDoc, JWB-001.PcbDoc, JWB-001.PrjPcb]
2016-07-22 Latest schematic
    [JWB-001.PrjPcb, PowerSupplies.SchDoc]
2016-07-25 Updated schematic
    [PowerSupplies.SchDoc]
